ArvidJoung/Plasma_RF_Generator/Reference Data/KEIT-2655.pdf

-1-

# 13.56MHz RF GENERATOR 및

# AUTO MATCHING SYSTEM

(1 | ) 차년도 중간 보고서

1996. 10. 30

# 통상산업부

-2-

### 제출문

통상산업부장관귀하

본 보고서를 | 및 | 개발기 "13.56MHz RF GENERATOR | AUTO MATCHING SYSTEM" (
간 | 과제의 중간보고서로 제출합니다 : 1995. 12. 31 ~ 1996. 12. 30) | .

1996. 10. 30.

개 발 사 업 주 관 기 관 명 : 서울산업대학교

개발사업총괄책임자 : 장 우 진

연 | 구 | 원:여 인 선
| | :이 진 우
| | :장 택 수
| | :구 성 완
| | :이 병 일
| | :최 대 규
| | :김 남 정
| | :최 상 돈
| | :이 인 용
| | :위 순 임
| | :김 도 천

-3-

### 요약서

Ⅰ. | ( | ) 최종 당해 개발 목표 포함
반도체 | 에칭 확산 후처리 및 재료공학 섬유공학 피막코팅 등에 사용할 Wafer, | , | , | , | ,
수 있는 전원장치로서 발진부 | 부 | 부 | 부 , Power Amp , AC DC Converter , Filter , →
Control , | , Matching | , | , 부 센서부 | 회로 등으로 구성된 아래 규격의 고효율 고신뢰도 장
수명의 | 고정주파수 전원장치와 | 내에 안정된 | 방전을 일 13.56MHz | Chamber | Plasma
으키는데 절대 필수적인 | 시스템을 개발한다 Auto Matching | .
o | , | 13.56MHz 고효율 | 장수명의 | 전원 장치
ㆍ | → 해당부분 | 발진부 | 부 | 컨버터부 | 부 : | , Power Amp , AC DC | , Filter
ㆍ | ↑ 회로효율 | 기존 | 정도 : 80% | ( | 60% | )
ㆍ | ↑ 입력역률 | 기존 | 정도 : 85% | ( | 65% | )
ㆍ | | | | | | ↑ 정격수명 : 20,000 Hr
ㆍ 개발규격 : 300W, 1kW
ㆍ 전자파장애 | | | | | | 수준 (EMI) : FCC CLASS B
ㆍ | | | | | | ↓ 고조파 함유율(THD) : -40dB
ㆍ | | | | | | ↓ 출력 변동율 : 0.1%
ㆍ | | | | | | ↓ 주파수 변동율 : 0.1%
ㆍ VSWR : 30% | 24 이상에서 | 시간 견딤
ㆍ PROTECT : 순간차단
o | AUTO MATCHING 고속 | 시스템
ㆍ 해당부분 | 센서부 콘트롤부 | 부 | 회로부 : | , | , PC Interface , Matching
ㆍ LCD | DISPLAY : Matching Element | , Motor Speed | , 기능 | 값 표시 | 값 표시
Forward/Reverse 값 표시
ㆍ HARDWARE : 8OC196KC (INTEL ) 社
ㆍ SOFTWARE : Impedance | Program, Motor | Program, PC Interface 계산 | 제어
Program
ㆍ SENSOR : 자기유도방식
ㆍ MATCHING TIME : 3 | ( | 5 ~15 ) 초이내 기존 초 | 초
ㆍ OVER SHOOT | : 20% 율 | 이내

-4-

Ⅱ. 기술 개발의 목적 및 중요성

최근 전세계 | 멀티미디어 통신기기 | 등의 발달로 반도체 | 의 PC, | , | , FA | Memory Chip
수요가 폭증하고있다 | 반도체는 우리나라 전체 수출량의 약 | 를 담당하 . Memory | 20%
며 전세계 | 시장 판매량에서 | 위를 다투고 있으나 막상 반도체를 , | Memory Chip | 1, 2
생산하는 장비는 선진국의 기술이전 회피 및 막대한 연구개발비 설비투자비 그리 , | ,
고 첨단인력 부족으로 전량 외국에 의존하고 있다.
이에 국가적으로 첨단산업의 육성차원에서 일부 반도체 장비의 국산화가 추진되고
있으며 반도체 제작 약 | 개 공정중 | 에 해당하는 | 공정용 장비에 집중 , | 300 | 60% | Wafer
되고 있다 이는 | 에칭 | 에쉬 등을 말하며 | 와 전원장 . | Plasma | , Plasma CVD, | Chamber
치로 구성되어있다.
Wafer | 3 | . 한장이 만들어지기까지는 약 | 개월간의 공정기간이 필요하다 이 과정에서
Wafer | , 의 불량률을 줄이면 반도체 수율확대이고 곧 경쟁력확대라고 말할 수 있으며
이를 좌우하는 가장 큰 요인은 | 내 | 의 안정성에 있다 | 를 생 Chamber | Plasma | , Plasma
성하기 위하여 외부에서 전계와 자계를 인가하여 주는 전원장치가 필수적이며 바,
로 이 전원장치의 안정성이 생성된 | 의 질을 좌우한다 Plasma | .
Chamber | Impedance | CPU | , | Plasma 내의 | 를 | 로 계산하여 자동 매칭을 이루면 안정된
방전을 일으켜 | 에 손상이 가지 않도록 가공할 수 있고 또한 재료 공학 섬유 Wafer | , | ,
공학 등에 사용하는 피막코팅 및 요즘 공해 문제를 야기시키는 습식 도금을 건식도
금으로 바꿀 수 있다 | 이에따라 고신뢰도의 | 전원장치 및 . | 13.56MHz RF | Auto
Matching | . 시스템의 개발이 절실히 요구되고있다
그러므로 국내 반도체 장비의 선진기술 확보를 위해서는 | 개발과 병행하 , | Chamber
여 | 전원장치 및 | 시스템의 개발은 필수적이며 개발 실용화될경우 RF | Auto Matching | ,
전량 수입에 의존하는 전원장치를 수입대체 할 수 있고 반도체 관련장비 산업의 대 외 경쟁력 강화와 수출증대를 도모할 수 있으며 건식코팅 등 주변 산업에도 파급효 과가 크리라 예상된다.

-5-

Ⅲ. 기술 개발의 내용 및 범위

ㆍ 13.56MHz발진부 설계 및 기술개발
ㆍ 고효율 | | 부 설계 및 기술개발 Power Amp
ㆍ | → AC DC 컨버터부 설계 및 기술개발
ㆍ Filter부 설계 및 기술개발
ㆍ 정밀한 | | 값을 얻을 수 있는 센서 기술개발 Forward, Reflect
ㆍ Power Control부 설계 및 기술개발
ㆍ 신속한 | 부 설계 및 기술개발 Protect
ㆍ Matching | Program 제어 | 개발
ㆍ 1 | (300W ) 차 시작품 | 급 전원장치 제작 및 평가

Ⅳ. 기술 개발 결과 및 활용에 대한 건의

ㆍ 반도체 산업에서 | 의 수율 향상 Wafer
ㆍ 건식코팅 산업에서 각종제품 개발에 활용
ㆍ RF | Plasma 방전을 이용한 | 용접기에 활용
ㆍ 고주파 전원을 이용한 폴리에틸계의 접합에 활용
ㆍ RF 방전을 이용한 박막 코팅에 활용
ㆍ RF 방전을 이용한 섬유 코팅에 활용
ㆍ Plasma | Impedance 방전 상태의 업의 | 를 측정하는 계측기로서의 활용
ㆍ 참여기업에 의한 적극적인 양산화 유도
ㆍ 반도체 및 코팅 관련산업의 고부가가치 상품 개발유도

-6-

목차

제 | 장서 론 1
제 | 장 | 및 2 | 13.56MHz RF GENERATOR | AUTO MATCHING SYSTEM
제 | 절 | 방전 | 의 구조와 | 원리 1 | PLASMA | SYSTEM | MATCHING
제 | 절2 | 13.56MHz RF GENERATOR
제 | 절3 | AUTO MATCHER
제 | 장 견품 분석및 시작평가 3
제 | 절 견품 분석 1
제 | 절 시작평가 2
제 | 장 검토사항 4

-7-

제 | 장 서론 1
고정주파수 | 전원장치 및 | 시스템은 반도체 제조 및 건 13.56MHz RF | Auto Matching
식코팅시 | 전원으로서 | 내에 | 를 생성한다 발생된 | 는 에 Main | Chamber | Plasma | . | Plasma
칭 확산 후처리 등에 주로 사용하고 있으며 그 수요 또한 급속신장하고 있으나 국 , | ,
내 반도체 업체들은 미국이나 일본의 장비 | 로부터 전량 수입 사용하여 반도 Maker | ,
체 장비관련 사업의 선진기술 확보에 어려움이 큰 바 고정 주파수 | 전 13.56MHz RF
원장치 및 | 시스템의 필요성을 실감하게 되었다 Auto Matching | .
이러한 필요성으로 인하여 국내의 일부 업체에서도 수년전부터 고정주파수 13
.56MHz RF | Auto Matching 전원장치 및 | 시스템의 개발을 시도하였으나 반도체 공
정상 필요한 | 시간 연속 운영시 | 변동이 없을 것 타 장비들에 | 를 유 24 | Power | , | Noise
발하지 말아야 할것 | 교환시 아주 정 확한 | 내의 | 를 계산 , Wafer | Chamber | Impedance
하여 | 시킬 것 등의 엄격한 품질요구에 미흡한 상태이며 반도체 제 Auto Matching | | | | | | | ,
조시 | 한장에 소요되는 시간과 경비가 엄청난 점을 감안할 때 고신뢰의 | 전 Wafer | RF
원장치와 | 에 대응할 수 있는 고조파 성분의 제거 고효율 | 단 Auto Matching | , | Power
설계 | 및 | 기술 개발은 아직 전무한 실정이다 , Auto Matching Sensor | Control | .
국내에서 현재 사용되고 있는 | 전원 장치와 | 은 | 급의 RF | Matching | 300W, 600W, 1kW
수동 | 을 사용하며 학교 및 연구기관이나 건식코팅에 주로 사용하고 있으 Matching | | | | ,
나 반도체 제조시 요구되는 저 | 출력 전력안정 수율확대 등을 위해서는 , | Noise, | ,
1kW | RF | CPU | Auto 이상 고출력을 갖춘 고신뢰의 고정주파수 | 전원 장치와 | 를 장착한
Matching | | | | | | . 기술 개발이 필요하다고 사료된다
본 보고서에서는 위와 같은 개발의 필요성에 의해 고정주파수 | 전원 13.56MHz RF
장치 및 | 에 관하여 기본적인 기술을 제 차년도에 완성하였고 기존 Auto Matching | | 1 | | | | | ,
의 외국타사 제품을 분석하여 앞으로 개발하여야할 과제에 대하여 기술 한다.

-8-

제 | 장 | 및 2 | 13.56MHz R/F GENERATOR | AUTO MATCHING

### SYSTEM

전세계적으로 급속한 팽창일로의 반도체 산업과 병행하여 | 전원장치와 RF | Auto
Matching | 13.56MHz RF 시스템도 비약적으로 발전하고 있으며 그중 | 전원장치는
1895 | 1932 년 마르코니의 무선통신 성공이후 부분적으로 사용되어오다 | 년 세계전파
규정회의에서 공업용 주파수로 분류되어 통신쪽보다는 반도체 장비인 | 의 Chamber
Main | 1970 | VLSI | PC, | , | , 전원으로 사용되어왔으며 | 년대의 | 출현과 | 통신기기 멀티미디어
FA등의 수요급증에 따라 비약적인 성장과 더불어 그 수요가 계속 증가하고 있다.
한편 | 전원장치 및 | 시스템의 세계시장을 선도하고 있는 미국 일 , RF | Auto Matching | ,
본에서 고신뢰의 전원장치를 개발하기위해 전원장치의 핵심부품인 고주파 전력 트
랜지스터 페라이트 코어 진공 가변 커패시터 등의 부품뿐 아니라 고주파 , | , | Filter
CPU | Control | , AC DC Converter 를 첨가한 전원 | 장치 | 등에 막대한 투자를 하고 있 →
으며 미국의 | 와 일본의 | 에서는 | 내의 | 를 | 를 AE | DAIHEN | Chamber | Impedance | CPU 社 | 社
사용하여 계산하고 | 추적 장치의 원리를 이용하여 | 내에 저충격 고 Missile | Chamber | ,
속 | 을 실현한 시스템을 선보이고 있다 Matching | .
건식 코팅이나 반도체에서 요구되는 | 천원 및 | 시스템은 작업 공정상 고 RF | Matching
도의 기술을 필요로하기 때문에 위 두 회사에서 개발한 것과 같은 특징을 가진 장 치들이 앞으로의 시장을 주도하리라 예상된다.

-9-

제 | 절 | 방전 | 의 구조와 | 원리 1 | PLASMA | SYSTEM | MATCHING
1. | PLASMA 반도체 제조에 사용되는 | 방전 원리와 구조

고주파 전자기에 의해 일어나는 전기적 방전은 직류나 저주파 교류에 의한 것과는 여러가지 면에서 매우 다르다 특히 방전의 개시와 방전을 지속시키는 조건이 차이 .
를 | 보인다 | 고주파가 | 방전에 | 미치는 | 영향을 | 기술하기 | 위하여 | 전자기계 .
(Electromagnetic field)가 기체에 미치는 영향을 먼저 고려하여야 하며 일반적인 기체방전에서 고려 되여지는 사항과 마찬가지로 매우 복잡하다.
고주파가 기체에 인가되면 기체 내의 하전입자가 가속된다 질량의 차이로 인하여 . 자유전자는 이온보다 훨씬 많이 가속되며 이온보다 자유전자에 에너지 전달이 많이
된다 전자는 우주선 등의 외부요인에 의하여 기체 내에 항상 어느정도 존재한다 . | .
만약 전자가 존재하지 않는다면 전계가 가해진다 하더라도 에너지 전달이 이루어 ,
지지 않을 것이고 따라서 방전은 일어나지 않을 것이다 전계의 방향이 바뀌면 전 , | .
자에 가해지는 힘의 방향도 바뀌고 따라서 전자는 기체를 수용하고 있는 , | Chamber
의 벽이 멀리 떨어져 있을 경우 기체 내에서 진동하게 된다 , | .
이점이 고주파 방전과 저주파 방전의 주된 차이점이다 주파수가 낮으면 전자가 방 .
향을 바꾸기도 전에 전자는 | 의 벽에 도달하게 된다 전자의 충돌은 다른 Chamber | .
전자를 방출하거나 관벽에 부착된 불순물 원자를 방출하게 한다.
고주파전자계 내에 기체 원자가 없고 전자만이 존재한다면 전자는 전계내에서 진동 을 할 것이고 에너지 전달은 일어나지 않는다 기체가 존재하면 전자는 가속되어 . 전계로부터 전자에 에너지 전달이 일어난다 전자는 전계로부터 에너지를 얻는 반 .
면 원자와의 충돌로 에너지를 잃는다 만약 전계가 충분히 크다면 전자는 원자를 , | | | | .
여기 시키는데 필요한 에너지보다 더 큰 에너지를 얻을 수 있고 계속되는 충돌에 의하여 전자는 원자를 여기시키고 자신은 에너지를 잃게된다.
원자에 전달된 이 에너지는 원자가 기저준위로 복귀할 때 방사된다.
여기 에너지보다 더 큰 에너지를 가지는 전자의 일부만이 실제로 원자를 여기시키
며 어떤 전자는 따라서 원자를 이온화 할 수 있는 충분한 에너지를 얻게 된다 이 , | .
전자가 원자와 충돌하면 또 다른 전자를 얻게 되며 이 과정에 의해 전자를 생성하 ,
게 된다 이와 동시에 전자는 | 쪽으로의 확산에 의해 양이온과 재결합하여 . | Chamber | ,
또는 중성원자나 분자에 포획되어 소멸된다.

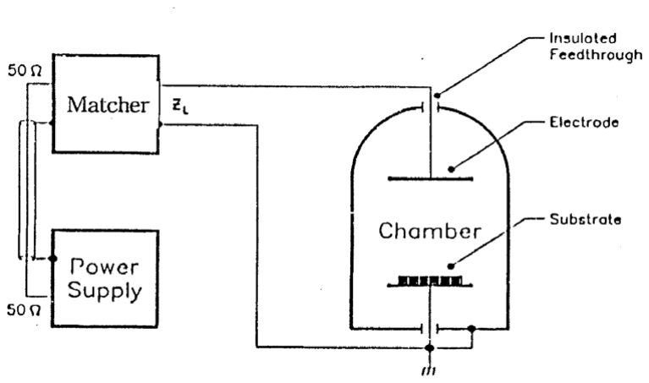
[picture p4: figure]

- 10 -

이 생성과 소멸의 상대적인 값에 의하여 전자의 농도가 결정되며 시스템의 전기적
특성이 결정된다 생성과 소멸의 비율은 가스의 종류 가스의 밀도 | 의 형 . | , | , Chamber
상 등의 복잡한 함수이다.
고주파 전계를 발생시키기 위하여 고주파 전력을 발생하는 전원장치가 필요하며 이
고주파 전력을 | 내에 효과적으로 공급할수 있는 | 가 필요하다 Chamber | Matcher | .
현재 가장 중요한 반도체 제조 공정중 식각 | 과 성장 (Eatching) | (Deposition), Sputter,
Asher | 13.56MHz RF Generator | Auto Matcher | 1-1 등에 | 와 | 가 사용되고 있으며 그림
은 | 형 | 장비의 개략도를 보여주고 있다 Parallel | Plasma Eatching | .
석영제의 | 형 | 내에 반응 | 를 도입하며 그의 외곽에 있는 평판 Parallel | Chamber | Gas | ,
전극에 의하여 용량적으로 또는 | 에 의하여 유도적으로 고주파 전력을 인가하며 Coill
Plasma | . Wafer | Chamber | Boat 를 발생하는 방식을 사용하고있다 | 는 | 내에 석영제 | 의
위에 담겨서 보유 | 중에서 전기적으로 | 상태에 놓이게 된다 | 와 ( | ) Plasma | Floating | . Wafer
Plasma | 10-20V | , | Ion 의 전위와의 차는 | 이며 양 | 은 이 전위차에 의해 가속되어
Wafer | . | Ion 에 입사한다 그 때문에 | 의 충격효과가 적어서 주로 방향성이 없는 중성레
디칼과 피가공 재료와의 화학적인 반응에 의해 등방적인 | 이 진행된다 Eatching | .
이 장비에서는 석영 | 내에서 | 가 형성되기 때문에 반도체 | 에 Chamber | Plasma | Device
유해한 불순물 오염도 거의 없고 | 도 적어서 손상이 적다 Ion Energy | .
그림 | 형 | 장비 1-1 Parallel | PLASMA ETCHING

- 11 -
2. MATCHING 원리

전력을 소스에서 부하로 최대한 전달하기 위한 임피던스 정합(Impedacne
Matching) | RF | . | 1-2 은 | 회로 설계에 매우 중요하다 그림 | 에 이 이론에 대한 이해를 돕
기위한 회로와 이 회로에 대한 계산식이 있다.
직류회로에서 부하 저항과 소스저항이 같다면 전력은 소스에서 부하로 가장 잘 전 달 된다는 매우 잘 알려진 이론이 있다.
이와 비슷하지만 교류 또는 시간 변화 파형의 경우에서는 소스에서 부하까지 전력 -
을 가장 잘 전달하려면 부하 임피던스 | 가 소스 임피던스의 공액복소수 (ZL)
(Complex conjugate) | . 과 같아야한다 이 임피던스 식을 실제로 사용되는 회로에 적
용해보자.
그림 | 의 회로에서 소스 임피던스 | 는 저항 | 와 | 를 나타내는 리액티브 부 1-3 | ZS | RS | +jX
품인 인덕터가 직렬로 연결되어있고 부하 임피던스 | 은 저항 | 과 | 를 나타 , | ZL | RL | -jX
내는 리액티브 부품인 커패시터가 직렬로 연결되어 있는데 이 회로에서 소스와 부
하 임피던스가 직렬로 연결 되었으므로 소스의 | 와 부하의 | 성분들은 직렬이므 +jX | -jX
로 서로 상쇄되고 결과적으로 | 와 | 만 남게된다 RS | RL | .
이 두저항의 크기는 같으므로 직류 회로에서와 같이 최대한의 전력이 전달된다. 위 예와같은 임피던스 정합에서 이루어지는 임피던스정합은 한 주파수에 대해서만 정확하게 정합되고 이 주파수가 아닌 주파수에 대해서는 임피던스 정합이 나빠지다 가 주파수가 많이 차이가 나게 되면 임피던스 정합이 전혀되지 않는다 이와 같은 . 현상은 광대역 회로에 임피던스 정합을 이룰 수가 없다는 것을 의미하므로 문제가
아닐 수 없지만 가변 커패시터를 사용하거나 인덕터에 | 을 설치하여 사용하게 Tap
되면 | 고정주파수에서는 실제 문제 되지 않는다 13.56MHz | | | | | | .

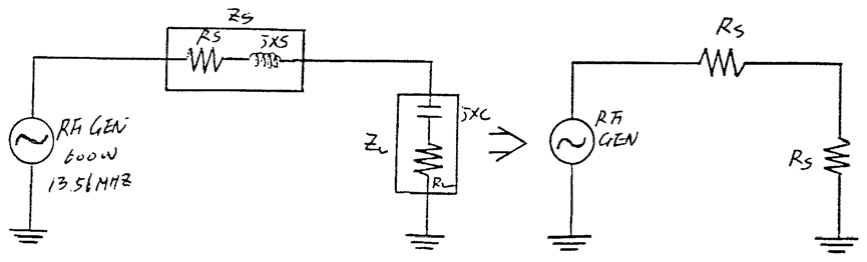
[picture p5: figure]

- 12 -
그림 | 자체의 공액복소수을 구동하는 소스 임피던스와 결과적인 등가 회로 13
제 | 절2 | 13.56MHz R/F‘ GENERATOR
1. 기존회로

고직접 반도체의 개발 요구에 따라 이전에는 진공관식 RF Generator (2MHz ~
30MHz) | TR | FET 를 사용하다 대용량 | 과 | 가 등장하고 나서는 소형 경량화를 지향해서
발전하고 있는 추세이며 전세계적인 | 제조회사 중 미국 | 사 RF Generator | ENI , RFPP
사 | 사 등 개사 일본 | 프랑스 | 사 등이 있으며 여기서는 현재 , AE | 3 | DAIHAN, | SAIRAM
반도제 제조공정중 약 | 정도를 차지하고 있는 | 방식이며 수냉식인 | 사의 45% | Trans | , | ENI
RF Generator | . 를 중심으로 회로소개를 한다

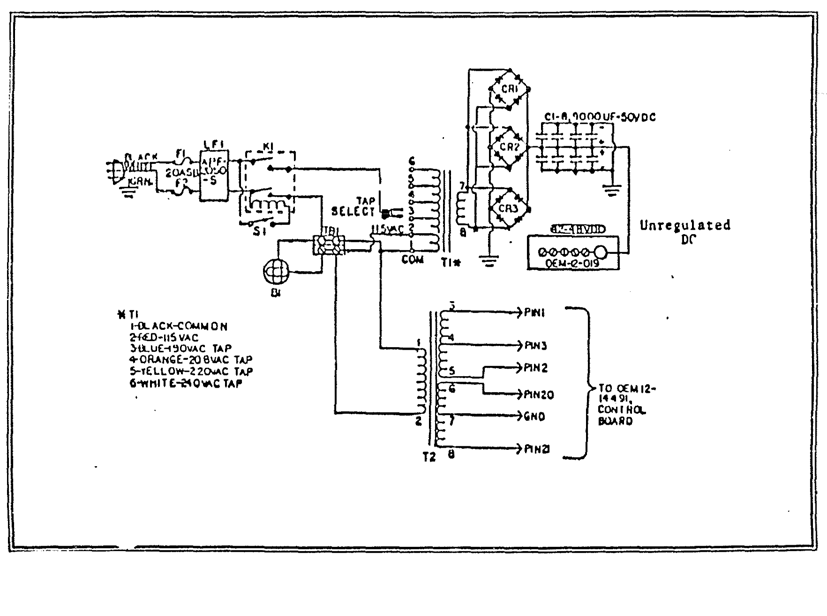
[picture p6: figure]

- 13 -
그림 | 는 | 회로와 | 둥에 전원을 공급하기 위해서 입력 1-4 | Control Board | Power Amp
전원인 | 를 | 등의 | 전원으로 바꾸어주는 부분이다 AC 220V | 50[V], 25[A] | DC | .
200V | 250V 20A 의 입력선을 연결하고 | 짜리 퓨즈를 통과한다음 입력선으로 부터 들
어오는 | 를 방지하기 위한 | 를 설치하고 | 를 설치한다 Noies | Filter | Breaker S/W | .
전원 전압의 | 오차 때문에 | 입력단에 전압조절용 | 를 설치하여 출 ± | Main Trans | Tap
력전압을 일정하게 유지시키고 이를 전파 정류해서 | 를 제거하기 위해 전해 Ripple
Capacitor | Power TR | 50V | . 를 설치하여 | 의 공급전원인 | 를 만들어 낸다
그림 | 전력공급 개략도 1-4

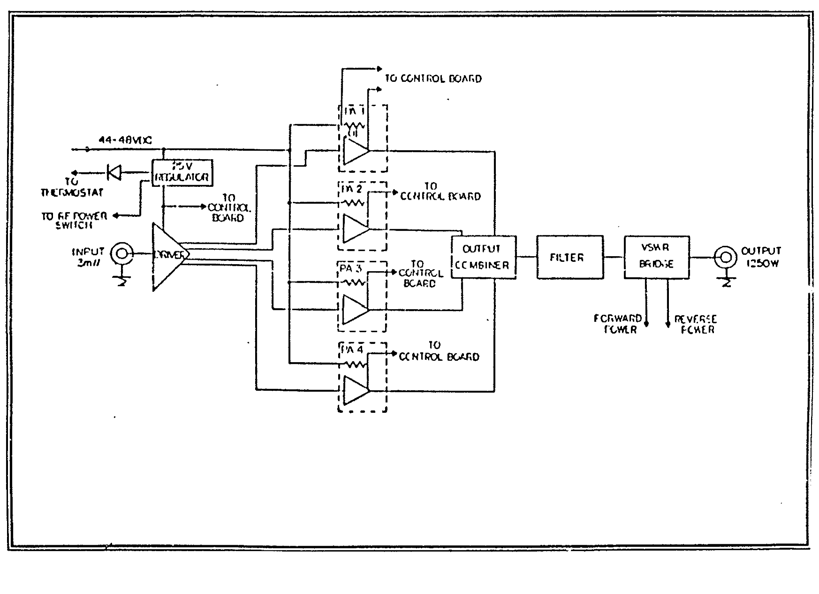
[picture p7: figure]

- 14 -
그림 | 는 전원회로를 거친 다음 | 에서 발진한 | 신호 1-5 | Control Board | 13.56MHz 3mW
를 드라이브 단에서 약 | 정도로 신호를 확대한 다음 | 로 보내서 각 60W | Power Amp
Power | 300W | 1250W | Combiner | 13.56MHz 단 | 씩 총 | 를 만들어서 | 로 전력을 합친다음
외의 주파수를 거르기 위해 | 를 통과한 다음 | 과 | 를 위해 Fillter | Power Control | Protect
VSWR( | )Meter | Forward | Reverse Power | Control 정재파비 | 를 설치하여 | 와 | 를 검출해서
Board | Output Connector | . 로 보내고 출력신호는 | 에 연결한다
그림 | 부분 개략도 1-5 RF

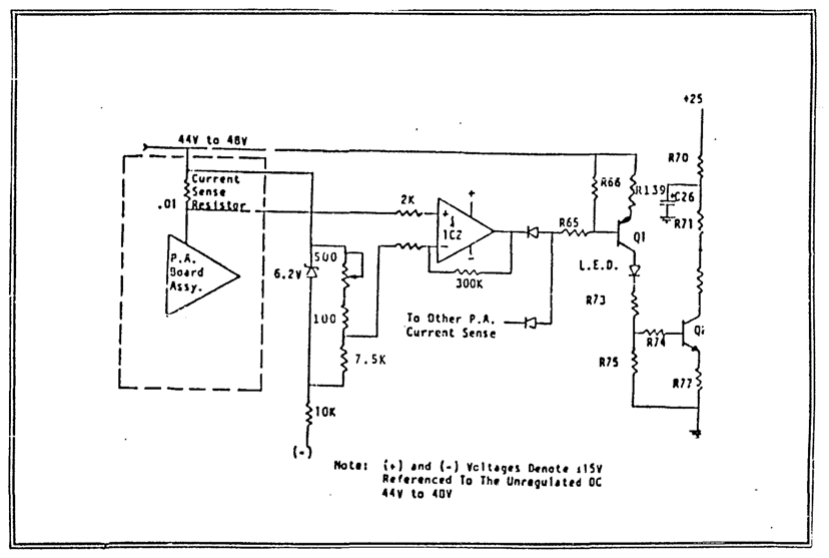
[picture p8: figure]

- 15 -
그림 | 은 | 로 공급되고 있는 | 전원의 전류를 감시하여 과다할 때 1-6 | Power Amp | DC
Power TR | DC | Line | Power Amp 의 손상을 방지하기 위한 것으로서 | 전원 공급 | 과 | 사이
에 | 정도의 저항을 설치한 다음 전류가 흐를 때 양단에 발생하는 전압을 100W | IC2
의 | 반전측에 설치되어있는 기준전압과 비교하여 일정치를 넘어설때는 Op Amp | Q1
을 동작시킴과 동시에 | 표시 | 에 점등이되면서 | 를 작동시켜 전원 Over Current | LED | Q2
전압을 | 시킨다 OFF | .
그림 | 전류 감지 개략도 1-6

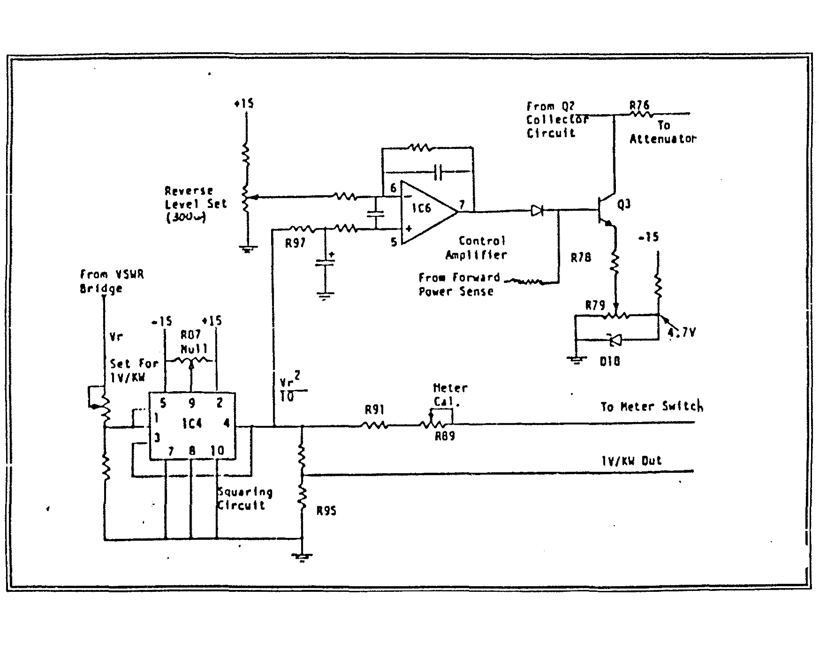
[picture p9: figure]

- 16 -
그림 | 은 | 의 종단에 부하 임피던스와 | 이 잘되었는가를 1-7 | R/F Generator | Matching
알아보면서 | 의 손상을 막기 위한 회로이다 Power TR | .
VSWR Sensor | IC4 에서 입력을 받게 되는데 이때의 입력은 비선형이기 때문에 | 를 거
치면서 일단 직선형 값으로 만든 다음 한쪽은 | 상으로 가고 한쪽은 Meter Display
Reverse | IC6 | Op Amp 통제를 하기 위해 | 의 | 에서 반전 단자에 주어진 기준 전압과
비교하여 일정한 값을 넘어서면 | 를 줄이기 위해 | 를 동작하여 이 값을 Power | Q3
Attenuator( | ) | . 감쇄기 가 알맞게 조정할수 있게한다
그림 | 반사전력 감지 개략도 1-7

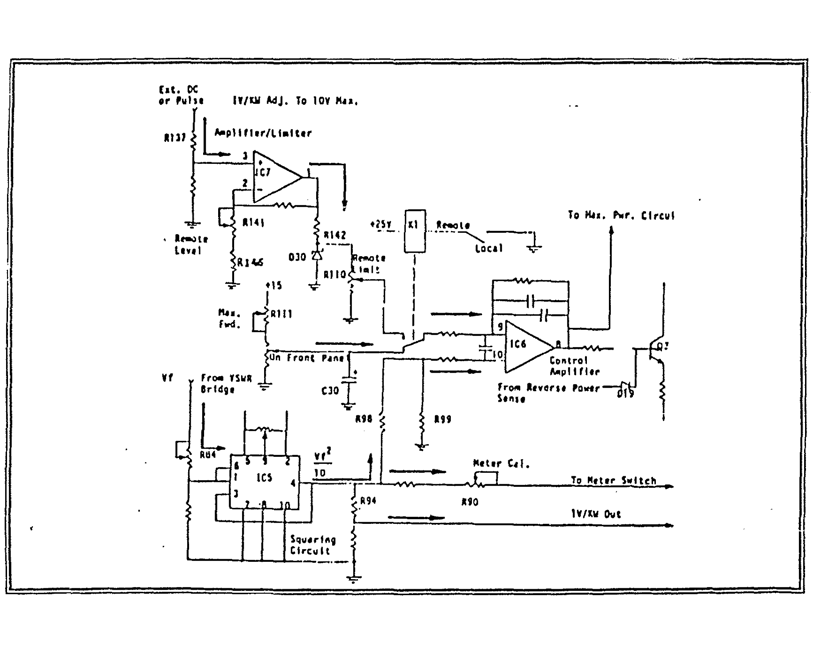
[picture p10: figure]

- 17 -
그림 | 은 | 의 | 를 현재 얼마나 보내고 있으며 그 값 1-8 | RF Generator | Forward Power
에 계속유지를 할 수 있게 하기 위한 회로로서 | 에서 입력되는 비선형 VSWR Sensor
값을 | 를 통과해서 선형으로 만든 다음 | 를 하기 위해 신호를 보내 IC5 | Meter Display
고 다른 한선은 | 의 반전측에서 입력되는 기준치와 비교하여 일정한 값을 넘어설 IC6
때는 | 를 동작하여 | 감쇄기 로 보내 | 를 조정할수 있게하 Q3 | Attenuator( | ) | Forward Power
며 같은 신호를 | 감지 | 로 보낸다 한편 | 동작 | 가 Max Power | Board | . | Local/Remote | S/W
있어 | 일 때는 | 에 있는 | 조절용 다이얼값에 맞추어 동작하나 Local | Front Panel | Power
Remote | Analog | Pulse | . 일 때는 일정한 | 값이나 | 값에 따라 동작 할 수 있다
그림 | 정전력 감지 개략도 1-8

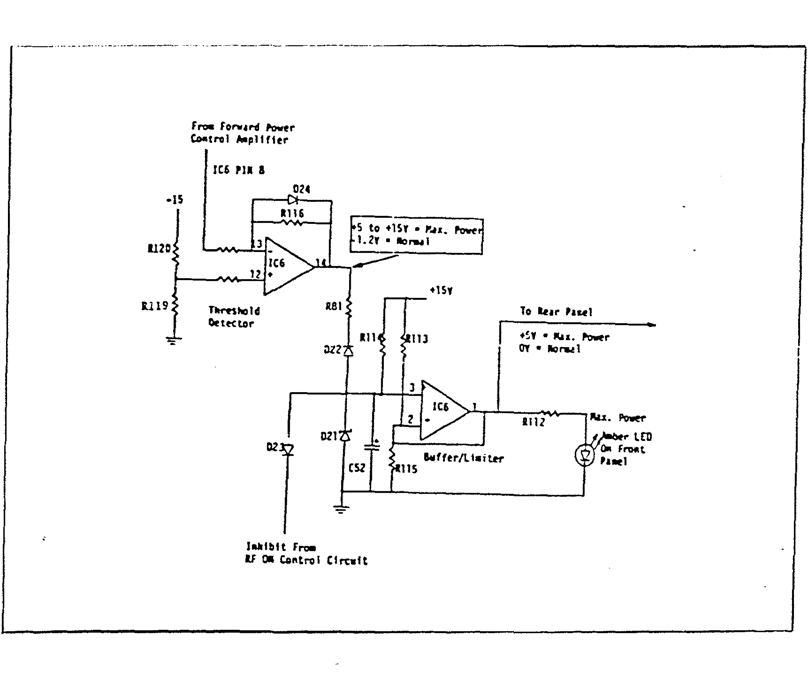
[picture p11: figure]

- 18 -
그림 | 는 | 값을 받아들여 현재의 | 의 출력값이 최대 1-9 | Forward Power | HF Generator
값임을 알려 그 이하로 사용하여 수명을 연장시킴을 목적으로한다.
Forward Power Control Amp | IC6 Op-Amp 로부터 | 의 반전 측으로 신호를 받고 비
반전측으로 기준전압을 받아 비교한 다음 일정한 값을 넘어서면 | 의 Front Panel
LED | Max Power | Remote Control 를 점등시켜 | 임을 알리고 만일 | 상태일 때 이를 알리
기 위한값을 외부 | 단자로 보낸다 Interface | .
그림 | 최대전력 감지 개략도 1-9

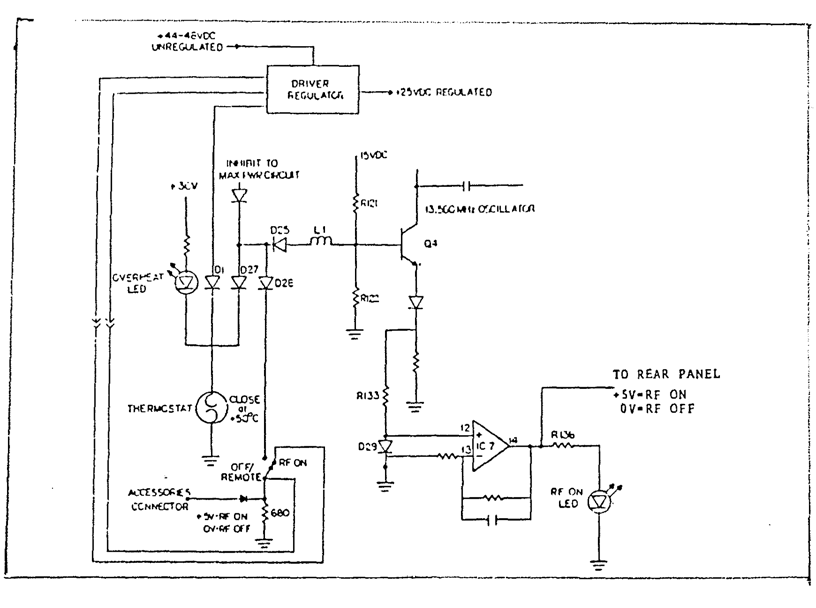
[picture p12: figure]

- 19 -
그림 | 은 | 의 | 동작을 할 수 있게 하고 | 의 냉 1-10 | RF Generator | ON/OFF | RF Power TR
각을 위해 설치되어있는 냉각판의 온도를 감시하고 있다가 온도가 | 이상 올라 50℃
갈때 | 의 | 의 동작을 멈추게하여 | 를 보호한다 | 의 13.56MHz | Oscillator | RF Generator | . Q4
Base | 15V DC | RF S/W | OFF | 15V 측에 | 를 항상 인가한 상태에서 | 가 | 상태로 접지되면
DC | L 는 1을 거처 | 을 통과한 다음 | 측으로 흐르게 되고 이때 | 는 동작 D25, D28 | "-" | , | Q4
을 멈추게 되면서 | 의 | 의 동작도 따라 멈추게 되면 13.56MHz | Oscillator | Front Pannel
에 있는 | 도 점멸하게 된다 한편 | 도 온도가 | 이상 상승 RF ON LED | . | Thermostat | 50℃
시 접지되면 똑같은 형태로 동작하여 | 의 발진 자체를 못하게 하여 보 RF Generator
호한다.
그림 | 온도감지 개략도 1-10 RF ON-OFF

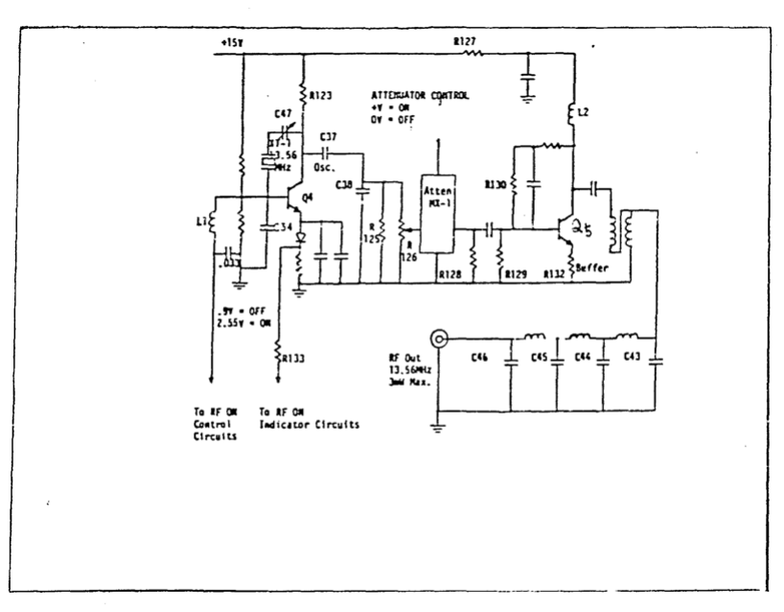
[picture p13: figure]

- 20 -
그림 | 은 | 의 발진을 하여 | 에 | 의 전력을 공급하기 1-11 | 13.56MHz | Driver Circuit | 3mW
위한 것으로서 | 기능을 겸하고 있다 Power Control | .
RF ON S/W | 13.56MHz | XT | . Attenuator 의 동작에 맞추어 | 의 | 신호를 발생시킨다
MX-1 | Forward P0wer Setting | Q5 은 이 신호를 | 되어있는 값 만큼 조절하여 | 을 거치
면서 | 이하의 신호가 만들어 진다 3mW | .
이 신호 값에는 고조파가 포함되어 있기 때문에 대역통과 | 를 거친 다음 깨끗 Filter
한 | 로 되어 | 의 입력단에 공급된다 Sign Wave | Driver Circuit | .
이상에서와 같이 | 의 | 과 | 등의 구조를 알아보았다 ENI | RF Control Power Amp | . 社
기존의 회로는 | 의 보호를 위한 | 의 | 의 RF Generator | Forward, Reverse P wer | Sensor
정밀성에 문제가 있으며 | 방식을 채택하여 무게가 무거운 단점이 있다 Trans | .
그림 | 발진기 감쇄기 및 버퍼 암프 개략도 1-11 RF | ,

- 21 -
2. 제안회로
반도체산업의 국제적인 가격경쟁에 따라 한번에 많이 생산할 수 있는 | 의 대 Wafer
구경화 및 수율을 높이기 위한 고신뢰성 | 내에서 적은 부피를 차기위 , Clean Room
한 경량화 등의 특성을 갖춘 전원장치가 필요하게 되었으며 이러한 욕구에 맞추기
위해서는 전원장치의 | 와 | 의 | 과 | 에 대 SMPS | Forward, Reverse Power | Sensing | Control
폭적인 기술 개발이 우선 되어야하며 이러한 점에 본 개발은 역점을 두었다.
보통 | 이상의 고주파 발진은 콜비츠 등의 하트레이 회로가 기본이지만 실제로 1MHz
는 그 변형이나 발전된 타입이 사용되고 있고 통신 장해 방지의 | 은 국 , | Guide Line
제적으로 | 국내에서는 전기용품 취금법에 규정되어 있으며 양자 모두가 대체 CISPR,
로 같다.
규제값은 매 주파수마다 상세하게 되어 있으며 대체적으로 | 거리에서 10[M]
30-40dB[ uV/m] | . 이다
단 | 밴드로 불리우는 일부의 주파수는 제한이 설정되어 있지않다 일본에서는 ISM | .
13.56MHz, 27.12[MHz], 40.68[MHz] | 2.45[GHz] 와 전자레인지에 사용되고 있는
이다 이들 주파수를 선택하는 것이 노이즈발생에 대한 대책은 아니나 고주파 발생 .
기에서 노이즈의 대책은 필요하다 | 를 기본파로 하면 제 또는 제 고 . 13.56[MHz] | 2 | 3
조파는 | 밴드에 포함된다 인체에 대한 고주파의 영향은 법규로 규정되어 있지 ISM | .
는 않으나 일본에서는 전자방호 심의회가 10[mW/cm²
] | . 의 규정안을 내놓고 있다
이와 같은 수준은 보통 대책에서 문제가 않되는 값이다.
Control | Analog | Digital | . 방식은 기존의 | 방식에서 | 방식으로 바꾸었다 본 연구에서 제
안되는 회로의 전체적인 블럭도를 그림 | 에 보인다 2-1 | .

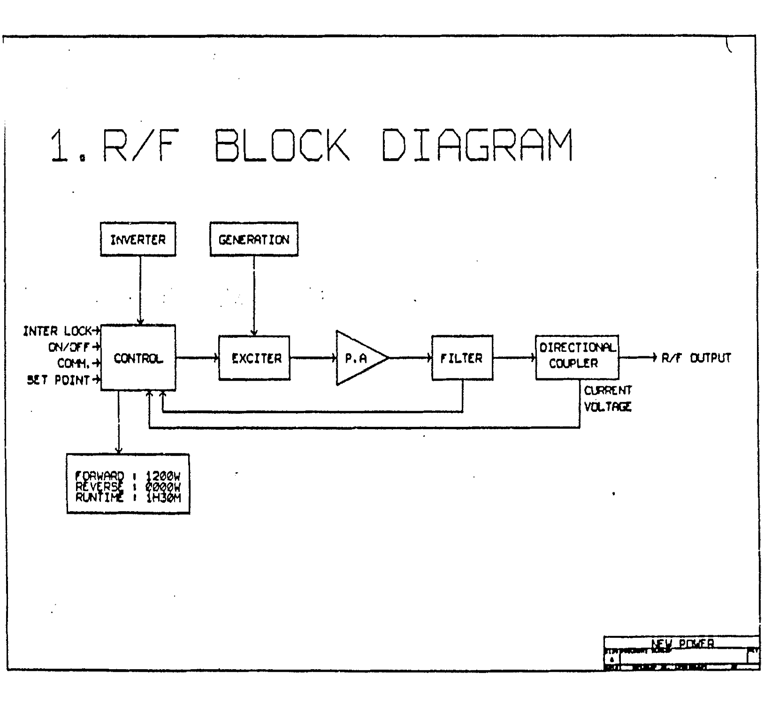
[picture p14: figure]

- 22 -
그림 | 은 | 회로를 선택함으로써 외부와의 | 를 보다 용이 2-1 | Digital Control | Interface
하게 할수 있도록 | 기능을 가지고 있으며 | 를 장착하여 기존의 RS-232 | LCD Module
Forward, Reverse Power | Display | Run Time 만 | 하던 것을 기능에 따라 | 선택 및
Display, RF | , 의 단속적인 출력 여러 대를 같은 위상의 주파수를 출력 시키는 등 여
러 기능을 할 수 있다.
Control Board | Power FET | Inverter, 13.56[MHz] 를 중심으로 | 에 주전원을 공급하는
를 발생시키는 | 이것을 | 정도까지 신호를 확대하는 | 와 | 로 Generator | 60W | Exciter | 300W
출력을 높이는 | 부 고조파의 발생을 방지하는 대역통과필터를 거쳐 Power Amp ,
Forward, Reverse Power | Directional Coupler | . 를 측정하는 | 등이 설치되어있다
그림 | 제안회로의 블럭다이어그램 2-1

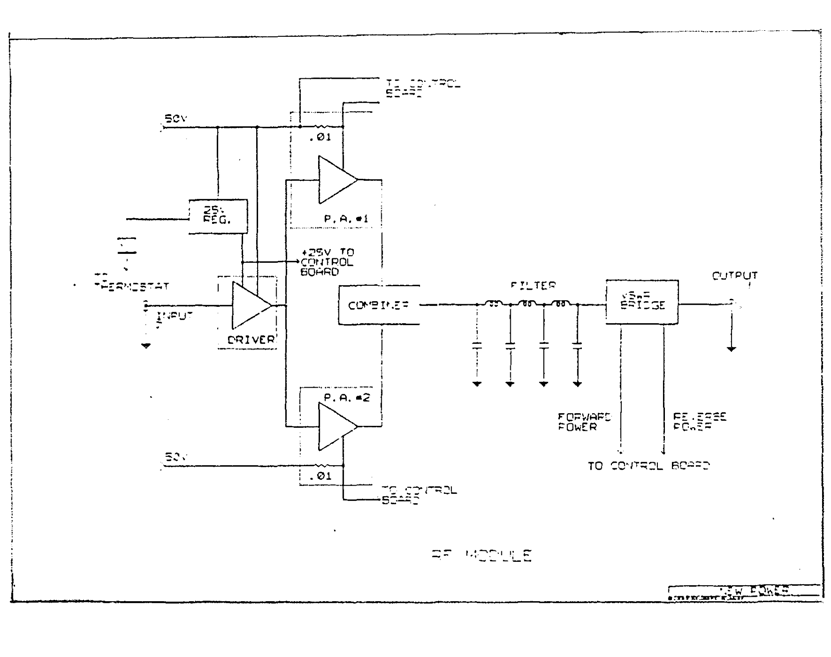
[picture p15: figure]

- 23 -
그림 | 는 그림 | 에서 보였던 블럭도를 실제로 더 정밀하게 나타낸 것으로서 2-2 | 2-1
Driver | TR | 30MHz | 60W 단에서 사용하는 증폭 | 은 주파수대가 | 이하 | 급으로 사용하고
Power Amp | 150MHz | 150W | FET 에서 사용하는 소자는 사용주파수 | 아하 | 급의 | 를 사용
하여 | 증폭회로를 설계하게 되면 효율을 보통 | 정도에서 | 수준까지 Push-Pull | 50% | 85%
올릴 수 있다 | 급 | 에서는 이 | 개만 사용하면 충분이 출력 . 300W | RF Generator | FET 2
을 낼 수 있고 더 높은 출력을 얻고자 할 때는 | 개수를 늘리면서 | 를 FET | Combiner
설치하여 | 각자가 발생시키는 | 를 자계회로로 전력을 모은다음 임피던스 FET | 150W
변환하여 희망하는 대용량 | 를 만들 수 있다 RF Generator | .
그림 | 제안회로 개략도 2-2

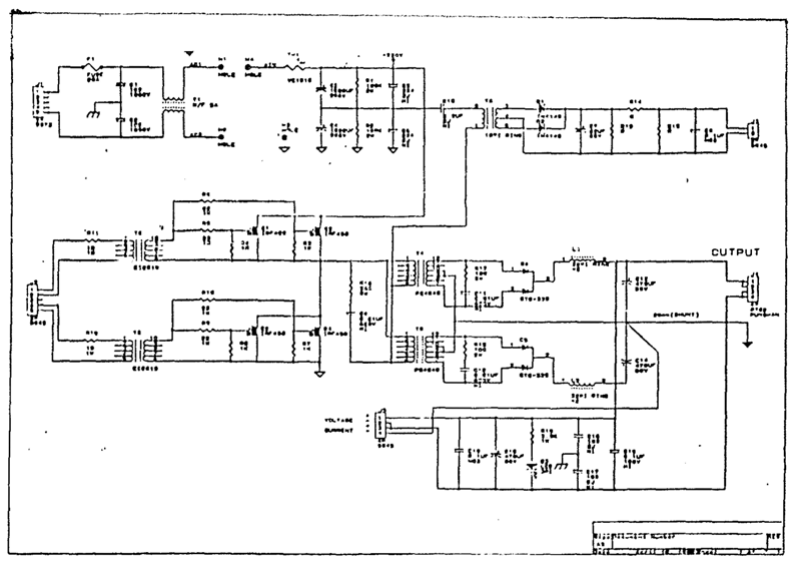
[picture p16: figure]

- 24 -
그림 | 은 | 에서 소형 경량화를 구현하기 위하여 필수적인 | 방 2-3 | RF Generator | SMPS
식을 사용하여 설계한 것으로서 기존의 | 방식을 대체하고 고효율 고신뢰성이 Trans | ,
되도록 설계하였다 입력단에서 | 틀 받아 | 를 거친다음 전원 | 방지 . | AC 220V | Fuse | Noise
를 위해 | 를 거친다음 그림에서는 표시되어있지 않지만 전파정류 Noise Filter | Diode
를 거쳐 전해 | 에 입력시키면 대략 | 정도의 | 전압이 생긴다 이를 Capacitor | 280[V] | DC | .
Q1, Q2, Q3, Q4 | Q1, 02 | Q3, Q4 | GATE 에 공급한 다음 | 와 | 의 | 전압을 적당한 주기로
교차시키면 | 에 수십 | 의 교류 주파수가 발생하고 이를 정류하고 T4, T5 | kHz | Choke
Coil L1, L2 | C13, C14 | 50V | DC 를 통과하여 | 에 입력시키면 약 | 의 | 전원을 얻을 수 있고
이는 | 의 공급전압으로 사용된다 Power FET | .
그림 | 구현 회로도 2-3 SMPS

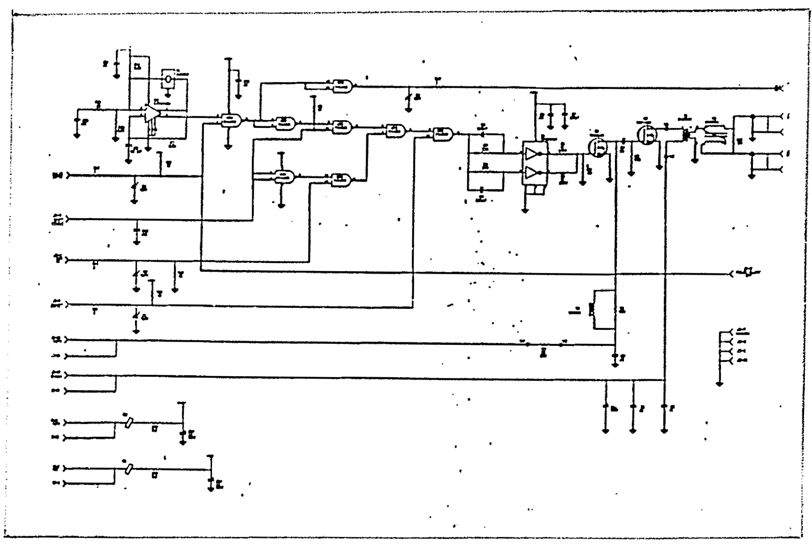
[picture p17: figure]

- 25 -
그림 | 는 발진단을 표시한 것으로서 | 의 발진을 하여 | 가 가장 2-4 | 13.56[MHz] | Speed
빠른 | 를 사용하여 발진 주파수의 손실을 최대한 방지하면서 외부 NANDGATE
Interface | Interlock | , RF | Pulse | , RF 인 | 장치 | 의 단속파를 출력할 수 있는 | 파 입력
Generator | 2 를 | 대 이상 같은 위상으로 병렬 사용할 수 있게 설계하였으며 대략
80W | FET | Power Amp | Driver 의 | 를 사용하여 | 에 충분한 전력을 | 시킬 수 있는 초단 증
폭부까지 겸하고 있다.

그림 발진회로 2-4

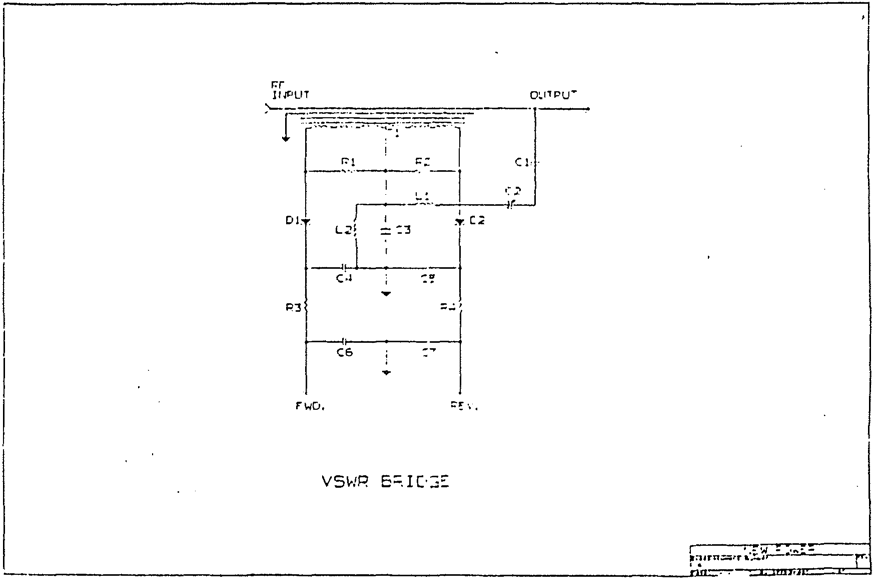
[picture p18: figure]

- 26 -
그림 | 는 | 의 | 값을 | 하는 2-5 | RF Generator | Forward, Reverse | Sensing | Directional
Coupler | | | RF Generator 로서 이것이 잘 설계되어있어야만 고신뢰의 | | | | | 을 만들 수 있
다.
300W | 3[A] 급에서는 전류가 대략 | 이하가 흐르게 되는데 이를 감지하기 위해 두 개
의 | 에 도선을 감아 | 가운데로 | 출력선을 관통시키면 | 양단에서 전압 Core | Core | RF | Core
을 얻을수있다.
이 전압을 | 출력의 심선에서 RF | C1을 거친 전압과 두 | 의 중심선을 연결한 점과 Core
접지시키면 출력전압의 높거나 낮음에 비교적 영향을 적게 받으면서 회로의 좌(→
우 로 흐르고 있는 전류값에 비례하는 | 값을 | 우 좌 로 흐르고 있는 전류 ) | Forward | , ( | ) →
값에 비례하는 | 를 감지 할 수 있다 이를 | 로 반파정류한 후 Reverse Power | . | D1, D2
에 | 로 보낸다 Control Board | .

그림 2-5 Directional Coupler

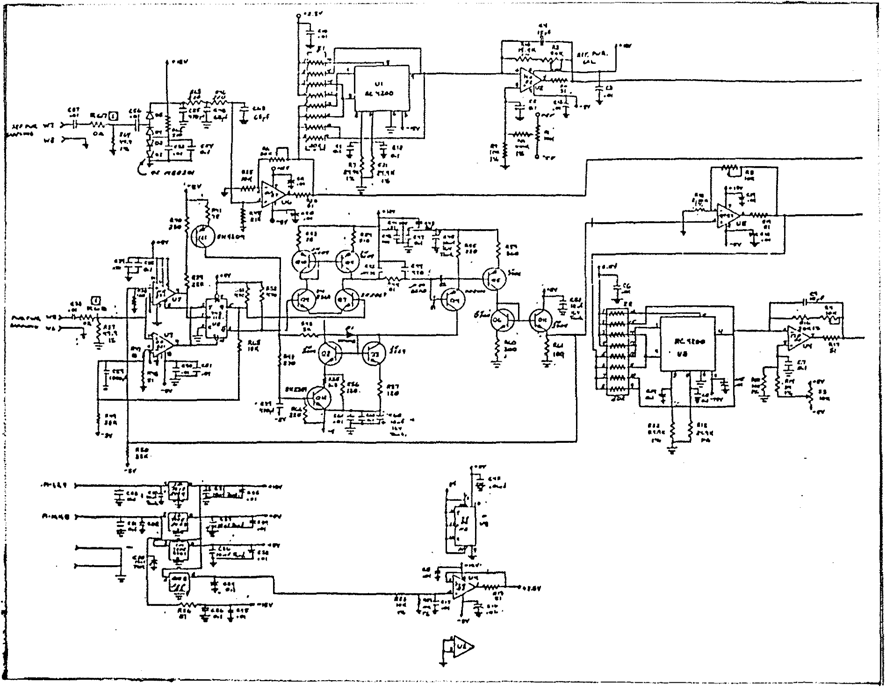
[picture p19: figure]

- 27 -
그림 | 은 정밀한 | 값을 | 하여 | 의 수명을 2-6 | Forward, Reverse | Sensing | HF Generator
보호하는데 중요하기 때문에 설계가 다소 복잡하다.
그림 | 에서 받은 입력을 일단 증폭하여 신호값을 높이고 2-5 | | | | | | Q1~Q2를 통과하면서
Time Delay | , Noise | U 되는 성분이나 | 에 대비하고 있으며 | 3,U1을 통과하면서 대수적
으로 | 되었던 값을 직선적으로 바꾼다 이 값은 | 를 거쳐 Sensing | . | A/D Convertor
LCD Module | Display | Reverse | , 에 | 되고 만일 | 값이 많이 발생하였을 때 즉 부하단의
Matching | Power | Power FET 이 잘 되어 있지 않을 때 계속해서 | 값을 높이게 되면
가 손상될 염려가 있으므로 일정한 값 이상으로 출력되지 못하게 하는 | 기 Protect
능을 하기 위한 값으로도 사용된다.

그림 제어회로 2-6

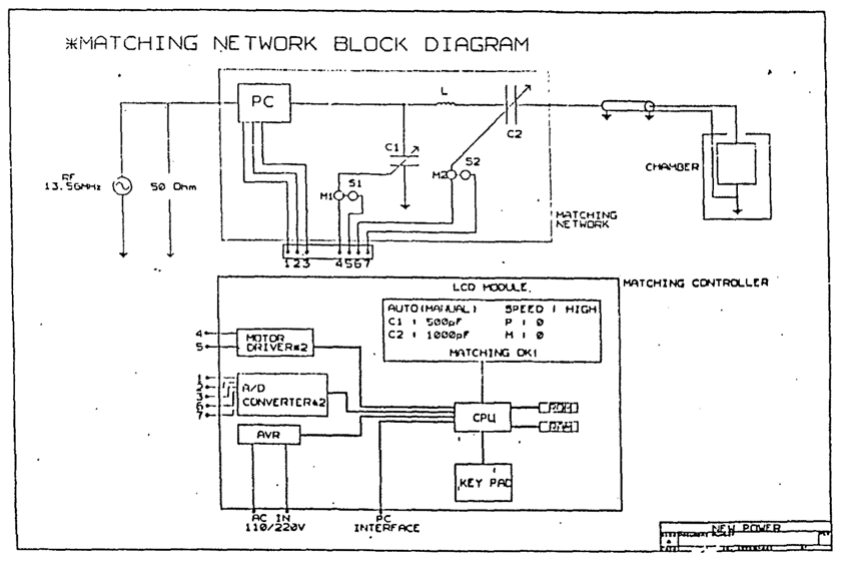
[picture p20: figure]

- 28 -
제 | 절3 | . AUTO MATCHER
자동정합기는 각사마다 제조하고 있으며 특히 | 의 특성이나 모양에 맞게 Chamber
장착되어야 하므로 보통 주문형으로 제작되고 있으며 종류도 아주 다양하기 때문에 본 연구에서 개발 제작한 것과 기본적인 개념을 설명한다.
그림 | 에서 점선안에 있는 2-7 | L, C1,C2 등이 | 를 구성하는 기본 Matching Network
소자들이고 이를 어떤 값으로 변화하여 | 에 | 방전을 일으킬 것인가 , | Chamber | Plasma
를 | 해내는 | 와 | 값을 받아 계산하고 Sensing | PC(Power Coupler) | Sensing | C1 과C2
의 값을 변경하기 위해 직렬축에 설치되어 있는 M1,M2 의 | 의 구동 및 값을 Motor
Display | CPU | LCD Module | . 하가 위한 | 와 주변회로 및 | 등으로 구성되어 있다
여기서 정합이 되는 기본 개념을 간단히 정리하면 | 는 기본적으로 R/F Generator | 50
+ j0 [ ] | | | | | . Ω 의 출력 임피던스를 갖도록 설계되어 있다
그림 | 정합회로 블록 다이어그램 2-7

- 29 -
따라서 정합회로를 포함한 | 의 모든 임피던스는 | 을 갖도록 Chamber | 50 + j0[ ] Ω
Loading C1값과 Tuning C2 값을 조정하여 정합을 이루게 되면 완벽하게 Chamber
내에 | 방전을 이룰 수 있다 Plasma | .
C1과C2가 어떤 값을 가질 때 정합이 이루어지는가를 살펴보면 다음과 같다. RF 전원부에서 태브난의 정리를 활용하면

Z = [Z1

+ +Z2]⁻¹

여기서 Z1 = -j / C1 ,Z2 =R+jX-j/C2

대입하면 Z = (R + j (X - 1 / C2)) / (1 - C1(X - j / C2)+jRC1 ) = {{R + j Q) (1 - C1 Q-jRC1)) /{ (1 - C1 Q)² +R² C² )

이 되며 여기서 Q = X - (1 / C2)
위 식을 허수 부분을 없애는 조건으로 식을 풀면
위 두식으로 압축된다 여기서 . | R0 는 | 이다 50 [ ] | . Ω
결론적으로 | 과 | 에서 변수는 | 와 | 이다 이것은 | 의 등가식을 ① | ② | X | R | . | Matching Circuit
표현한 것이고 R0와 | 를 알기 때문에 | 과 | 값을 모르더라도 w | R | X | C1과C2를 조정해서
정합 시킬 수 있다 여기서 는 인덕터 . | X | XL = wL | . 를 말한다
지금까지의 | 에는 | 을 거의 쓰지않고 | 식으로 Matching Network | Micom | Aualog
Matching | , | C 을 하였는데 이경우 | 1,C2 값을 모르기 때문에 | 내의 임피던스 Chamber
값을 전혀 알수 없었으나 여기서는 | 상에 LCD Module | C1,C2값을 표시하게 되어있
어 | 의 대략적인 임피던스를 알 수 있도록 하였다 Chamber | .

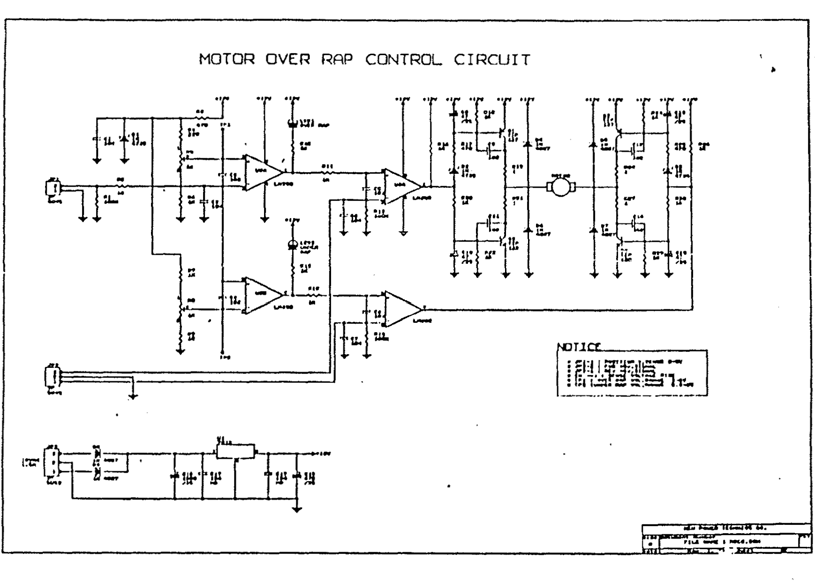
[picture p21: figure]

- 30 -
그림 | 은 | 에서 | 에 | 의 방전을 발생하기 위해서 2-8 | PC | Chamber | Plasma | C1의 전압 절
대 값과, C2, L | DC 로 연결되는 위상값을 필요한만큼으로 만들기 위한 것을 | 전압으
로 | 하고 이것을 | 에서 Sensing | , | Micom | M1,M2 Motor | Motor 에 전원을 보내기 위한
Driver | Curcuit | . Jp1 , Jp2 | Motor | , 용 | 이다 | 과 | 를 이용하여 | 의 방향을 정 역으로 언제든지
변화시킬 수 있으며 | 이 이루어진 다음에도 | 내의 온도 | 종 Matching | Chamber | , Gas
류 압력 등에 따라 미세한 임피던스의 변화에도 즉시 정합되도록 설계되어있다 , | .
그림 | 모터 드라이브 제어회로 2-8

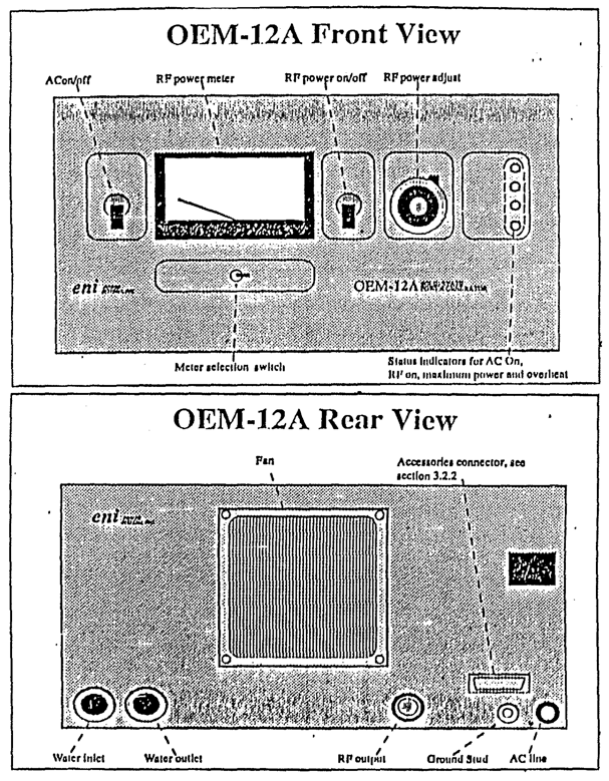
[picture p22: figure]

- 31 -
제 | 장 견품 분석 및 시작 평가 3
본 장에서는 기존 상용제품 | 사의 | 의 제특성과 차 시작품의 측정 결 (ENI | OEM-12) | 1
과를 나타낸다.
제 | 절 견품분석 1
현재 반도체 제조 생산 | 에서 쓰이고 있는 미국 | 사의 제품인 | 를 구 Line | ENI | OEM-12
입하여 전기적 제특성을 분석하였다 먼저 외관의 구조와 규격은 그림 . | 3-1, 3-2
표 | 과 같다 3-1 | .
그림 | 사 제품의 외관 3-1 ENI

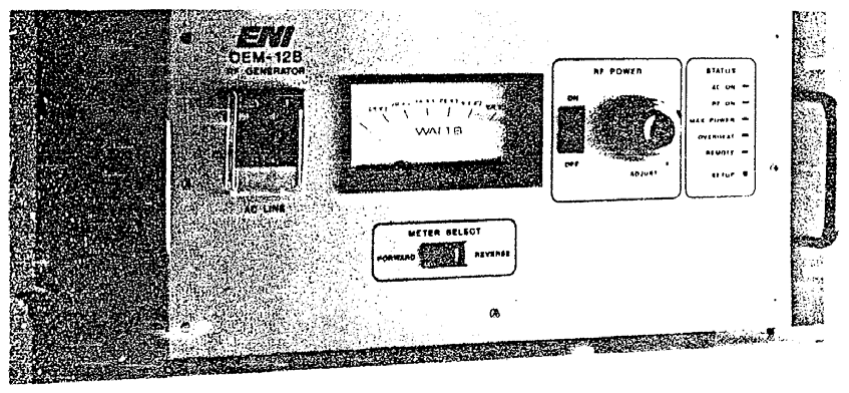
[picture p23: figure]

- 32 -
그림 | 사 제품의 외관 3-2 ENI
구 분 | 사 양
입 력 | 단상 로 단 4 TAP 변화 220[V] (190V~240V)
출 력 | 1250[W] ± 2%
부하 임피던스 | 50 [ ] Ω
반사전력 | 까지 가변 65W~650W
주파수 | 13.56 MHz ± 0.005%
고조파 | 이하 50 dB
RF out Connector | "N" Type
Remote Control | 가능 Local / Remote
Protect | Over Temp, Over Current, MAX Power
RF Output Cable | RG - 214
Display | Analog Type, Forward 와 Reverse 겸용 방식
장비 크기 무게 , | 220 * 432 * 400 (H*W*D), 57kg
Cooling | 수냉식
표 | 사 제품의 사양 3-1 ENI

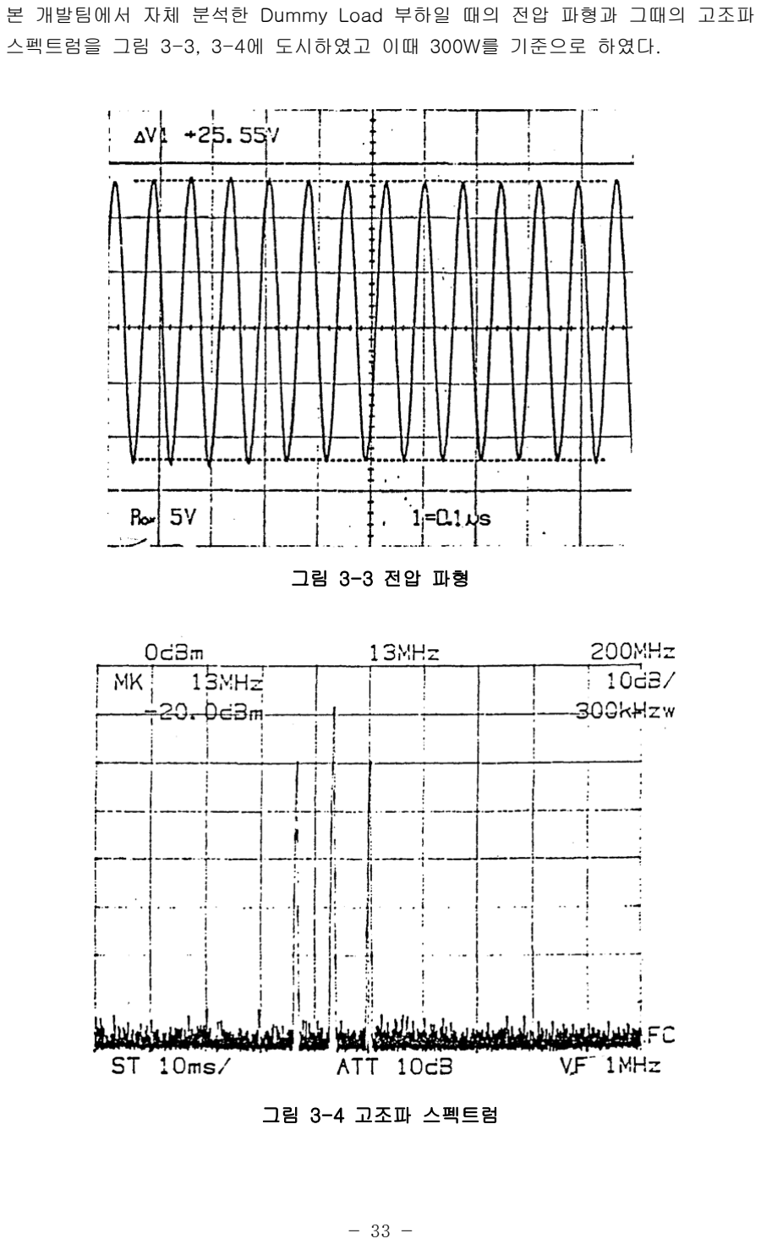
[picture p24: page 33]

- 33 -
본 개발팀에서 자체 분석한 | 부하일 때의 전압 파형과 그때의 고조파 Dummy Load
스펙트럼을 그림 | 에 도시하였고 이때 | 를 기준으로 하였다 3-3, 3-4 | 300W | .
그림 | 전압 파형 3-3
그림 | 고조파 스펙트럼 3-4

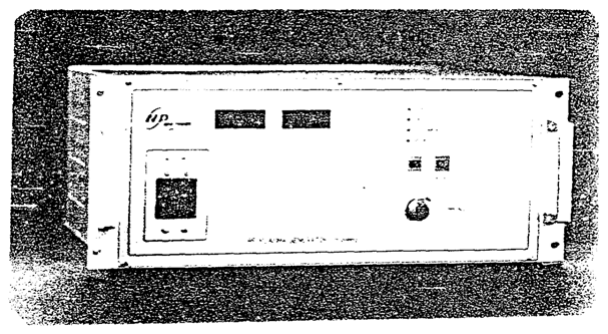
[picture p25: figure]
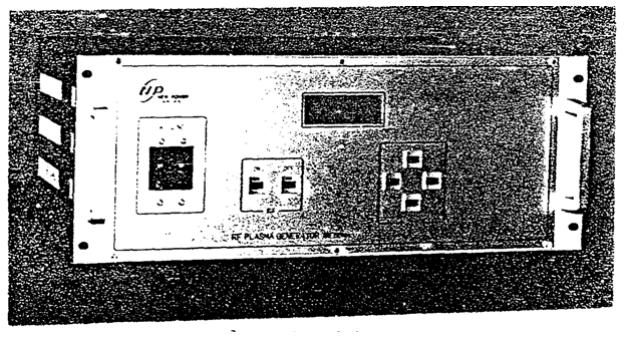
[picture p26: figure]

- 34 -
이상의 결과로부터 전기적 구조적인 제특성은 | 사 발표의 것과 대체로 통일하게 , | ENI
나타나고 있으며 전력효율 면에서 | 입력대비 | 출력이 약 | 정도 임을 알게 AC | RF | 60%
되었다.

제 절 시작평가 2

1. RF Generator의 구조와 전기적인 특징
반도체 제조회사에서 요구하는 경량화 | 방식에 맞추기 위해 | 장치를 , Digital | Control
Micom | Simple | . 방식으로 설계하였으며 디자인도 | 하게 하였다
그림 | 는 비교적 먼거리에서 볼 수 있도록 | 를 3-5 (a) | Forward, Reverse Power | LED
로 설계한 것이고 | 는 가까운거리에서 | 제어가 용이하도록 하며 3-5(b) | Power | LCD
Module | . 를 채용하였다
그림 | 시작품 외관 3-5 (a)
그림 | 시작품 외관 3-5 (b)

- 35 -
표 | 는 본 | 의 개발 사양을 표시한 것이다 3-2 | RF Genenrator | .
기존것과는 | 방식 무게 | 전력효율 등에서 차이가 있고 나머지 부분 Control | , | , Display
은 대등하다.
구 분 | 사 양
입 력 | 단상 220[V] ± 10%
출 력 | 300[W] ± 1%
부하 임피던스 | 50 [ ] Ω
반사전력 | 의 MAX Power 50%
주파수 | 13.56 MHz ± 0.005%
고조파 | 이하 50dB
RF out Connector | "N" Type
remote Control | 가능 Local / Remote (RS-232)
Protect | Over temp, Over Current, MAX Power
RF Output Cable | RG -214
Display | Digital 방식 방식
전력효율 | 85%
장비 크기 무게 , | 175 * 450 * 400 (H*W*D)
Cooling | 수냉식
표 | 시작품 사양 3-2

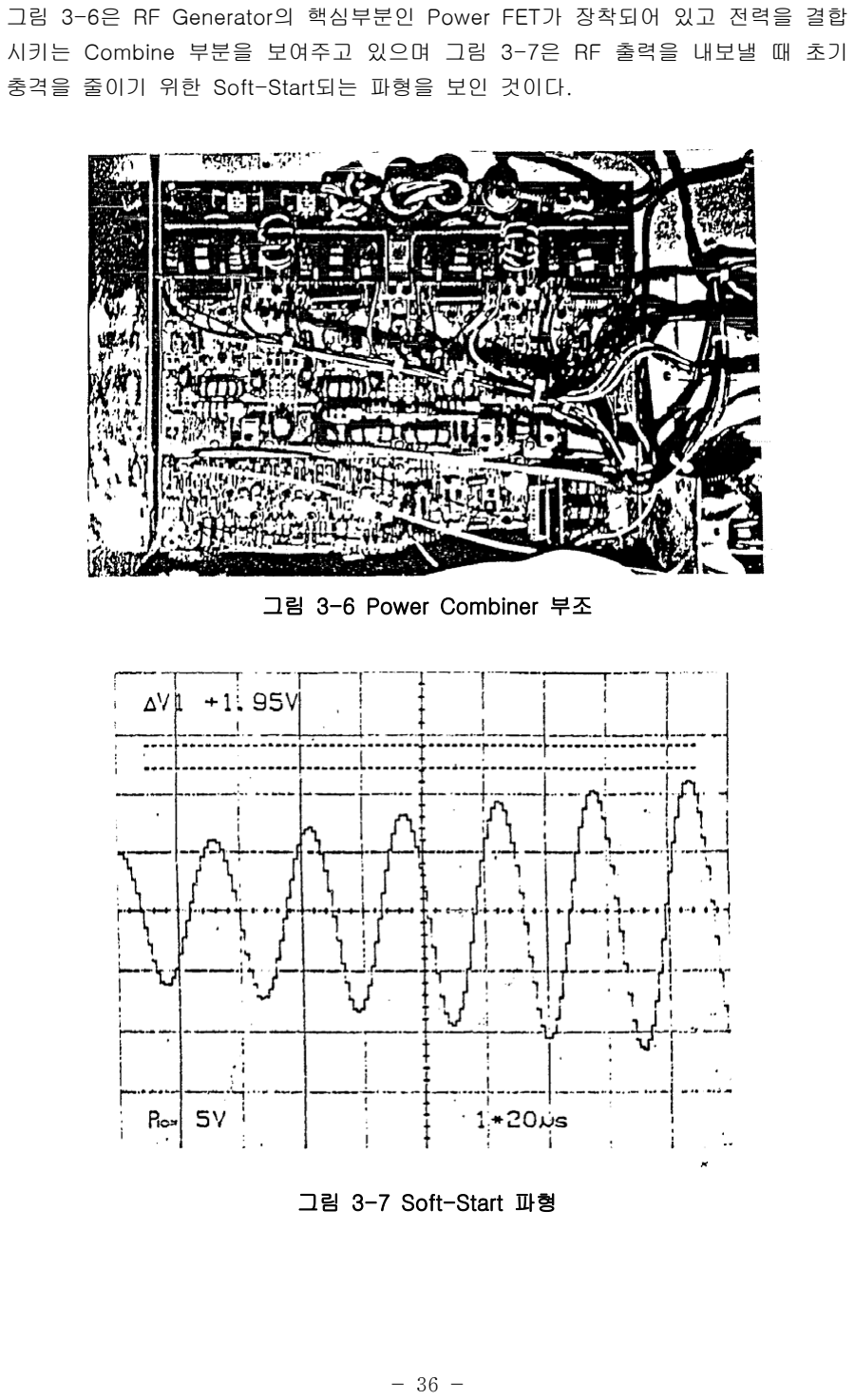
[picture p27: page 36]

- 36 -
그림 | 은 | 의 핵심부분인 | 가 장착되어 있고 전력을 결합 3-6 | RF Generator | Power FET
시키는 | 부분을 보여주고 있으며 그림 | 은 | 출력을 내보낼 때 초기 Combine | 3-7 | RF
충격을 줄이기 위한 | 되는 파형을 보인 것이다 Soft-Start | .
그림 | 부조 3-6 Power Combiner
그림 | 파형 3-7 Soft-Start

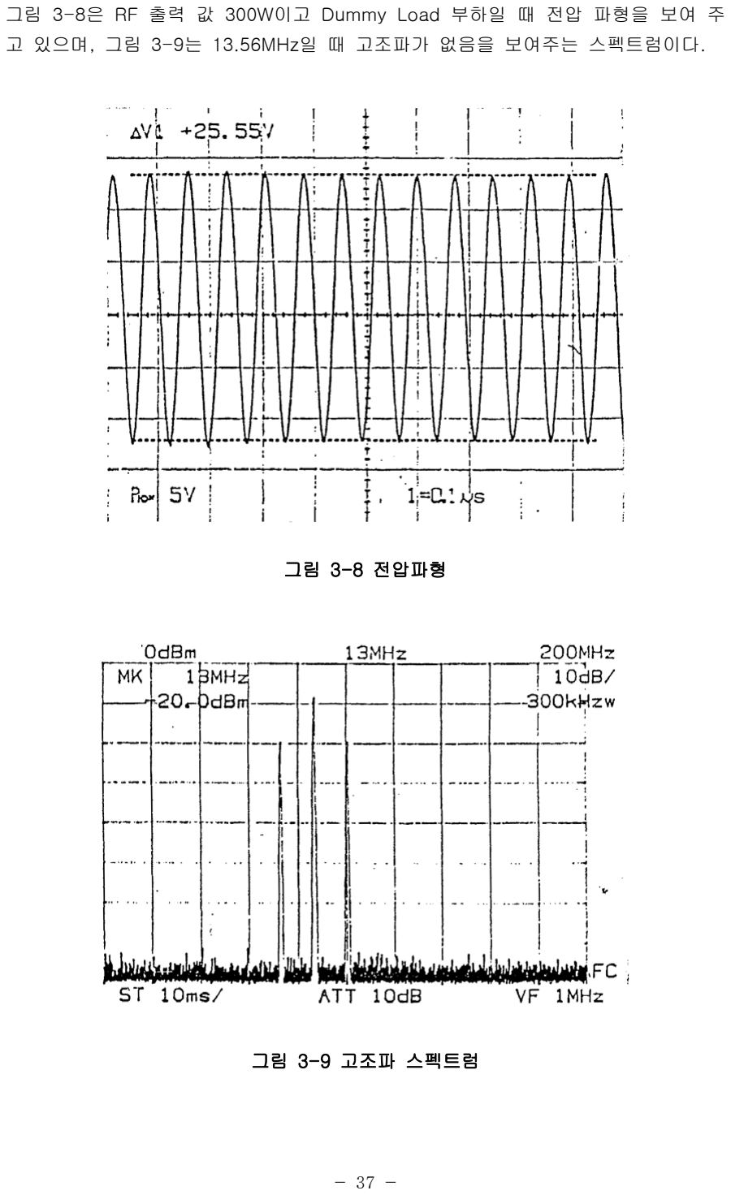
[picture p28: page 37]

- 37 -
그림 | 은 | 출력 값 | 이고 | 부하일 때 전압 파형을 보여 주 3-8 | RF | 300W | Dummy Load
고 있으며 그림 | 는 | 일 때 고조파가 없음을 보여주는 스펙트럼이다 , | 3-9 | 13.56MHz | .
그림 | 전압파형 3-8
그림 | 고조파 스펙트럼 3-9

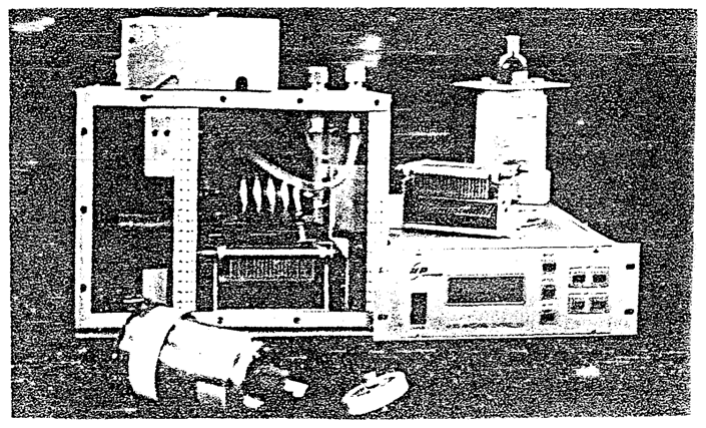
[picture p29: figure]
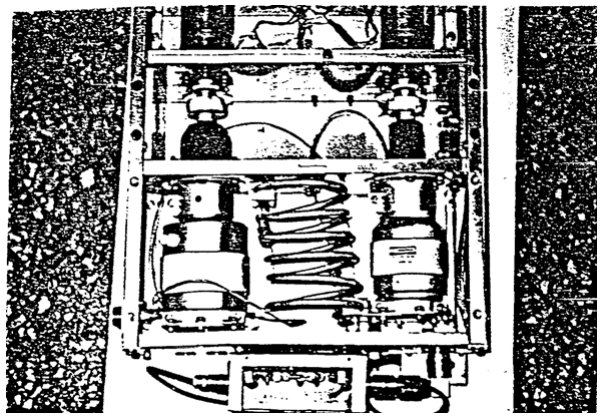
[picture p30: figure]

- 38 -
2. Auto Matcher의 구조와 전기적인 특징
Matcher | RF Generator | Chamber 는 | 와 | 의 정합을 하기 위한 것이고 이때 고려되는
것이 | 상에서 | 가 | 에 가깝게 하면서 | 을 적게 할 RF | Reverse Power | “0" | Matching Time
수 있는 방향으로 연구가 되어야한다 현재는 | 에 따라 약 | 초까지 소 . | Chamber | 3~17
요되고 있다.
그림 | 는 | 와 | 과 구분되어 있는 것을 보여주고 있으며 3-10(a) | Matcher | Controller | C1,
C2가 | 로 이루어져 있으며 | 는 AVC | (b) | C1,C2가 | 로 이루어져있는 | 이다 VVC | Matcher | .
(a) Matcher | Controller 와
그림 | 와 3-10 (b) Matcher | Controller

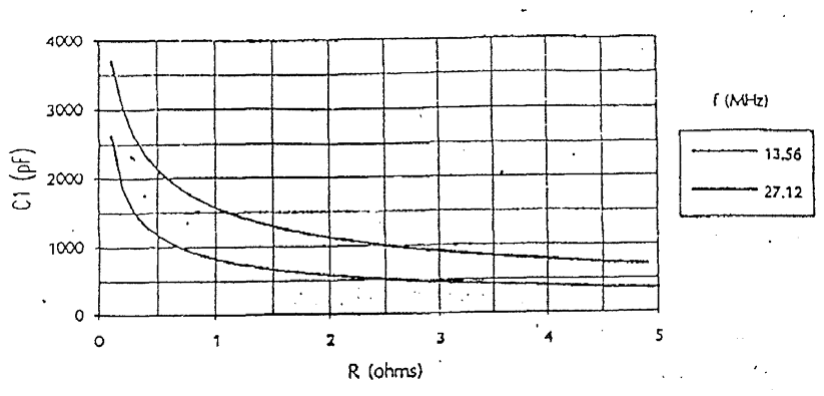
[picture p31: figure]
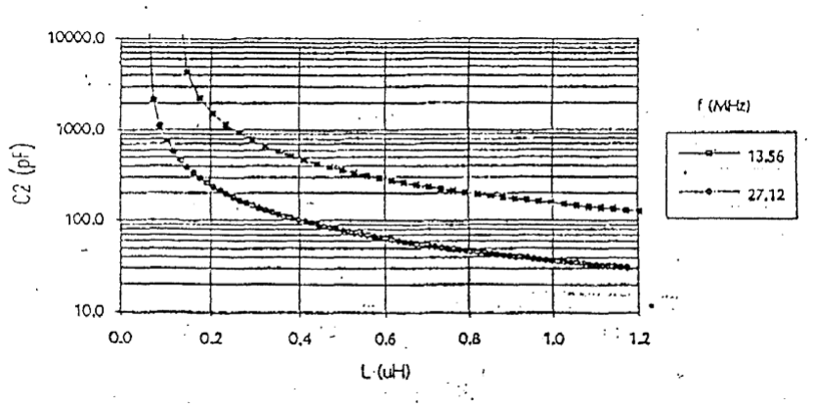
[picture p32: figure]

- 39 -
그림 | 은 주파수 변화에 따른 3-11 | C1,C2, R, L과의 상관 관계를 나타내고있으며
13.56MHz | C 일때 | 1과 의 반비례관계와 R | C2와 이 반비례관계임을 알 수 있다 L | .

(a)

그림 | 주파수 변화에 따른 | 의 변화 3-11 (b) | L, C

- 40 -

### 제 장 검토 사항 4

제 차년도 사업을 수행한 결과 다음의 사항에 대한 문제점이 제기되었다 이를 토 1 | | | | | | .
대로 하여 제 차년도에서 그 해결 방안을 모색하고 나아가 과제목표의 성공적인 2 | ,
달성을 위한 요구사항을 집약해 본다.
1, | RF Generator | DC 시제품 | 에 있어 경량화를 하기 위해서는 필수적인 | 전원부 구성
에서 | 방식을 택하게 되었는데 현재는 | 급으로 제작하였으나 최종목표 SMPS | 300[W]
인 | 급 이상으로 하기위해서는 전력효율을 생각하여 전압 | 전류 1000[W] | 50[V],
40[A] | SMPS | FET 정도의 | 가 필요하게 되며 이는 출력 | 의 병렬 설계를 필요하게 되
므로 차년도에서는 | 의 출력전류를 높일 수 있는 | 의 병렬운전 | 기 2 | SMPS | FET | Control
법 연구에 역점을 두어야한다.
2, RF Generator | Forward, Reverse Power 의 고신뢰성을 추구하기위해서는 | | | | | 를 정확
하게 측정하고 | 할수 있어야만 | 중 가끔 발생되었던 | 가 Control | TEST | RF Power FET
손상되는 것을 막을 수 있다.
현재의 회로에 실험을 통하여 보다 정밀한 값으로 접근해 갈수 있도록 연구 되어야 한다.
3, SMPS | RF Generator | Power 의 출력값 증가와 함께 | 의 출력값을 높이기 위해서는
AMP | Combine | . 단 병렬설계와 전력값을 | 시킬 수 있는 연구가 진행되어야 한다
4, | Power AMP, SMPS | , | Cooling 내구력을 높이기위해 | 단 등의 | 문제와 결로 현상
제거 | 단의 | 방지 등에 보다 정밀한 설계가 되어야한다 , Control | Noise | .
5, Auto Matcher | Sensing | Motor 에서는 | 의 정밀도와 보다 빠른 | 의 기용과 제어를
하여 | 를 줄여 | 내의 | 방전을 보다 빠르게 안정화 시 Matching Time | Chamber | Plasma
켜 | 에 가해지는 충격을 줄여야 한다 Wafer | .
