ArvidJoung/Plasma_RF_Generator/Plasma_RF_Generator_Spec.xlsx

Sheet: Spec
Plasma RF generator Specification |  | 276-ACNA-N9A-FF
 |  | cito | New | Unit
AC Input Voltage |  | 230 | 220 | VAC | 220VAC 전용으로 사용하였는가?
Input voltage range | Single phase | 187~265 | 110/220 | VAC
AC Line Frequency |  | 50/60 | 50/60 | Hz
AC input current | 27.12 MHz, 600W | 4 |  | A
 | 40.68 MHz, 600W | 4.1 |  | A
 | 27.12/40.68 MHz, 1000W | 6.4 | - | A
Ground leakage current |  | < 5 |  | mA
Inrush current |  | < 35 |  | A
Power factor | typical | > 0.95
Output Power range | 600W | 1~600 | 1~100 | W | Power 조정이 1W단위로 조정이 필요한가?
 | 1000W | 1~1000 |  | W
OUtput Load |  | 50 | 50 | ohm
Reflected power limit | 600W | 120 |  | W
 | 1000W | 200 |  | W
Forward power accuracy | 600W | ±1.5 |  | %
 | 1000W | ±2.0 |  | %
Rise time | RF On | < 30 |  | msec
Fall time | RF Off | < 1 |  | msec
Overshoot |  | ≤ 10 |  | %
RF output frequency with tolerance | 27.12 MHz | ±0.01 |  | %
 | 40.68 MHz | ±0.01 |  | %
Output filtering | Harmonic signal | ≤ -40 |  | dBc
 | Spurious signal | ≤ -50 |  | dBc
Ambient temperature | Operating | +5~+35 | ℃
 | Non-operating | -30~+60 | ℃
Size | width x depth x height | 441 x 500 x 88 | mm
Weight |  | < 15 | kg
 | 276-ACNA-N9A-FF

Sheet: Check list
No | Date | Item | Status | Closed | Description | Solution | Commant
1 | 2018-06-01 | Check | OPEN |  | High Power capacitor 및 inductor 부품 search
2 |  |  |  |  | Oscillator 부품 search - Fixed frequency - auto frequency compensation
3 |  |  |  |  | Power Amp 부품 search - 100W 이상 - recommand : 200W
4
5
6
7
8
9
10
11
12
13
14
15
16
17
18
19
20
21
22

Sheet: Device Review
Device | Part Number | Vendor | Description
RF AMP | MRFE6VP61K25H | NXP | 1250W RF Power LDMOS Transistor
