ArvidJoung/Plasma_RF_Generator/1_Schematic/PL_20181206.xlsx

Part Type Report1 for Plasma_RF_Gen_V1.0_POWER_SCH_20181104_VX2.3.sch on 2018-11-15 오후 5:28:05
No | USEINPARTSLIST | Type | PCB Decal | P_value | V_PN | Vendor |  | Comp | V_Desc | Q'ty | Reference No. | tmp | Height | P_size
1 | YES | C-2012 | CHIP/CON/2012 | ? | ? | SAMSUNG |  | 50 | CAP CER 0.1uF 50V 10% X7R 0805 | 10 | C1,C3,C6,C7,C9,C12,C27,C34,C36,C37 |  | 1.0mm | 2.0x1.2
3 | YES | C-2012 | CHIP/CON/2012 | 1nF | CL21B102KB | SAMSUNG |  | 10 | CAP CER 1nF 50V 10% X7R 0805 | 3 | C8,C10,C39 |  | 1.0mm | 2.0x1.2
8 | YES | C-2012 | CHIP/CON/2012 | 10nF | CL21B103KB | SAMSUNG |  | 50 | CAP CER 10nF 50V 10% X7R 0805 | 2 | C28,C30 |  | 1.0mm | 2.0x1.2
9 | YES | C-2012 | CHIP/CON/2012 | 47nF | CL21B473KB | SAMSUNG |  | 50 | CAP CER 47nF 50V 10% X7R 0805 | 1 | C29 |  | 1.0mm | 2.0x1.2
5 | YES | C-2012 | CHIP/CON/2012 | 100nF | CL21B104KB | SAMSUNG |  | 50 | CAP CER 100nF 50V 10% X7R 0805 | 3 | C15,BC1,BC31 |  | 1.0mm | 2.0x1.2
4 | YES | C-2012 | CHIP/CON/2012 | 2.2uF | CL21B225KB | SAMSUNG |  | 100 | CAP CER 2.2uF 50V 10% X7R 0805 | 2 | C11,C40 |  | 1.0mm | 2.0x1.2
10 | YES | C-5750 | CHIP/CON/5750 | ? | ? | TDK |  | 10 | CAP CER ?uF 250V 10% X7R 2220 | 7 | C100,C101,C102,C103,C104,C105,C106 |  | 0.55mm | 1.0x0.5
2 | YES | CAP_8PI | CAP/CHIP/D80 | 47uF/100V | BXJ100VC47MH10 | SAMYOUNG |  |  | 100V, 47uF, 8PI ALUMINUM ELECTROLYTIC CAPACITOR | 2 | C2,C17 |  | 10mm | 10pi
7 | YES | C-MICA_6PITCH | C-MICA_6.5 | 130pF/500V | 130pF/500V | ETC |  |  | CAP MICA 1000pF 500V | 6 | C23,C24,C25,C26,C32,C33 |  |  | 0
6 | YES | C-MICA_9PITCH | C-MICA_9PITCH | 3000pF/500V | 3000pF/500V | ETC |  |  | CAP MICA 1000pF 500V | 2 | C19,C20 |  |  | 0
23 | YES | R-2012 | CHIP/RES/2012 | 0 | RC2012J000 | SAMSUNG |  | 10 | RES SMD 0 OHM 5% 1/8W 0805 | 1 | R20 |  | 0.60mm | 2.0x1.25
14 | YES | R-2012 | CHIP/RES/2012 | 18 | RC2012F180 | SAMSUNG |  | 10 | RES SMD 18 OHM 1% 1/8W 0805 | 1 | R4 |  | 0.60mm | 2.0x1.25
26 | YES | R-2012 | CHIP/RES/2012 | 49.9 | RC2012F49R9 | SAMSUNG |  | 10 | RES SMD 49.9 OHM 1% 1/8W 0805 | 2 | R25,R26 |  | 0.60mm | 2.0x1.25
18 | YES | R-2012 | CHIP/RES/2012 | 330 | RC2012F331 | SAMSUNG |  | 10 | RES SMD 330 OHM 1% 1/8W 0805 | 1 | R12 |  | 0.60mm | 2.0x1.25
13 | YES | R-2012 | CHIP/RES/2012 | 1K | RC2012F102 | SAMSUNG |  | 10 | RES SMD 1K OHM 1% 1/8W 0805 | 6 | R2,R3,R6,R7,R24,R27 |  | 0.60mm | 2.0x1.25
20 | YES | R-2012 | CHIP/RES/2012 | 2.2K | RC2012F222 | SAMSUNG |  | 10 | RES SMD 2.2K OHM 1% 1/8W 0805 | 1 | R14 |  | 0.60mm | 2.0x1.25
21 | YES | R-2012 | CHIP/RES/2012 | 3.3K | RC2012F332 | SAMSUNG |  | 10 | RES SMD 3.3K OHM 1% 1/8W 0805 | 1 | R17 |  | 0.60mm | 2.0x1.25
12 | YES | R-2012 | CHIP/RES/2012 | 4.99K | RC2012F4991 | SAMSUNG |  | 10 | RES SMD 4.99K OHM 1% 1/8W 0805 | 1 | R1 |  | 0.60mm | 2.0x1.25
15 | YES | R-2012 | CHIP/RES/2012 | 8.25K | RC20123F8252 | SAMSUNG |  | 10 | RES SMD 8.25K OHM 1% 1/8W 0805 | 1 | R5 |  | 0.60mm | 2.0x1.25
19 | YES | R-2012 | CHIP/RES/2012 | 10K | RC2012F103 | SAMSUNG |  | 10 | RES SMD 10K OHM 1% 1/8W 0805 | 4 | R13,R15,R16,R19 |  | 0.60mm | 2.0x1.25
17 | YES | R-2012 | CHIP/RES/2012 | 20K | RC2012F203 | SAMSUNG |  | 10 | RES SMD 20K OHM 1% 1/8W 0805 | 1 | R11 |  | 0.60mm | 2.0x1.25
25 | YES | R-6432 | R_MPS-6432 | 1K | RC6432F102 | SAMSUNG |  | 10 | RES SMD 1K OHM 1% 1W 0805 | 1 | R23 |  | 1.0mm | 6.4x3.2
16 | YES | DIP_2W | R-DIP2W_28PITCH | 0.01/2W | 0.01/2W | ETC |  | 10 | RES DIP 0.01 OHM 5% 2W Axial-R | 4 | R8,R9,R10,R28 |  |  | 0
22 | YES | DIP_2W | R-DIP2W_28PITCH | 820/2W | 820/2W | ETC |  | 10 | RES DIP 820 OHM 5% 2W Axial-R | 1 | R18 |  |  | 0
27 | YES | L-2012 | CHIP/IND/2012 | 220nH | CW201212-R22J | Bourns Inc. |  | ? | IND SMD 220nH 300MA 1.1OHM 2012 | 2 | L1,L10 |  | 1.00mm | 2.0x1.2
28 | YES | IND_14PI | IND_14PI | IND-100uH-14PI | CS166125 | ETC |  | ? | IND Core 100uH @ 10Khz 14PI | 5 | L2,L3,L4,L5,L11 |  | 15.0mm | 14.0x14.0
29 | YES | IND_30PI_SMD | L17D_SMD | IND-100uH-30PI | ? | ETC |  | ? | IND Core 100uH @ 10Khz 30PI | 1 | L6 |  | 35.0mm | 30.0x26.0
30 | YES | IND_METAL_16PI | IND_METAL_16PI | IND_14PI | ? |  |  | ? | IND Metal wire 14PI | 3 | L7,L8,L9 |  | 16.0mm | 42.0x16.0
31 | YES | 1N5711W | SOD-123 | 1N5711W | 1N5711W | DIODES |  | 520 | DIODE SMD Fast, VRRM-70V, IF-0.015A, VF-1V | 1 | D1 |  | 1.00mm | 3.75x1.9
32 | YES | 1N4148W | SOD-123 | 1N4148W | 1N4148W | DIODES |  | 520 | DIODE SMD Fast, VRRM-75V, IF-0.3A, VF-1V | 1 | D3 |  | 1.00mm | 3.75x1.9
33 | YES | KDS226 | KDS226-SOT23 | KDS226 | KDS226 | KEC |  | 180 | DIODE VRM-85V, IF-100mA, VF-0.9V | 1 | D4 |  |  | 0
34 | YES | MRF1513N | MRF1513N | MRF1513N | MRF1513N | NXP |  | 12800 | N-Channel MOSFET 520MHz, 3W, 12.5V | 1 | Q1 |  |  | 0
35 | YES | MRFE6VP6300HR3 | MRFE6VP6300H | MRFE6VP6300H | MRFE6VP6300H | NXP |  |  | RF Power Field Effect Transistors | 1 | Q2 |  | 4.32mm | 0
36 | YES | ZXCT1110 | TSOT23-5P | ZXCT1110 | ZXCT1110 | DIODES |  | 2850 | Low Power High-Side Current Monitors | 1 | U1 |  | 1.45mm | 3.05x3.0
37 | YES | KA358A | IC/SO08-1 | KA358A | KA358A | FAIRCHILD |  | 2850 | Dual OPAMP | 2 | U2,U4 |  | 1.45mm | 3.05x3.0
38 | YES | U3 | PMBT2222 | T5B | T5B | NXP |  | 180 | Bipolar Transistors - BJT NPN SW 600MA 40V | 1 | U3 |  | 1.10mm | 3.0x2.5
41 | YES | LAB1143-04 | LAB1143-4P(OP) | LAB1143-04 | LAB1143-04 | HANLIM |  | 80 | 3.96mm Pitch DIP CON, Right Angle 4-Pin | 1 | J4 |  | 7.7mm | 18.5x10
11 | YES | RF_CORE_CT | CT-RF-4 | 1T:2T |  |  |  |  | TRANSFORMER | 1 | CT1 |  |  | 0
43 | YES | RF-800 | RF-800 | 1T:1T | RF-800 | ETC | http://www.communication-concepts.com/rf-800-transformer/ | $6 | TYPE43 2-30MHz 1:1 TRANSFORMER | 1 | TX1 |  |  | 0
44 | YES | RF-1000 | RF-1000 | 1T:2T | RF-1000 | ETC | http://www.communication-concepts.com/rf-800-transformer/ | $7 | TYPE43 2-30MHz 1:2 TRANSFORMER | 1 | TX2 |  |  | 0
45 | YES | VR1-3296W | VR1-3296W | 3296W-103 | 3296W-103 | Bourns |  | 2690 | 10K Trimming Potentiometer | 3 | VR1,VR2,VR3 |  | 10.0mm | 4.9x9.6
39 | YES | HD_2X10 | PIN_HEADER_2X10 | 053048-0610 | 053048-0610 | Molex |  | 220 | 1.25mm Pitch DIP CON, Right Angle 6-Pin | 1 | J1 |  | 3.5mm | 9.25x5.5
40 | YES | SMA_CON | SMA/B_RA | 053048-0610 | 053048-0610 | Molex |  | 220 | 1.25mm Pitch DIP CON, Right Angle 6-Pin | 2 | J2,J3 |  | 3.5mm | 9.25x5.5
24 | YES | R-2012 | CHIP/RES/2012 | NC | NC | SAMSUNG |  | 10 | RES SMD ?K OHM 1% 1/8W 0805 | 2 | R21,R22 |  | 0.60mm | 2.0x1.25
42 | NO | HOLE4.0 | HOLE4.0 |  |  |  |  |  | PCB Assy Hole | 8 | P1,P2,P3,P4,P5,P6,P7,P8 |  |  | 2.0 Pie
Design Part Type count: 28
