ArvidJoung/Plasma_RF_Generator/1_Schematic/Build V2.0/RF-GEN-Change list_20200319.xlsx

Sheet: SET
CPU |  |  |  |  |  |  | POWER
 | #01 | #02 | #03 | #04 | #05 | #06 |  | #01 | #02 | #03 | #04 | #05 | #06
불출 | 집 | Femto | Femto | 집 | 회사 | 집 | 불출 | 회사
ECO | 2/8 | 2/8 | 2/8 | 2/8 | 2/8 | 2/8 | C23,C25,C26 | OK | 100uF/100V-10PI | 220uF | 220uF | 220uF | 220uF | Cap 없는 경우, 12V DC/DC가 오동작(소음도발생)
R67 | 0.15 | - | - | 0.15 | 0.15 | 0.15 | F1 | Short | ECO | ECO | ECO | ECO | ECO
12V I[A] | 0.07 | 0.07 | 0.07 | 0.07 | 0.07 | 0.07 | HD1 | OK | OK | OK | OK | OK | OK
12V | 11.99 | 11.98 | 12.00 | 11.98 | 11.98 | 11.98 | LED1, LED2 | OK | OK | OK | OK | OK | OK
12V P[W] | 0.84 | 0.84 | 0.84 | 0.84 | 0.84 | 0.84 | LED3 | - | OK | - | - | - | -
5V | 5.03 | 5.04 | 5.01 | 5.02 | 5.02 | 5.00 | +12V |  | 12.13 | 12.15 | OK | OK | OK
3.3V | 3.29 | 3.28 | 3.31 | 3.28 | 3.31 | 3.31 | -12V |  | -12.38 | -12.36 | OK | OK | OK
NRST | 3.29 | 3.28 | 3.31 | 3.28 | 3.31 | 3.30 | +9V |  | 8.97 | 9.05 | OK | OK | OK
ST-LINK | OK | OK | OK | OK | OK | OK | R5 | 100 | 100 | 100 | 100 | 100 | 100
PD2_GPIO_ON |  | OK | OK | OK | OK | OK
PRE_AMP_ENA |  | OK | OK | OK | OK | OK
PC7_PWR_ENA |  | OK | OK | OK | OK | OK
LED 3ea |  | OK | OK | OK | OK | OK
F/W DL |  | OK | OK | OK | OK | OK
RF
 | #01 | #02 | #03 | #04 | #05 | #06
 | 회사
L4, L5 | 0 Ohm | 0 Ohm | 0 Ohm | 0 Ohm | 0 Ohm | 0 Ohm
C7 | 330pF | 330pF | 330pF | 330pF | 330pF | 330pF
C104,C105 R8,R9 | NC | NC | NC | NC | NC | NC
R25, R26 | NC | NC | NC | NC | NC | NC
C106 | NC | NC | NC | NC | NC | NC
L7, L8, L9 | 0.6uH/6T | 0.6uH/6T | 0.6uH/6T | 0.6uH/6T | 0.6uH/6T | 0.6uH/6T
C23, C33 | 180pF | 180pF | 180pF | 180pF | 180pF | 180pF
C24, C26 | 150pF | 150pF | 150pF | 150pF | 150pF | 150pF
Full Sample
CPU | 1 | 6 | 4
POWER | 2 | 6 | 4
RF

Sheet: Issue list
RF Gen Issue list
No | Date | PCB | Version | Status | Issue | Description | 기존 회로 | 수정 사항
1 | 2020-01-27 | CPU | v1.0 | Closed | U4 feedback path에 CAP 필요 | RF signal만 증폭시키기 위해 Feedback Path에 Bypass CAP 필요함 | Jumpper 필요 | V2.0 SCH, PCB, PL 수정
2 | 2020-01-27 | CPU | v1.0 | Pending | U4의 Gain이 5.3이상 증가하지 않음 | R20을 1K-> 806으로 조정해도 Gain이 0.2만 상승함(계산치 1이상임)
3 | 2020-02-05 | PWR | v1.0 | OPEN | L4 Core size 확대 | 발열 개선을 위해 큰 size 사용
4 | 2020-02-05 | RF | v2.0 | OPEN | Heat Sink FET Hole 위치 miss | Top view로 작성하여 Mirror 되어 있음 | 재작업
5 | 2020-02-07 | CPU | v1.0 | Closed | R67 value miss | PL의 V_PN, V_Desc 오기 | ECO | V2.0 SCH, PL 수정
6 |  | CPU | v1.0 | Closed | ST-LINK connection error | JNTRST Pull-up NC 처리 후 정상 동작 | ECO | V2.0 SCH, PL 수정
7 |  | CPU | v1.0 | Closed | JTAG1 Pin-map과 DL JIG pin-map miss match | DL JIG에서 CON를 Bottom Solder | JIG 수정 | V2.0 PCB 수정
8 | 2020-02-08 | PWR | v1.0 | Closed | LED1,2가 반대로 실장되어 있음 | SILK가 반대로 되어있음, PCB 수정 필요 | ECO | V2.0 PCB 수정
9 |  | CPU | v1.0 | Closed | U12 input에 Pull-Down 저항 없음 | Pull-Down 4.7K 추가 | 없이 진행 | V2.0 SCH, PCB, PL 수정
10 |  | RF | v2.0 | OPEN | C42,C17 : 47uF/100V/8PI -> 맞는 내압 부품 없음 | C42,C17 : 47uF/100V/8PI -> 47uF/63V/8PI | ECO | V3.0 SCH, PL 수정
11 | 2020-02-09 | RF | v2.0 | Closed | Heat Sink 방향 90도 회전 | 바람이 PCB 양쪽으로 빠질수 있도록 수정 - 도면 수정 | ECO
12 |  | RF | v2.0 | OPEN | 온도 센서 위치 수정 | Heat Sink 회전에 의한 변경 사항
13 | 2020-02-12 | RF | v2.0 | Closed | SEM1이 PL에 빠져 있음 | PL 수정
14 | 2020-02-13 | RF | v2.0 | OPEN | 2012 size 부품을 모두 3216 size로 변경 | 내압 및 W 상향 조정
15 | 2020-02-14 | CPU | v1.0 | OPEN | U10의 PW_PWM의 출력이 3.3V 이다. - 5V pull-up이고, U10의 Vcc가 5V 이므로 출력이 5V 이어야 한다. | PWR PCB 연결시 5V 출력이 나옴
16 | 2020-02-15 | RF | v2.0 | OPEN | L6 PCB library size가 작음
17 | 2020-02-25 | RF | v2.0 | OPEN | FET의 Gate bias 전압을 올려도 출력이 40W이상 올라가지 않음 | RF signal이 Bias path로 빠짐 - Diode 추가 필요 L4, L5 NC 후 20VDC에서 100W 출력 |  | V3.0 SCH, PCB, PL 수정

Sheet: CPU V1.0
RF Generator - CPU V1.0
No | Date | Sheet | Reference | Before | After | Description | SCH | PCB | BOM | Applied Date
1 | 2020-02-05 | 6 | HD1 | Top 배치 | Bottom 배치 Library | HEADER PIN과 PCB Library 구별 | - | 2/5 | - | V1.0 ECO
2 |  | 2 | C69 | - | 2.2uF | RF signal만 증폭시키기 위해 Feedback Path에 Bypass CAP | 2/5 | 2/5 | 2/5 | V1.0 ECO
3 | 2020-02-07 | 5 | R67 | RC5025F101CS | RC5025FR15 | PL의 V_PN, V_Desc 오기 수정 | 2/7 | - | 2/7 | V1.0 ECO
4 |  | 1 | R6, R7, R9 | 10K | NC | ST-LINK Connection error | 2/7 | - | 2/7 | V1.0 ECO
5 | 2020-02-08 | 2 | R21 | 100 | 470 | RF path tune | 2/8 | - | 2/8 | V1.0 ECO
6 |  |  | R20 | 100 | 47 |  |  |  |  | V1.0 ECO
7 |  |  | R22 | 51 | 0 |  |  |  |  | V1.0 ECO
8 |  |  | R23 | 51 | NC |  |  |  |  | V1.0 ECO
9 |  |  | R24 | 51 | NC |  |  |  |  | V1.0 ECO
10 |  | 4 | R85, R86, R87 | - | 4.7K | Buffer input에 Pull-Down 저항 추가 | 2/8 | 2/8 | 2/8 | V2.0
11
12
13
14
15

Sheet: PWR V1.0
RF Generator - PWR V1.0
No | Date | Sheet | Reference | Before | After | Description | SCH | PCB | BOM | Applied Date
1 | 2020-02-05 | 3 | F1 | HOLE - circle | HOLE - 장홀 | PCB Library miss - Hole | - | 2/5 | - | V2.0
2 |  | 4 | HD1 | HIF3H-20PA-2.54DSA | PIN_HEADER_10X2 | PN Miss 수정 | 2/5 | - | 2/5 | V1.0 ECO
3 | 2020-02-08 | 2 | LED1, LED2 | LED-2012 | LED/CHIP/2012 | PCB Library miss 수정 | - | 2/8 | - | V1.0 ECO
4 | 2020-02-10 | 2 | R7 | 2K | 10K | LED 밝기 조정 | 2/10 | - | 2/10 | V1.0 ECO
5 |  | 2 | LED3 | - | BL-HUE35A | -12V LED 추가 | 2/10 | 2/10 | 2/10 | V2.0
6 |  | 2 | R18 | - | 10K |  |  |  |  | V2.0
7 | 2020-02-12 | 2 | TP | - | -12V | -12V Test point 추가 | 2/12 | 2/12 | 2/12 | V2.0
8 | 2020-03-02 | 1 | R5 | 680 | 100 | RF Gain 올림 V/V Gain = 7.8 Vout, RFIN=15V | 3/2 | - | 3/2 | V1.0 ECO
9
10
11
12
13
14
15

Sheet: RF V2.0
RF Generator - RF V2.0
No | Date | Sheet | Reference | Before | After | Description | SCH | PCB | BOM | Applied Date
1 | 2020-02-13 | 3 | C42,C17 | 47uF/100V | 47uF/63V | 8Ø size에 맞는 내압으로 변경 | 2/13 | - | 2/13
2 | 2020-03-02 | 3 | L4,L5 | 0.25uH-14PI | Short | 출력 개선( Origin max 40W) | 3/30 |  | 3/30
3 | 2020-03-29 | 2 | C7 | 18pF | 330pF | 오기 수정 | 3/30 | - | 3/30
4 |  | 3 | C104,C105,C106 | ?/C-5750 | NC/C-5750 |  | 3/30 | - | 3/30
5 |  | 3 | R8, R9 | 680/2W | NC |  | 3/30 | - | 3/30
6 |  | 3 | R25, R26 | 49.9 | D1, D2, LL4148 | Gate Vin 반파 정류 | 3/30 |  | 3/30
7 |  | 3 | C104,C105 | Q2 3,4-Pin | GND | snubber로 변경 | 3/30 |  | 3/30
8 |  | 4 | L7,L8,L9 | 1.0uH / 30PI | 0.6uH / 30PI / 6T | fc=20MHz chebyshev filter | 3/30 | - | 3/30
9 |  | 4 | C23,C33 | 130pF/500V | 180pF/500V |  | 3/30 | - | 3/30
10 |  | 4 | C24,C26 | 180pF/500V | 150pF/500V |  | 3/30 | - | 3/30
11
12
13
14
15
