ArvidJoung/Plasma_RF_Generator/1_Schematic/Build V2.0/RF Generator Review Data_20191112.xlsx

Sheet: ADC
1. DC48V review
 | POWER PCB에서 12V range로 맞추고, CPU OP-amp input에서 5V range로 converting한다.
 | 이를 OP-amp output에서 3.3V range로 맞춘다.
 | 1) VDC_IN
 |  | Under INPUT Voltage :
 |  | Over INPUT Voltage : 56V 이상
 |  | VDC | Min | Max
 |  | 48.0 | 40 | 56
 |  | Power Block |  | OPAMP Block |  |  |  | Unit
 |  | R89 | 24 | R28 | 4.7 | R26 | 2.7 | KΩ
 |  | R90 | 4.99 | R27 | 4.7 | R25 | 3.0 | KΩ |  |  |  |  |  | VIN | 48 | 38.4 | 57.6 | V
 |  | IN48V | VDC_IN | OPAmp IN |  | VDC_IN_AD |  | ADC |  |  |  |  |  | R87 | 24 | 20 | 20 | KΩ
 |  | 0 | 0.0 | 0.00 |  | 0.00 |  | 0 |  |  |  |  |  | R86 | 4.99 | 4.99 | 4.99 | KΩ
 |  | 4 | 0.7 | 0.34 |  | 0.18 |  | 224.8374708 |  |  |  |  |  | I_IN | 1.66 | 1.54 | 2.30 | mA
 |  | 8 | 1.4 | 0.69 |  | 0.36 |  | 449.6749415 |  |  |  |  |  | P_IN | 0.08 | 0.06 | 0.13 | W
 |  | 12 | 2.1 | 1.03 |  | 0.54 |  | 674.5124123 |  |  |  |  |  | V_R2 | 8.26 | 7.67 | 11.50 | V
 |  | 16 | 2.8 | 1.38 |  | 0.72 |  | 899.3498831
 |  | 20 | 3.4 | 1.72 |  | 0.91 |  | 1124.187354
 |  | 24 | 4.1 | 2.07 |  | 1.09 |  | 1349.024825
 |  | 28 | 4.8 | 2.41 |  | 1.27 |  | 1573.862295
 |  | 32 | 5.5 | 2.75 |  | 1.45 |  | 1798.699766
 |  | 36 | 6.2 | 3.10 |  | 1.63 |  | 2023.537237
 |  | 40 | 6.9 | 3.44 |  | 1.81 |  | 2248.374708
 |  | 44 | 7.6 | 3.79 |  | 1.99 |  | 2473.212178
 |  | 48 | 8.3 | 4.13 |  | 2.17 |  | 2698.049649
 |  | 52 | 9.0 | 4.48 |  | 2.36 |  | 2922.88712
 |  | 56 | 9.6 | 4.82 |  | 2.54 |  | 3147.724591
 |  | 60 | 10.3 | 5.16 |  | 2.72 |  | 3372.562061
 |  | 64 | 11.0 | 5.51 |  | 2.90 |  | 3597.399532
 |  | 68 | 11.7 | 5.85 |  | 3.08 |  | 3822.237003
 | 2) VDC_OUT
 |  | Over OUTPUT Voltage : 48V 이상
 |  | 48.0V | 80.0% | 38.4
 |  | Power Block |  | OPAMP Block |  |  |  | Unit
 |  | R91 | 24 | R32 | 4.7 | R30 | 2.7 | KΩ
 |  | R92 | 4.99 | R31 | 4.7 | R29 | 3.0 | KΩ
 |  | OUT48V | VDC_OUT | OPAmp IN |  | VDC_OUT_AD |  | ADC
 |  | 0 | 0.0 | 0.00 |  | 0.00 |  | 0
 |  | 4 | 0.7 | 0.34 |  | 0.18 |  | 224.8374708
 |  | 8 | 1.4 | 0.69 |  | 0.36 |  | 449.6749415
 |  | 12 | 2.1 | 1.03 |  | 0.54 |  | 674.5124123
 |  | 16 | 2.8 | 1.38 |  | 0.72 |  | 899.3498831
 |  | 20 | 3.4 | 1.72 |  | 0.91 |  | 1124.187354
 |  | 24 | 4.1 | 2.07 |  | 1.09 |  | 1349.024825
 |  | 28 | 4.8 | 2.41 |  | 1.27 |  | 1573.862295
 |  | 32 | 5.5 | 2.75 |  | 1.45 |  | 1798.699766
 |  | 38.4 | 6.6 | 3.30 |  | 1.74 |  | 2158.439719
 |  | 40 | 6.9 | 3.44 |  | 1.81 |  | 2248.374708
 |  | 44 | 7.6 | 3.79 |  | 1.99 |  | 2473.212178
 |  | 48 | 8.3 | 4.13 |  | 2.17 |  | 2698.049649
 |  | 52 | 9.0 | 4.48 |  | 2.36 |  | 2922.88712
 |  | 56 | 9.6 | 4.82 |  | 2.54 |  | 3147.724591
 | 3) PW_IS_AD
 |  | CT target : 1.51V ( 10A )
 |  | CT Limit : 1.81V ( 12A )
 |  | POWER | 600 | W |  | PP1S20-12
 |  | VCC | 48 | V |  |  | Vout = 4V at 20A
 |  | ICC | 12.5 | A |  | Vout를 전류에 대해 linear하다고 가정하고 계산
 |  | PP1S10-12 |  | Power Block |  |  |  | OPAMP Block |  |  |  | Unit
 |  | Current[A] | 20 | R85 | 0.47 | R88 | 20.0 | R36 | 4.7 | R34 | 2.7 | KΩ
 |  | Vout[V] | 4 | R86 | 10 | R87 | 10.0 | R35 | 4.7 | R33 | 3.0 | KΩ
 |  | Iout | Vout | OP-Amp Input |  | PWR_IS_CT |  | OP-Amp Input |  | PW_IS_AD |  | ADC
 |  | 0 | 0.0 | 0.00 |  | 0.00 |  | 0.00 |  | 0.00 |  | 0
 |  | 2 | 0.4 | 0.38 |  | 1.15 |  | 0.57 |  | 0.30 |  | 374.3664971
 |  | 4 | 0.8 | 0.76 |  | 2.29 |  | 1.15 |  | 0.60 |  | 748.7329942
 |  | 6 | 1.2 | 1.15 |  | 3.44 |  | 1.72 |  | 0.90 |  | 1123.099491
 |  | 8 | 1.6 | 1.53 |  | 4.58 |  | 2.29 |  | 1.21 |  | 1497.465988
 |  | 10 | 2.0 | 1.91 |  | 5.73 |  | 2.87 |  | 1.51 |  | 1871.832486
 |  | 12 | 2.4 | 2.29 |  | 6.88 |  | 3.44 |  | 1.81 |  | 2246.198983
 |  | 14 | 2.8 | 2.67 |  | 8.02 |  | 4.01 |  | 2.11 |  | 2620.56548
 |  | 16 | 3.2 | 3.06 |  | 9.17 |  | 4.58 |  | 2.41 |  | 2994.931977
 |  | 18 | 3.6 | 3.44 |  | 10.32 |  | 5.16 |  | 2.71 |  | 3369.298474
 |  | 20 | 4.0 | 3.82 |  | 11.46 |  | 5.73 |  | 3.02 |  | 3743.664971
 | 4) FAN_PW
 |  | target Current : 0.6A 이상
 |  | Limit Current : 0.3A 이하
 |  | FAN | FAN Block |  |  |  |  |  | OPAMP Block |  |  |  | Unit
 |  |  | R77 | 0.5 | R80 | 10.0 | R79 | 0.0 | R40 | 4.7 | R38 | 2.7 | KΩ
 |  |  |  |  | R81 | 1.0 | R78 | 10000.0 | R39 | 4.7 | R37 | 3.0 | KΩ
 |  | Current | Vin | PWR | OP-Amp OUT |  | FAN_PW |  | OP-Amp Input |  | PWR_IS_CT |  | ADC
 |  | 0.0 | 0.00 | 0.00 | 0.00 |  | 0.00 |  | 0.00 |  | 0.00 |  | 0
 |  | 0.1 | 0.05 | 0.01 | 0.55 |  | 0.55 |  | 0.28 |  | 0.14 |  | 179.6491228
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
 |  | 8.0 | 7.92 |  | 3.96 |  | 2.08 |  | 2587.206089
 |  | 9.0 | 8.91 |  | 4.46 |  | 2.34 |  | 2910.60685
 |  | 10.0 | 9.90 |  | 4.95 |  | 2.61 |  | 3234.007611
 |  | 11.0 | 10.89 |  | 5.45 |  | 2.87 |  | 3557.408372
 |  | 12.0 | 11.88 |  | 5.94 |  | 3.13 |  | 3880.809134

Sheet: FET TEMP
1. Temp Sensor ADC review
 | EC2F103A2-40113 Spec |  |  |  | operating disable
 |  | B contant | 3435 | K
 |  | R25 | 10 | KΩ
 | Temp ADC calculation
 |  | POWER PCB에서 RH_TEMP_OP output range는 5V 이하여야 한다.
 |  | CPU PCB에서 RH_TEMP_OP를 3.3V Range로 converting한다.
 |  | Limit Temperature : 75℃ 이상
 |  |  |  | RF |  |  |  | MCU PCB |  |  |  | Unit
 |  |  |  | V | 12 |  |  | V | 5 | V | 3.3 | V
 |  |  |  | R1 | 2 | R3 | 0.47 | R52 | 2 | R50 | 2.7 | KΩ
 |  |  |  | R2 | 2 | R4 | 47 | R51 | 20 | R49 | 3 | KΩ
 |  | Temp | R_therm | U1A_IN |  | FET_TEMP |  | OPAmp_IN |  | RH_TEMP_AD |  | ADC
 |  | 0 | 28.7 | 0.73 |  | 0.73 |  | 0.66 |  | 0.35 |  | 433.2283521
 |  | 5 | 22.9 | 0.89 |  | 0.89 |  | 0.81 |  | 0.42 |  | 526.8988862
 |  | 10 | 18.4 | 1.07 |  | 1.07 |  | 0.97 |  | 0.51 |  | 632.5130189
 |  | 15 | 14.9 | 1.27 |  | 1.26 |  | 1.15 |  | 0.60 |  | 749.5189294
 |  | 20 | 12.2 | 1.48 |  | 1.48 |  | 1.34 |  | 0.71 |  | 876.8633219
 |  | 25 | 10.0 | 1.71 |  | 1.71 |  | 1.55 |  | 0.82 |  | 1013.01731
 |  | 30 | 8.3 | 1.96 |  | 1.95 |  | 1.77 |  | 0.93 |  | 1156.050614
 |  | 35 | 6.9 | 2.21 |  | 2.20 |  | 2.00 |  | 1.05 |  | 1303.747207
 |  | 40 | 5.8 | 2.46 |  | 2.45 |  | 2.23 |  | 1.17 |  | 1453.747929
 |  | 45 | 4.8 | 2.71 |  | 2.70 |  | 2.45 |  | 1.29 |  | 1603.701081
 |  | 50 | 4.1 | 2.96 |  | 2.95 |  | 2.68 |  | 1.41 |  | 1751.401583
 |  | 55 | 3.5 | 3.21 |  | 3.19 |  | 2.90 |  | 1.53 |  | 1894.903021
 |  | 60 | 3.0 | 3.44 |  | 3.42 |  | 3.11 |  | 1.64 |  | 2032.593244
 |  | 65 | 2.6 | 3.66 |  | 3.64 |  | 3.31 |  | 1.74 |  | 2163.231215
 |  | 70 | 2.2 | 3.87 |  | 3.85 |  | 3.50 |  | 1.84 |  | 2285.948835
 |  | 75 | 1.9 | 4.06 |  | 4.04 |  | 3.67 |  | 1.93 |  | 2400.225347
 |  | 80 | 1.7 | 4.24 |  | 4.22 |  | 3.84 |  | 2.02 |  | 2505.843467
 |  | 85 | 1.4 | 4.40 |  | 4.38 |  | 3.98 |  | 2.10 |  | 2602.83608
 |  | 90 | 1.3 | 4.55 |  | 4.53 |  | 4.12 |  | 2.17 |  | 2691.430745
 |  | 95 | 1.1 | 4.69 |  | 4.67 |  | 4.24 |  | 2.23 |  | 2771.997221
 |  | 100 | 1.0 | 4.81 |  | 4.79 |  | 4.36 |  | 2.29 |  | 2845.001195
 |  | 105 | 0.9 | 4.93 |  | 4.90 |  | 4.46 |  | 2.35 |  | 2910.965686
 |  | 110 | 0.8 | 5.03 |  | 5.00 |  | 4.55 |  | 2.39 |  | 2970.440414
 |  | 115 | 0.7 | 5.12 |  | 5.09 |  | 4.63 |  | 2.44 |  | 3023.978569
 |  | 120 | 0.6 | 5.20 |  | 5.17 |  | 4.70 |  | 2.48 |  | 3072.120064
 |  | 125 | 0.6 | 5.27 |  | 5.25 |  | 4.77 |  | 2.51 |  | 3115.380116
 |  | 130 | 0.5 | 5.34 |  | 5.31 |  | 4.83 |  | 2.54 |  | 3154.242081
 |  | 135 | 0.4 | 5.40 |  | 5.37 |  | 4.88 |  | 2.57 |  | 3189.153509

Sheet: Operation MODE
Operation Mode
 | MODE | Description
 | Standby | 초기 Booting 상태
 |  | PC와 RS-232 통신 Set-up
 |  | Error 상태 Check 및 Report
 | READY | Error ALL PASS
 |  | AD9834 설정(RF signal)
 |  | FAN operation
 | START | RF 출력 상태
 |  | On/Off time에 맞춰 DDS RF ON/OFF 동작
 |  | OUTPUT Over Voltage error check
 |  | Over Current error check
 | Test | Hidden menu 상태

Sheet: FW Function
Error 및 Monitor Item list
 | Hidden menu에 모두 display
 | No | Error or Monitor Item | Description | ERROR 조건 | Display | COMMENT
 | 1 | LCD communication Error | LCD PC와의 통신 상태 | LCD PC에서 MCU와의 통신 check | Hidden menu
 | 2 | RF Cable detect error | RF cable 미연결 상태 | PB12_LIMIT_SW_A : LOW - PASS, HIGH - FAIL | Hidden menu
 | 3 | Case detect error | Case 미조립 상태 | PB13_LIMIT_SW_B : LOW - PASS, HIGH - FAIL | Hidden menu
 | 4 | INPUT Under Voltage error | IN48V : 40V 이하 SMPS 불량 및 +48V path 불량 | VDC_IN_AD : 1.81V 이하(ADC : 2248) | Hidden menu | 48V SMPS 40V 이하일 경우
 | 5 | INPUT Over Voltage error | IN48V : 56V 이상 SMPS 불량 및 +48V path 불량 | VDC_IN_AD : 2.54V 이상(ADC : 3148) | Hidden menu | 48V SMPS 56V 이상일 경우
 | 6 | OUTPUT Over Voltage error | OUT48V : 56V 이상 CPU Power block 불량 | VDC_OUT_AD : 2.17V 이상(ADC : 2698) | Hidden menu | Buck 출력 48V 이상일 경우(추후 80%로 제한 예정)
 | 7 | Over Current error | 과전류 상태 | PW_IS_AD : 1.81V 이상(ADC : 2246) | Hidden menu | Test 후 optimize 예정
 | 8 | FAN abnormal operation error | FAN 비정상 동작 상태 | FAN_PW_AD : 0.83V 이하(ADC : 1029) | Hidden menu | Test 후 optimize 예정
 | 9 | RF Temperature Error | RF Transistor Over(65℃) temp 상태 | FET_T_AD : 1.94V 이상(ADC : 2412) | Hidden menu | "FET TEMP" sheet 참조하여 온도로 표시
 | 10 | Forward Power monitor | Power Monitor에만 사용 | FW_CT_AD ADC display | Hidden menu | 추후 ADC value를 실제 Power 값으로 변환해서 LCD display 예정
 | 11 | Reflected Power monitor | Power Monitor에만 사용 | RV_CT_AD ADC display | Hidden menu | 추후 ADC value를 실제 Power 값으로 변환해서 LCD display 예정
TIMER Operation
 | No | TIMER | Frequency | Duty | F/W
 | 1 | PA6_FAN_PWM | 25KHz | 100% | 2/29
 | 2 | PC6_PW_PWM | 50KHz | 설정값에 따라 조정 : %로 표시 targer value까지 Counter value를 2씩 순차적으로 상승해야 함 RF On time과 동기
GPIO Operation
 | No | GPIO | Function | 동작 | F/W
 | 1 | COM_LED | LCD 통신 상태 표시 | 통신 중 LED toggle
 | 2 | WDT_LED | MCU watch dog LED | MCU 정상 동작중 LED toggle
 | 3 | PLA_ON_LED | RF On 상태 LED | RF ON시 LED On 상태 유지 | 2/29
 | 4 | PC7_PWR_ENA | RF 48V 전원 control | Default, RF OFF : PC7_PWR_ENA = LOW RF ON : PC7_PWR_ENA = HIGH PC6_PW_PWM와 동기 / PC7_PWR_ENA가 먼저 ON RF On time과 동기
 | 5 | PC8_PRE_AMP_ENA | RF PCB의 Bias control | Default, RF OFF : PC8_PRE_AMP_ENA = LOW RF ON : PC8_PRE_AMP_ENA = HIGH RF On time과 동기
 | 6 | PB6_BIAS_ON | RF PCB의 Bias control | Default, RF OFF : PB6_BIAS_ON = LOW RF ON : PB6_BIAS_ON = HIGH RF On time과 동기
 | 7 | PB7_GPIO_ON | 5V Driver사용 GPIO control | Default : PB7_GPIO_ON = LOW GPIO 설정 완료 후 : PB7_GPIO_ON = HIGH
EEPROM 동작
 | I2C1으로 통신
 | Write protection enable : EEPROM에 data write시에만 EPROM_WP Pin을 Low로 설정. 보통은 High 유지
 | PC6_PW_PWM 설정치 저장 : Test mode에서 출력 Power에 맞는 Timer의 duty value를 저장함

Sheet: LCD
LCD Menu
입력 방법은 입력칸 선택시 화면에 Key PAD가 활성화 되거나 +/- 버튼을 이용하여 숫자 입력 가능하도록 지원
1 | PWM 설정 | PC6_PW_PWM 조정
 |  | PWM Duty를 %로 설정 가능하도록 지원
 |  | 설정치까지 1%씩 or Counter value를 2씩 순차적으로 상승해야 함
2 | RF On Time | DDS On Time
 |  | msec 단위로 RF On time 설정 가능하도록 지원
 |  | START mode에서 RF가 항상 On되는 것이 아니라 설정에 맞춰 On/Off time이 조정됨
3 | RF Off Time | DDS Off Time
 |  | msec 단위로 RF Off time 설정 가능하도록 지원
 |  | START mode에서 RF가 항상 On되는 것이 아니라 설정에 맞춰 On/Off time이 조정됨
4 | Repeat mode 선택 | Continuous : 설정된 RF On/Off time에 맞춰 연속적으로 출력
 |  | Single : 설정된 RF On/Off time에 맞춰 1회 출력
 |  | 둘중에 하나만 선택되도록 지원
5 | RF ON/OFF 버튼 | READY : 기본 상태
 |  | START : READY 상태에서 한번 클릭하면, Run mode에 맞춰 RF 출력, 다시 클릭시 RF off되며 READY로 원복
 |  | Run mode 상태가 single인 경우, 1회 출력 후 Ready로 원복
Display 항목
 | Error 및 Monitor Item list에 있는 항목들에 대한 Data 값 display

Sheet: CPU Pin-map
Off-page | Function | Description | No | Name | I/O | Function | GPIO
VDC_IN_AD | +48 input Voltage monitor | Under INPUT Voltage : 40V 이하 Over INPUT Voltage : 56V 이상 | 8 | PC0 | TTa | ADC_IN10 | No-PULL
VDC_OUT_AD | Buck output Voltage monitor | Over OUTPUT Voltage : 48V 이상 | 9 | PC1 | TTa | ADC_IN11 | No-PULL
PW_IS_AD | 과전류 상태 monitor | PW_IS_AD : 1.81V 이상(ADC : 2246) | 10 | PC2 | TTa | ADC_IN12 | No-PULL
FAN_PW_AD | FAN 동작 상태 monitor | FAN_PW_AD : 0.83V 이하(ADC : 1029) | 11 | PC3 | TTa | ADC_IN13 | No-PULL
RV_CT_AD | Reflected Power monitor |  | 14 | PA0 | TTa | ADC_IN0 | No-PULL
FW_CT_AD | Forward Power monitor |  | 15 | PA1 | TTa | ADC_IN1 | No-PULL
FET_T_AD | RF Temperature | RF Transistor Over(65℃) temp 상태 | 16 | PA2 | TTa | ADC_IN2 | No-PULL | LCD communication Error
PA6_FAN_PWM | FAN 속도 제어(25KHz) | Buck, RF FET 냉각 | 22 | PA6 | TTa | TIM16_CH1 | PULL-DOWN | RF Cable detect error
DDS_SLEEP | HIGH : Power Down | DDS control | 26 | PB0 | TTa | GPIO_OUT | PULL-DOWN | Case detect error
DDS_RESET | HIGH : Reset |  | 27 | PB1 | TTa | GPIO_OUT | PULL-DOWN | INPUT Under Voltage error
DDS_FSYNC | Low Active |  | 28 | PB2 | FT | GPIO_OUT | PULL-UP | INPUT Over Voltage error
DDS_CLK |  |  | 29 | PB10 | FT | I2C2_SCL | PULL-UP | OUTPUT Over Voltage error
DDS_DATA |  |  | 30 | PB11 | FT | I2C2_SDA | PULL-UP | Over Current error
PB12_LIMIT_SW_A | Low Active | RF Cable detect error | 33 | PB12 | FT | GPIO_EXTI12 | PULL-UP | FAN abnormal operation error
PB13_LIMIT_SW_B | Low Active | Case detect error | 34 | PB13 | FTf | GPIO_EXTI13 | PULL-UP | RF Temperature Error
JP_BIAS | Low Active | Not used | 35 | PB14 | FTf | GPIO_IN | PULL-UP | Forward Power monitor
PC6_PW_PWM | 50KHz | Buck Vout control | 37 | PC6 | FT | TIM3_CH1 | PULL-DOWN | Reflected Power monitor
PC7_PWR_ENA | RF 48V 전원 control | PC6_PW_PWM Path On/Off control | 38 | PC7 | FT | GPIO_OUT | PULL-DOWN
PC8_PRE_AMP_ENA | RF PCB의 Bias control | PWR PCB의 RF pre-amp On/Off control | 39 | PC8 | FT | GPIO_OUT | PULL-DOWN
USART1_TX | LCD와 통신 | LCD와 RS-232 통신 | 42 | PA9 | FT | USART1_TX | n/a
USART1_RX | LCD와 통신 |  | 43 | PA10 | FT | USART1_RX | n/a
PD2_GPIO_ON | Low Active | GPIO Drive IC On/Off control | 54 | PD2 | FT | GPIO_OUT | No-PULL
COM_LED | Low Active | LCD 통신 상태 표시 | 55 | PB3 | FT | GPIO_OUT | No-PULL
WDT_LED | Low Active | CPU watch-dog 상태 표시 | 56 | PB4 | FT | GPIO_OUT | No-PULL
EPROM_WP | Low Active | EEPROM write protection | 57 | PB5 | FT | GPIO_OUT | PULL-UP
PB6_BIAS_ON | HIGH Active | RF FET bias +9V On/Off control | 58 | PB6 | FTf | GPIO_OUT | PULL-DOWN
I2C1_SDA |  | EEPROM I2C 통신 | 59 | PB7 | FTf | I2C1_SDA | PULL-UP
I2C1_SCL |  | EEPROM I2C 통신 | 61 | PB8 | FTf | I2C1_SCL | PULL-UP
PLA_ON_LED | Low Active | RF ON 상태 LED | 62 | PB9 | FTf | GPIO_OUT | No-PULL

Sheet: CORE
 | OD | ID | Ht | AL | L[uH] | Z[Ohm] | Turn | Freq
FT140-43 | 35.55 | 23 | 12.7 | 885 | 20 | 1704 | 4.8 | 5~500MHz
FT82-43 | 21 | 13.2 | 6.35 | 470 | 20 | 1704 | 6.5 | 5~500MHz
T106-6 | 26.9 | 14.5 | 11.1 | 11.6 | 1 | 85.2 | 9.3 | 3MHz ~ 40MHz
T106-2 | 26.9 | 14.5 | 11.1 | 13.5 | 1 | 85.2 | 8.6 | 250KHz ~ 10MHz
T50-6 | 12.7 | 7.7 | 4.83 | 4 | 0.1 | 8.5 | 5 | 3MHz ~ 40MHz
T50-6 | 12.7 | 7.7 | 4.83 | 4 | 0.25 | 21.3 | 8 | 3MHz ~ 40MHz
air core coil
https://www.w6pql.com/1_8_to_54_mhz_combiner_set.htm

Sheet: DDS
DDS Vout calculation
 | Rset | 6.8 | KΩ
 | FSADJUST | 1.15 | V
 | Iout | 3.04 | mA
 | R17 | 0.2 | KΩ
 | Vout | 0.61 | Vpp
