ArvidJoung/Plasma_RF_Generator/1_Schematic/Build V2.0/03_RF-GEN-RF-001/RF-GEN_RF PL V3.0_20200330.xlsx

RF-GEN_RF_V2.0_SCH_20191209
 | No | USEINPARTSLIST | Type | Package | P_value | V_PN | Vendor | V_Desc | Q'ty | Reference No. | PCB Decal
 | 2 | YES | C-2012 | C-2012 | 150pF | CL21B151KB | SAMSUNG | CAP CER 150PF 50V X7R 0805 | 2 | C6,C34 | CHIP/CON/2012
 | 1 | YES | C-2012 | C-2012 | 330pF | CL21B331KB | SAMSUNG | CAP CER 330PF 50V X7R 0805 | 1 | C7 | CHIP/CON/2012
 | 3 | YES | C-2012 | C-2012 | 1000pF | CL21B102KB | SAMSUNG | CAP CER 1000PF 50V X7R 0805 | 2 | C10,C39 | CHIP/CON/2012
 | 4 | YES | C-2012 | C-2012 | 10nF | CL21B103KB | SAMSUNG | CAP CER 10000PF 50V X7R 0805 | 1 | C1 | CHIP/CON/2012
 | 5 | YES | C-2012 | C-2012 | 100nF | CL21B104MB | SAMSUNG | CAP CER 0.1UF 50V X7R 0805 | 3 | C2,C3,C4 | CHIP/CON/2012
 | 6 | YES | C-2012 | C-2012 | 2.2uF | CL21A225KB | SAMSUNG | CAP CER 2.2UF 50V X5R 0805 | 2 | C11,C40 | CHIP/CON/2012
 | 7 | YES | C-2012 | C-2012 | 1000pF/100V | C2012C0G2A102J060AA | TDK | CAP CER 1000pF 100V 5% C0G 0805 | 1 | C43 | CHIP/CON/2012
 | 8 | YES | C-2012 | C-2012 | 0.01uF/100V | C2012JB2E103M125AA | TDK | CAP CER 0.01uF 250V 20% JB 0805 | 1 | C22 | CHIP/CON/2012
 | 9 | YES | C-3216 | C-3216 | 2.2uF/100V | C3216X7S2A225M | TDK | CAP CER 2.2uF 100V 20% X7R 1206 | 2 | C21,C41 | 3216-C
 | 10 | YES | C-5750 | C-5750 | 0.01uF/450V | C5750C0G2W104K280KA | TDK | CAP CER 0.01uF 450V 10% C0G 5750 | 2 | C102,C103 | CHIP/CON/5750
 | 11 | YES | CAP/CHIP/D40 | SMD 4 PI | 10uF/16V-4PI | BDS16VC10MD55TP | SAMYOUNG | 16V, 10uF, 105deg 4Ø | 2 | C27,C35 | CAP/CHIP/D40
 | 12 | YES | CAP/CHIP/D80 | SMD 8 PI | 47uF/63V | BDS63VC47MH10TP | SAMYOUNG | 63V, 47uF, 105deg 8Ø | 2 | C17,C42 | CAP/CHIP/D80
 | 13 | YES | C-MICA_6PITCH | DIP | 150pF/500V | 150pF/500V | ETC | CAP MICA 150pF 500V | 2 | C24,C26 | C-MICA_6.5
 | 14 | YES | C-MICA_6PITCH | DIP | 180pF/500V | 180pF/500V | ETC | CAP MICA 180pF 500V | 4 | C23,C25,C32,C33 | C-MICA_6.5
 | 15 | YES | C-MICA_9PITCH | DIP | 3000pF/500V | 3000pF/500V | ETC | CAP MICA 3000pF 500V | 2 | C19,C20 | C-MICA_9PITCH
 | 16 | YES | R-2012 | R-2012 | 0 | RC2012J000 | SAMSUNG | RES SMD 0 OHM 5% 1/8W 0805 | 1 | R20 | CHIP/RES/2012
 | 18 | YES | R-2012 | R-2012 | 470 | RC2012F471 | SAMSUNG | RES SMD 470 OHM 1% 1/8W 0805 | 1 | R3 | CHIP/RES/2012
 | 19 | YES | R-2012 | R-2012 | 1K | RC2012F102 | SAMSUNG | RES SMD 1K OHM 1% 1/8W 0805 | 4 | R6,R7,R24,R27 | CHIP/RES/2012
 | 20 | YES | R-2012 | R-2012 | 2K | RC2012F202 | SAMSUNG | RES SMD 2K OHM 1% 1/8W 0805 | 2 | R1,R2 | CHIP/RES/2012
 | 21 | YES | R-2012 | R-2012 | 47K | RC2012F473 | SAMSUNG | RES SMD 47K OHM 1% 1/8W 0805 | 1 | R4 | CHIP/RES/2012
 | 23 | YES | L-2520 | L-2520 | 330nH | LQW2UASR33J | Murata | IND SMD 330nH 450mA 5% 2520 | 1 | L3 | LQW2UAS
 | 24 | YES | L-2520 | L-2520 | 820nH | LQW2UASR82J | Murata | IND SMD 820nH 400mA 5% 2520 | 2 | L11,L12 | LQW2UAS
 | 26 | YES | T106-6 | DIP 30 PI | 0.6uH / 30PI / 6T | 0.6uH / 30PI / 6T | ETC | T106-6 CORE 6Turn 0.6uH | 3 | L7,L8,L9 | L17D
 | 27 | YES | FT140-43 | DIP 30 PI | 20uH / 30PI | 20uH / 30PI | ETC | FT140-43 CORE 5Turn 20uH | 1 | L6 | L17D
 | 28 | YES | BD-3216 | 3216 | CB3216GA600 | CB3216GA600 | SAMWHA | BEAD 3216 60? +-25% | 1 | BD1 | L-3216
 | 29 | YES | MX35313-5P | MX35313-5P | MX35313-5P | MX35313-5P | MOLEX | 3.96mm, 5Pin, AC/DC 250V, 7A, Straight | 1 | CN300 | MOLEX-35313-5P_AC
 | 30 | YES | MX35313-2P | MX35313-2P | MX35313-2P | MX35313-2P | MOLEX | 3.96mm, 2Pin, AC/DC 250V, 7A, Straight | 1 | CN301 | MOLEX-35313-2P
 | 31 | YES | MX5267-3P | MX5267-3P | MX5267-3P | MX5267-3P | MOLEX | 2.50mm, 3Pin, AC/DC 250V, 3A, Straight | 1 | CN302 | MOLEX-5267-3P
 | 32 | YES | MX5267-2P | MX5267-2P | MX5267-2P | MX5267-2P | MOLEX | 2.50mm, 2Pin, AC/DC 250V, 3A, Straight | 1 | CN303 | MOLEX-5267-2P
 |  | YES | LL4148 | MELF | LL4148 | LL4148 | VISHAY | VRRM : 100V, VR : 75V, IF : 300mA | 2 | D1,D2 | LL4148
 | 33 | YES | SMA_CON | DIP SMA | SMA R/A | SMA R/A | ETC | SMA CON, Right Angle | 2 | J2,J3 | SMA/B_RA
 | 34 | YES | MRFE6VP6300HR3 | SMD | MRFE6VP6300H | MRFE6VP6300H | NXP | RF Power Field Effect Transistors | 1 | Q2 | MRFE6VP6300H
 | 35 | YES | RF-800 | TRANS | 1T:1T | RF-800 | ETC | TYPE43 2-30MHz 1:1 TRANSFORMER | 1 | TX1 | RF-800
 | 36 | YES | RF-1000 | TRANS | 1T:2T | RF-1000 | ETC | TYPE43 2-30MHz 1:2 TRANSFORMER | 1 | TX2 | RF-1000
 | 37 | YES | TL072_2_2 | SOIC-8 | KA358A | KA358ADTF | ON-SEMI | Dual OP amp - VCC : ±16V ~ 32V | 1 | U1 | IC/SO08-1
 | 38 | YES | EC2F-103A2-40113 |  | EC2F-103A2-40113 | EC2F-103A2-40113 | seMitec | THERMISTOR 10KΩ, 15mW | 1 | SEM1
 | 39 | YES | VR_RJ-13P | DIP | 5K | RJ-13P-5K | COPAL | 5K Trimming Potentiometer | 2 | VR2,VR3 | VR_RJ-13P-A
 | 40 | YES | YS95_95mm | SINK-YS95 | YS95_95mm | YS95_95mm | YESUNG | Heat Sink 95x95x26 | 1 | HS4 | YS95_95_4P
 | 41 | NO | C-5750 | C-5750 | NC | NC | TDK | CAP CER ?uF 250V 10% X7R 2220 | 3 | C104,C105,C106 | CHIP/CON/5750
 | 42 | NO | R-2012 | 10 | NC | NC | SAMSUNG |  | 2 | R21,R22 | CHIP/RES/2012
 | 22 | NO | DIP_2W | R-DIP2W | NC | NC | ETC | RES DIP 680 OHM 5% 2W Axial-R | 2 | R8,R9 | R-DIP2W_28PITCH
 | 43 | NO | PART_TP |  |  | Part_TP |  | Test Point | 8 | RFIF,RFIN,RFIN2,RFO,GND1,GND2,GND3,GND4
 | 44 | NO | HOLE_3.5 |  | M3-8mm | M3-8mm | Any | ME Screw Hole - 3.2mm | 6 | P1,P2,P3,P4,P5,P6 | HOLE_3.5
