ArvidJoung/Plasma_RF_Generator/1_Schematic/Build V2.0/02_RF-GEN-PWR-001/RF-GEN_PWR PL_V2.0_20200302.xlsx

RF-GEN_PWR_V1.0_SCH_20191128.sch
 | No | USEINPARTSLIST | Type | Package | P_value | V_PN | Vendor | V_Desc | Q'ty | Reference No. | Remark
 | 1 | YES | C-2012 | C-2012 | 100pF | CL21C101JB | SAMSUNG | CAP CER 100PF 50V C0G/NP0 0805 | 1 | C5
 | 2 | YES | C-2012 | C-2012 | 1nF | CL21B102KB | SAMSUNG | CAP CER 1000PF 50V X7R 0805 | 1 | C66
 | 3 | YES | C-2012 | C-2012 | 10nF | CL21B103KB | SAMSUNG | CAP CER 10000PF 50V X7R 0805 | 2 | C12,C20
 | 4 | YES | C-2012 | C-2012 | 100nF | CL21B104MB | SAMSUNG | CAP CER 0.1UF 50V X7R 0805 | 15 | C1,C3,C4,C7,C8,C11,C15,C19,C27,C28, C65,C67,C68,C69,C70
 | 5 | YES | C-2012 | C-2012 | 1uF | CL21A105KB | SAMSUNG | CAP CER 1UF 50V X5R 0805 | 1 | C18
 | 6 | YES | C-3216 | C-3216 | 100nF/100V | CL31B104KC | SAMSUNG | CAP CER 0.1UF 100V X7R 1206 | 2 | C9,C10
 | 7 | YES | C-3216 | C-3216 | 10uF/50V | CL31B106KB | SAMSUNG | CAP CER 10UF 50V X7R 1206 | 2 | C13,C14
 | 8 | YES | CAP/CHIP/D40 | SMD 4 PI | 10uF/16V-4PI | BDS16VC10MD55TP | SAMYOUNG | 16V, 10uF, 105℃, 4Ø | 1 | C17
 | 9 | YES | CAP/CHIP/D80 | SMD 8 PI | 220uF/35V | KMG220uF35V8PI | SAMYOUNG | 35V, 220uF, 105℃, 8Ø | 4 | C2,C6,C29,C30
 | 10 | YES | CAP_NP_4 | DIP | 105/100V/FILM | MMY-5-105J-100 | YUCHANG | 100V, 1uF, 5%, 5mm Pitch | 3 | C73,C74,C75
 | 11 | YES | CAPACITOR_POL_8PI | DIP | 220uF/35V/8PI | KMG220uF35V8PI | SAMYOUNG | 35V, 220uF, 105℃, 8Ø | 3 | C23,C25,C26 | V1.0 미삽
 | 12 | YES | CAPACITOR_POL_10PI | DIP | 100uF/100V-10PI | KMG100uF100V10PI | SAMYOUNG | 100V, 100uF, 105℃, 10Ø | 5 | C24,C71,C72,C76,C77
 | 13 | YES | R-2012 | R-2012 | 100 | RC2012F101 | SAMSUNG | RES SMD 100 OHM 1% 1/8W 0805 | 1 | R5
 | 13 | YES | R-2012 | R-2012 | 470 | RC2012F471 | SAMSUNG | RES SMD 470 OHM 1% 1/8W 0805 | 1 | R85
 | 14 | YES | R-2012 | R-2012 | 680 | RC2012F681 | SAMSUNG | RES SMD 680 OHM 1% 1/8W 0805 | 2 | R4
 | 15 | YES | R-2012 | R-2012 | 1K | RC2012F102 | SAMSUNG | RES SMD 1K OHM 1% 1/8W 0805 | 1 | R3
 | 16 | YES | R-2012 | R-2012 | 1.1K | RC2012F112 | SAMSUNG | RES SMD 1.1K OHM 1% 1/8W 0805 | 1 | R10
 | 17 | YES | R-2012 | R-2012 | 1.5k | RC2012F152 | SAMSUNG | RES SMD 1.5K OHM 1% 1/8W 0805 | 1 | R95
 | 18 | YES | R-2012 | R-2012 | 2K | RC2012F202 | SAMSUNG | RES SMD 2K OHM 1% 1/8W 0805 | 2 | R13,R14
 | 19 | YES | R-2012 | R-2012 | 3K | RC2012F302 | SAMSUNG | RES SMD 3K OHM 1% 1/8W 0805 | 3 | R12,R93,R94
 | 20 | YES | R-2012 | R-2012 | 4.7K | RC2012F472 | SAMSUNG | RES SMD 4.7K OHM 1% 1/8W 0805 | 1 | R11
 | 21 | YES | R-2012 | R-2012 | 4.99K | RC2012F4991 | SAMSUNG | RES SMD 4.99K OHM 1% 1/8W 0805 | 2 | R90,R92
 | 22 | YES | R-2012 | R-2012 | 10K | RC2012F103 | SAMSUNG | RES SMD 10K OHM 1% 1/8W 0805 | 10 | R1,R2,R6,R7,R9,R15,R18,R86,R87,R96
 | 23 | YES | R-2012 | R-2012 | 20K | RC2012F203 | SAMSUNG | RES SMD 20K OHM 1% 1/8W 0805 | 1 | R88
 | 24 | YES | R-2012 | R-2012 | 24K | RC2012F243 | SAMSUNG | RES SMD 24K OHM 1% 1/8W 0805 | 2 | R89,R91
 | 25 | YES | R-3216 | R-3216 | 10 | RC3216F100 | SAMSUNG | RES SMD 10 OHM 1% 1/4W 1206 | 1 | R100
 | 26 | YES | R-3216 | R-3216 | 100 | RC3216F101 | SAMSUNG | RES SMD 100 OHM 1% 1/4W 1206 | 1 | R98
 | 27 | YES | R-3216 | R-3216 | 510 | RC3216F511 | SAMSUNG | RES SMD 510 OHM 1% 1/4W 1206 | 1 | R97
 | 28 | YES | R-3216 | R-3216 | 680 | RC3216J681 | SAMSUNG | RES SMD 680 OHM 5% 1/4W 1206 | 3 | R16,R17,R99
 | 29 | YES | R_1W | DIP | 4.7K/2W | MOR 2WJ 4.7K | 제일전자 | 4.7KΩ, 2W, AXIAL | 2 | R101,R102
 | 30 | YES | BD-3216 | 3216 | CB3216GA600 | CB3216GA600 | SAMWHA | BEAD 3216 60Ω +-25% | 1 | BD1
 | 31 | YES | INDUCTOR | SMD | 220uH | SLF7032T-221M1R4-2PF | TDK | 220uH, 100KHz, 0.053Ω, Imax: 1.4A | 2 | L1,L2
 | 32 | YES | INDUCTOR_3 | SMD | 220uH | LPF1280T-221M | ABCO | 220uH, 100KHz, 0.026Ω, Imax: 5.65A | 2 | L12,L13
 | 33 | YES | INDUCTOR_3 | SMD | 15uH | LPF1280T-150M | ABCO | 15uH, 100KHz, 0.026Ω, Imax: 5.65A | 1 | L3
 | 34 | YES | INDUCTOR | DIP | C21-A6(IRON) | 100uH | Any | 100uH, 34T, C21-A6 | 1 | L5
 | 35 | YES | LED-2012 | 2012 | RED_LED | BL-HUE35A | BRIGHT | SUPER RED(635nm), VF: 2.0V~ 2.6V, IF: 20mA | 3 | LED1,LED2,LED3
 | 36 | YES | B340A | SMA | B340A | B340A | VISHAY | VRRM : 40V, VRMS : 28V, IF : 3A | 1 | D1
 | 37 | YES | MBR20200 | TO-220 | MBR20200CT | MBR20200CT | ON-SEMI | Dual Schottky Diodes - IF : 20A, IFSM : 150A, VRRM : 200V, VF : 1.0V | 1 | D14
 | 38 | YES | MBR360 | SMC | ES3D | ES3D | VISHAY | UltraFast Diode - Vrm 200V, IF: 3A, VF: 0.9V | 2 | D2,D3
 | 39 | YES | SB5100 | DO-201AD | SB5100 | SB5100 | ST-MICRO | Schottky Diodes - IF : 5A, IFSM : 150A, VRRM : 100V, VF : 0.8V, IR : 500uA | 1 | D13
 | 40 | YES | PNP_2 | SOT-223 | NZT45H8 | NZT45H8 | ON-SEMI | PNP Power Amplifier - 60V, 8A | 1 | Q1
 | 41 | YES | MMBT2222 | SOT-23(STYLE6) | MMBT2222ALT1G | MMBT2222ALT1G | ON-SEMI | NPN TR - VCE : 40V VEB : 6V, IC : 600mA | 2 | Q2,Q7
 | 42 | YES | KTD1898 | SOT-89 | KTD1898 | KTD1898-Y-RTF/P | KEC | NPN TR - VCE : 80V VEB : 5V, IC : 1A | 2 | Q3,Q4
 | 43 | YES | PNP_0 | SOT-89 | KTA1661 | KTA1661-Y-RTF/P | KEC | PNP TR - VCE : -120V VEB : -5V, IC : -800mA | 1 | Q5
 | 44 | YES | IRF6215/TO_1 | TO-220 | IRF6218 | IRF6218 | INTERNATIONAL | P-ch, VDSS-150V, ID-27A, RDS-150mΩ | 1 | Q6
 | 45 | YES | 10104_0 | 7-LED TO-220 | LT1210CT7 | LT1210CT7 | LINEAR TEC. | 1.1A, 35MHz, Current Feedback Amplifier | 1 | U1
 | 46 | YES | TL072_2 | SOIC-8 | KA358A | KA358ADTF | ON-SEMI | Dual OP amp - VCC : ±16V ~ 32V | 2 | U16,U17
 | 47 | YES | IR4427 | SOIC-8 | IR4427S | IR4427S | INFINEON | Gate Driver - 2 Driver, VCC : 6V ~ 20V, IOUT : 2.3A | 1 | U18
 | 48 | YES | MCP4822_3 | HSOP8 | TPS5430 | TPS5430 | TI | Vin: 5.5V to 36V, Step-Down Converter | 1 | U2
 | 49 | YES | LM2576HV/TO_0 | TO-263 | LM2576HV-12 | LM2576HV-12(SMD) | TI | Regulator : 12V 3A | 1 | U3
 | 50 | YES | UA78L05C_3 | DPAK | KIA7809AF-RTF/P | KIA7809AF-RTF/P | KEC | BIPOLAR LINEAR INTEGRATED CIRCUIT - 9V, 1A | 1 | U4
 | 51 | YES | CT_HC-PT_0 | DIP | PP1S20-12 | PP1S20-12 | 한국센서 | 20A, 12V, 85℃ | 1 | CT1
 | 52 | YES | HEADER_10X2 | DIP | PIN_HEADER_10X2 | PIN_HEADER_10X2 | ETC | 2.54mm, 20Pin, AC 300V, 2A, Straight | 1 | HD1
 | 53 | YES | MX35313-5P | MX35313-5P | MX35313-5P | MX35313-5P | MOLEX | 3.96mm, 5Pin, AC/DC 250V, 7A, Straight | 1 | CN200
 | 54 | YES | MX35313-2P | MX35313-2P | MX35313-2P | MX35313-2P | MOLEX | 3.96mm, 2Pin, AC/DC 250V, 7A, Straight | 1 | CN201
 | 55 | YES | SMA_CON | SMA CON | SMA_CON | SMA-R S/T | Any | RF SMA CON, Straight | 1 | RFOUT1
 | 56 | YES | SINK-YS500 | SINK-YS500 | SINK-YS500 | YS500 | 예성 | Heat Sink 35x20x45mm w/ 수삽리드 2ea & M3 TAP(H=17mm) | 1 | HS2
 | 57 | YES | SINK-YS300 | SINK-YS300 | SINK-YS300 | YS300 | 예성 | Heat Sink 23x15x45mm w/ 수삽리드 2ea & M3 TAP(H=17mm) | 2 | HS1,HS3
 | 58 | YES | FUSE CLIP | DIP | 10A/250VAC | 576-FC51E | LITTELFUSE | 300V, FUSE CLIP | 1 | F1
 | 59 | YES | FUSE | Ass'y | 0218.015.MXP | 0218.015.MXP | LITTELFUSE | 250Vac, 15A, 5x20mm, Glass, Time-lag | 1
 | 63 | YES | HOLE_3.5 | Ass'y | M3-50mm | M3-50mm | Any | M3 Support 50mm | 6 | H1,H2,H3,H4,H5,H6 | 부품 없음
 | 60 | NO | C-2012 | C-2012 | NC |  | SAMSUNG |  | 1 | C16
 | 61 | NO | R-2012 | R-2012 | NC |  | SAMSUNG |  | 1 | R8
 | 62 | NO | PART_TP | TP |  | Part_TP |  | Test Point | 11 | RFIN,9V,12V,-12V,BUCK_PWM, GND1,GND2,GND3,GND4,OUT48V, IOUTB
