ArvidJoung/Plasma_RF_Generator/1_Schematic/Build V2.0/03_RF-GEN-RF-001/MICRO-WAVE_Change list V1.0_20200228.xlsx

Sheet: PCB 정보
MICRO-WAVE PCB Information
 | V1.0
 | No | PCB | Source | Layer | T | Size | 수량 | Build V3.0 |  | 발주
 | 1
 | 2
 | 3 | RF |  | 2L | 1.6T | 240 X 120 |  | MICRO-WAVE-RF-001_200301.DSN | MICRO-WAVE-RF-001_200301.pcb
 | 4

Sheet: Issue V001
MICRO-WAVE V001 Issue List
No | Date | PCB | Issue | Solution | 적용 Version

Sheet: CPU V001
MICRO-WAVE-CPU-001
No | Date | Sheet | Reference | Before | After | Description | Remark

Sheet: PWR V001
MICRO-WAVE-PWR-001
No | Date | Sheet | Reference | Before | After | Description | Remark

Sheet: RF V001
MICRO-WAVE-RF-001
No | Date | Sheet | Reference | Before | After | Description | Remark
1 | 2020-02-28 | 3 | R24,R25,R26,R27 | 100/5025 | 200/5025 | Load 25Ω기준으로 전체 0.96W 걸림 - 0.67W R-5025 4ea로 margin 확보
2 |  |  | R28,R29,R30,R31 | - | 200/5025
3 | 2020-03-01 | 1,3 | CN300,CN303,CN304 | MOLEX5267-2P | MOLEX5268-2P | CON - Right angle로 변경 : RF sheild
4 |  | 1 | CN301 | MOLEX-35313-5P | LAB-1143-5P
5 |  | 1 | CN302 | MOLEX5267-3P | MOLEX5268-3P
6
7
8
9
10
11
12
13
14
15
16
17
