ArvidJoung/Plasma_RF_Generator/1_Schematic/Build V2.0/01_RF-GEN-CPU-001/RF-GEN_CPU PL_V2.0_20200208.xlsx

RF-GEN_CPU_PL V2.0
 | Start version : RF-GEN_CPU PL_V1.0_20191117
 | No | USEINPARTSLIST | Type | Package | P_value | V_PN | Vendor | V_Desc | Q'ty | Reference No.
 | 1 | YES | C-2012 | C-2012 | 33pF | CL21C330JB | SAMSUNG | CAP CER 33PF 50V C0G/NP0 0805 | 1 | C35
 | 2 | YES | C-2012 | C-2012 | 100pF | CL21C101JB | SAMSUNG | CAP CER 100PF 50V C0G/NP0 0805 | 3 | C33,C51,C52
 | 3 | YES | C-2012 | C-2012 | 150pF | CL21B151KB | SAMSUNG | CAP CER 150PF 50V X7R 0805 | 1 | C31
 | 4 | YES | C-2012 | C-2012 | 180pF | CL21B181KB | SAMSUNG | CAP CER 180PF 50V X7R 0805 | 1 | C30
 | 5 | YES | C-2012 | C-2012 | 270pF | CL21B271KB | SAMSUNG | CAP CER 270PF 50V X7R 0805 | 2 | C36,C57
 | 6 | YES | C-2012 | C-2012 | 300pF | CL21B301KB | SAMSUNG | CAP CER 300PF 50V X7R 0805 | 1 | C32
 | 7 | YES | C-2012 | C-2012 | 330pF | CL21B331KB | SAMSUNG | CAP CER 330PF 50V X7R 0805 | 1 | C34
 | 8 | YES | C-2012 | C-2012 | 2.2nF | CL21B222KB | SAMSUNG | CAP CER 2200PF 50V X7R 0805 | 1 | C59
 | 9 | YES | C-2012 | C-2012 | 10nF | CL21B103KB | SAMSUNG | CAP CER 10000PF 50V X7R 0805 | 10 | C24,C38,C40,C42,C44,C46,C48,C50,C54,C55
 | 10 | YES | C-2012 | C-2012 | 47nF | CL21B473KB | SAMSUNG | CAP CER 0.047UF 50V X7R 0805 | 8 | C37,C39,C41,C43,C45,C47,C49,C62
 | 11 | YES | C-2012 | C-2012 | 100nF | CL21B104MB | SAMSUNG | CAP CER 0.1UF 50V X7R 0805 | 30 | C1,C2,C3,C4,C5,C6,C8,C9,C10,C11, C12,C13,C14,C15,C16,C17,C18,C19,C20,C22, C23,C25,C26,C27,C53,C58,C65,C66,C67,C68
 | 12 | YES | C-2012 | C-2012 | 220nF | CL21B224KB | SAMSUNG | CAP CER 0.22UF 50V X7R 0805 | 1 | C63
 | 13 | YES | C-2012 | C-2012 | 1uF | CL21A105KB | SAMSUNG | CAP CER 1UF 50V X5R 0805 | 1 | C21
 | 14 | YES | C-2012 | C-2012 | 2.2uF | CL21A225KB | SAMSUNG | CAP CER 2.2UF 50V X5R 0805 | 3 | C28,C29,C69
 | 15 | YES | C-2012 | C-2012 | 10uF | CL21B106KA | SAMSUNG | CAP CER 10UF 25V X7R 0805 | 1 | C7
 | 16 | YES | CAP_5PI | SMD 5 PI | 47uF/16V | MVG16VC47ME56TP | SAMYOUNG | 16V, 47uF, 85℃, 5Ø | 2 | C61,C64
 | 17 | YES | CAP_6.3PI | SMD 6.3 PI | 220uF/16V | BDS16VC220MF80TP | SAMYOUNG | 16V, 220uF, 105℃, 6.3Ø | 1 | C60
 | 18 | YES | CAP_8PI | SMD 8 PI | 220uF/35V | KMG220uF35V8PI | SAMYOUNG | 35V, 220uF, 105℃, 8Ø | 1 | C56
 | 19 | YES | TC-3216 | CASE A | 1uF/16V | TCSCS1C105MAAR | AVX | 16V, 1uF, 20%, CASE A | 9 | TC1,TC2,TC3,TC4,TC5,TC6,TC7,TC8,TC9
 | 20 | YES | R-2012 | R-2012 | 0 | RC2012F000 | SAMSUNG | RES SMD 0 OHM 1% 1/8W 0805 | 3 | R12,R22,R79
 | 21 | YES | R-2012 | R-2012 | 30 | RC2012F300 | SAMSUNG | RES SMD 30 OHM 1% 1/8W 0805 | 1 | R14
 | 22 | YES | R-2012 | R-2012 | 47 | RC2012F470 | SAMSUNG | RES SMD 47 OHM 1% 1/8W 0805 | 6 | R20,R54,R55,R56,R57,R58
 | 23 | YES | R-2012 | R-2012 | 100 | RC2012F101 | SAMSUNG | RES SMD 100 OHM 1% 1/8W 0805 | 1 | R76
 | 24 | YES | R-2012 | R-2012 | 200 | RC2012F201 | SAMSUNG | RES SMD 200 OHM 1% 1/8W 0805 | 3 | R15,R17,R73
 | 25 | YES | R-2012 | R-2012 | 470 | RC2012F471 | SAMSUNG | RES SMD 470 OHM 1% 1/8W 0805 | 5 | R3,R4,R5,R21,R75
 | 26 | YES | R-2012 | R-2012 | 1K | RC2012F102 | SAMSUNG | RES SMD 1K OHM 1% 1/8W 0805 | 4 | R63,R65,R72,R81
 | 27 | YES | R-2012 | R-2012 | 1.3K | RC2012F132 | SAMSUNG | RES SMD 1.3K OHM 1% 1/8W 0805 | 1 | R16
 | 28 | YES | R-2012 | R-2012 | 2K | RC2012F202 | SAMSUNG | RES SMD 2K OHM 1% 1/8W 0805 | 2 | R52,R60
 | 29 | YES | R-2012 | R-2012 | 2.61K | RC2012F2611 | SAMSUNG | RES 2.61K OHM 1% 1/8W 0805 | 2 | R18,R19
 | 30 | YES | R-2012 | R-2012 | 2.7K | RC2012F272 | SAMSUNG | RES SMD 2.7K OHM 1% 1/8W 0805 | 7 | R26,R30,R34,R38,R42,R46,R50
 | 31 | YES | R-2012 | R-2012 | 3K | RC2012F302 | SAMSUNG | RES SMD 3K OHM 1% 1/8W 0805 | 8 | R25,R29,R33,R37,R41,R45,R49,R71
 | 32 | YES | R-2012 | R-2012 | 4.7K | RC2012F472 | SAMSUNG | RES SMD 4.7K OHM 1% 1/8W 0805 | 23 | R2,R27,R28,R31,R32,R35,R36,R39,R40,R43, R44,R47,R48,R59,R61,R62,R64,R66,R68,R69, R85,R86,R87
 | 33 | YES | R-2012 | R-2012 | 6.8K | RC2012F682 | SAMSUNG | RES SMD 6.8K OHM 1% 1/8W 0805 | 1 | R13
 | 34 | YES | R-2012 | R-2012 | 10K | RC2012F103 | SAMSUNG | RES SMD 10K OHM 1% 1/8W 0805 | 9 | R1,R8,R10,R11,R53,R74,R80,R82,R84
 | 35 | YES | R-2012 | R-2012 | 12K | RC2012F123 | SAMSUNG | RES SMD 12K OHM 1% 1/8W 0805 | 1 | R70
 | 36 | YES | R-2012 | R-2012 | 20K | RC2012F203 | SAMSUNG | RES SMD 20K OHM 1% 1/8W 0805 | 2 | R51,R83
 | 37 | YES | R-5025 | R-5025 | 0.15 | RC5025FR15 | SAMSUNG | 0.15Ω, 2/3W, 1%, 200V | 1 | R67
 | 38 | YES | R-6432 | R-6432 | 0.5 | RCWE2512R500FKEA | Vishay | RES 0.5 OHM 1% 2W 2512 | 1 | R77
 | 39 | YES | L-2520 | L-2520 | 270nH | LQW2UASR27J00L | Murata | FIXED IND 270NH 500MA 910 MOHM | 1 | L1
 | 40 | YES | L-2520 | L-2520 | 390nH | LQW2UASR39J0CL | Murata | FIXED IND 390NH 470MA SMD | 1 | L2
 | 41 | YES | L-2520 | L-2520 | 470nH | LQW2UASR47J0CL | Murata | FIXED IND 470NH 470MA SMD | 1 | L3
 | 42 | YES | SC5845D | SMD 5845 | SC5845D-470K | SC5845D-470K | Any | 47uH, ±10% | 1 | L4
 | 43 | YES | BD-3216 | 3216 | CB3216GA600 | CB3216GA600 | SAMWHA | BEAD 3216 60? +-25% | 3 | BD1,BD2,BD3
 | 44 | YES | KDS226 | SOT-23 | KDS226 | KDS226-RTK/P | KEC | Ultra High Speed Switching Diode - Vrm : 85V, IF : 300mA, VF : max 1.2V | 9 | D1,D2,D3,D4,D5,D6,D7,D8,D9
 | 45 | YES | S1M | SMA | S1M | S1M | VISHAY | Passivated Rectifier Diode - Vrm 1000V, IF: 1A, VF: 1.1V | 2 | D10,D12
 | 46 | YES | DIODE_SCHOTTKY_0 | SMB | SS24 | SS24 | ON-SEMI | Schottky, VRRM-40V, IF-2A, VF-0.5V | 1 | D11
 | 47 | YES | LED-2012 | 2012 | GREEN_LED | BL-HGK35A-AV-TRB | BRIGHT | GREEN(525nm), VF: 2.8V~ 3.2V, IF: 30mA | 3 | LED1,LED2,LED5
 | 48 | YES | LED-2012 | 2012 | RED_LED | BL-HUE35A | BRIGHT | SUPER RED(635nm), VF: 2.0V~ 2.6V, IF: 20mA | 2 | LED3,LED4
 | 49 | YES | OSC-SMD3225 | OSC-SMD3225 | SG-310 SCN | 75MHz | EPSON | 75MHz, 3.3V, 3.2x2.5 | 1 | OSC1
 | 50 | YES | OSC-SMD7050 | 7050 | 8MHz | OSC 7050 3.3V 8MHZ | SUNNY | 8MHz, 3.3V, 5*7 | 1 | OSC2
 | 51 | YES | MMBT2222 | SOT-23(STYLE6) | MMBT2222ALT1G | MMBT2222ALT1G | ON-SEMI | NPN TR - VCE : 40V VEB : 6V, IC : 600mA | 1 | Q1
 | 52 | YES | KTD1898 | SOT-89 | KTD1898 | KTD1898-Y-RTF/P | KEC | NPN TR - VCE : 80V VEB : 5V, IC : 1A | 1 | Q2
 | 53 | YES | CSA20-141N | 2012 | CSA20-141N | CSA20-141N | MITSUBISHI | SURGE ABSORBER - Vs : 140V, IR : 100M? / DC 50V | 4 | SA1,SA2,SA3,SA4
 | 54 | YES | DIODE_TVS_BI-DIR | SOD-323 | SD05C | SD05C.TCT | SEMTECH | Contact-8KV, AIR-15KV, WV-5V, CV-14.5V, IPP-24A | 8 | TVS1,TVS2,TVS3,TVS4,TVS5,TVS6,TVS7,TVS8
 | 55 | YES | STM32F070RBT6 | LQFP-64 | STM32F070RBT6 | STM32F070RBT6 | STMicroelectronics | ARM Cortex-M0 Value line, 128 Kbytes Flash, 48 MHz CPU, | 1 | U1
 | 56 | YES | 74HCT2G08 | TSSOP8 | 74HCT2G08DP | 74HCT2G08DP | NXP | Dual 2-input AND Gate | 1 | U10
 | 57 | YES | 74HC07 | SOIC-14 | 74HC07 | 74HC07 | ST-MICRO | Open Drain HEX BUFFER (VCC : 4.5V, VIH : 3,15V, VIL:. :1.35V, VOL : 0.1V) | 1 | U11
 | 58 | YES | 74HCT244DW | SOIC-20 | 74HCT244 | 74HCT244DW | TI | Octal buffer/line driver; 3-state - Vcc : 4.5V, CL : 50pF | 1 | U12
 | 59 | YES | NCP3064 | SOIC-8 | NCP3064 | NCP3064BDR2G | ON-SEMI | Regulator, Step-Up/Down, 1.5A | 1 | U14
 | 60 | YES | LM1117-3.3V | SOT-223 | LM1117-3.3V | LM1117-3.3 | HTC | Regulator, 3.3V, 1A | 1 | U15
 | 61 | YES | AT24C02C | SOIC-8 | AT24C02C | AT24C02CM-SSHM | MICROCHIP/ATMEL | EEPROM : 256 X 8bit Memory Vrange : 1.7V~5.5V | 1 | U19
 | 62 | YES | KIA7025 | SOT-89 | KIA7025 | KIA7025AF-RTF/P | KEC | Voltage Detector 2.5V - VCC: -0.3 - 15V, Vol : 0.4V, Iccl : 300uA | 1 | U2
 | 63 | YES | AD9834 | TSSOP(RU-20) | AD9834CRUZ | AD9834 | Analog Devices | 20 mW, 2.3 V to 5.5 V, 75 MHz Complete DDS | 1 | U3
 | 64 | YES | AD8051 | SOIC-8 | AD8051 | AD8051ARZ | Analog Devices | Low Cost, High Speed Rail-to-Rail Amplifiers - 3V, 45mA | 1 | U4
 | 65 | YES | TL072_2_2 | SOIC-8 | KA358A | KA358ADTF | ON-SEMI | Dual OP amp - VCC : ±16V ~ 32V | 5 | U5,U6,U7,U8,U13
 | 66 | YES | MAX3232CSE | SOIC-16 | MAX3232CSE(SO16) | MAX3232CSE+T | MAXIM | RS232 Line Driver - 3.3V to 5.5V, ESD : 15KV | 1 | U9
 | 67 | YES | JUMPER | DIP | A2-2PA-2.54DSA | A2-2PA-2.54DSA | Hirose Electric | 2.54mm, 2Pin, AC 300V, 2A, Straight | 3 | JP1,JP2,JP3
 | 68 | YES | HEADER_10X2_2.54MM | DIP | HIF3H-20DA-2.54DSA | HIF3H-20DA-2.54DSA | Hirose Electric | 2.54mm, 20Pin, AC 300V, 2A, Straight | 1 | HD1
 | 69 | YES | YDW200-10P | DIP | YDW200-10P | YDW200-10 | Yeonho | 2.0mm, 10Pin, AC/DC 250V, 3A, Straight | 1 | JTAG1
 | 70 | YES | MX35313-2P | MX35313-2P | MX35313-2P | MX35313-2P | MOLEX | 3.96mm, 2Pin, AC/DC 250V, 7A, Straight | 1 | CN100
 | 71 | YES | MX35313-5P | MX35313-5P | MX35313-5P | MX35313-5P | MOLEX | 3.96mm, 5Pin, AC/DC 250V, 7A, Straight | 1 | CN101
 | 72 | YES | MX5267-3P | MOLEX5267-3P | MOLEX5267-3P | MOLEX5267-3P | MOLEX | 2.50mm, 3Pin, AC/DC 250V, 3A, Straight | 2 | CN102,CN105
 | 73 | YES | MX5267-2P | MOLEX5267-2P | MOLEX5267-2P | MOLEX5267-2P | MOLEX | 2.50mm, 2Pin, AC/DC 250V, 3A, Straight | 6 | CN103,CN104,CN106,CN107,FAN1,FAN2
 | 74 | YES | FAN_50x50 | FAN | AFB0512HHB | AFB0512HHB | DELTA | 12V 0.13A 6400rpm 50x50x15mm FAN Wire 200mm w/ MX5264-02 | 1
 | 75 | NO | R-2012 | R-2012 | NC |  | SAMSUNG |  | 6 | R6,R7,R9,R23,R24,R78
 | 76 | NO | TP |  | NC | NC |  | Test Point | 11 | FSEL,PSEL,SBIT1,VIN, IOUT_B1, IOUT_B2 GND1, GND2, GND3, GND4, GND5
 | 77 | NO | HOLE_3.5 |  | M3-8mm | M3-8mm | Any | ME Screw Hole - 3.2mm | 10 | H1,H2,H3,H4,H5,H6,H7,H8,H9,H10
