ArvidJoung/Plasma_RF_Generator/Plasma RF Review data_company.xlsx

Sheet: Sheet1
Spec
 | RF Freq |  | 13.56 | MHz |  |  |  |  | http://www.plasource.com/
 | Harmonic |  | 50 | dBc | max
 | Power |  | 300 | W | max
 |  | Load | 50 | Ω
 |  | Vout | 122.5 | Vrms
 |  |  | 346.5 | Vpp
 |  | Iout | 2.4 | A
 |  | Vdc | 48.0 | Vdc
 |  | Idc | 6.2 | A | 효율 100%
 | Reflect Power |  | 30 | W | max |  | Power | 1 | 100 | 300 | W
 |  |  |  |  |  |  |  | 0 | 20 | 24.8 | dB
 |  |  |  |  |  |  |  | 30 | 50 | 54.8 | dBm
 |  |  |  |  |  |  | Coupler | 30 | 30 | 30 | dB
 |  |  |  | 0.00 |  |  |  | 0 | 20 | 24.8 | dBm
 | Ref 장비 측정 결과 - Femto
 | P | Vpp | Vpp[V] | Vrms | I | R
 | 20 | 0.28 | 280 | 99.0 | 0.202 | 489.85202 | Frequency |  | 파장
 | 50 | 0.384 | 384 | 135.7 | 0.368 | 368.5286707 | 12.56 | MHz | 23.9 | m
 | 100 | 0.832 | 832 | 294.1 | 0.340 | 865.0186854 | 13.56 | MHz | 22.1 | m
 | 200 | 1.38 | 1380 | 487.8 | 0.410 | 1189.890545
 | 300 | 1.42 | 1420 | 502.0 | 0.598 | 839.9129363
SMPS
 | P | 600 | W
 | V | 48 | V
 | I | 12.5 | A

Sheet: Device
 |  |  |  |  |  |  |  |  | Ifm : max Forward Current
 | PN | Vendor | V | I | P |  |  |  | Vr : reverse Voltage
SMPS | PSP-600-48 | MEAN WELL | 48 | 12.5 | 600 | 185x120x93 |  |  | Vf : Forward Voltage drop
 | NET-35B | MEAN WELL | 5 | 3 | 15
 |  |  | 12 | 1 | 12
 | PN | Vendor | Vr[V] | Ifm[A] | Vf | Package | Size | T
 | 1N5711W | DIODE | 70 | 0.015 | 1 | SOD-123 | 1.7x3.85 | 1.35 | Schottky Barrier Diode
 | 1N4148 | VISHAY | 75 | 0.1 | 1.2 | SOD-123 | 1.7x3.85 | 1.35 | Fast Switching Diode
 | KDS226 | KEC | 80 | 0.3 | 0.9 | SOT-23

Sheet: ADC
ADC Path review
 | 48V Vin ADC Review
 |  |  | VDC_IN_AD | Unit
 | POWER | Vdc | 48 | V
 |  | R1 | 20 | KΩ
 |  | R2 | 4.99 | KΩ
 |  | VDC_IN_AD | 9.58 | V
 | MCU | R1 | 4.7 | KΩ
 |  | R2 | 4.7 | KΩ
 |  | VIN | 4.79 | V
 |  | R3 | 2.4 | KΩ
 |  | R4 | 3.3 | KΩ
 |  | VDC_IN_AD | 2.77 | V

Sheet: Current Sensor
Current Sensor Review
ZXCT1110 | I_max | 12.5 | 10 | 1 | A | SMPS Max Current
 | Rsens1 | 0.01 | 0.01 | 0.01 | Ω
 | Rsens2 | 0.01 | 0.01 | 0.01 | Ω
 | Prsens | 0.391 | 0.250 | 0.003 | W
 | Vsens | 0.062 | 0.050 | 0.005 | V | Max 500mV
 | Iout | 0.250 | 0.200 | 0.020 | mA | Max 2mA
 | Rgain | 8.25 | 8.25 | 8.25 | kΩ
 | Vout | 2.062 | 1.650 | 0.165 | V | PWR_IS_AD
 | R13 | 50 | 50 | 50 | kΩ
 | R19 | 10 | 10 | 10 | kΩ
 | Vout | 12.375 | 9.9 | 0.99 | V
 | R14 | 2.2 | 2.2 | 2.2 | kΩ
 | R17 | 3.3 | 3.3 | 3.3 | kΩ
 | V_ADC | 7.425 | 5.94 | 0.594 | V
 |  | POWER PCB |  |  |  |  | MCU PCB
 |  | Rsens1 | 0.01 | Ω
 |  | Rsens2 | 0.01 | Ω | R13 | 47 | R14 | 3.6 | R14 | 2.2 | kΩ
 |  | Rgain | 8.25 | kΩ | R19 | 10 | R17 | 3.3 | R17 | 3.3 | kΩ
 |  | I_max | Vsens | Iout | Vout | Vopamp |  | V_ADC | V_ADC | ADC
 |  | 12.5 | 0.062 | 0.250 | 2.062 | 11.76 |  | 5.62 | 3.37 | 260.6820652
 |  | 12.0 | 0.060 | 0.240 | 1.980 | 11.29 |  | 5.40 | 3.24 | 250.2547826
 |  | 11.5 | 0.057 | 0.230 | 1.897 | 10.82 |  | 5.17 | 3.10 | 239.8275
 |  | 11.0 | 0.055 | 0.220 | 1.815 | 10.35 |  | 4.95 | 2.97 | 229.4002174
 |  | 10.5 | 0.052 | 0.210 | 1.733 | 9.88 |  | 4.72 | 2.83 | 218.9729348
 |  | 10.0 | 0.050 | 0.200 | 1.650 | 9.41 |  | 4.50 | 2.70 | 208.5456522
 |  | 9.5 | 0.048 | 0.190 | 1.568 | 8.93 |  | 4.27 | 2.56 | 198.1183696
 |  | 9.0 | 0.045 | 0.180 | 1.485 | 8.46 |  | 4.05 | 2.43 | 187.691087
 |  | 8.5 | 0.043 | 0.170 | 1.403 | 7.99 |  | 3.82 | 2.29 | 177.2638043
 |  | 8.0 | 0.040 | 0.160 | 1.320 | 7.52 |  | 3.60 | 2.16 | 166.8365217
 |  | 7.5 | 0.037 | 0.150 | 1.238 | 7.05 |  | 3.37 | 2.02 | 156.4092391
 |  | 7.0 | 0.035 | 0.140 | 1.155 | 6.58 |  | 3.15 | 1.89 | 145.9819565
 |  | 6.5 | 0.033 | 0.130 | 1.073 | 6.11 |  | 2.92 | 1.75 | 135.5546739
 |  | 6.0 | 0.030 | 0.120 | 0.990 | 5.64 |  | 2.70 | 1.62 | 125.1273913
 |  | 5.5 | 0.028 | 0.110 | 0.907 | 5.17 |  | 2.47 | 1.48 | 114.7001087
 |  | 5.0 | 0.025 | 0.100 | 0.825 | 4.70 |  | 2.25 | 1.35 | 104.2728261
 |  | 4.5 | 0.022 | 0.090 | 0.742 | 4.23 |  | 2.02 | 1.21 | 93.84554348
 |  | 4.0 | 0.020 | 0.080 | 0.660 | 3.76 |  | 1.80 | 1.08 | 83.41826087
 |  | 3.5 | 0.018 | 0.070 | 0.578 | 3.29 |  | 1.57 | 0.94 | 72.99097826
 |  | 3.0 | 0.015 | 0.060 | 0.495 | 2.82 |  | 1.35 | 0.81 | 62.56369565
 |  | 2.5 | 0.013 | 0.050 | 0.413 | 2.35 |  | 1.12 | 0.67 | 52.13641304

Sheet: CT
Vmax | 12 | 24 | V
R | 820 | 820 | Ω
I | 0.01463414634 | 0.02926829268 | A
P | 0.1756097561 | 0.7024390244 | W

Sheet: Check list
No | Status | Description
1 | OPEN | FW_CT_AD path에 RC filter 추가
2 | OPEN | ADC Path를 12V로 설계하고, MCU에서 3.3V로 Dividing하여 사용
3 | OPEN | CT1의 Pin-3의 Resonator의 Freq 결정 - serial 공진인지, shunt 공진인지 특성 확인 필요
 | OPEN | VR를 원형 눈금 타입으로 변경

Sheet: Pre-Amp
 | Bias |  |  |  |  |  | MRF1513NT1
 |  | Vcc | 12 | 12 |  |  |  |  | Pout | 3 | W
 |  | VR1 | 2.3 | 1.57 |  |  |  |  | Gain | 15 | dB
 |  | R2 | 1 | 1 |  |  |  |  | Vout | 12.5 | V | 3.125
 |  | R1 | 1 | 1
 |  | V_gate | 2.79 | 3.36 |  | 2.623
 |  | Icc[mA] | 2.79 | 3.36
RL=50 : TX1 1차에서 50저항 처리 |  |  |  |  |  |  |  |  | RF_in |  |  | RF_out |  |  | Gain
VR1[눈금] | VR1[KΩ] | R2[KΩ] | R1[KΩ] | C100 | R23[KΩ] | L2[uH] | Icc | Pcc | Vpp | Vrms | Vrms_cal | Vpp | Vrms | Vrms_cal | [V/V] | dB | Pout
4 |  | 1 | 1 | NC | 1 | 0.8 | 0.42 | 5.04 | 0.720 |  | 0.25 | 25.0 |  | 8.84 | 34.7 | 30.8
 |  |  |  |  |  | 100 | 0.46 | 5.52 | 0.528 | 0.174 | 0.19 | 22.4 | 7.760 | 7.92 | 42.4 | 32.6 | 1.20
 |  |  |  |  |  | 0.64 | 0.49 | 5.88 | 0.848 | 0.277 | 0.30 | 25.200 | 8.920 | 8.91 | 29.7 | 29.5 | 1.59
 |  |  |  |  |  |  | 0.4 | 4.8 | 0.840 | 0.279 | 0.30 | 21.400 | 7.540 | 7.56 | 25.5 | 28.1 | 1.14
 |  |  |  | 10n |  |  | 0.35 | 4.2 | 0.288 | 0.136 | 0.102 | 6.600 | 2.180 | 2.33 | 22.9 | 27.2 | 0.10
 |  |  |  | 1n |  |  | 0.33 | 3.96 | 0.272 | 0.119 | 0.096 | 6.600 | 2.250 | 2.333 | 24.3 | 27.7 | 0.10
 |  |  |  | 1n |  |  | 0.23 | 2.76 | 0.368 | 0.124 | 0.130 | 5.000 | 1.700 | 1.767 | 13.6 | 22.7 | 0.06
5 | 1.16 | 1 | 1 | NC | 1 | 0.64 | 0.3 | 3.6 | 0.816 | 0.270 | 0.288 | 17.200 | 6.070 | 6.08 | 21.1 | 26.5 | 0.74

Sheet: Path review
 |  |  | Fc | C
 |  |  | 13.56 | 10000 | 1.174304342
 |  |  |  |  |  |  |  |  |  |  |  |  |  |  |  | 680 | 820 | 6.743400809
 |  |  | L1[nH] | C3[pF] | fo[MHz] |  |  |  |  |  |  |  |  |  |  | 680 | 680 | 7.405108796
 |  |  | 470 | 300 | 13.41006244 |  |  |  |  |  |  |  | 820 |  |  | 680 | 560 | 8.160032461
 |  |  | 220 | 300 | 19.60055589 |  |  |  |  | 100 |  |  | 680 |  |  | 680 | 470 | 8.907113183
 |  |  |  |  |  |  |  |  |  | 120 |  |  | 560 |  |  | 680 | 390 | 9.778080231
 |  |  |  |  |  |  |  |  |  | 150 |  |  | 470 |  |  | 680 | 330 | 10.62989391
 |  |  |  |  |  |  |  |  |  | 180 |  |  | 390 |  |  | 680 | 300 | 11.14872678
 |  |  |  |  |  |  |  |  |  | 220 |  |  | 330 |  |  | 680 | 270 | 11.75178988
 |  |  |  |  |  |  |  |  |  | 330 |  |  | 300 |  |  | 680 | 240 | 12.46465548
 |  |  |  |  |  |  |  |  |  | 390 |  |  | 270 |  |  | 680 | 220 | 13.01890804 |  |  | 12 | V
 |  |  | 820 | 150 | 14.35779673 |  |  |  |  | 470 |  |  | 240 |  |  | 680 | 200 | 13.65434595 |  |  | 3 | W
 |  |  |  |  |  |  |  |  |  | 680 |  |  | 220 |  |  |  |  |  |  |  | 0.25 | A
 |  |  | 51 | 240 | 45.5144865
 |  |  | 510 | 2700 | 4.29114694
 |  |  |  |  |  |  |  |  |  |  |  |  |  |  |  |  |  |  |  |  | 3.3
 |  |  |  |  |  |  |  |  |  |  |  |  |  |  |  |  |  |  |  |  | 1.27
 |  |  |  |  |  |  |  |  |  |  |  |  |  |  |  |  |  |  |  |  | 2.03
 |  |  |  |  |  |  |  |  |  |  |  |  |  |  |  |  |  |  |  |  | 1.015
 |  |  |  |  |  |  |  |  |  |  |  |  |  |  |  |  |  |  |  |  | 1.27
 |  |  |  |  |  |  |  |  |  |  |  |  |  |  |  |  |  |  |  |  | 0.635
 |  | VR1[눈금] | VR1[KΩ] | R2[KΩ] | R1[KΩ] | C100 | R23[KΩ] | L2[uH]
 |  | 5 | 1.16 | 1 | 1 | NC | 1 | 0.64
RL=50 : TX1 1차에서 50저항 처리 |  |  |  |  |  |  |  |  |  |  | RF_in |  |  | RF_out |  |  | Gain
L2[uH] | C3[pF] | L1[nH] | C6[pF] | L11[nH] | C7[pF] | L3[nH] | C34[pF] | L12[nH] | Icc | Pcc | Vpp | Vrms | Vrms_cal | Vpp | Vrms | Vrms_cal | [V/V] | dB | Pout
0.64 | 300 | 220 | 1000 | 0 | NC | NC | 1000 | 0 | 0.3 | 3.6 | 0.816 | 0.270 | 0.288 | 17.200 | 6.070 | 6.08 | 21.1 | 26.5 | 0.74
0.64 | 300 | 470 | 150 | 820 | 330 | 330 | 150 | 820 | 0.34 | 4.08 | 0.736 | 0.247 | 0.260 | 13.4 | 4.59 | 4.74 | 18.2 | 25.2 | 0.42
0.8 |  |  |  |  |  |  |  |  | 0.31 |  | 0.712 | 0.238 |  | 13.2 | 4.44 |  |  |  |  | RF_IN의 +Vpp가 saturation됨
0.48 |  |  |  |  |  |  |  |  | 0.32 |  | 0.8 | 0.271 |  | 13.2 | 4.57 |  |  |  |  | RF_IN의 +Vpp가 개선

Sheet: Sheet2
VR1 눈금 | 5 | 6
VR1 | 2.5 | 3
R2 | 1 | 1
R3 | 1 | 1
Vbias | 2.7 | 2.4
Vbias | 2.712 | 2.33 |  |  |  |  |  | 정상
Icc | 0.18 | 0.04 |  |  |  |  |  | chip | board | 불량
Vin | 0.504 | 0.472 |  |  |  |  | Vgs | Open | 0.467 | 0
Vout | 6.32 | 2.04 |  |  |  |  | Vsd | 0.58V | 0.549 | 0.58V
65도 | FAIL |  |  |  |  |  | Vgd | Open | 0.826 | 0.623
 |  |  |  |  |  | TX1_in |  |  | Gate_in |  |  | RF_out |  |  |  |  | 48VDC
VR1[눈금] | C100 | L2[uH] | TX1 | Icc | Pcc | Vpp | Vrms | Vrms_cal | Vpp | Vrms | Vrms_cal | Vpp | Vrms | Vrms_cal | P | Gain | Idc | P
6 | 10n | 0.64 | 1T:2T | 0.01 | 0.12 | 0.640 | 0.203 | 0.23 | 0.7 | 0.240 | 0.25 | 28.4 | 9.9 | 10.0 | 2.0 | 31.9 | 0.6 | 28.8
5 | 10n |  |  | 0.07 | 0.84 | 1.500 | 0.505 | 0.53 | 1.7 | 0.587 | 0.62 | 95.2 | 33.6 | 33.7 | 22.6 | 34.8 | 2.7 | 129.6
4 | 10n |  |  | 0.45 | 5.4 |  |  | 0.00 |  |  | 0.00 |  |  | 0.0 | 0.0 |  |  | 0
5 | NC |  |  |  | 0 | 4.120 | 1.420 | 1.46 | 4.880 | 1.700 | 1.73 | 370.0 | 130.0 | 130.8 | 338.0 | 37.6 |  | 0 | OCP
5 | NC |  | 1T:3T |  | 0 | 1.760 | 0.573 | 0.62 | 3.240 | 1.120 | 1.15 | 88.0 | 29.6 | 31.1 | 17.5 | 28.7 | 1.7 | 81.6
 |  |  |  |  | 0 |  |  | 0.00 |  |  | 0.00 |  |  | 0.0 | 0.0 | #DIV/0! |  | 0
 |  |  |  |  | 0 |  |  | 0.00 |  |  | 0.00 |  |  | 0.0 | 0.0 | #DIV/0! |  | 0
 |  |  |  |  | 0 |  |  | 0.00 |  |  | 0.00 |  |  | 0.0 | 0.0 | #DIV/0! |  | 0
Q2 12V bias Off 상태에서 측정
 |  |  |  |  |  |  |  |  | Q1_in |  |  | Q1_out |  |  | Gain
VR1[눈금] | R2[KΩ] | R1[KΩ] | C100 | R23[KΩ] | L2[uH] | TX1 | Icc | Pcc | Vpp | Vrms | Vrms_cal | Vpp | Vrms | Vrms_cal | [V/V] | dB | Pout
0,1,2 | 1 | 1 | NC | 1 | 0.64 | 1T:2T | 0.19 |  | 0.450 | 0.150 | 0.16 | 0.0 | 0.000 | 0.00 | 0.0 | #NUM!
3 |  |  |  |  |  |  |  |  | 0.450 | 0.150 | 0.16 | 0.2 | 0.057 | 0.06 | 0.4 | -8.5 | 6.498e-05
4 |  |  |  |  |  |  | 0.22 |  | 0.450 | 0.150 | 0.16 | 1.030 | 0.366 | 0.36 | 2.3 | 7.2 | 0.00267912
5 |  |  |  |  |  |  | 0.3 |  | 0.450 | 0.150 | 0.16 | 3.240 | 1.130 | 1.15 | 7.2 | 17.1 | 0.03
5 |  |  | 10n |  |  |  | 0.27 |  | 0.300 | 0.095 | 0.106 | 1.380 | 0.480 | 0.49 | 4.6 | 13.3 | 0.004608
5 |  |  | 10n |  | 1.2 |  | 0.26 |  | 0.300 |  | 0.106 | 1.380 |  | 0.488 | 4.6 | 13.3 | 0.00
5 |  |  | 10n |  | 1.2 | 1T:3T | 0.27 |  | 0.300 |  | 0.106 | 0.780 | 0.260 | 0.276 | 2.6 | 8.3 | 0.001352
4 | 1 | 1 | 10n | 1 | 1.2 | 1T:3T | 0.22 |  | 0.364 | 0.123 | 0.129 | 0.488 | 0.154 | 0.17 | 1.3 | 2.5 | 0.00047432
VR1 Voltage
2.372
VR1 |  |  |  |  |  | VR2,3 |  | TX1_in |  |  | Gate_in |  |  | RF_out |  |  |  |  | 48VDC
눈금 | V | C100 | L2[uH] | TX1 | Icc | 눈금 | V | Vpp | Vrms | Vrms_cal | Vpp | Vrms | Vrms_cal | Vpp | Vrms | Vrms_cal | P | Gain | Idc | P
4.5 | 2.372 | 10n | 1.2 | 1T:3T | 0.23 | 5 | 2.47 | 0.480 | 0.170 | 0.17 | 0.9 | 0.300 | 0.31 | Q2 12V bias 및 48V Off 상태에서 측정
 |  |  |  |  | 0.36 | 5 | 2.47 | 2.920 | 0.865 | 1.03 | 6.3 | 1.850 | 2.23 | 426.0 | 142.0 | 150.6 | 403.3 | 36.6 | 4 | 192
 |  |  |  |  | 0.36 | 4 | 2.295 |  |  |  |  |  |  |  |  |  |  |  | 3.9 | 187.2
4 | 2.3 |  |  |  | 0.36 | 5 |  | 3.26 | 1.07 | 1.15 | 6.88 | 2.21 | 2.43 | 416 | 143 | 147.1 | 409.0 | 35.6
4 | 2.322 |  |  |  | 0.36 | 4 | 2.27 | 3.38 | 1.12 | 1.19 | 6.92 | 2.21 | 2.45 | 374 | 129 | 132.2 | 332.8 | 34.7 | 3.9 | 187.2
TX2가 75도 이상 상승하며, Idc가 증가함.
 |  |  |  |  |  |  |  |  |  |  |  |  |  | 360 | 117 | 127.3 | 273.8

Sheet: 0601
2019-06-01
 |  |  |  | Q2 Bias off, TX1 Open
 | VR1 | Q1 | TX1 | SG | RF CON |  | TX1 Pin-5 |  |  | Q2 Bias | T1_OUT+/- |  | VR2/3
 | 눈금 | Vgate |  | Vpp | Vpp | Vrms | Vpp | Vrms | Icc |  | Vpp | Vrms | 눈금 | Vgate
 | 6 | 2.313 | NC | 0.6 | 0.43 | 0.141 | 2.66 | 0.91 | 0.01 | OFF | - | - | - | -
 | 6 | 2.313 | 1T:1T | 0.6 | 0.4 | 0.131 | 1.66 | 0.575 | 0.01 | OFF | - | - | - | -
 | 6 | 2.313 | 1T:1T | 0.6 | 0.4 | 0.131 | 1.9 | 0.656 | 0.02 | ON | 0.98 | 0.321 | 0 | 1.631
 | 5 | 2.549 |  |  | 0.27 | 0.085 | 3.7 | 1.26 | 0.1 | OFF | 1.86 | 0.631
 | TX1을 1T:1T로 했을때, Q1이 잘 죽는다. - Q2 ON상태에서 Q1의 전압 및 전류가 상승하는데, 이때 Q1 bias에 민감해 진다.

Sheet: Bias_0602
R2 | 1 |  | 1
R3 | 1 |  | 1
VR1
 | 계산치 |  |  |  | 측정치
눈금 | R_VR | V_Q1_gate | R_VR | V_Q1_gate | Vdc | Idc | TX1 1차 | TX1 2차
0 | 0.0 | 6.0 | 0.000 | 6.0
1 | 0.5 | 4.8 | 0.270 | 5.3 |  |  |  |  |  | 48
2 | 1.0 | 4.0 | 0.876 | 4.2 |  |  |  |  |  | 50
3 | 1.5 | 3.4 | 1.412 | 3.5 |  |  |  |  |  | 0.96
4 | 2.0 | 3.0 | 1.958 | 3.0 | 2.7 | 0.27 | 1.13 | 2.1 |  | 46.08
5 | 2.5 | 2.7 | 2.742 | 2.5 | 2.5 | 0.60 | 0.76 | 1.5
6 | 3.0 | 2.4 | 3.473 | 2.2 | 2.3 | 0.01 | 0.21 | 0.5
7 | 3.5 | 2.2 | 4.000 | 2.0 | 2.1 | 0 | 0.04 | 0
8 | 4.0 | 2.0 | 4.536 | 1.8 | 1.9 | 0 | 0 | 0
9 | 4.5 | 1.8 | 5.135 | 1.7 | 1.8 | 0 | 0 | 0
10 | 5.0 | 1.7 | 5.325 | 1.6 | 1.7 | 0 | 0 | 0
R6 | 1
R7 | 1
VR2/3
 | 계산치 |  | V_Q2_gate
눈금 | R_VR | V_Q2_gate | VR3 | VR2
0 | 0.0 | 6.0 | 6.017 | 5.997
1 | 0.5 | 4.8 | 5.21 | 5.327 |  |  | 48 | 48 | 48
2 | 1.0 | 4.0 | 4.004 | 4.222 |  |  | 67.5 | 10 | 5
3 | 1.5 | 3.4 | 3.341 | 3.508 |  |  | 0.7111111111 | 4.8 | 9.6
4 | 2.0 | 3.0 | 2.88 | 2.959 |  |  | 34.13333333 | 230.4 | 460.8
5 | 2.5 | 2.7 | 2.49 | 2.482
6 | 3.0 | 2.4 | 2.159 | 2.277
7 | 3.5 | 2.2 | 1.996 | 2.03 |  |  |  | 48
8 | 4.0 | 2.0 | 1.828 | 1.796 |  |  |  | 43
9 | 4.5 | 1.8 | 1.653 | 1.654 |  |  |  | 5
10 | 5.0 | 1.7 | 1.647 | 1.659 |  |  |  | 2.7
 |  |  |  |  |  |  |  | 1.851851852

Sheet: Debugging
Date
 | Q1의 Gain이 0.3정도밖에 안나옴 | R4가 18.2가 아니라 18.2K가 실장되어 있었음

Sheet: FILTER
Filter matching value - reference PCB의 Data와 비슷함.
