ArvidJoung/Plasma_RF_Generator/1_Schematic/Build V2.0/RF-GEN-Test Date_20200207.xlsx

Sheet: RF
CPU AD8051
 |  |  |  |  |  |  |  |  |  | Vout1 |  | IOUTB
 |  | SIG | IOUT_B1 | R21 | R20 | Gain | R22 | R23 | R24 | cal | meas | cal | meas | P
 | Calcul |  | 0.6 | 470 | 47 | 11 | 51 | NC | 51 | 6.6 |  | 3.3 |  | 0.21
 |  | 0.6 | 0.4 | 470 | 47 | 11 | 51 | 51 | 51 | 4.4 |  | 0.7 |  | 0.01
 |  | 0.6 | 0.4 | 470 | 47 | 11 | 51 | NC | 51 | 4.4 | 2.1 | 1.05 | 0.88 | 0.02
 |  | 0.9 | 0.58 | 470 | 47 | 11 | 51 | NC | 51 | 6.4 | 2.9 | 1.45 | 1.2 | 0.03
 |  | 0.9 | 0.58 | 1000 | 47 | 22.3 | Gain이 안올라감 |  |  | 12.9 | 2.8
 |  | 0.9 | 0.58 | 200 | 47 | 5.3 | 51 | NC | 51 | 3.0 | 2.4 | 1.2 | 1.04 | 0.02
 |  | 0.9 | 0.58 | 200 | 47 | 5.3 | 51 | NC | NC | 3.0 | 2.64
 |  | 0.9 | 0.58 | 200 | 47 | 5.3 | 0 | NC | 51 | 3.0 | 2.8 | 2.8 | 3 | 0.18 |  | 6 | 50 | 0.72
 |  | 0.9 | 0.58 | 270 | 47 | 6.7 | 0 | NC | 51 | 3.9 | 3.04 | 3.04 | 3.32 | 0.22 |  | 3 | 50 | 0.18 | 0.25
 | Tune2/8 | 0.9 | 0.58 | 470 | 47 | 11.0 | 0 | NC | 51 | 6.4 | 3.3 | 3.3 | 3.6 | 0.25
 |  | 0.9 | 0.58 | 470 | 47 | 11.0 | 0 | NC | NC | 6.4 | 3.32 |  | 3.64 |  | R24 NC 상태에서도 동일함
 | PWR tune후 연결하여 Test할때 R24 NC 처리 여부 결정
PWR LT1210CT7
 |  |  |  |  |  |  |  |  |  |  |  | RFIN
 | CPU | R24 | C8/C11 | R6 | C5 | R4 | R5 | Gain | C9/C10 | 종단 | IOUTB | cal | meas | P | Iout
 | Tune2/8 | 51 | 100nF | 10K | 100pF | 680 | 680 | 2.0 | 100nF | 무부하 | 2.2 | 4.4 | 4.4
 |  | NC | 100nF | 10K | 100pF | 680 | 680 | 2.0 | 100nF | 무부하 | 3.3 | 6.6 | 7.4
 |  | NC | 100nF | 10K | 100pF | 680 | 680 | 2.0 | 100nF | 51 | 3.36 | 6.72 | 7.68 | 1.16 | 0.1505882353

Sheet: Bias
VIN | VR | R6 | R7 | R25 | Vbias | Ibias
9 | 5 | 1 | 1 | 0.05 | 1.285714286
9 | 0 | 1 | 1 | 0.05 | 4.5
9 | 0 | 0.5 | 1 | 0.05 | 6
9 | 1 | 0 | 1 | 0.05 | 4.5
9 | 3 | 0 | 1 | 0.05 | 2.25

Sheet: 0215
 |  | CPU |  |  |  |  |  |  |  |  | POWER |  |  |  |  |  |  |  |  |  |  |  |  | RF
 |  |  |  |  |  |  |  |  | IOUTB |  |  |  |  |  |  |  |  |  |  | RFIN |  |  |  |  |  |  | buck |  |  | RFO
 | SIG | IOUT_B1 | R21 | R20 | Gain | R22 | R23 | R24 | cal | meas | C8/C11 | IOUTB | R6 | C5 | R4 | R5 | Gain | C9/C10 | 종단 | cal | meas | P | Iout | T1_OUT+ | T1_OUT- | Vbias | duty | Vcc | Icc | Load | Vpp | Vrms | P
#05 | 0.8 | 0.512 | 470 | 47 | 11 | 0 | NC | NC | 5.632 | 3.24 | 100nF | 3.36 | 10K | 100pF | 680 | 680 | 2.0 | 100nF | 51 | 6.72 | 6.25 | 0.77 | 0.12 | 2.96 | 2.92 | 4
 | 0.8 | 0.512 | 470 | 47 | 11 | 0 | NC | NC | 5.632 | 2.76 | 100nF | 2.76 | 10K | 100pF | 680 | 360 | 2.9 | 100nF | 51 | 7.973333333 | 7.68 | 1.16 | 0.15 | 3.84 | 3.72 | 4
 | 0.6 |  |  |  |  |  |  |  |  | 2.24 |  |  |  |  |  |  |  |  | NC |  | 5.76 |  |  |  |  | 2.5 | 50 | 23.36 | 0.9 | 50 | 74.4 | 25.4 | 12.9
 |  |  |  |  |  |  |  |  |  |  |  |  |  |  |  |  |  |  |  |  |  |  |  |  |  | 3 |  |  | 0.9 | 50 | 74.4 | 25.2 | 12.7
 |  |  |  |  |  |  |  |  |  |  |  |  |  |  |  |  |  |  |  |  |  |  |  |  |  | 3.76 |  |  | 1.5 | 50 | 71.2 | 23.9 | 11.4
 | 2 |  |  |  |  |  |  |  |  | 3.92 |  |  |  |  |  |  |  |  |  |  | 10.6 |  |  |  |  | 2 |  |  | 0.9 | 50 | 74.4 | 25.6 | 13.1
 |  |  |  |  |  |  |  |  |  |  |  |  |  |  |  |  |  |  |  |  |  |  |  |  |  | 2.5 |  |  | 0.9 | 50 | 75.2 | 25.5 | 13.0
RF PCB 동작하지 않음 |  |  |  |  |  |  |  |  |  |  |  |  |  |  |  |  |  |  |  |  |  |  |  |  |  |  |  |  |  | 23.36 | 0.9
FET input까지는 문제 없지만, 출력이 20mV로 낮음
전류도 0.1A 정도 흐름
Bias를 9V까지 올려도 마찬가지임
 | => TX2의 2pin 48V bias가 납땜이 안되어 있었음

Sheet: 0216
RF PCB에 SIGEN 직접 연결
 | RFIN Vpp가 낮아 효율이 안나오는 것으로 보임
SIG | RFIN | T1_OUT- |  | Buck |  |  | RFO |  |  |  | eff[%]
[Vpp] | [Vpp] | [Vpp] | Vbias[V] | Vcc[V] | Icc[A] | P[W] | Load | Vpp[V] | Vrms[V] | P[W]
14 | 3.76 | 2.04 | 3 | 24 | 1.6 | 38.4 | 50 | 72.8 | 25.2 | 12.7 | 33.1
 |  |  |  | 32 | 2.9 | 92.8 | 50 | 93.6 | 32.3 | 20.9 | 22.5
 |  |  |  | 40 | 4 | 160 | 50 | 110 | 38.4 | 29.5 | 18.4
 |  |  |  | 48 | 5 | 240 | 50 | 125 | 43.3 | 37.5 | 15.6
 |  |  | 3.5 | 24 | 3.5 | 84 | 50 | 69.6 | 23.6 | 11.1 | 13.3
 |  |  |  | 32 | 4.7 | 150.4 | 50 | 89.6 | 30.7 | 18.8 | 12.5
 |  |  | 2.5 | 24 | 1.6 | 38.4 | 50 | 74.4 | 25.6 | 13.1 | 34.1
 |  |  |  | 32 | 2.8 | 89.6 | 50 | 92.8 | 32.2 | 20.7 | 23.1
 |  |  |  | 40 | 2.9 | 116 | 50 | 94.4 | 29.9 | 17.9 | 15.4

Sheet: 0223
SIGEN | CPU |  |  | POWER |  |  |  |  |  |  | RF |  |  |  |  |  |  |  | Load | RFO |  |  | Buck
 | IOUT_B1 | R24 | IOUT_B2 | R6 | IOUTB | R4 | R5 | Gain |  | RFIN | RFIN | R22 | RFIN2 | T1_OUT- | T1_OUT+ | Vbias[V] | Q2 IN | Q2 OUT |  | Vpp | Vrms | P | Vcc[V] | Icc[A] | P[W]
0.8 |  | NC | 2.72 | 10K | 2.72 | 680 | 360 | 2.9 | 7.9 | 8.4 |  | NC |  | 4.2 |  | 3 |  |  | 50 | 91.2 | 29.8 | 17.8 | 24 | 0.9 | 21.6
 |  |  |  |  |  | 680 | 360 | 2.9 | 0.0 |  |  |  |  |  |  | 3.5 |  |  | 50 | 91.2 | 29.7 | 17.6 | 24 | 0.9 | 21.6
 |  |  |  |  |  | 680 | 360 | 2.9 | 0.0 |  |  |  |  |  |  | 4 |  |  | 50 | 88 | 29 | 16.8 | 24 | 1.3 | 31.2
 |  |  | 2.72 |  | 2.72 | 680 | 200 | 4.4 | 12.0 | 12.6 |  |  | 11.4 | 6 |  | 3 |  |  | 50 | 91.2 | 30 | 18.0 | 24 | 0.9 | 21.6
 |  |  | 2.96 |  |  | 680 | 200 | 4.4 |  |  |  |  | 11 | 5.8 |  | 3 |  |  | 50 | 105 | 35 | 24.5 |  | 1.6 | 0.0
 |  |  |  |  |  | 680 | 200 | 4.4 |  |  |  |  |  |  |  | 3 |  |  | 50 | 106 | 34.8 | 24.2 | 28 | 2.3 | 64.4
 |  |  |  |  |  | 680 | 200 | 4.4 |  |  |  |  |  |  |  | 3 |  |  | 50 | 135 | 45.8 | 42.0 | 40 | 4 | 160.0
 |  |  | 2.8 |  | 2.8 | 680 | 100 | 7.8 | 21.8 |  |  |  | 18.2 | 9.12 |  | 3 |  |  | 50 | 136 | 45.8 | 42.0 | 40 | 4 | 160.0
 |  |  |  |  |  | 680 | 100 | 7.8 |  |  |  |  |  |  |  | 3 |  |  | 50 | 144 | 46 | 42.3 | 40 | 4.1 | 164.0
 |  |  |  |  |  |  |  | #DIV/0! |  |  |  |  |  |  |  | 3 |  |  | 50 | 134 | 43 | 37.0 | 40 | 3.7 | 148.0
 |  |  |  |  |  |  |  | #DIV/0! |  |  |  |  |  |  |  | 3 |  |  | 50 | 152 | 48.7 | 47.4 | 48 | 4.6 | 220.8
 |  |  |  |  |  |  |  | #DIV/0! |  |  |  |  |  |  |  | 4 |  | 136 | 50 | 134 | 43.2 | 37.3 | 40 | 3.7 | 148.0
 |  |  |  |  |  |  |  | #DIV/0! |  |  |  |  |  |  |  |  |  |  | 50 |  |  | 0.0 |  |  | 0.0

Sheet: CORE
 | OD | ID | Ht | AL | L[uH] | Z[Ohm] | Turn
FT140-43 | 35.55 | 23 | 12.7 | 885 | 20 | 1704 | 4.8 | 5~500MHz
FT82-43 | 21 | 13.2 | 6.35 | 470 | 20 | 1704 | 6.5 | 5~500MHz
T106-6 | 26.9 | 14.5 | 11.1 | 11.6 | 1 | 85.2 | 9.3 | 3MHz ~ 40MHz
T106-2 | 26.9 | 14.5 | 11.1 | 13.5 | 1 | 85.2 | 8.6 | 250KHz ~ 10MHz
T50-6 | 12.7 | 7.7 | 4.83 | 4 | 0.1 | 8.5 | 5 | 3MHz ~ 40MHz
T50-6 | 12.7 | 7.7 | 4.83 | 4 | 0.25 | 21.3 | 8 | 3MHz ~ 40MHz
PCB | Ref | Core | Freq | Turn | L[uH] | Wire[Φ] | Freq | Z[Ω]
RF | L6 | FT140-43 | 5~500MHz | 5 | 24 | 1.6 | 13.56 | 2043.7632
RF | L4,L5 | T50-6 | 3MHz ~ 40MHz | 6 | 0.5 | 1 |  |  | 측정기가 기본적으로 0.3uH를 표시함, offset 감안하면 0.25uH로 유추 가능함
RF | L7,L8,L9 | T106-6 | 3MHz ~ 40MHz | 9 | 1 | 1
Coupler |  | FT82-43 | 5~500MHz | 25 | 290 | 0.45 | 13.56 | 24695.472
RF | TX1 | RF-800 |  | 1 | 4 |  | 13.56 | 340.6272
RF | TX2 - 1차 | RF-1000 |  | 2 | 25.6 |  | 13.56 | 2180.01408
RF | TX2 - 2차 | RF-1000 |  | 1/2 | 3.3 |  | 13.56 | 281.01744
RF | L6,L7,L8 | AIR - 20Φ |  | 5 | 0.5 | 1.6 | 13.56 | 42.5784
 |  |  |  | 6 | 0.6 |  | 13.56 | 51.09408
 |  |  |  | 8 | 1
 |  |  |  | 10 | 1.4

Sheet: FAN
PN | Vendor | V | I | PRM | CFM | mmH2O | Noise[dBA] | Size
AFB0912SH-A | DELTA | 12VDC | 0.75 | 4800 | 102.59 | 13.35 | 53 | 92x92x25.4
AFB0912VHD-F00 |  | 12VDC | 0.28 | 3300 | 66.11 | 5.03 | 40.5 | 92x92x20

Sheet: Sheet1
SMPS | 600 | W
 | 48 | V
 | 12.5 | A
Current Limit = 10A

Sheet: Test sheet (2)
CPU |  |  | POWER |  |  |  |  |  |  | RF |  |  |  |  |  |  |  | Load | RFO |  |  | Buck
IOUT_B1 | R24 | IOUT_B2 | R6 | IOUTB | R4 | R5 | Gain |  | RFIN | RFIN | R22 | RFIN2 | T1_OUT- | T1_OUT+ | Vbias[V] | Q2 IN | Q2 OUT |  | Vpp | Vrms | P | Vcc[V] | Icc[A] | P[W]
0.6 | NC | 2.52 |  | 2.52 | 680 | 100 | 7.8 | 19.7 | 21.2 |  | NC |  |  |  | 1.45 |  |  | 50 | 78.4 | 26.8 | 14.4 | 24 | 1 | 24.0
 |  |  |  |  |  |  | #DIV/0! | #DIV/0! |  |  | NC |  |  |  | 1.9 |  |  | 50 | 76 | 26 | 13.5 | 24 | 0.9 | 21.6
 |  |  |  |  |  |  | #DIV/0! | #DIV/0! |  |  | NC | 18.4 |  | 10 | 2.5 |  |  | 50 | 63.2 | 21.4 | 9.2 | 24 | 5 | 120.0
 |  |  |  |  |  |  | #DIV/0! | #DIV/0! |  |  |  |  |  |  |  |  |  | 50 |  |  | 0.0 | 24 | 0.9 | 21.6
 |  |  |  |  |  |  | #DIV/0! |  |  |  |  |  |  |  |  |  |  | 50 |  |  | 0.0 |  | 1.6 | 0.0
 |  |  |  |  |  |  | #DIV/0! |  |  |  |  |  |  |  |  |  |  | 50 |  |  | 0.0 | 28 | 2.3 | 64.4
 |  |  |  |  |  |  | #DIV/0! |  |  |  |  |  |  |  |  |  |  | 50 |  |  | 0.0 | 40 | 4 | 160.0
 |  |  |  |  |  |  | #DIV/0! | #DIV/0! |  |  |  |  |  |  |  |  |  | 50 |  |  | 0.0 | 40 | 4 | 160.0
 |  |  |  |  |  |  | #DIV/0! |  |  |  |  |  |  |  |  |  |  | 50 |  |  | 0.0 | 40 | 4.1 | 164.0
 |  |  |  |  |  |  | #DIV/0! |  |  |  |  |  |  |  |  |  |  | 50 |  |  | 0.0 | 40 | 3.7 | 148.0
 |  |  |  |  |  |  | #DIV/0! |  |  |  |  |  |  |  |  |  |  | 50 |  |  | 0.0 | 48 | 4.6 | 220.8
 |  |  |  |  |  |  | #DIV/0! |  |  |  |  |  |  |  |  |  |  | 50 |  |  | 0.0 | 40 | 3.7 | 148.0
 |  |  |  |  |  |  | #DIV/0! |  |  |  |  |  |  |  |  |  |  | 50 |  |  | 0.0 |  |  | 0.0

Sheet: 0229
CPU |  |  | POWER |  |  |  |  |  |  | RF |  |  |  |  |  |  |  | Load | RFO |  |  | Buck
IOUT_B1 | R24 | IOUT_B2 | R6 | IOUTB | R4 | R5 | Gain |  | RFIN | RFIN | R22 | RFIN2 | T1_OUT- | T1_OUT+ | Vbias[V] | Q2 IN | Q2 OUT |  | Vpp | Vrms | P | Vcc[V] | Icc[A] | P[W]
0.6 | NC | 2.52 | 10K | 2.52 | 680 | 100 | 7.8 | 19.7 | 21.2 |  | NC |  |  |  | 1.45 |  |  | 50 | 78.4 | 26.8 | 14.4 | 24 | 1 | 24.0
 |  |  |  |  |  |  | #DIV/0! | #DIV/0! |  |  | NC |  |  |  | 1.9 |  |  | 50 | 76 | 26 | 13.5 | 24 | 0.9 | 21.6
 |  |  |  |  |  |  | #DIV/0! | #DIV/0! |  |  | NC | 18.4 |  | 10 | 2.5 |  |  | 50 | 63.2 | 21.4 | 9.2 | 24 | 5 | 120.0
 |  |  |  |  |  |  | #DIV/0! | #DIV/0! |  |  |  |  |  |  |  |  |  | 50 | 87 | 29.8 | 17.8 | 28 | 5.6 | 156.8
 |  |  |  |  |  |  | #DIV/0! |  |  |  |  |  |  |  |  |  |  | 50 | 94.4 | 32.2 | 20.7 | 32 | 8.2 | 262.4
 |  |  |  |  |  |  | #DIV/0! |  |  |  |  |  |  |  |  |  |  | 50 | 100 | 34.4 | 23.7 | 36 | 10 | 360.0
 |  |  |  |  |  |  | #DIV/0! |  |  |  |  |  |  |  | 1.45 |  | 120 | 50 | 106 | 36.3 | 26.4 | 36 | 10 | 360.0
 |  |  |  |  |  |  | #DIV/0! | #DIV/0! |  |  |  |  |  |  | 0 |  |  | 50 | 126 | 43.8 | 38.4 | 44 | 4.3 | 189.2
 |  |  |  |  |  |  | #DIV/0! |  |  |  |  |  |  |  |  |  |  | 50 | 134 | 46.4 | 43.1 | 48 | 5.2 | 249.6
 |  |  |  |  |  |  | #DIV/0! |  |  |  |  |  |  |  |  |  |  | 50 | 222 | 76 | 115.5 | 32 | 10 | 320.0
L4,L5 0 Ohm | NC |  | 10K |  | 680 | 100 | 7.8 |  |  |  | NC | 18.6 |  |  | 0 |  | 154 | 50 | 170 | 57.8 | 66.8 | 18 | 8.4 | 151.2
 |  |  |  |  |  |  | #DIV/0! |  |  |  |  | 18.8 |  |  | 0 |  | 168 | 50 | 186 | 63.8 | 81.4 | 20 | 9.2 | 184.0
 |  |  |  |  |  |  | #DIV/0! |  |  |  |  |  |  |  |  |  |  | 50 | 208 | 70.6 | 99.7 | 22.5 |  | 0.0

Sheet: 0229 (2)
CPU |  |  | POWER |  |  |  |  |  |  | RF |  |  |  |  |  |  |  | Load | RFO |  |  | Buck |  |  | SMPS 48V
IOUT_B1 | R24 | IOUT_B2 | R6 | IOUTB | R4 | R5 | Gain |  | RFIN | RFIN | R22 | RFIN2 | T1_OUT- | T1_OUT+ | Vbias[V] | Q2 IN | Q2 OUT |  | Vpp | Vrms | P | Vcc[V] | Icc[A] | P[W] | Icc[A] | P[W] | Icc[A] | P[W]
0.6 | NC | 3.12 | 10K | 3.12 | 680 | 100 | 7.8 | 24.3 |  | 15.4 | NC | 18.2 |  |  | 0 |  |  | 50 | 204 | 70.5 | 99.4 | 22.5 |  | 0.0 | 4.9 | 235.2 | 8.2 | 393.6
 |  |  |  |  |  |  | #DIV/0! | #DIV/0! |  |  |  |  |  |  |  |  |  | 50 |  |  | 0.0 |  |  | 0.0 |  | 0.0 |  | 0.0
 |  |  |  |  |  |  | #DIV/0! | #DIV/0! |  |  |  |  |  |  |  |  |  | 50 |  |  | 0.0 |  |  | 0.0 |  | 0.0 |  | 0.0
 |  |  |  |  |  |  | #DIV/0! | #DIV/0! |  |  |  |  |  |  |  |  |  | 50 |  |  | 0.0 |  |  | 0.0 |  | 0.0 |  | 0.0
 |  |  |  |  |  |  | #DIV/0! |  |  |  |  |  |  |  |  |  |  | 50 |  |  | 0.0 |  |  | 0.0 |  | 0.0 |  | 0.0
 |  |  |  |  |  |  | #DIV/0! |  |  |  |  |  |  |  |  |  |  | 50 |  |  | 0.0 |  |  | 0.0 |  | 0.0 |  | 0.0
 |  |  |  |  |  |  | #DIV/0! |  |  |  |  |  |  |  |  |  |  | 50 |  |  | 0.0 |  |  | 0.0 |  | 0.0 |  | 0.0
 |  |  |  |  |  |  | #DIV/0! | #DIV/0! |  |  |  |  |  |  |  |  |  | 50 |  |  | 0.0 |  |  | 0.0 |  | 0.0 |  | 0.0
 |  |  |  |  |  |  | #DIV/0! |  |  |  |  |  |  |  |  |  |  | 50 |  |  | 0.0 |  |  | 0.0 |  | 0.0 |  | 0.0
 |  |  |  |  |  |  | #DIV/0! |  |  |  |  |  |  |  |  |  |  | 50 |  |  | 0.0 |  |  | 0.0 |  | 0.0 |  | 0.0
 |  |  |  |  |  |  | #DIV/0! |  |  |  |  |  |  |  |  |  |  | 50 |  |  | 0.0 |  |  | 0.0 |  | 0.0 |  | 0.0
 |  |  |  |  |  |  | #DIV/0! |  |  |  |  |  |  |  |  |  |  | 50 |  |  | 0.0 |  |  | 0.0 |  | 0.0 |  | 0.0
 |  |  |  |  |  |  | #DIV/0! |  |  |  |  |  |  |  |  |  |  | 50 |  |  | 0.0 |  |  | 0.0 |  | 0.0 |  | 0.0

Sheet: Coupler
Long-wave SWR meter
 | Circuit
 | 1) Transformer
 |  | 100Ω 2W 두개를 사용하여 50Ω 4W 설계
 |  | turn ratio 1:25의 동일한 Transformer 2ea 사용
 |  | RF-INPUT |  |  |  |  | coupling 1:25
 |  | P[W] | Vrms[V] | Vpp[V] | Irms[A] | Ipp[A] | Vrms[V] | Vpp[V] | P[W] | Irms[A] | Ipp[A]
 |  | 10 | 22.4 | 63.3 | 0.4 | 1.3 | 0.89 | 2.5 | 0.02 | 0.02 | 0.1
 |  | 100 | 70.7 | 200.0 | 1.4 | 4.0 | 2.83 | 8.0 | 0.16 | 0.06 | 0.2
 |  | 300 | 122.5 | 346.5 | 2.4 | 6.9 | 4.90 | 13.9 | 0.48 | 0.10 | 0.3
 |  | 600 | 173.2 | 490.0 | 3.5 | 9.8 | 6.93 | 19.6 | 0.96 | 0.14 | 0.4
 |  | 1000 | 223.6 | 632.6 | 4.5 | 12.7 | 8.94 | 25.3 | 1.60 | 0.18 | 0.5
 |  | 2차측 impedance가 Load impedance의 10배의 impedance를 가져야 한다.
 |  | Core |  | FT140-43 | FT114-43 | FT82-43 | FT50-43 | FT114-43 | FT114-43 | UNIT
 |  | Core OD |  | 35.55 | 29 | 21 | 12.7 | 29 | 29 | mm
 |  | AL |  | 885 | 510 | 470 | 440 | 510 | 510
 |  | uH for 25T |  | 553.1 | 318.8 | 293.8 | 275.0 | 318.8 | 318.8 | uH
 |  | Start frequency |  | 0.3 | 0.3 | 0.3 | 0.3 | 27.12 | 13.65 | MHz
 |  | 2차측 impedance |  | 1042.1 | 600.5 | 553.4 | 518.1 | 54287.5 | 27323.9 | Ω
 |  | 2차측 권선 길이 |  | 1.23 | 0.78 | 0.78 | 0.78 | 0.78 | 0.78 | m
 |  | 2차측 권선의 길이가 가장 짧은 파장의 1/10 이하 이어야 한다.
 |  | End frequency |  | 30 | MHz
 |  | 파장 |  | 10 | m
 |  | 2차측 권선 최대 길이 |  | 1 | m
 | 2) rectified circuit
 |  | VT - 1차측의 전류는 Load Z와 Trans Z로 계산해야 함.(Transformer 공식 사용하면 안됨)
 |  | RF-INPUT |  |  |  |  | VT Turn ratio |  |  | 1차 | 25 | R1 |  | R2
 |  |  |  |  |  |  |  |  |  | 2차 | 1 | R1[KΩ] | 1 | R2[KΩ] | 1
 |  | P[W] | Vrms[V] | Vpp[V] | Irms[A] | Ipp[A] | Vrms[V] | Vpp[V] | P[W] | Irms[A] | Ipp[A] | Vrms[V] | P[W] | Vrms[V] | P[W] | Vpp[V]
 |  | 50 | 50.0 | 141.4 | 1.0 | 2.8 | 2.00 | 5.7 | 0.1 | 0.04 | 0.1 | 1.00 | 0.001 | 1.00 | 0.001 | 2.8
 |  | 100 | 70.7 | 200.0 | 1.4 | 4.0 | 2.83 | 8.0 | 0.2 | 0.06 | 0.2 | 1.41 | 0.002 | 1.41 | 0.002 | 4.0
 |  | 150 | 86.6 | 245.0 | 1.7 | 4.9 | 3.46 | 9.8 | 0.2 | 0.07 | 0.2 | 1.73 | 0.003 | 1.73 | 0.003 | 4.9
 |  | 200 | 100.0 | 282.9 | 2.0 | 5.7 | 4.00 | 11.3 | 0.3 | 0.08 | 0.2 | 2.00 | 0.004 | 2.00 | 0.004 | 5.7
 |  | 250 | 111.8 | 316.3 | 2.2 | 6.3 | 4.47 | 12.7 | 0.4 | 0.09 | 0.3 | 2.24 | 0.005 | 2.24 | 0.005 | 6.3
 |  | 300 | 122.5 | 346.5 | 2.4 | 6.9 | 4.90 | 13.9 | 0.5 | 0.10 | 0.3 | 2.45 | 0.006 | 2.45 | 0.006 | 6.9
 |  | 350 | 132.3 | 374.2 | 2.6 | 7.5 | 5.29 | 15.0 | 0.6 | 0.11 | 0.3 | 2.65 | 0.007 | 2.65 | 0.007 | 7.5
 |  | CT - 1차측의 전압은 Load Z와 Trans Z로 계산해야 함.(Transformer 공식 사용하면 안됨)
 |  | RF-INPUT |  |  |  |  | CT Turn ratio |  |  | 1차 | 1 | R1 |  | R2
 |  |  |  |  |  |  |  |  |  | 2차 | 25 | R1[KΩ] | 1 | R2[KΩ] | 1
 |  | P[W] | Vrms[V] | Vpp[V] | Irms[A] | Ipp[A] | Irms[A] | Ipp[A] | Vrms[V] | Vpp[V] | P[W] | Vrms[V] | P[W] | Vrms[V] | P[W] | Vpp[V]
 |  | 50 | 50.0 | 141.4 | 1.0 | 2.8 | 0.04 | 0.1 | 2.00 | 5.7 | 0.1 | 1.00 | 0.001 | 1.00 | 0.001 | 2.8
 |  | 100 | 70.7 | 200.0 | 1.4 | 4.0 | 0.06 | 0.2 | 2.83 | 8.0 | 0.2 | 1.41 | 0.002 | 1.41 | 0.002 | 4.0
 |  | 150 | 86.6 | 245.0 | 1.7 | 4.9 | 0.07 | 0.2 | 3.46 | 9.8 | 0.2 | 1.73 | 0.003 | 1.73 | 0.003 | 4.9
 |  | 200 | 100.0 | 282.9 | 2.0 | 5.7 | 0.08 | 0.2 | 4.00 | 11.3 | 0.3 | 2.00 | 0.004 | 2.00 | 0.004 | 5.7
 |  | 250 | 111.8 | 316.3 | 2.2 | 6.3 | 0.09 | 0.3 | 4.47 | 12.7 | 0.4 | 2.24 | 0.005 | 2.24 | 0.005 | 6.3
 |  | 300 | 122.5 | 346.5 | 2.4 | 6.9 | 0.10 | 0.3 | 4.90 | 13.9 | 0.5 | 2.45 | 0.006 | 2.45 | 0.006 | 6.9
 |  | 350 | 132.3 | 374.2 | 2.6 | 7.5 | 0.11 | 0.3 | 5.29 | 15.0 | 0.6 | 2.65 | 0.007 | 2.65 | 0.007 | 7.5
 |  | RC Filter 설계
 |  | R | 1 | 1 | 0.56 | KΩ
 |  | C | 100 | 47 | 100 | pF
 |  | Fc | 1592.356688 | 3387.992953 | 2843.494086 | KHz
 |  | τ | 0.1 | 0.047 | 0.056 | usec
 |  | Bypass Cap
 |  | C | 20 | 68 | 100 | 100000 | pF
 |  | Fc | 27120 | 13560 | 13560 | 0.8 | KHz
 |  | Z | 293.5760855 | 172.691815 | 117.4304342 | 1990.44586 | Ω

Sheet: Pout table
Power | Load | Vrms | Irms | Vpp | R1[kΩ] | 수량 | R2[kΩ] | Vout
50 | 50 | 50.0 | 1.00 | 141.4 | 7.5 | 3 | 0.68 | 4.15
100 | 50 | 70.7 | 1.41 | 200.0 | 7.5 | 3 | 0.68 | 5.87
150 | 50 | 86.6 | 1.73 | 245.0 | 7.5 | 3 | 0.68 | 7.19
200 | 50 | 100.0 | 2.00 | 282.9 | 7.5 | 3 | 0.68 | 8.30
250 | 50 | 111.8 | 2.24 | 316.3 | 7.5 | 3 | 0.68 | 9.28
300 | 50 | 122.5 | 2.45 | 346.5 | 7.5 | 3 | 0.68 | 10.16
350 | 50 | 132.3 | 2.65 | 374.2 | 7.5 | 3 | 0.68 | 10.98
400 | 50 | 141.4 | 2.83 | 400.1 | 7.5 | 3 | 0.68 | 11.74
450 | 50 | 150.0 | 3.00 | 424.3 | 7.5 | 3 | 0.68 | 12.45
500 | 50 | 158.1 | 3.16 | 447.3 | 7.5 | 3 | 0.68 | 13.12
50Ω에 병렬로 저항을 추가하여 전압 분배하여 측정
Vout[Vpp] | R1[kΩ] | 수량 | R2[kΩ] | Vpp | Vrms | Irms | Load | Power | V_buck | Duty | V_buck
4.64 | 7.5 | 3 | 0.68 | 158.2 | 55.9 | 1.1 | 50 | 62.5 |  | 60 | 28.8
5.68 | 7.5 | 3 | 0.68 | 193.6 | 68.4 | 1.4 | 50 | 93.7 | 32.4 | 70 | 33.6
Power | Load | Vrms | Irms | Vpp | 25T
50 | 50 | 50.0 | 1.00 | 141.4 | 5.7
100 | 50 | 70.7 | 1.41 | 200.0 | 8.0
150 | 50 | 86.6 | 1.73 | 245.0 | 9.8
200 | 50 | 100.0 | 2.00 | 282.9 | 11.3
250 | 50 | 111.8 | 2.24 | 316.3 | 12.7
300 | 50 | 122.5 | 2.45 | 346.5 | 13.9
350 | 50 | 132.3 | 2.65 | 374.2 | 15.0
400 | 50 | 141.4 | 2.83 | 400.1 | 16.0
450 | 50 | 150.0 | 3.00 | 424.3 | 17.0
500 | 50 | 158.1 | 3.16 | 447.3 | 17.9
Coupler에서 Vfwd=11.6Vpp , Vreflected=11.6Vpp 출력, 반사파가 90도 shift
Open시킨 경우, 180도 shift됨
