ArvidJoung/Plasma_RF_Generator/1_Schematic/Build V2.0/03_RF-GEN-RF-001/YS95_95_200212.dxf

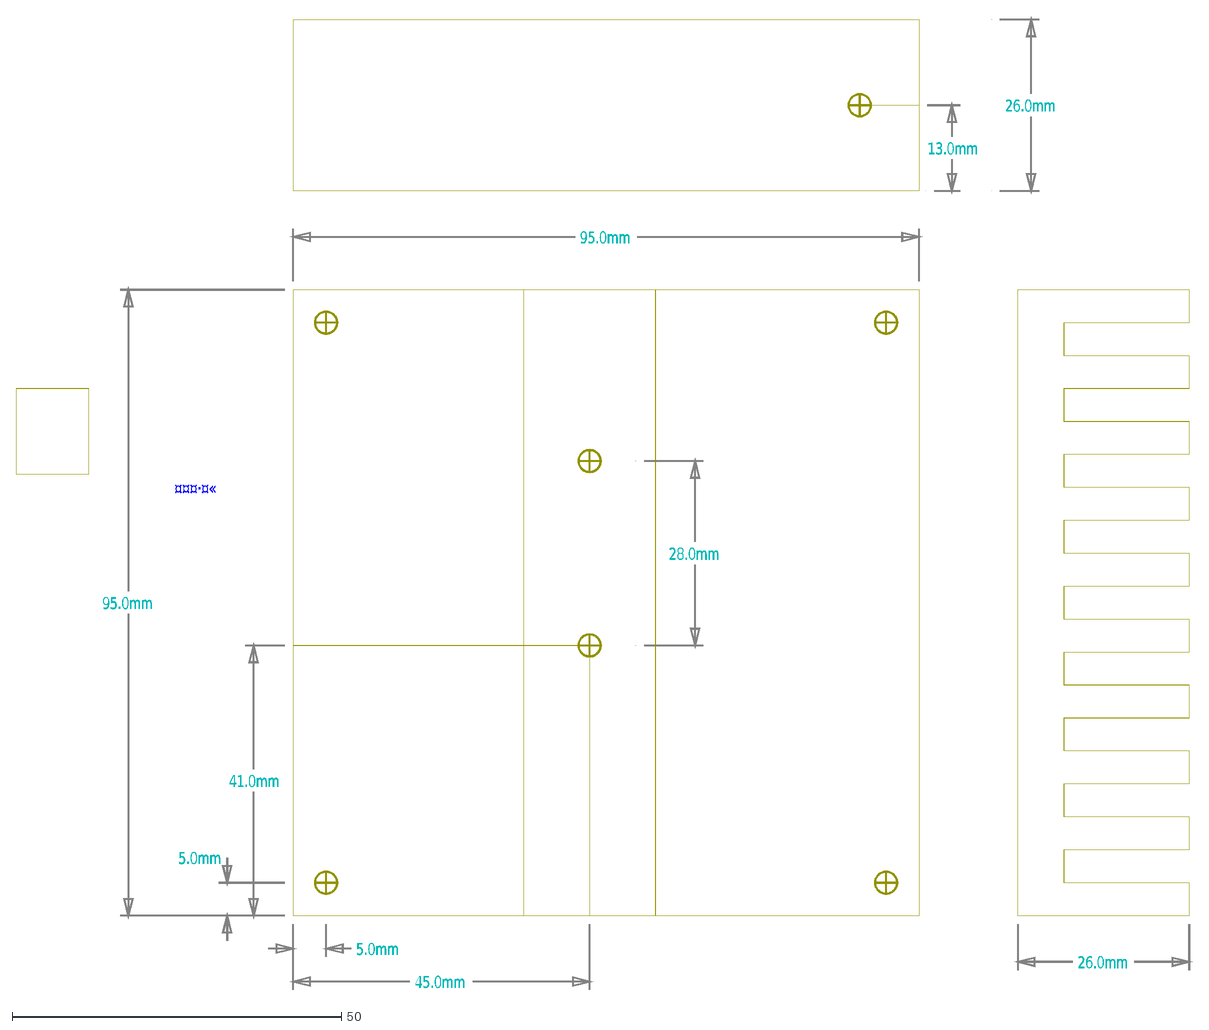
[picture p104: CAD file, 2020-02-12]
1_Schematic/Build V2.0/03_RF-GEN-RF-001/YS95_95_200212.dxf
95.0mm
5.0mm
41.0mm
45.0mm
28.0mm
26.0mm
13.0mm
¤¤¤·¤«
