ArvidJoung/Plasma_RF_Generator/1_Schematic/Build V2.0/03_RF-GEN-RF-001/YS95_95mm_HeatSink M3 Tap 위치.dxf

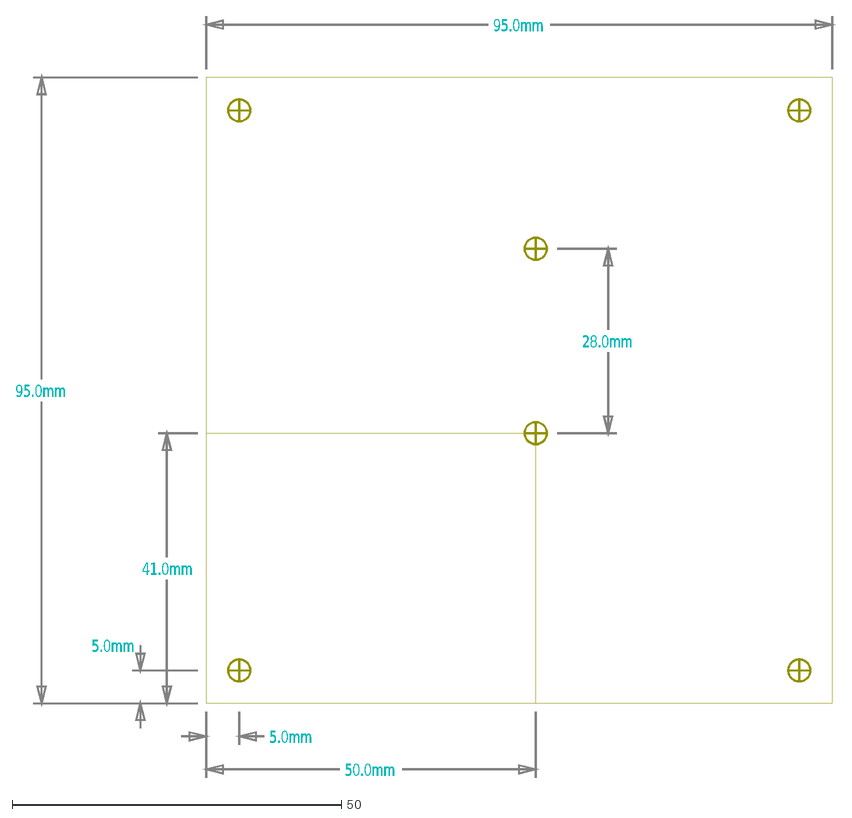
[picture p105: CAD file, 2019-12-17]
1_Schematic/Build V2.0/03_RF-GEN-RF-001/YS95_95mm_HeatSink M3 Tap 위치.dxf
95.0mm
5.0mm
41.0mm
50.0mm
28.0mm
