ArvidJoung/Plasma_RF_Generator/(list of files, cad)

Other CAD files:
1_Schematic/Build V2.0/02_RF-GEN-PWR-001/HS_YS500_HS2.dwg
1_Schematic/Build V2.0/02_RF-GEN-PWR-001/HS_YS300_HS1,HS3.dwg
1_Schematic/Build V2.0/03_RF-GEN-RF-001/YS95_95_200212.dwg
