ArvidJoung/Plasma_RF_Generator/1_Schematic/Build V2.0/RF-GEN-FW Review Data_20200309.xlsx

Sheet: 수정요청 사항
Version | No | Issue | 수정 요청 사항
2020-02-29 | 1 | RF ON시 바로 Duty 50% 출력됨 | PC6_PW_PWM - 0%에서 Count value 2씩 증가해야 함.
 | 2 | DDS 출력(IOUT_B1)에서 초기에 1.5msec 동안 1.52V까지 overshoot 발생 | F/W 초기 설정 순서의 문제인지 확인 요청 해결전까지 PRE_AMP_ENA을 DDS 출력 후 2msec 후 High로 설정

Sheet: FW Review
Version | No | Operation
2020-02-29 | 1 | CPU IOUTB 출력 후 19msec 후 PW_PWM 출력
 | 2 | CPU IOUTB 출력 후 530usec 후 PRE_AMP_ENA ON
 | 3 | PRE_AMP_ENA, BIAS_ON 동시 동작
 | 4 | 3.3V ON rising time=3.84msec 3.3V Pull-up이 걸리기 전에 74HCT244에서 300usec동안 각 Port가 출력됨 - FAN 초기 오동작 | HW Pull-Down 추가
 | 5 | FAN Duty 100% 동작
 | 6 | RF ON시 LED On 상태 유지

Sheet: FW History
Duty | ON[usec] | OFF[usec] | Total[usec] | Freq[KHz] | Duty | Rising
50% | 10 | 10 | 20 | 50 | 50
60% | 12 | 8 | 20 | 50 | 60
70% | 14 | 6 | 20 | 50 | 70
80% | 16 | 4 | 20 | 50 | 80 | 54.4msec
90% | 18 | 2 | 20 | 50 | 90
99.9% | 19.9 | 0.1 | 20 | 50 | 99.5
