ArvidJoung/Plasma_RF_Generator/1_Schematic/Build V2.0/03_RF-GEN-RF-001/MICRO-WAVE_Block Diagram_20200301.xlsx

Sheet: MICROSON-PEN V4.0(PP)
PEN-HIFU Block Diagram V4.0[PP]
 | CPU Block - HS:25mm |  |  | FAN Block
 | Gap | 2 |  | FAN | 10 |  |  | JTAG2 |  | HD1 |  |  |  | HD201
 | CON | 15 |  | 판금 | 2 |  |  | YDW200-06P |  | RF_QR_IN | 1 | PW_IS_CT | 2 | 1 | RF_QR_IN | 2 | PW_IS_CT
 | CPU PCB | 1.6 |  | GAP | 15 |  |  | 1 | 3_3V | BIAS_ON | 3 | VDC_OUT | 4 | 3 | BIAS_ON | 4 | VDC_OUT
 | Support | 30 |  | Heat Sink | 30 |  |  | 2 | SCI_RXA | TIM8_OC_IN | 5 | VDC_IN | 6 | 5 | TIM8_OC_IN | 6 | VDC_IN
 | PWR PCB | 1.6 |  | PWR PCB | 1.6 |  |  | 3 | BOOT0 | GND | 7 | GND | 8 | 7 | GND | 8 | GND
 | Total | 50.2 |  | Total | 58.6 |  |  | 4 | SCI_TXA | PW_PWM | 9 | FET_TEMP | 10 | 9 | PW_PWM | 10 | FET_TEMP
 |  |  |  |  |  |  |  | 5 | GND | PRE_AMP_ENA | 11 | PW_I_REF | 12 | 11 | PRE_AMP_ENA | 12 | PW_I_REF
 |  |  |  |  |  |  |  | 6 | NRST | FT_7M_RY_ON | 13 | FT_4M_RY_ON | 14 | 13 | FT_7M_RY_ON | 14 | FT_4M_RY_ON
 |  |  |  |  |  |  |  |  |  | GND | 15 | GND | 16 | 15 | GND | 16 | GND
 |  |  |  |  |  |  |  |  |  | - | 17 | - | 18 | 17 | - | 18 | -
CON401 |  |  | CON703 |  |  | CONN4 |  | CN101 |  | SS48V | 19 | SS48V | 20 | 19 | SS48V | 20 | SS48V
MOLEX5267-5P |  |  | Micro USB 5P |  |  | 12505WR-3P |  | 5267-3P
1 | USB_5V |  | 1 | USB_5V |  | 1 | TXD_LCD | 1 | TXD_LCD |  |  | FAN1
2 | DM |  | 2 | DM |  | 2 | RXD_LCD | 2 | RXD_LCD |  |  | 5267-2P
3 | DP |  | 3 | DP |  | 3 | GND | 3 | GND |  |  | +12V | 1
- | - |  | 4 | ID |  |  |  |  |  |  |  | FAN_PWM | 2
4 | GND |  | 5 | GND |  | CON1101 |  | CN106
5 | GND |  | CASE | GND |  | 12505WR-4P |  | 5267-4P |  |  |  | FAN2
 |  |  |  |  |  | 1 | LCD12V | 1 | LCD12V |  |  | 5267-2P
 |  |  | CONN5 |  |  | 2 | LCD12V | 2 | LCD12V |  |  | +12V | 1
 |  |  | 12505WR-02 |  |  | 3 | GND | 3 | GND |  |  | FAN_PWM | 2
 |  |  | 1 | Line+ |  | 4 | GND | 4 | GND
 |  |  | 2 | Line- |  |  |  |  |  |  |  | FAN3 |  |  |  | RF_OUT
 |  |  |  |  |  |  |  |  |  |  |  | 5267-2P |  |  |  | SMA-R-R/A(BNC)
 |  |  |  |  |  |  |  |  |  |  |  | +12V | 1 |  |  | 1 | RF_OUT
 |  |  |  |  |  |  |  |  |  |  |  | FAN_PWM | 2 |  |  | 2 | GND
 |  |  | CN302 |  |  | CN301 |  | CN104
 |  |  | 5267-2P |  |  | 5267-7P |  | 5267-7P |  |  |  | CN102
 |  |  | 1 | LINE_P |  | 1 | SS48V | 1 | SS48V |  |  | 5267-6P
 |  |  | 2 | LINE_N |  | 2 | FRONT_KEY | 2 | FRONT_KEY |  |  | HP12V | 1
 |  |  |  |  |  | 3 | FRONT_BULE | 3 | FRONT_BULE |  |  | SHOT_SW | 2
 |  |  |  |  |  | 4 | FRONT_RED | 4 | FRONT_RED |  |  | KART_CHK | 3
 |  |  |  |  |  | 5 | GND | 5 | GND |  |  | HP_SDA | 4
 |  |  |  |  |  | 6 | LINE_P | 6 | LINE_P |  |  | HP_SCL | 5
 |  |  |  |  |  | 7 | LINE_N | 7 | LINE_N |  |  | GND | 6
 |  |  |  |  |  |  |  |  |  |  |  | CN103 |  |  |  |  |  | CN2 |  | CN1
 |  |  |  |  |  |  |  | CN107 |  |  |  | MX35313-3P |  |  |  |  |  | MX35313-3P |  | MX35313-3P
 |  |  |  |  |  |  |  | 5267-2P |  |  |  | SS48V | 1 |  |  |  |  | 1 | AC_L | AC_L | 1
 |  |  |  |  |  |  |  | 1 | LINE_P |  |  | - | 2 |  |  |  |  | 2 | - | - | 2
 |  |  |  |  |  |  |  | 2 | LINE_N |  |  | GND | 3 |  |  |  |  | 3 | AC_N | AC_N | 3
 |  |  |  |  |  |  |  | CN105
 |  |  |  |  |  |  |  | 5267-2P
 |  |  |  |  |  |  |  | 1 | FOOT_SW
 |  |  |  |  |  |  |  | 2 | GND

Sheet: MICRO-WAVE
MICROWAVE Block Diagram V4.0[PP]
 | CPU Block - HS:25mm |  |  | FAN Block
 | Gap | 2 |  | FAN | 10 |  |  | JTAG2 |  | HD1 |  |  |  | HD201 |  |  |  | RF_OUT |  | RF_IN |  | RF_OUT
 | CON | 15 |  | 판금 | 2 |  |  | YDW200-06P |  | RF_QR_IN | 1 | PRE_AMP_ENA | 2 | 1 | RF_QR_IN | 2 | PRE_AMP_ENA | SMA-R-R/A(BNC) |  | SMA-R-R/A(BNC) |  | SMA-R-R/A(BNC)
 | CPU PCB | 1.6 |  | GAP | 15 |  |  | 1 | 3_3V | PW_I_REF | 3 | VDC_OUT | 4 | 3 | PW_I_REF | 4 | VDC_OUT | 1 | RF_INA | 1 | RF_INA | 1 | RF_OUT
 | Support | 30 |  | Heat Sink | 30 |  |  | 2 | SCI_RXA | TIM8_OC_IN | 5 | VDC_IN | 6 | 5 | TIM8_OC_IN | 6 | VDC_IN | 2 | GND | 2 | GND | 2 | GND
 | PWR PCB | 1.6 |  | PWR PCB | 1.6 |  |  | 3 | BOOT0 | BIAS_ON | 7 | PW_IS_CT | 8 | 7 | BIAS_ON | 8 | PW_IS_CT
 | Total | 50.2 |  | Total | 58.6 |  |  | 4 | SCI_TXA | FET_TEMP | 9 | PW_PWM | 10 | 9 | FET_TEMP | 10 | PW_PWM | CN200 |  | CN300
 |  |  |  |  |  |  |  | 5 | GND | GND | 11 | GND | 12 | 11 | GND | 12 | GND | 5267-2P |  | 5268-2P
 |  |  |  |  |  |  |  | 6 | NRST | GND | 13 | GND | 14 | 13 | GND | 14 | GND | 1 | +9V | 1 | +9V
 |  |  |  |  |  |  |  |  |  |  | 15 |  | 16 | 15 |  | 16 |  | 2 | GND | 2 | GND
 |  |  |  |  |  |  |  |  |  | SS48V | 17 | SS48V | 18 | 17 | SS48V | 18 | SS48V
CON401 |  |  | CON703 |  |  | CONN4 |  | CN101 |  | SS48V | 19 | SS48V | 20 | 19 | SS48V | 20 | SS48V | CN201 |  | CN301
MOLEX5267-5P |  |  | Micro USB 5P |  |  | 12505WR-3P |  | 5267-3P |  |  |  |  |  |  |  |  |  | MX35313-5P |  | LAB-1143-5P
1 | USB_5V |  | 1 | USB_5V |  | 1 | TXD_LCD | 1 | TXD_LCD |  |  | FAN1 |  |  |  |  |  | 1 | GND | 1 | GND
2 | DM |  | 2 | DM |  | 2 | RXD_LCD | 2 | RXD_LCD |  |  | 5267-2P |  |  |  |  |  | 2 | GND | 2 | GND
3 | DP |  | 3 | DP |  | 3 | GND | 3 | GND |  |  | +12V | 1 |  |  |  |  | 3 | - | 3 | -
- | - |  | 4 | ID |  |  |  |  |  |  |  | FAN_PWM | 2 |  |  |  |  | 4 | DC48V | 4 | DC48V
4 | GND |  | 5 | GND |  | CON1101 |  | CN106 |  |  |  |  |  |  |  |  |  | 5 | DC48V | 5 | DC48V
5 | GND |  | CASE | GND |  | 12505WR-4P |  | 5267-4P |  | FAN3 |  | FAN2
 |  |  |  |  |  | 1 | LCD12V | 1 | LCD12V | 5267-2P |  | 5267-2P
 |  |  | CONN5 |  |  | 2 | LCD12V | 2 | LCD12V | +12V | 1 | +12V | 1
 |  |  | 12505WR-02 |  |  | 3 | GND | 3 | GND | FAN_PWM | 2 | FAN_PWM | 2
 |  |  | 1 | Line+ |  | 4 | GND | 4 | GND
 |  |  | 2 | Line- |  |  |  |  |  |  |  | CN108 |  |  |  |  |  |  |  | CN302
 |  |  |  |  |  |  |  |  |  |  |  | 5267-3P |  |  |  |  |  |  |  | 5268-3P
 |  |  |  |  |  |  |  |  |  |  |  | +12V | 1 |  |  |  |  |  |  | 1 | +12V
 |  |  |  |  |  |  |  |  |  |  |  | FET_TEMP | 2 |  |  |  |  |  |  | 2 | FET_TEMP
 |  |  | CN302 |  |  | CN301 |  | CN104 |  |  |  | GND | 3 |  |  |  |  |  |  | 3 | GND
 |  |  | 5267-2P |  |  | 5267-7P |  | 5267-7P
 |  |  | 1 | LINE_P |  | 1 | +12V | 1 | +12V |  |  | CN103 |  |  |  |  |  |  |  | CN303
 |  |  | 2 | LINE_N |  | 2 | FRONT_KEY | 2 | FRONT_KEY |  |  | MX35313-5P |  |  |  |  |  |  |  | 5268-2P
 |  |  |  |  |  | 3 | FRONT_BULE | 3 | FRONT_BULE |  |  | SS48V | 1 |  |  |  |  |  |  | 1 | FWO
 |  |  |  |  |  | 4 | FRONT_RED | 4 | FRONT_RED |  |  | SS48V | 2 |  |  |  |  |  |  | 2 | GND
 |  |  |  |  |  | 5 | GND | 5 | GND |  |  | - | 3
 |  |  |  |  |  | 6 | LINE_P | 6 | LINE_P |  |  | GND | 4 |  |  |  |  |  |  | CN304
 |  |  |  |  |  | 7 | LINE_N | 7 | LINE_N |  |  | GND | 5 |  |  |  |  |  |  | 5268-2P
 |  |  |  |  |  |  |  |  |  |  |  |  |  |  |  |  |  |  |  | 1 | RVO
 |  |  |  |  |  |  |  |  |  |  |  | CN100 |  |  |  |  |  |  |  | 2 | GND
 |  |  |  |  |  |  |  | CN107 |  |  |  | MX35313-2P
 |  |  |  |  |  |  |  | 5267-2P |  |  |  | +12V | 1
 |  |  |  |  |  |  |  | 1 | LINE_P |  |  | GND | 2
 |  |  |  |  |  |  |  | 2 | LINE_N
 |  |  |  |  |  |  |  |  |  |  |  | CN102
 |  |  |  |  |  |  |  | CN105 |  |  |  | 5267-6P
 |  |  |  |  |  |  |  | 5267-2P |  |  |  | HP12V | 1
 |  |  |  |  |  |  |  | 1 | FOOT_SW |  |  | SHOT_SW | 2
 |  |  |  |  |  |  |  | 2 | GND |  |  | KART_CHK | 3
 |  |  |  |  |  |  |  |  |  |  |  | HP_SDA | 4
 |  |  |  |  |  |  |  |  |  |  |  | HP_SCL | 5
 |  |  |  |  |  |  |  |  |  |  |  | GND | 6
 |  |  |  |  |  |  |  |  |  |  |  |  |  |  |  |  |  | CN2 |  | CN1
 |  |  |  |  |  |  |  |  |  |  |  |  |  |  |  |  |  | MX35313-3P |  | MX35313-3P
 |  |  |  |  |  |  |  |  |  |  |  |  |  |  |  |  |  | 1 | AC_L | 1 | AC_L
 |  |  |  |  |  |  |  |  |  |  |  |  |  |  |  |  |  | 2 | - | 2 | -
 |  |  |  |  |  |  |  |  |  |  |  |  |  |  |  |  |  | 3 | AC_N | 3 | AC_N
 |  |  |  |  |  |  |  |  |  |  |  |  |  |  |  |  |  | CN2
 |  |  |  |  |  |  |  |  |  |  |  |  |  |  |  |  |  | MX35313-3P
 |  |  |  |  |  |  |  |  |  |  |  |  |  |  |  |  |  | 1 | AC_L
 |  |  |  |  |  |  |  |  |  |  |  |  |  |  |  |  |  | 2 | -
 |  |  |  |  |  |  |  |  |  |  |  |  |  |  |  |  |  | 3 | AC_N
