ArvidJoung/Plasma_RF_Generator/1_Schematic/Build V1.0/RF-GEN-CPU_PinMap_20191107.xlsx

Sheet: Pin-map
Plasma_Gen_V1.0_20171227.ioc
STM32F070RBT6
Flash |  | 128 | Kbytes
SRAM |  | 16 | Kbytes
Frequency |  | 48 | MHz | max
Operating Voltage |  | 2.4 ~ 3.6 | V
Package |  | LQFP64
 |  |  | ADC | 8
 |  |  | GPIO_IN | 8
 |  |  | GPIO_OUT | 20
 |  |  | SPI | 1
 |  |  | USART1_TX | 1
PIN No |  | PIN name | Pin Function |  | RF Gen - 11/7
LQFP64 | I/O |  | Alternate | Additional | Function | GPIO | Off-page | Function
1 | S | VDD | Digital power supply |  |  |  | +3.3V
2 | TC | PC13 | - | WKUP2
3 | TC | PC14 | - | OSC32_IN |  |  | 32.768KHz
4 | TC | PC15 | - | OSC32_OUT |  |  | 32.768KHz
5 | FT | PF0 | I2C1_SDA | OSC_IN |  |  | 8MHz | 8MHz OSC
6 | FT | PF1 | I2C1_SCL | OSC_OUT |  |  | 8MHz
7 | RST | NRST | Device reset(active low) |  |  |  | NRST
8 | TTa | PC0 | - | ADC_IN10 | ADC_IN10 | No-PULL | VDC_IN_AD | +48 input Voltage monitor | Under INPUT Voltage : 40V 이하 Over INPUT Voltage : 56V 이상
9 | TTa | PC1 | - | ADC_IN11 | ADC_IN11 | No-PULL | VDC_OUT_AD | Buck output Voltage monitor | Over OUTPUT Voltage : 48V 이상
10 | TTa | PC2 | SPI2_MISO | ADC_IN12 | ADC_IN12 | No-PULL | PW_IS_AD | 과전류 상태 | PW_IS_AD : 1.81V 이상(ADC : 2246)
11 | TTa | PC3 | SPI2_MOSI | ADC_IN13 | ADC_IN13 | No-PULL | FAN_PW_AD | FAN 동작 상태 | FAN_PW_AD : 0.83V 이하(ADC : 1029)
12 | S | VSSA | Analog ground |  |  |  | GND
13 | S | VDDA | Analog power supply |  |  |  | +3.3V
14 | TTa | PA0 | USART2_CTS, USART4_TX | ADC_IN0 | ADC_IN0 | No-PULL | RV_CT_AD | Reflected Power monitor
15 | TTa | PA1 | USART2_RTS, TIM15_CH1N, USART4_RX, | ADC_IN1 | ADC_IN1 | No-PULL | FW_CT_AD | Forward Power monitor
16 | TTa | PA2 | USART2_TX, TIM15_CH1 | ADC_IN2 | ADC_IN2 | No-PULL | FET_T_AD | RF Temperature | RF Transistor Over(65℃) temp 상태
17 | TTa | PA3 | USART2_RX, TIM15_CH2 | ADC_IN3
18 | S | VSS | Ground |  |  |  | GND
19 | S | VDD | Digital power supply |  |  |  | +3.3V
20 | TTa | PA4 | SPI1_NSS, TIM14_CH1, USART2_CK,USB_NOE | ADC_IN4
21 | TTa | PA5 | SPI1_SCK | ADC_IN5
22 | TTa | PA6 | SPI1_MISO, TIM3_CH1, TIM1_BKIN, TIM16_CH1, EVENTOUT, USART3_CTS | ADC_IN6 | TIM16_CH1 | PULL-DOWN | PA6_FAN_PWM | FAN 속도 제어(25KHz) | Buck, RF FET 냉각 | FAN_PWR
23 | TTa | PA7 | SPI1_MOSI, TIM3_CH2, TIM14_CH1, TIM1_CH1N, TIM17_CH1, EVENTOUT | ADC_IN7
24 | TTa | PC4 | EVENTOUT, USART3_TX | ADC_IN14
25 | TTa | PC5 | USART3_RX | ADC_IN15, WKUP5
26 | TTa | PB0 | TIM3_CH3, TIM1_CH2N, EVENTOUT, USART3_CK | ADC_IN8 | GPIO_OUT | PULL-DOWN | DDS_SLEEP | HIGH : Power Down | DDS control
27 | TTa | PB1 | TIM3_CH4, USART3_RTS, TIM14_CH1, TIM1_CH3N | ADC_IN9 | GPIO_OUT | PULL-DOWN | DDS_RESET | HIGH : Reset
28 | FT | PB2 | - | - | GPIO_OUT | PULL-UP | DDS_FSYNC | Low Active
29 | FT | PB10 | SPI2_SCK, USART3_TX | - | I2C2_SCL | PULL-UP | DDS_CLK
30 | FT | PB11 | USART3_RX, EVENTOUT, I2C2_SDA | - | I2C2_SDA | PULL-UP | DDS_DATA
31 | S | VSS | Ground |  |  |  | GND
32 | S | VDD | Digital power supply |  |  |  | +3.3V
33 | FT | PB12 | TIM1_BKIN, TIM15_BKIN, SPI2_NSS, EVENTOUT, USART3_CK | - | GPIO_EXTI12 | PULL-UP | PB12_LIMIT_SW_A | Low Active | RF Cable detect error
34 | FTf | PB13 | SPI2_SCK, I2C2_SCL, TIM1_CH1N, USART3_CTS | - | GPIO_EXTI13 | PULL-UP | PB13_LIMIT_SW_B | Low Active | Case detect error
35 | FTf | PB14 | SPI2_MISO, I2C2_SDA, TIM1_CH2N, TIM15_CH1, USART3_RTS | - | GPIO_IN | PULL-UP | JP_BIAS |  | Not used
36 | FT | PB15 | SPI2_MOSI, TIM1_CH3N, TIM15_CH1N, TIM15_CH2 | WKUP7, RTC_REFIN
37 | FT | PC6 | TIM3_CH1 | - | TIM3_CH1 | PULL-DOWN | PC6_PW_PWM | 50KHz | Buck Vout control
38 | FT | PC7 | TIM3_CH2 | - | GPIO_OUT | PULL-DOWN | PC7_PWR_ENA | RF 48V 전원 control | PC6_PW_PWM Path On/Off control
39 | FT | PC8 | TIM3_CH3 | - | GPIO_OUT | PULL-DOWN | PC8_PRE_AMP_ENA | RF PCB의 Bias control | PWR PCB의 RF pre-amp On/Off control
40 | FT | PC9 | TIM3_CH4 | -
41 | FT | PA8 | USART1_CK, TIM1_CH1, EVENTOUT, MCO | - |  |  | PULSE_OUT1 |  | Not used
42 | FT | PA9 | USART1_TX, TIM1_CH2, TIM15_BKIN, I2C1_SCL | - | USART1_TX | n/a | USART1_TX | LCD와 통신 | LCD와 RS-232 통신
43 | FT | PA10 | USART1_RX, TIM1_CH3, TIM17_BKIN, I2C1_SDA | - | USART1_RX | n/a | USART1_RX | LCD와 통신
44 | FT | PA11 | USART1_CTS, TIM1_CH4, EVENTOUT | USB_DM |  |  | PULSE_OUT2 |  | Not used
45 | FT | PA12 | USART1_RTS, TIM1_ETR, EVENTOUT | USB_DP
46 | FT | PA13 | IR_OUT, SWDIO, USB_NOE | - |  |  | SYS_SWDIO
47 | S | VSS | Ground |  |  |  | GND
48 | S | VDD | Digital power supply |  |  |  | +3.3V
49 | FT | PA14 | USART2_TX, SWCLK | - |  |  | SYS_SWCLK
50 | FT | PA15 | SPI1_NSS, USART2_RX, USART4_RTS, EVENTOUT | -
51 | FT | PC10 | USART3_TX, USART4_TX | -
52 | FT | PC11 | USART3_RX, USART4_RX | -
53 | FT | PC12 | USART3_CK, USART4_CK | -
54 | FT | PD2 | TIM3_ETR, USART3_RTS | - | GPIO_OUT | No-PULL | PD2_GPIO_ON | Low Active | GPIO Drive IC On/Off control
55 | FT | PB3 | SPI1_SCK, EVENTOUT | - | GPIO_OUT | No-PULL | COM_LED | Low Active | LCD 통신 상태 표시
56 | FT | PB4 | SPI1_MISO, TIM17_BKIN, TIM3_CH1, EVENTOUT | - | GPIO_OUT | No-PULL | WDT_LED | Low Active | CPU watch-dog 상태 표시
57 | FT | PB5 | SPI1_MOSI, I2C1_SMBA, TIM16_BKIN, TIM3_CH2 | WKUP6 | GPIO_OUT | PULL-UP | EPROM_WP | Low Active | EEPROM write protection
58 | FTf | PB6 | I2C1_SCL, USART1_TX, TIM16_CH1N | - | GPIO_OUT | PULL-DOWN | PB6_BIAS_ON | HIGH Active | RF FET bias +9V On/Off control
59 | FTf | PB7 | I2C1_SDA, USART1_RX, USART4_CTS, TIM17_CH1N | - | I2C1_SDA | PULL-UP | I2C1_SDA |  | EEPROM I2C 통신
60 | B | BOOT0 | Boot memory selection |  |  |  | GND
61 | FTf | PB8 | I2C1_SCL, TIM16_CH1 | - | I2C1_SCL | PULL-UP | I2C1_SCL |  | EEPROM I2C 통신
62 | FTf | PB9 | SPI2_NSS, I2C1_SDA, IR_OUT, TIM17_CH1, EVENTOUT | - | GPIO_OUT | No-PULL | PLA_ON_LED | Low Active | RF ON 상태 LED
63 | S | VSS | Ground |  |  |  | GND
64 | S | VDD | Digital power supply |  |  |  | +3.3V

Sheet: TIMER
System clock set-up
 | Plasma_Gen_V1.0_20171227.ioc
 | System 관련 clock set-up 부분으로 STM32Cube에서 설정한다.
 | code 위치 : main.c의 void SystemClock_Config(void)에서 설정함
 | 1) PREDIV, PLLMUL, AHB Prescaler를 통해 SystemCoreClock을 설정한다.
 |  |  | STM32F072RB-Nucleo | new | test | old | TIM3 | Unit | Comment
 |  | HIS | 8000000 | 8000000 | 8000000 | 8000000 | 8000000 | Hz | Internal RC Frequency
 |  | PREDIV | 2 | 2 | 2 | 1 | 2
 |  | VCO input | 4000000 | 4000000 | 4000000 | 8000000 | 4000000 | Hz | PLL VCO input Frequency
 |  | PLLMUL | 12 | 12 | 12 | 6 | 12
 |  | SYSCLK | 48000000 | 48000000 | 48000000 | 48000000 | 48000000 | Hz | System Core Clock
 |  | AHB Prescaler | 1 | 1 | 1 | 1 | 1
 |  | HCLK | 48000000 | 48000000 | 48000000 | 48000000 | 48000000 | Hz
 | 2) HCLK를 APB1 Prescaler로 나눠서 PCLK1을 계산하고, APB1 Prescaler value에 따라 자동으로 설정되는 APB1 Timer scaler에 의해 APB1 Timer clock이 계산된다.
 | APB1 Timer clock이 Timer의 input clock이 된다.
 |  | APB1 Prescaler | 1 | 1 | 1 | 4 | 1
 |  | PCLK1 | 48000000 | 48000000 | 48000000 | 12000000 | 48000000 | Hz | APB1 peripheral clock
 |  | APB1 Timer scale | 1 | 1 | 1 | 2 | 1 |  | APB1 Prescaler에 의해 자동 설정되는 항목으로 cube로 source 생성시 변경되는 부분이 없는 항목임
 |  | APB1 Timer clock | 48000000 | 48000000 | 48000000 | 24000000 | 48000000 | Hz | PCLK1 x APB1 Timer scale(TIM input clock) | TIM2 input clock (TIM2CLK) is set to APB1 clock (PCLK1), since APB1 prescaler is equal to 1
TIMER Clock Set-up
 | code 위치 : tim.c의 void MX_TIM1_Init(void)에서 설정함
 | 3) Timer의 counter clock을 설정하는 부분으로 TIM counter clock를 결정하고 이에 맞는 Prescaler 값을 찾아 설정한다.
 |  | TIM counter clock | 16000000 | 16000000 | 8000000 | 16000000 | 1000000 | Hz | target value
 |  | Prescaler | 2 | 2 | 5 | 0.5 | 47 |  | (APB1 Timer clock / TIM2 counter clock) - 1
 | 4) Timer의 ouput clock을 설정하는 부분으로 위의 TIM output clock를 결정하고 이값으로 TIM counter clock을 나눠서 그에 맞는 Period 값을 계산하여 설정한다.
 |  | TIM output clock | 24000 | 80000 | 80000 | 50000 | 80000 | Hz
 |  | Period(ARR) | 665 | 199 | 99 | 319 | 11 |  | (TIM counter clock / TIM2 output clock) - 1
 |  | TIM output clock_min | 244.1 | 244.1 | 122.1 | 244.1 | 15.3 | Hz | Period가 Max 65535일때 TIM output clock frequency
 |  | TIM output clock_max | 16000000.0 | 16000000.0 | 8000000.0 | 16000000.0 | 1000000.0 | Hz | Period가 Min 0일때 TIM output clock frequency -> TIM counter clock과 동일함
 |  | Duty cycle | 50 | 50 | 50 | 60 | 50 | %
 |  | Pulse | 332 | 99 | 49 | 191 | 5 |  | Period(ARR) x duty / 100
 |  |  |  | 0.0125
 |  |  |  |  |  | 48
 |  |  |  | 0.000125 |  | 28.8
 |  |  |  | 100

Sheet: CON
CN9100
PIN | MCU | Main MCU | Function | Control MCU | Function | PIN | MCU | Main MCU | Function | Control MCU | Function
1 | 3.3V | - |  | - |  | 2 | AGND | - |  | AGND | Jumper
3 | ADCINA0 | ADCA0 | OP_IN+ | AD0_MFC0 | ADC | 4 | ADCINA1 | - |  | AD1_MFC1 | ADC
5 | ADCINA2 | ADCA2 |  | AD2_MFC2 | ADC | 6 | ADCINA3 | - |  | AD3_MFC3 | ADC
7 | ADCINA4 | ADCA4 |  | AD4_PIRANI | ADC | 8 | ADCINA5 | - |  | AD5 | ADC
9 | ADCINA6 | - |  | AD6 | ADC | 10 | ADCINA7 | - |  | AD7 | ADC
11 | ADCINB0 | - |  | - |  | 12 | ADCINB1 | - |  | -
13 | ADCINB2 | - |  | - |  | 14 | ADCINB3 | - |  | -
15 | ADCINB4 | - |  | - |  | 16 | ADCINB5 | - |  | -
17 | ADCINB6 | - |  | - |  | 18 | ADCINB7 | - |  | -
19 | 5V | 5V |  | 5V |  | 20 | GND | GND |  | GND
21 | G20 | - |  | - |  | 22 | G21 | - |  | IN0_START | GPIO_IN
23 | G34 | 4.7K PULLUP |  | 4.7K PULLUP |  | 24 | G34 | - |  | -
25 | G16 | - |  | - |  | 26 | G17 | - |  | IN1_STOP | GPIO_IN
27 | G18 | 4.7K PULLUP |  | 4.7K PULLUP |  | 28 | G19 | - |  | IN2 | GPIO_IN
29 | G29 | - |  | IN6 | GPIO_IN | 30 | G28 | - |  | IN3 | GPIO_IN
31 | G31 | - |  | IN7 | GPIO_IN | 32 | G30 | - |  | IN4 | GPIO_IN
33 | G12 | - |  | - |  | 34 | G13 | - |  | -
35 | G14 | - |  | - |  | 36 | G15 | - |  | -
37 | G32 | - |  | - |  | 38 | G33 | - |  | IN5 | GPIO_IN
39 | G18 | - |  | - |  | 40 | G19 | - |  | -
CN9200
PIN | MCU | Main MCU | Function | Control MCU | Function | PIN | MCU | Main MCU | Function | Control MCU | Function
1 | G0/EPWM1A | PWM1A | PWM+ | SPIB_CS0 | GPIO_OUT | 2 | G1 | - |  | -
3 | G2 | - |  | SPIB_CS1 | GPIO_OUT | 4 | G3 | - |  | -
5 | G4 | - |  | SPIB_CS2 | GPIO_OUT | 6 | G5 | - |  | SPIB_CS3 | GPIO_OUT
7 | G0 | - |  | - |  | 8 | G2 | - |  | -
9 | G20 | - |  | OUT0_GV0 | GPIO_OUT | 10 | G21 | - |  | -
11 | G22 | - |  | OUT1_GV1 | GPIO_OUT | 12 | G23 | - |  | -
13 | G1/EPWM1B | PWM1B | PWM- | OUT2_GV2 | GPIO_OUT | 14 | G12 | - |  | SPIB_SIMO | SPI
15 | G13 | - |  | OUT3_GV3 | GPIO_OUT | 16 | G14 | - |  | SPIB_CLK | SPI
17 | G3 | - |  | OUT4_PUMPV1 | GPIO_OUT | 18 | G5 | - |  | -
19 | G6 | - |  | OUT5_PUMPV2 | GPIO_OUT | 20 | G7 | - |  | -
21 | G8 | - |  | OUT6_PURGEV | GPIO_OUT | 22 | G9/SCITXB | SCITXB | USART1_TX | SCIB_TX | USART1_TX
23 | G10 | - |  | OUT7_VENTV | GPIO_OUT | 24 | G11/SCIRXB | SCIRXB | USART1_RX | SCIB_RX | USART1_RX
25 | G6 | - |  | - |  | 26 | G8 | - |  | -
27 | G24 | - |  | OUT8_LED_START | GPIO_OUT | 28 | G25 | - |  | OUT13 | GPIO_OUT
29 | G26 | - |  | OUT9_LED_STOP | GPIO_OUT | 30 | G27 | G27 |  | OUT14 | GPIO_OUT
31 | G7 | - |  | OUT10 | GPIO_OUT | 32 | G15 | G15 |  | OUT15 | GPIO_OUT
33 | G16 | - |  | OUT11 | GPIO_OUT | 34 | G17 | G17 | OP_OUT | -
35 | G32 | - |  | OUT12 | GPIO_OUT | 36 | G33 | - |  | -
37 | X1_XCLKIN | - |  | - |  | 38 | G4 | - |  | -
39 | XCLKOUT | - |  | - |  | 40 | /XRS | - |  | -

Sheet: JTAG
J1
PIN | ST_LINK/V2 |  | LF_GEN V1.0 |  | PIN | ST_LINK/V2 |  | LF_GEN V1.0
 | Funtion | SWD | Funtion | Off-page |  | MCU | SWD | Funtion | Off-page
1 | Target VCC | Target VCC | VCC | +3.3C | 2 | Target VCC | Target VCC | VCC | +3.3C
3 | JTAG TRST | GND(2) | GND | GND | 4 | GND | GND(3) | GND | GND
5 | JTAG TDO | GND(2) | GND | GND | 6 | GND | GND(3) | GND | GND
7 | JTAG TMS, SW IO | SWDIO | SWDIO | SYS_SWDIO | 8 | GND | GND(3) | GND | GND
9 | JTAG TCK, SW CLK | SWCLK | SWCLK | SYS_SWCLK | 10 | GND | GND(3) | GND | GND
11 | NC | NC |  |  | 12 | GND | GND(3)
13 | JTAG TDI, SWO | TRACESWO(4) |  |  | 14 | GND | GND(3)
15 | NRST | NRST |  |  | 16 | GND | GND(3)
17 | NC | NC |  |  | 18 | GND | GND(3)
19 | VDD (3.3V)(5) | NC |  |  | 20 | GND | GND(3)
Target VCC : Board의 VCC를 ST-LINK/V2와 연결한다.
GND(2) : Noise reduction용 GND
GND(3) : Power GND
TRACESWO : Optional: for Serial Wire Viewer (SWV) trace
