ArvidJoung/Plasma_RF_Generator/1_Schematic/Build V2.0/RF-GEN_Test Data_20200314.xlsx

Sheet: 0314_회사
RF Pout
CPU |  | POWER |  |  |  | Buck |  |  |  |  |  |  |  | RF
IOUT_B1 |  | IOUTB |  | RFIN |  | 9V Bias | Duty |  | OUT48V | Current |  | P |  | RFIN2 |  | RFIF |  | RFO |  | Pout
Vpp | Vrms | Vpp | Vrms | Vpp | Vrms | Vdc | % | Vdc | Vdc | Imax | Irms | W_max | W_rms | Vpp | Vrms | Vpp | Vrms | Vpp | Vrms | W
 |  |  |  |  |  | 0 | 50 | 24 | 22.3 | 8.8 | 5.41 | 196.24 | 120.643 | 23.4 | 7.55 |  |  | 224 | 74.9 | 112.2002
 |  |  |  |  |  | 0 | 60 | 28.8 | 26.7 |  |  | 0 | 0 | 23.6 | 7.6 |  |  | 256 | 86.5 | 149.645 | 37.4448
 |  |  |  |  |  | 0 | 70 | 33.6 | 32 |  |  | 0 | 0 | 23.2 | 7.56 |  |  | 292 | 97.8 | 191.2968 | 41.6518
 |  |  |  |  |  | 0 | 80 | 38.4 | 35.49 |  |  | 0 | 0 | 23.4 | 7.51 |  |  | 304 | 103 | 212.18 | 20.8832
 |  |  |  |  |  | 0 | 90 | 43.2 | 40 | 15.2 | 12.9 | 608 | 516 | 23.4 | 7.51 |  |  | 320 | 108 | 233.28 | 21.1
 |  |  |  |  |  | 0 | 99.9 | 47.952 |  | 15.2 | 14.3 | 0 | 0 | 23.2 | 7.51 |  |  | 328 | 110 | 242
 |  |  |  |  |  |  |  | 0 |  |  |  | 0 | 0 |  |  |  |  |  |  | 0
 |  |  |  |  |  |  |  | 0 |  |  |  | 0 | 0 |  |  |  |  |  |  | 0
 |  |  |  |  |  |  |  | 0 |  |  |  | 0 | 0 |  |  |  |  |  |  | 0
Buck review
Duty | Rising | 초기 peak
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
