ArvidJoung/Plasma_RF_Generator/1_Schematic/Build V2.0/RF-GEN_Test Data_20200329.xlsx

 |  |  | Buck | RFIN
CPU | POWER | RF | duty | Vpp | Vrms | Vrms | P
#04 | #04 | #06 | 80% | 202 | 71.41 | 67.9 | 92.2 | FAIL
#04 | #04 | #02 | 80% | 250 | 88.38 | 85.3 | 145.5
 |  | #03 | 80% | 257 | 90.85 | 88.3 | 155.9
 |  | #04 | 80% | 254 | 89.79 | 86.3 | 149.0
 |  | #05 | 80% | 244 | 86.25 | 82.9 | 137.4
#06 | #06 | #05 | 80% | 238 | 84.13 | 81.0 | 131.2
#01 | #02 | #05 | 80% | 244 | 86.25 | 83.0 | 137.8
 |  | #05 | 50% | 157 | 55.50 | 51.6 | 53.3
#01 | #02 | #01 | 50% | 280 | 98.98 | 95.0 | 180.5
#01 | #02 | #01 | 70% | 344 | 121.60 | 118.0 | 278.5
 |  | #05 | 70% | 356 | 125.85 | 122.0 | 297.7 | R25,R26 : 49.9 -> L4148, R24, R7, R6, R27 NC
 |  |  |  |  |  | 114.0 | 259.9
