ArvidJoung/Plasma_RF_Generator/1_Schematic/Build V2.0/MICRO-WAVE_Test Data_20200327.xlsx

Sheet: 0327_Initial
DC48V | 9V | RFINA |  |  | RFIN |  |  | GT1 |  |  | GT2 |  |  | FLTIN |  |  |  | RFO |  |  |  | FWIN |  | FWO |  | RVIN |  | RVO
 |  | Vpp | Vrms | Vrms | Vpp | Vrms | Vrms | Vpp | Vrms | Vrms | Vpp | Vrms | Vrms | Vpp | Vrms | Vrms | P | Vpp | Vrms | Vrms | P | Vpp | Vrms | Vpp | Vrms | Vpp | Vrms | Vpp | Vrms
0 | OFF | 22.20 | 7.85 | 8.08 | 21.6 | 7.64 | 7.16 | 11.2 | 3.96 | 5.61 | 12.00 | 4.24 | 5.79
22.9 | OFF | 22.40 | 7.92 | 8.11 | 22.8 | 8.06 | 7.01 | 13.2 | 4.67 | 5.82 | 11.80 | 4.17 | 5.92 | 298 | 105.34 | 103 | 212.18 | 238 | 84.13 | 79.1 | 125.1362
 |  |  | 0.00 |  |  | 0.00 |  |  | 0.00 |  |  | 0.00 |  |  | 0.00 |  | 0 |  | 0.00 |  | 0
 |  |  | 0.00 |  |  | 0.00 |  |  | 0.00 |  |  | 0.00 |  |  | 0.00 |  | 0 |  | 0.00 |  | 0
 |  |  | 0.00 |  |  | 0.00 |  |  | 0.00 |  |  | 0.00 |  |  | 0.00 |  | 0 |  | 0.00 |  | 0
 |  |  | 0.00 |  |  | 0.00 |  |  | 0.00 |  |  | 0.00 |  |  | 0.00 |  | 0 |  | 0.00 |  | 0
 |  |  | 0.00 |  |  | 0.00 |  |  | 0.00 |  |  | 0.00 |  |  | 0.00 |  | 0 |  | 0.00 |  | 0
 |  |  | 0.00 |  |  | 0.00 |  |  | 0.00 |  |  | 0.00 |  |  | 0.00 |  | 0 |  | 0.00 |  | 0
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
