ArvidJoung/Plasma_RF_Generator/1_Schematic/Build V2.0/RF-GEN-Path tune data_20200127.xlsx

Sheet: Path Gain
 |  | CPU |  |  | POWER
 |  | DDS : U3 | OP-AMP : U4 |  | OP-AMP : U1
 |  |  | R21 | 4.99 | R4 | 680
 |  |  | R20 | 1 | R5 | 680
 |  |  | Gain | 5.99 | Gain | 2
계산치 | Vpp | 0.6 | 3.594 |  | 7.188
 | Vrms | 0.21 | 1.27 |  | 2.54
Measure AD8051 | Vpp |  | 2.76 |  | 5.52 |  | Vrms | 1.27 | 0.5
 | Vrms |  | 0.94 |  | 1.95 |  | R | 10000 | 50
Measure LT1210 | Vpp |  | 2.84 |  | 6.12 |  | P | 0.00016129 | 0.005
 | Vrms |  | 0.95 |  | 2.09

Sheet: AD8051
 |  | Vcc=5V |  |  |  |  |  |  |  |  | Source | Vin[V] - C17 |  | Vout[V] - RF_QR |  | Gain
 | C17 | R31 | R32 | R34[KΩ] | R33[KΩ] | Gain | C19 | C20 | R35 | R36 | Vpp | Vpp | Vrms | Vpp | Vrms | Vpp | Vrms
Origin | 100nF | 2.7K | 2.7K | 4.99 | 1 | 5.99 | 1uF | 100nF | 0 | 10K | 0.6 | 0.52 | 0.16 | 2.64 | 0.9 | 5.1 | 5.6
 |  |  |  |  |  |  | 0 | 0 | 0 | 10K | 0.6 |  |  | 12 | 12 |  |  | AMP feedback path에 Cap 필요 - Cap이 없는 경우 Vin의 DC 2.5V가 증폭되어 12V sturation됨.
 |  |  |  |  |  |  |  |  | 49.9 | 49.9 | 0.6 | 0.52 | 0.158 | 1.24 | 0.4 | 2.4 | 2.5
 |  |  |  |  |  |  |  |  | 0 | NC | 0.6 | 0.52 | 0.158 | 2.6 | 0.889 | 5.0 | 5.6
 |  |  |  |  |  |  |  | 1nF |  |  | 0.6 | 0.52 | 0.158 | 2.64 | 0.907 | 5.1 | 5.7
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
