ArvidJoung/Plasma_RF_Generator/1_Schematic/Build V2.0/03_RF-GEN-RF-001/RF-GEN_RF_V2.0_SCH_20191209.pdf

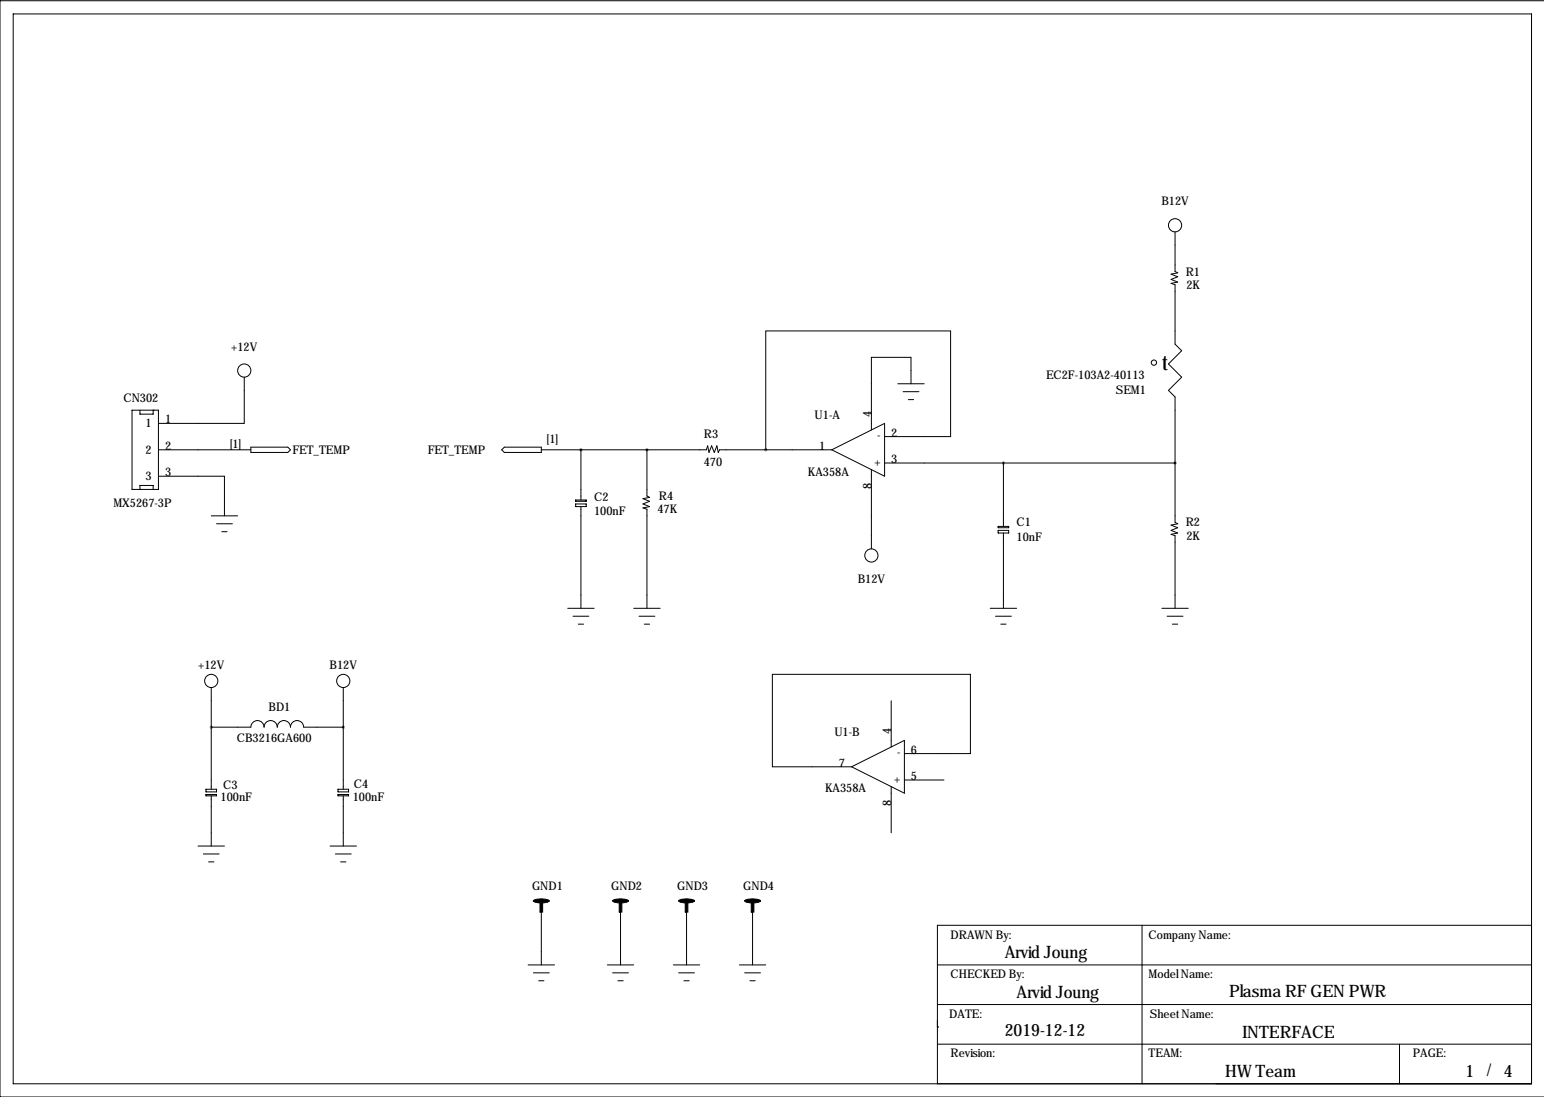
[picture p112: page 1]

Plasma RF GEN PWR

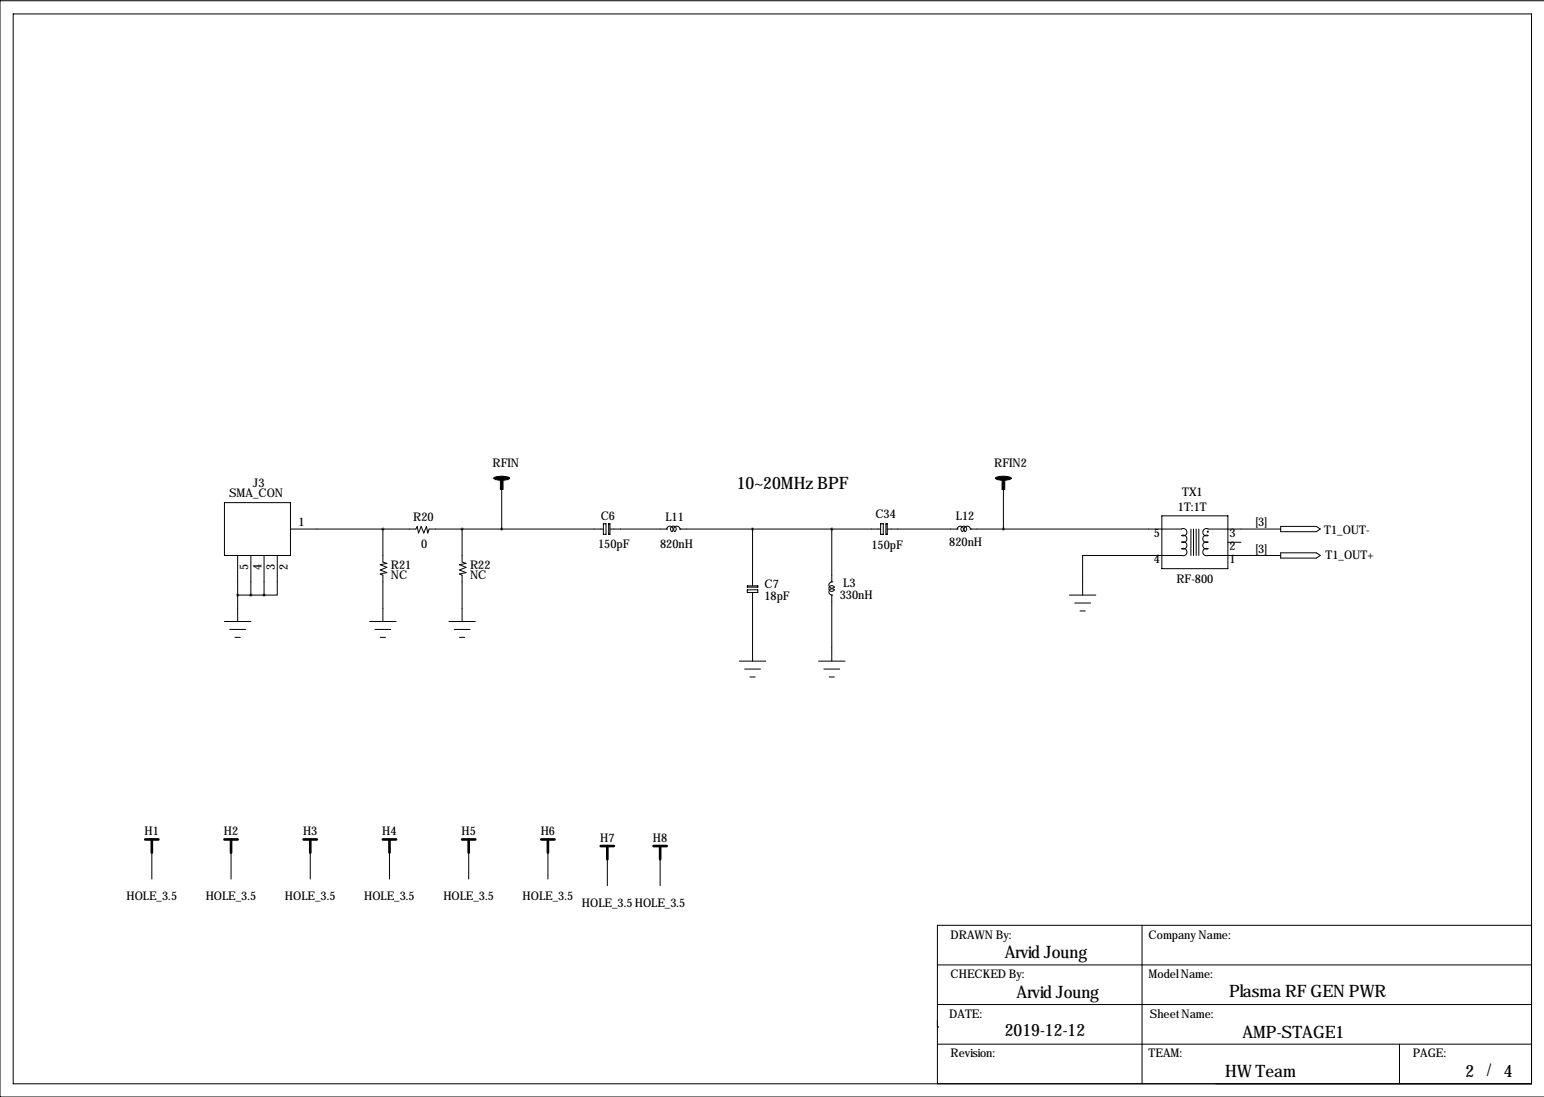
[picture p113: page 2]

Plasma RF GEN PWR

## BUCK 48V OUTPUT

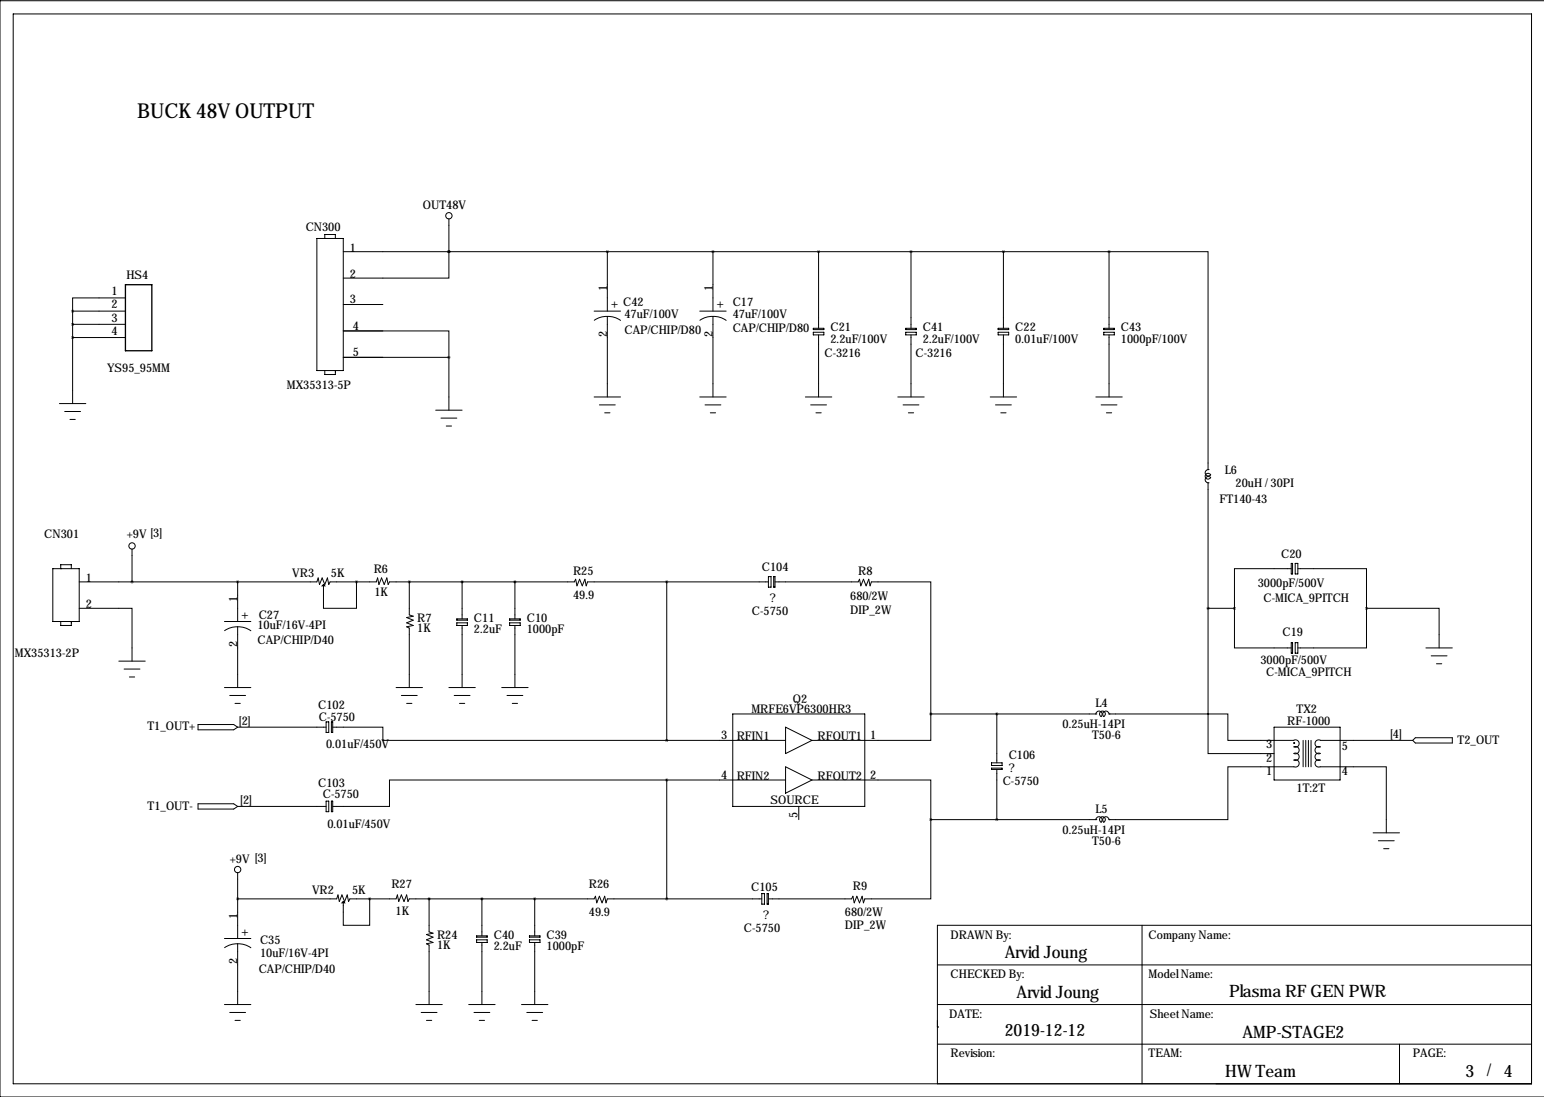
[picture p114: page 3]

Plasma RF GEN PWR

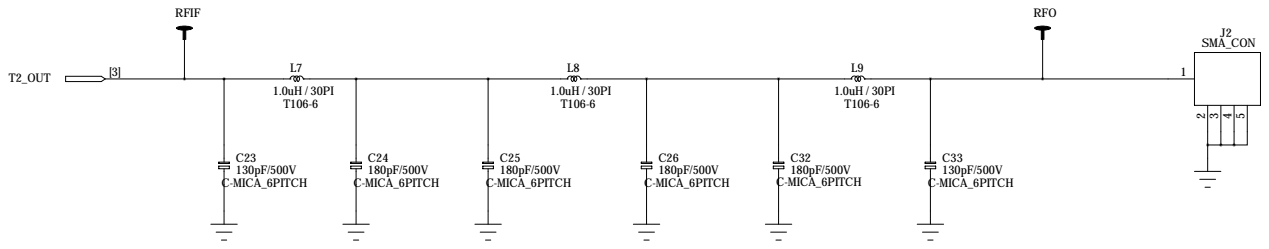
[picture p115: page 4]

Plasma RF GEN PWR
