ArvidJoung/Plasma_RF_Generator/1_Schematic/Build V2.0/02_RF-GEN-PWR-001/RF-GEN_PWR_V1.0_SCH_20191128.pdf

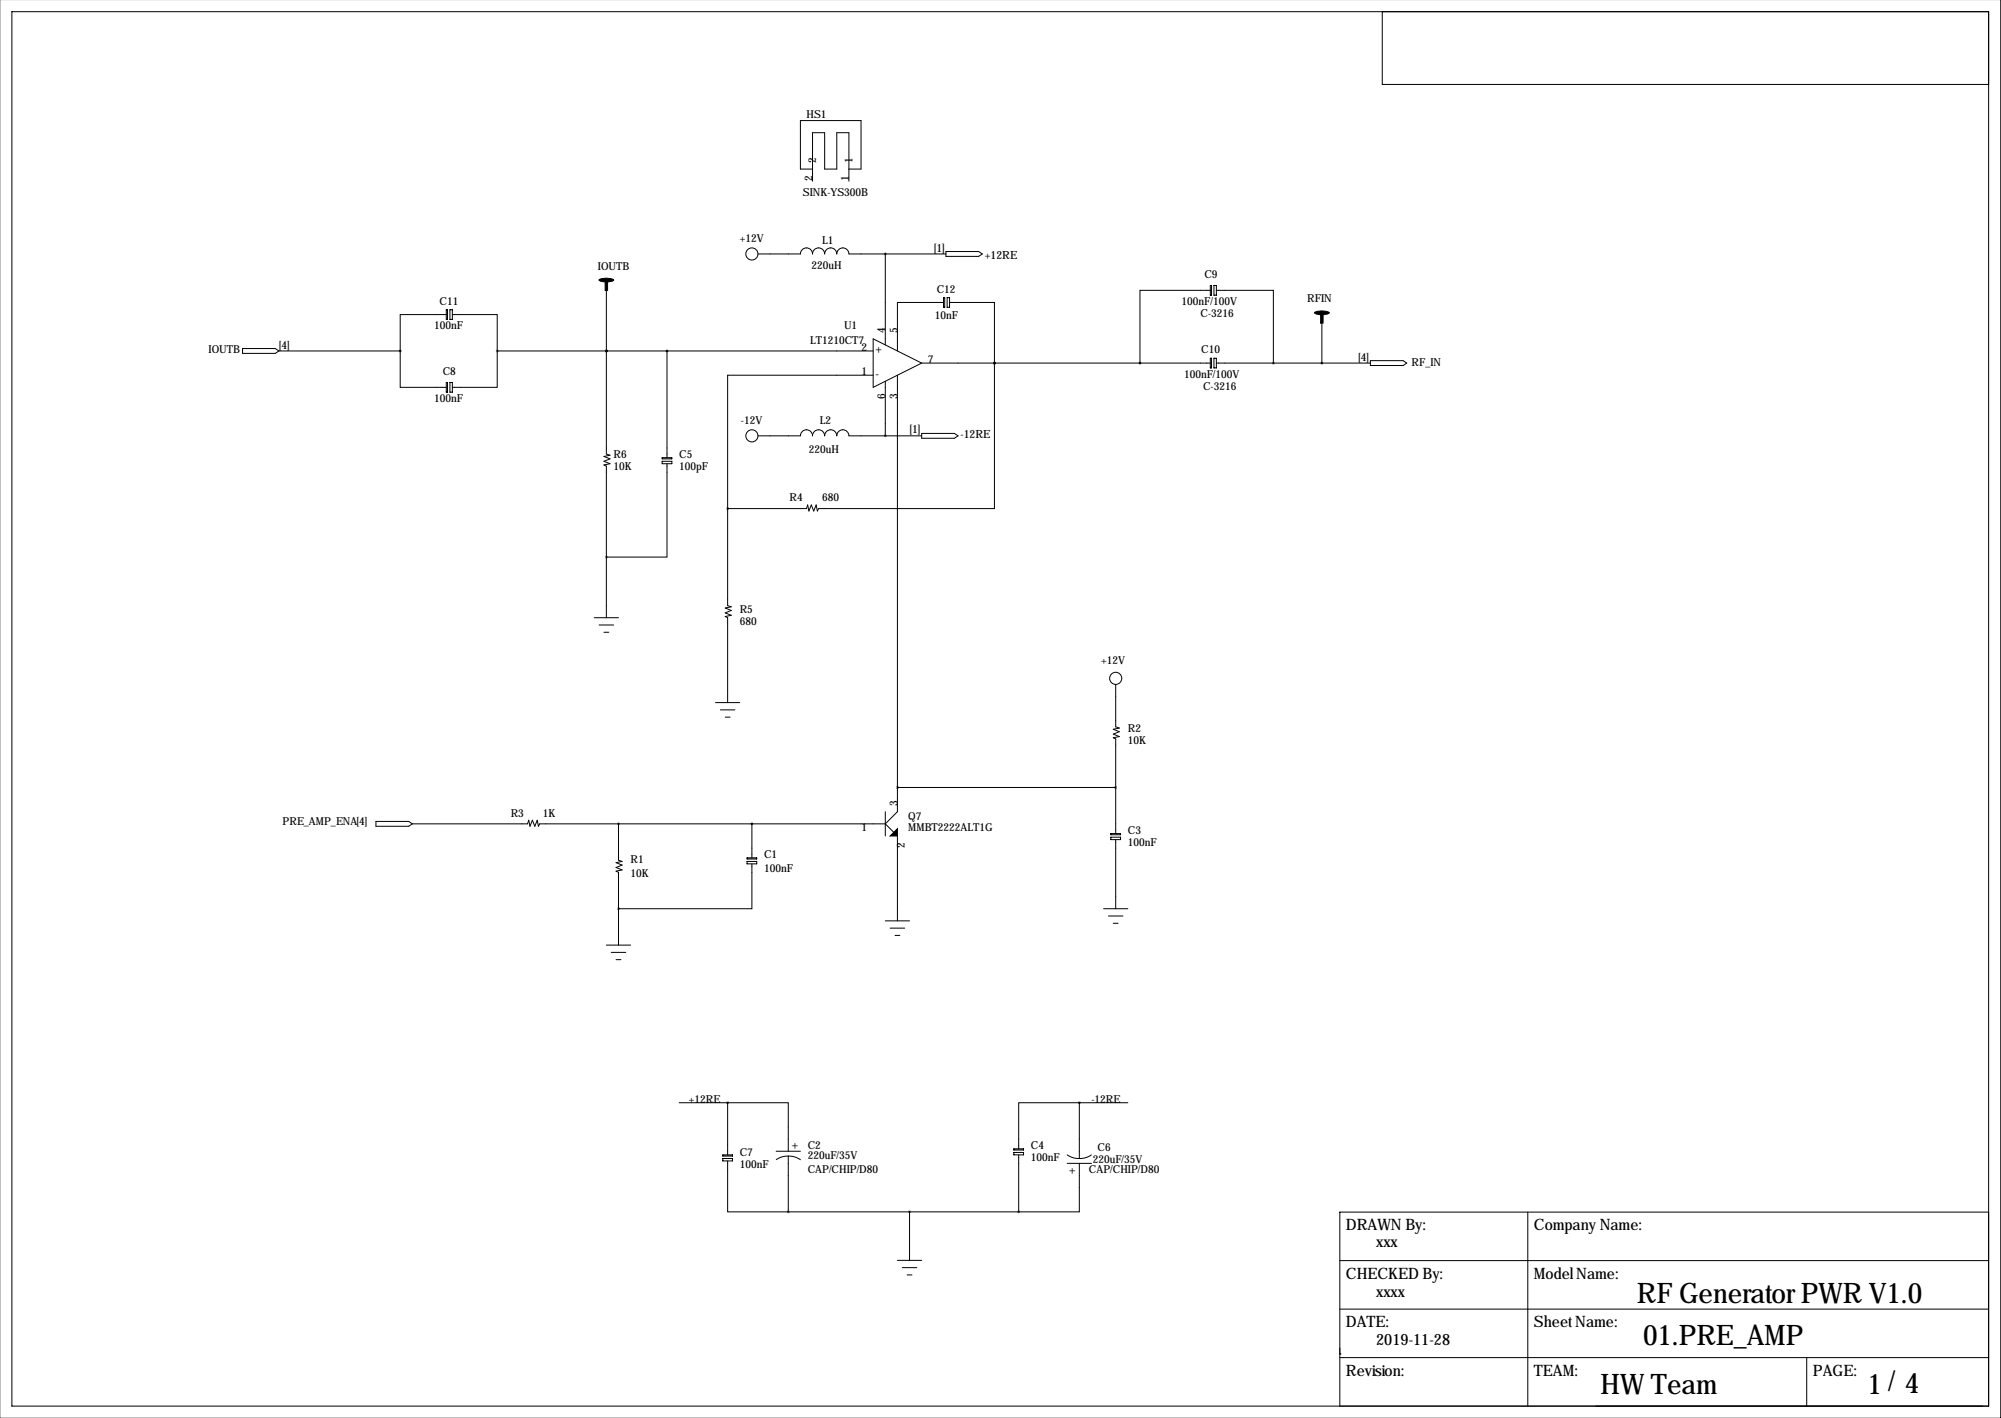
[picture p116: page 1]

## -12V Ãâ·Â

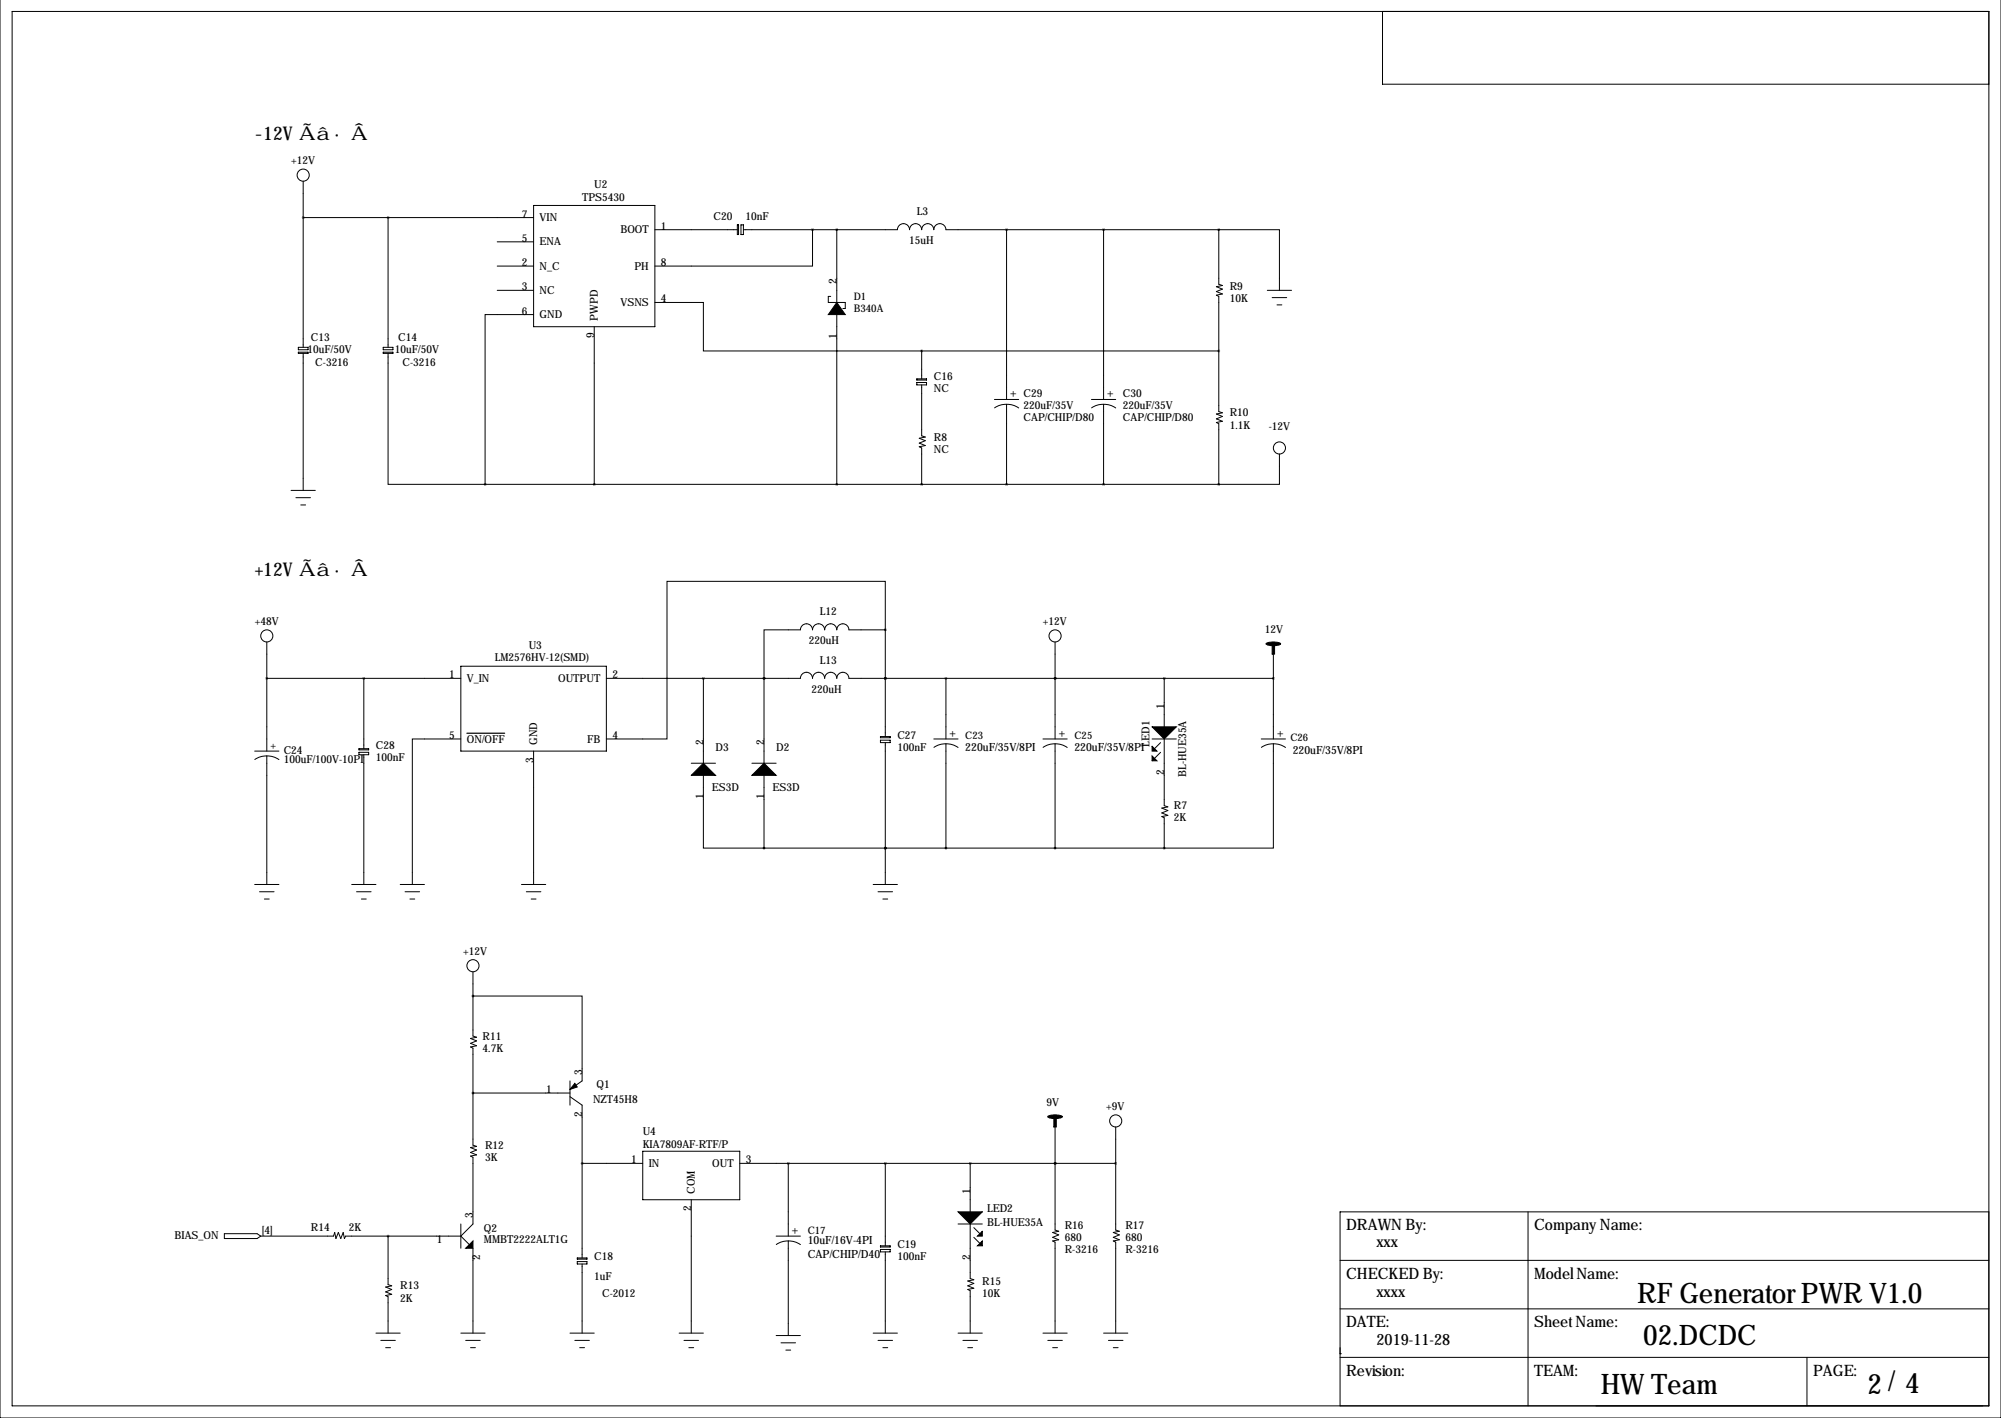
[picture p117: page 2]

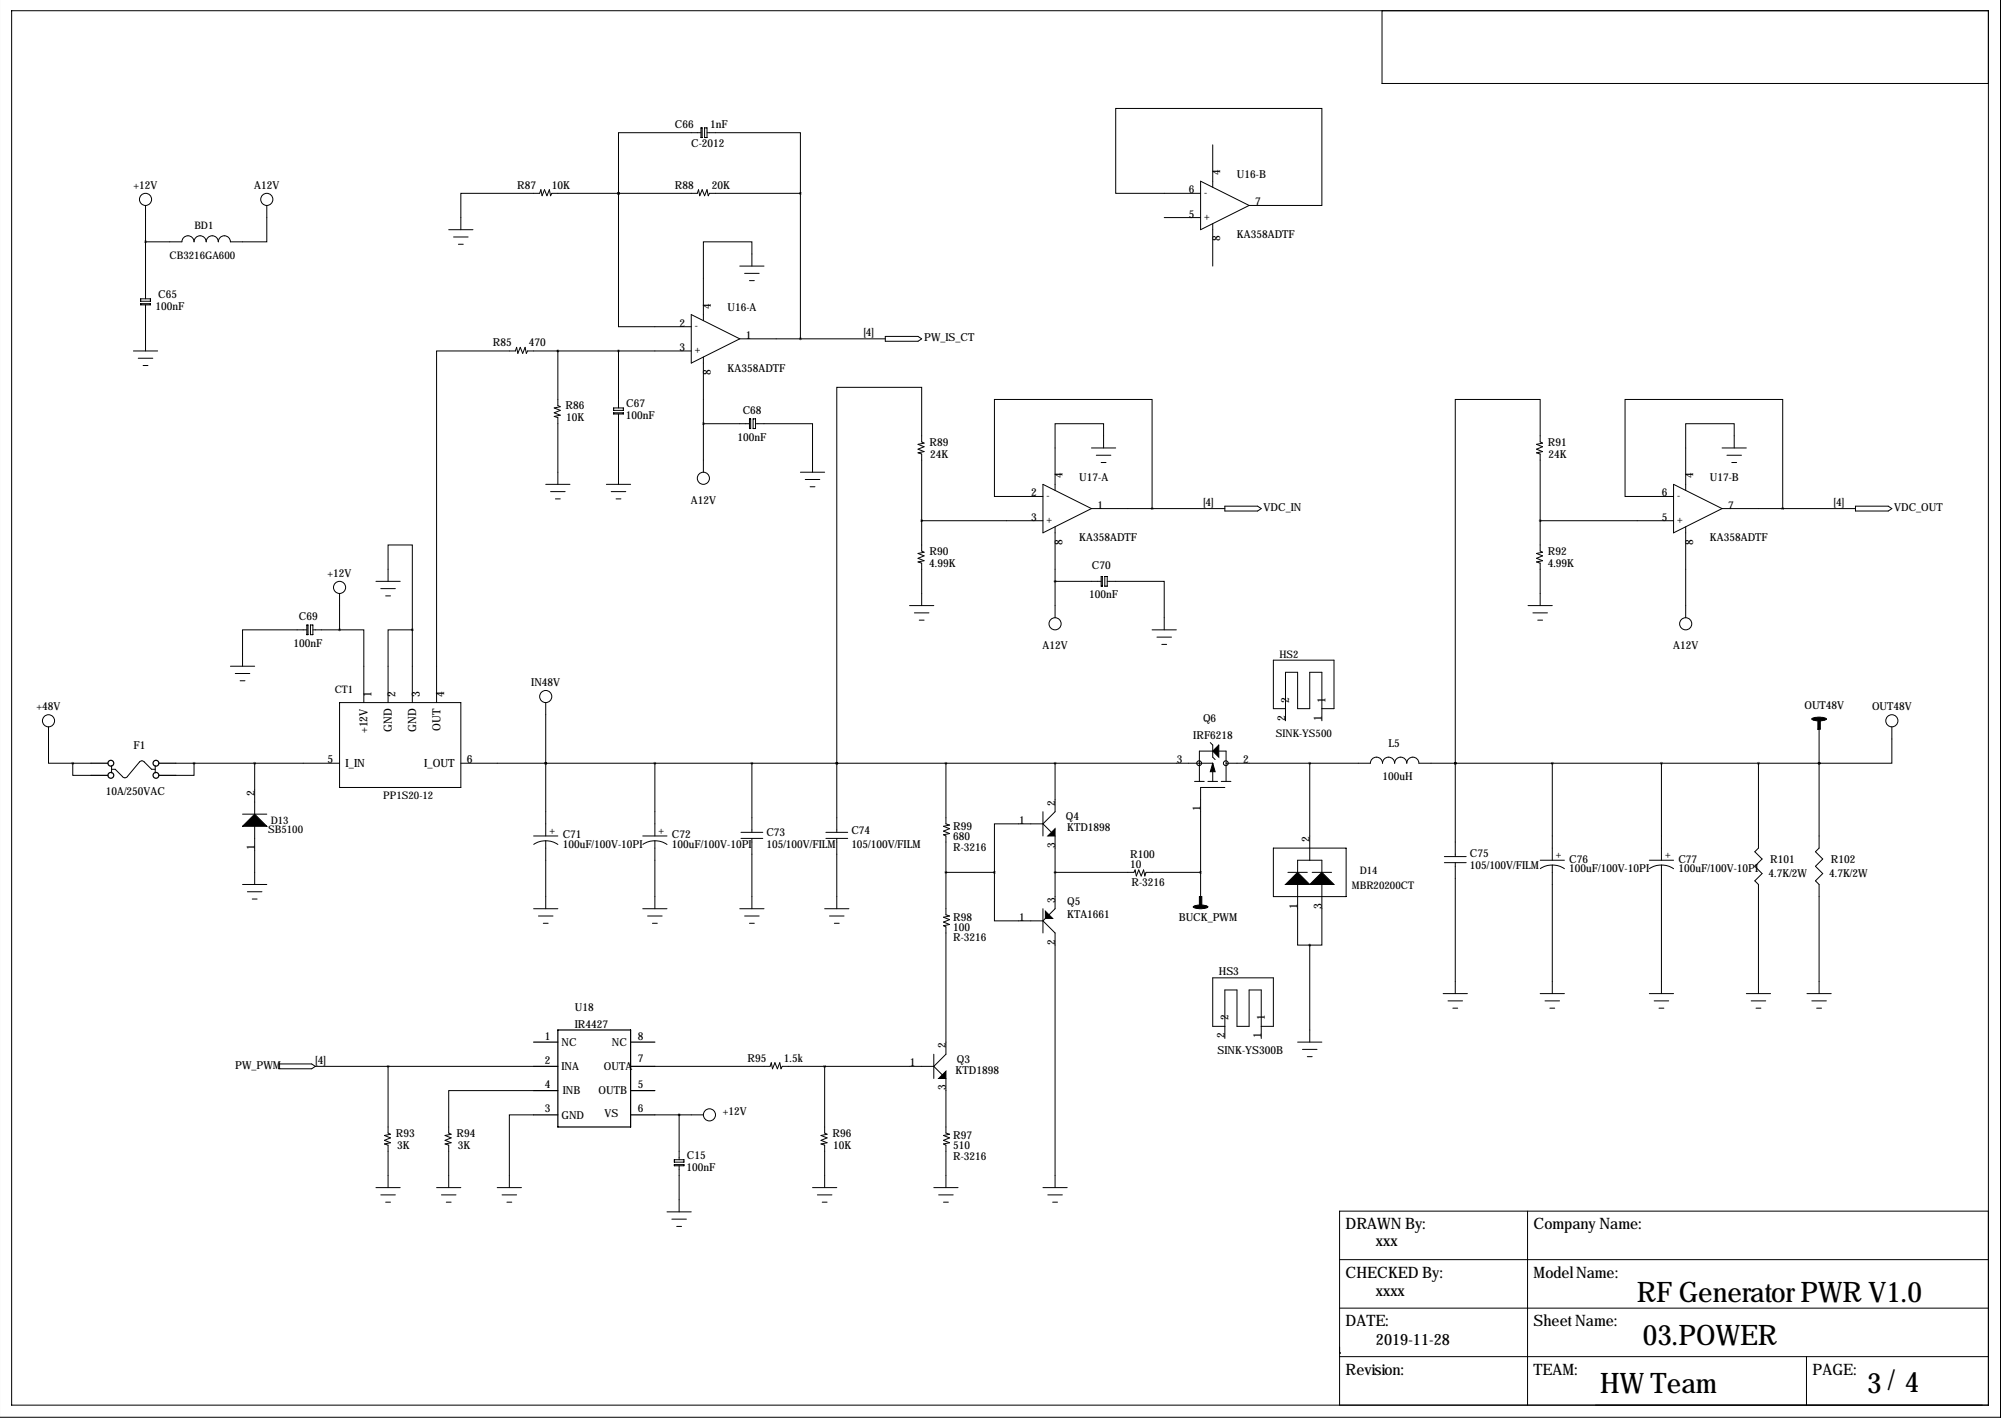
[picture p118: page 3]

## BUCK 48V OUTPUT

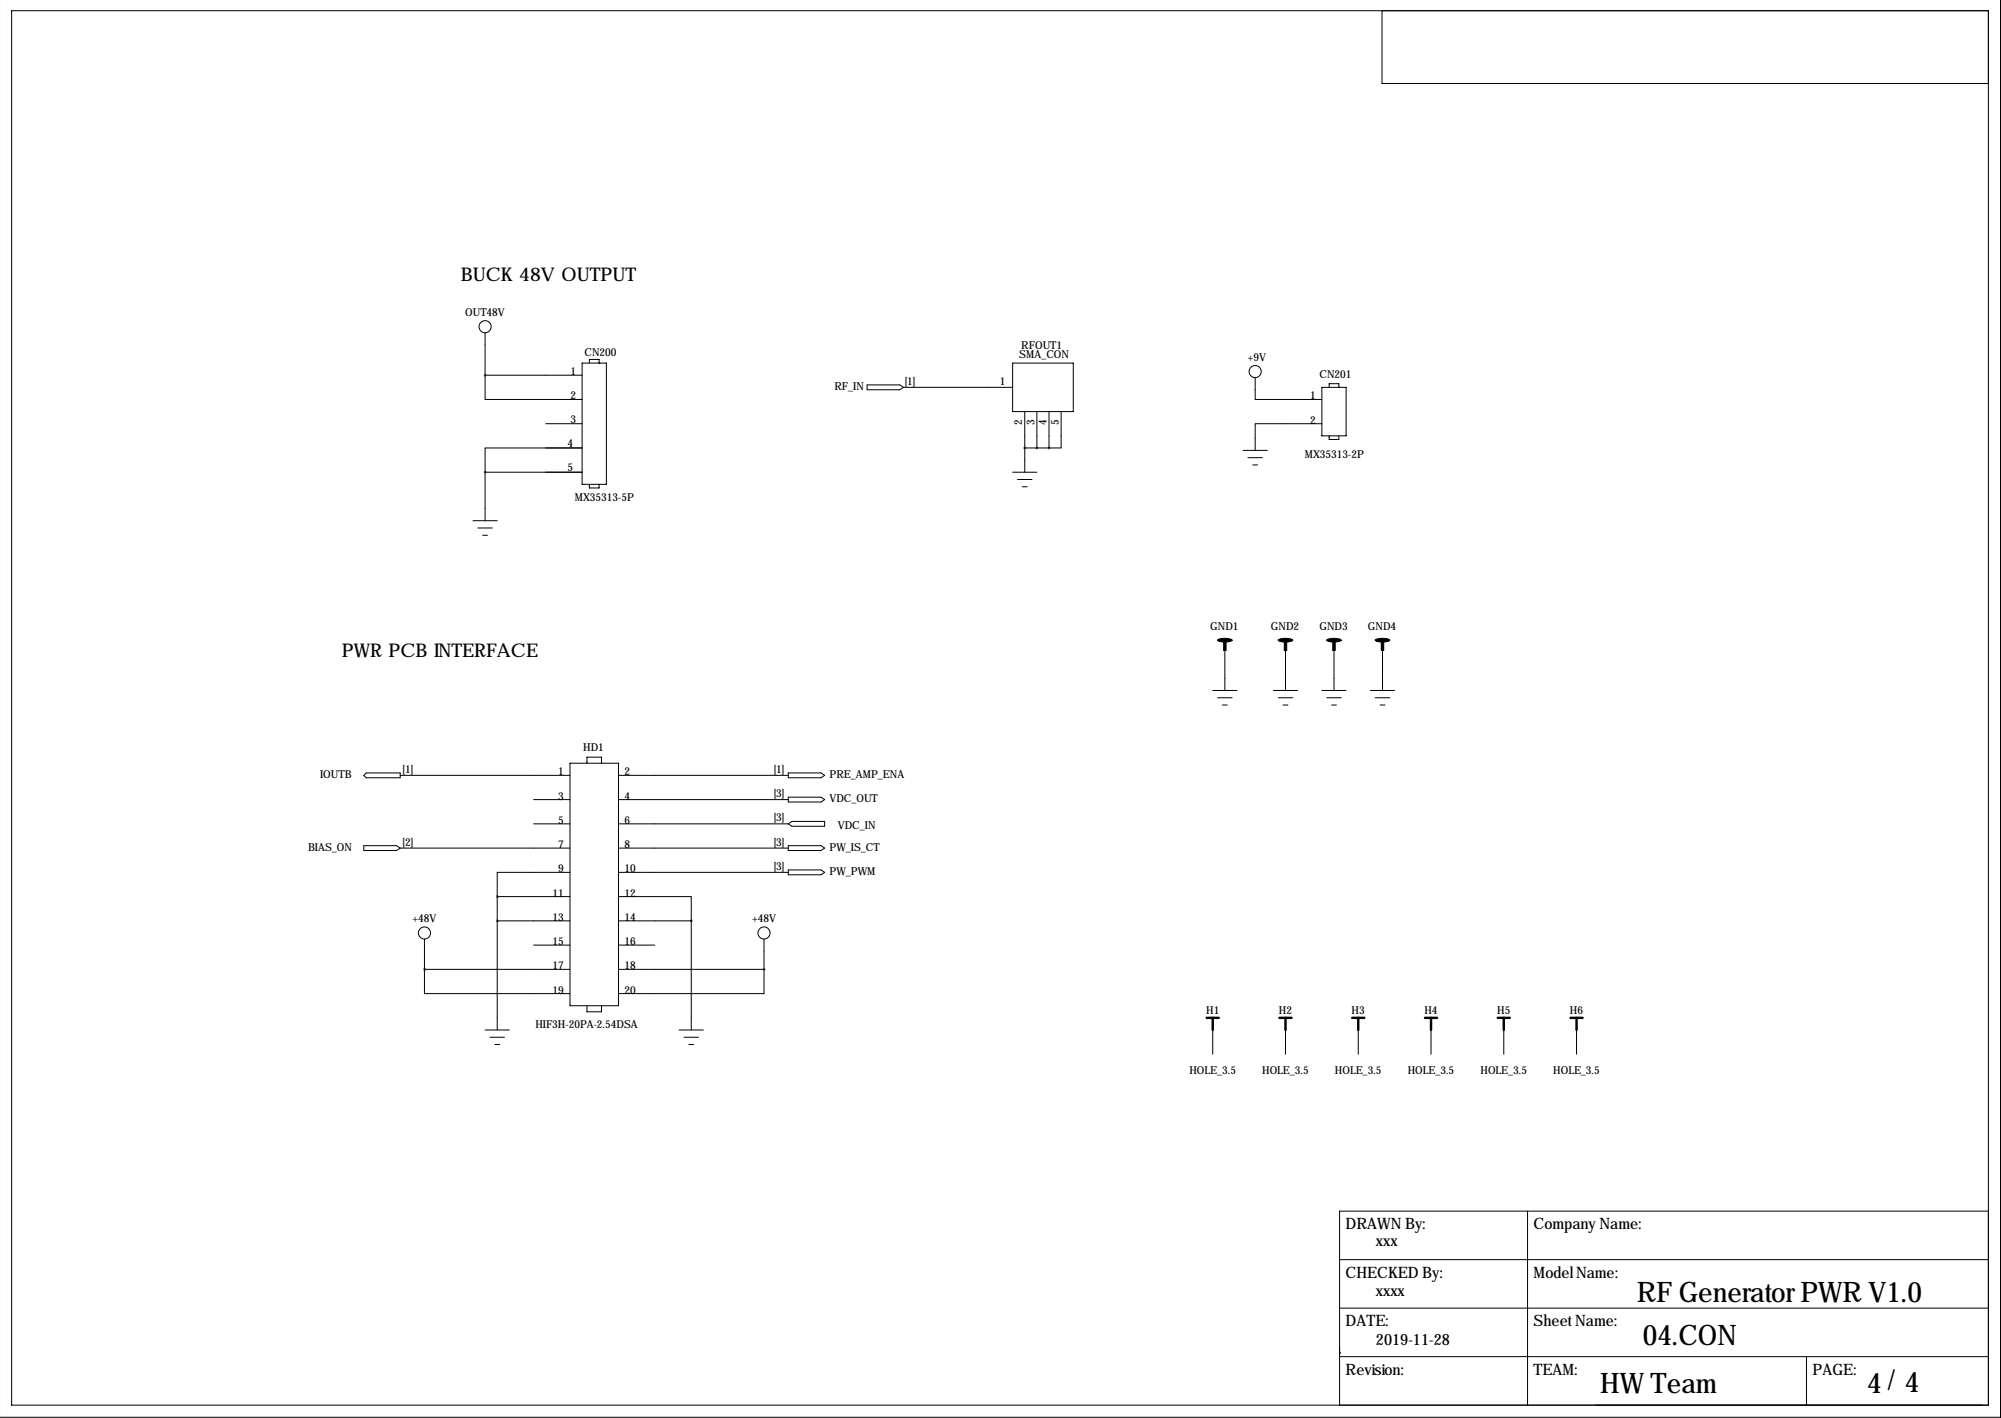
[picture p119: page 4]
DRAWN By: xxx; Company Name:; Model Name:; CHECKED By: xxxx; RFOUT1 SMA_CON; HIF3H-20PA-2.54DSA; HOLE_3.5; GND1; GND2; GND3; GND4; OUT48V; VDC_IN [3]; IOUTB; PRE_AMP_ENA [1]; BIAS_ON; VDC_OUT [3]; PW_PWM [3]

PWR PCB INTERFACE

RF Generator PWR V1.0
04.CON
