ArvidJoung/Plasma_RF_Generator/1_Schematic/Build V2.0/01_RF-GEN-CPU-001/RF-GEN_CPU_V1.0_SCH_20191117.pdf

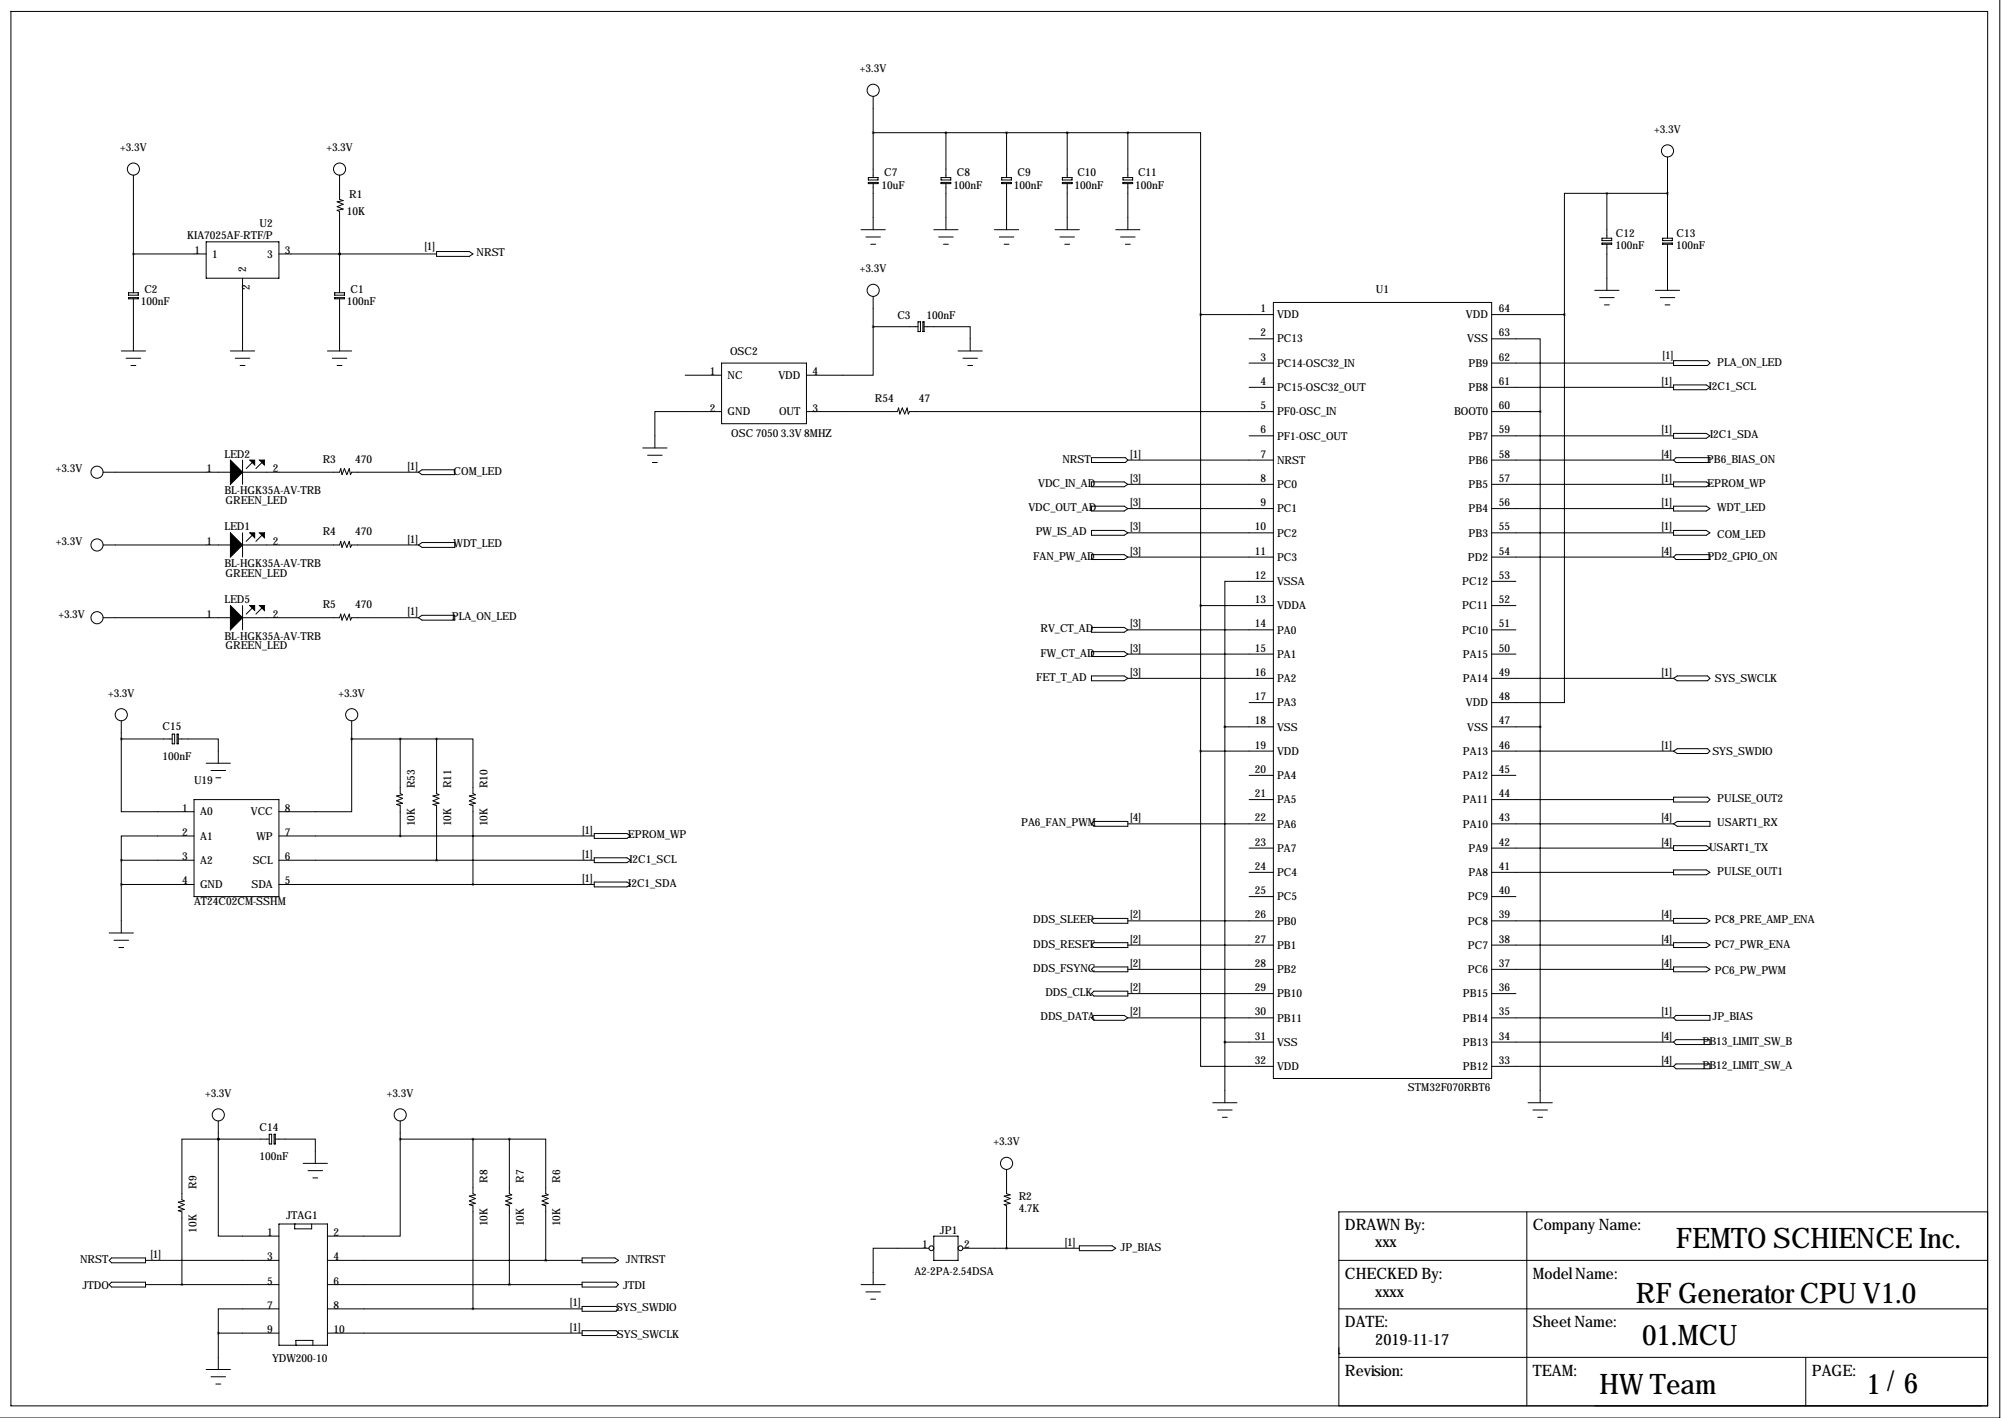
[picture p120: page 1]

2 3 4 5 | 63 VSS

6 7 | 59 PB7 58 PB6 57 PB5 56 PB4 55 PB3 54 PD2 53 PC12 52 PC11 51 PC10 50 PA15 49 PA14 48 VDD

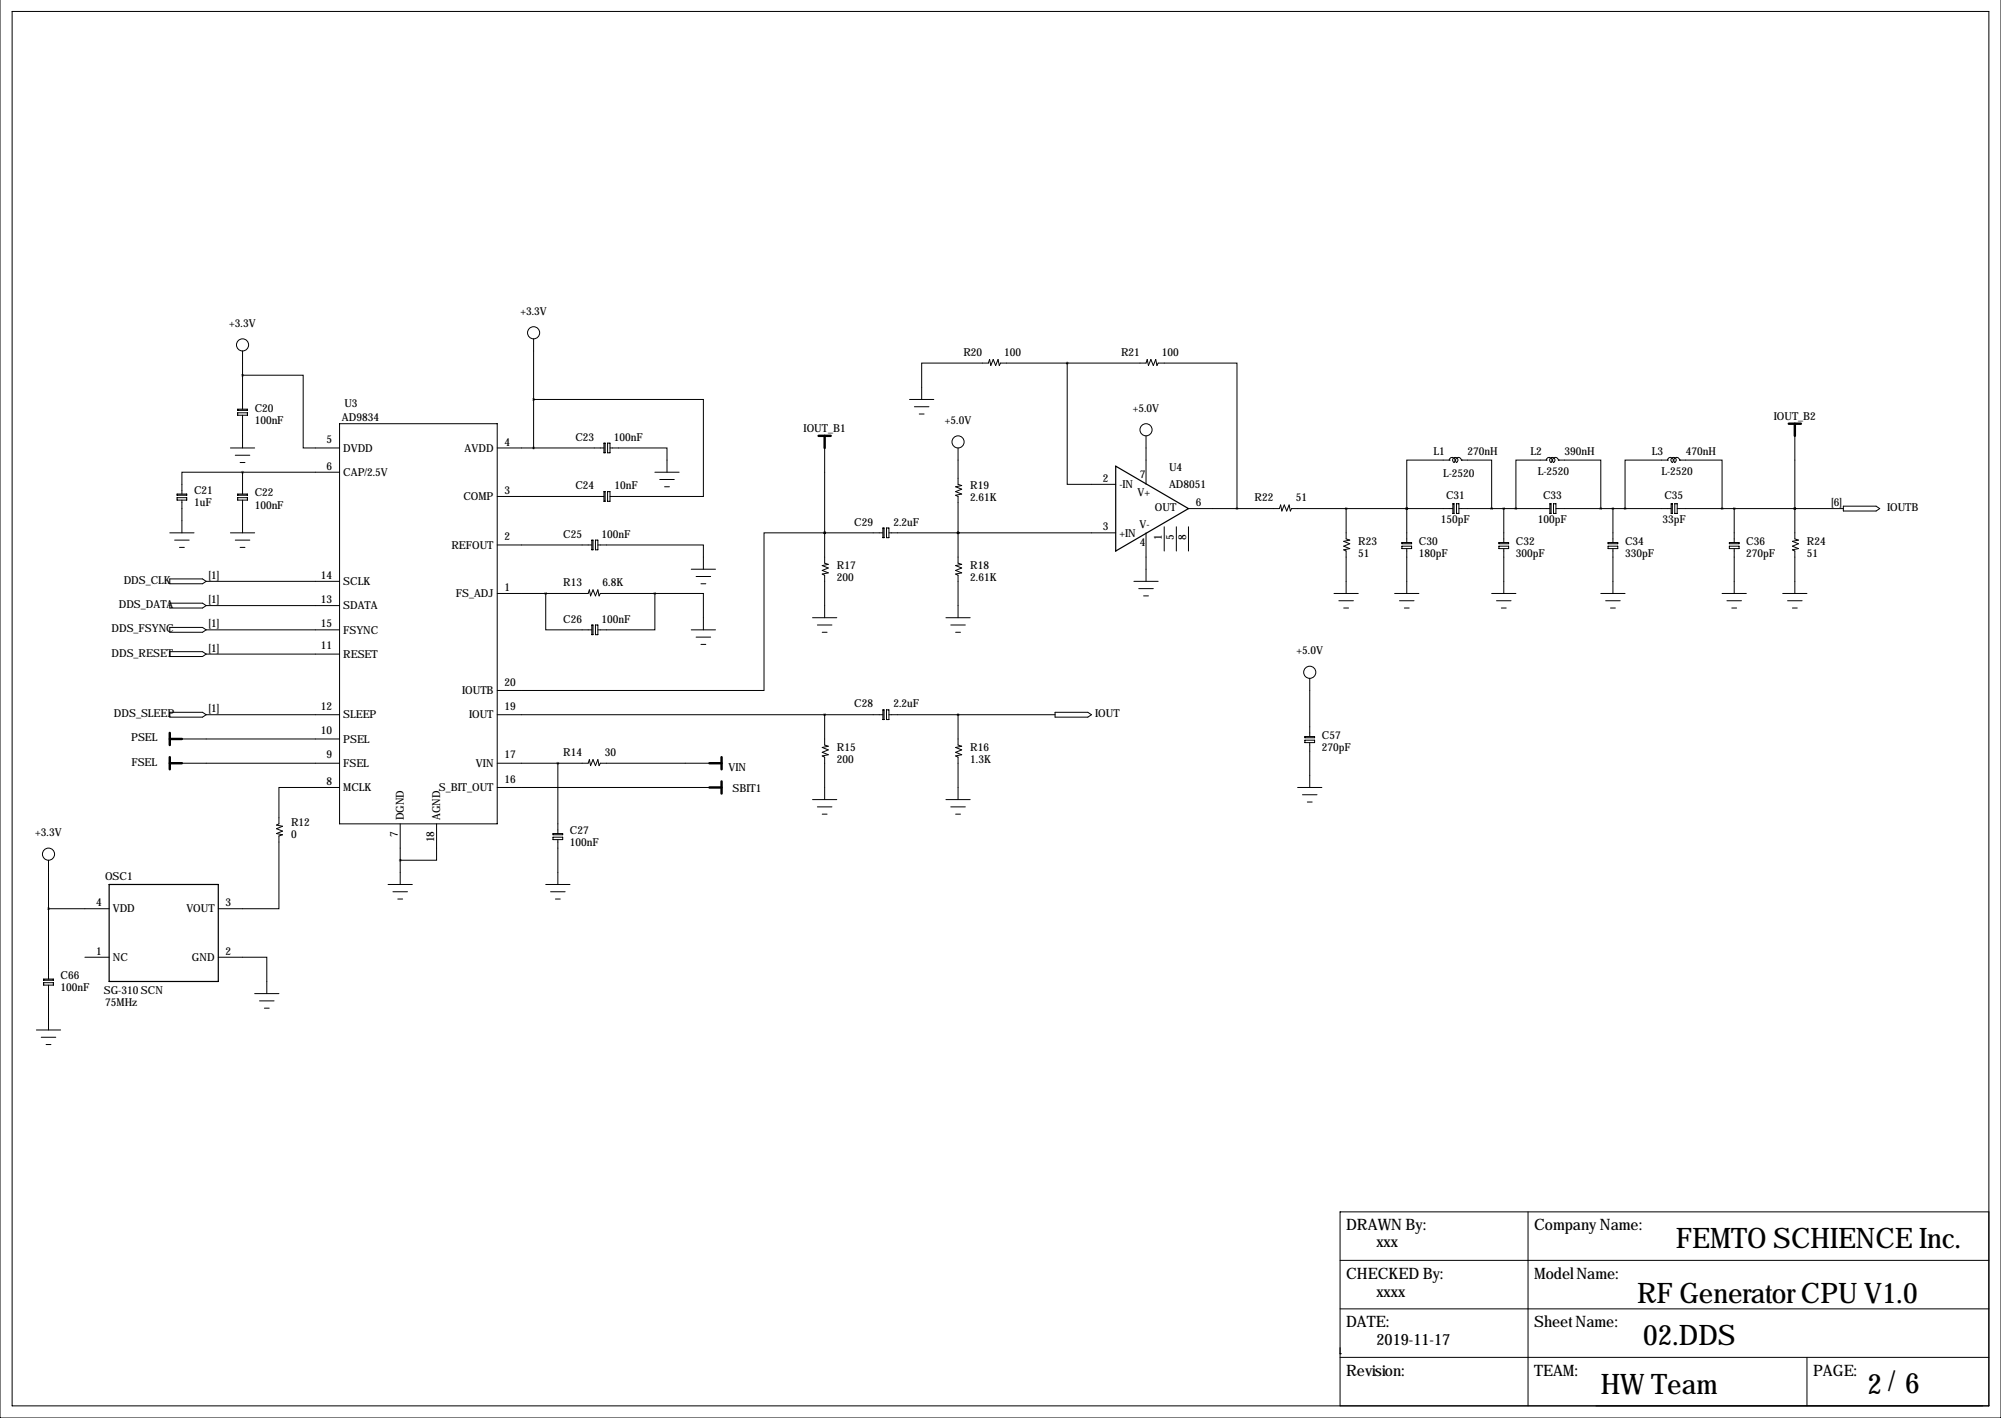
[picture p121: page 2]

+-

# SD05C.TCT ²

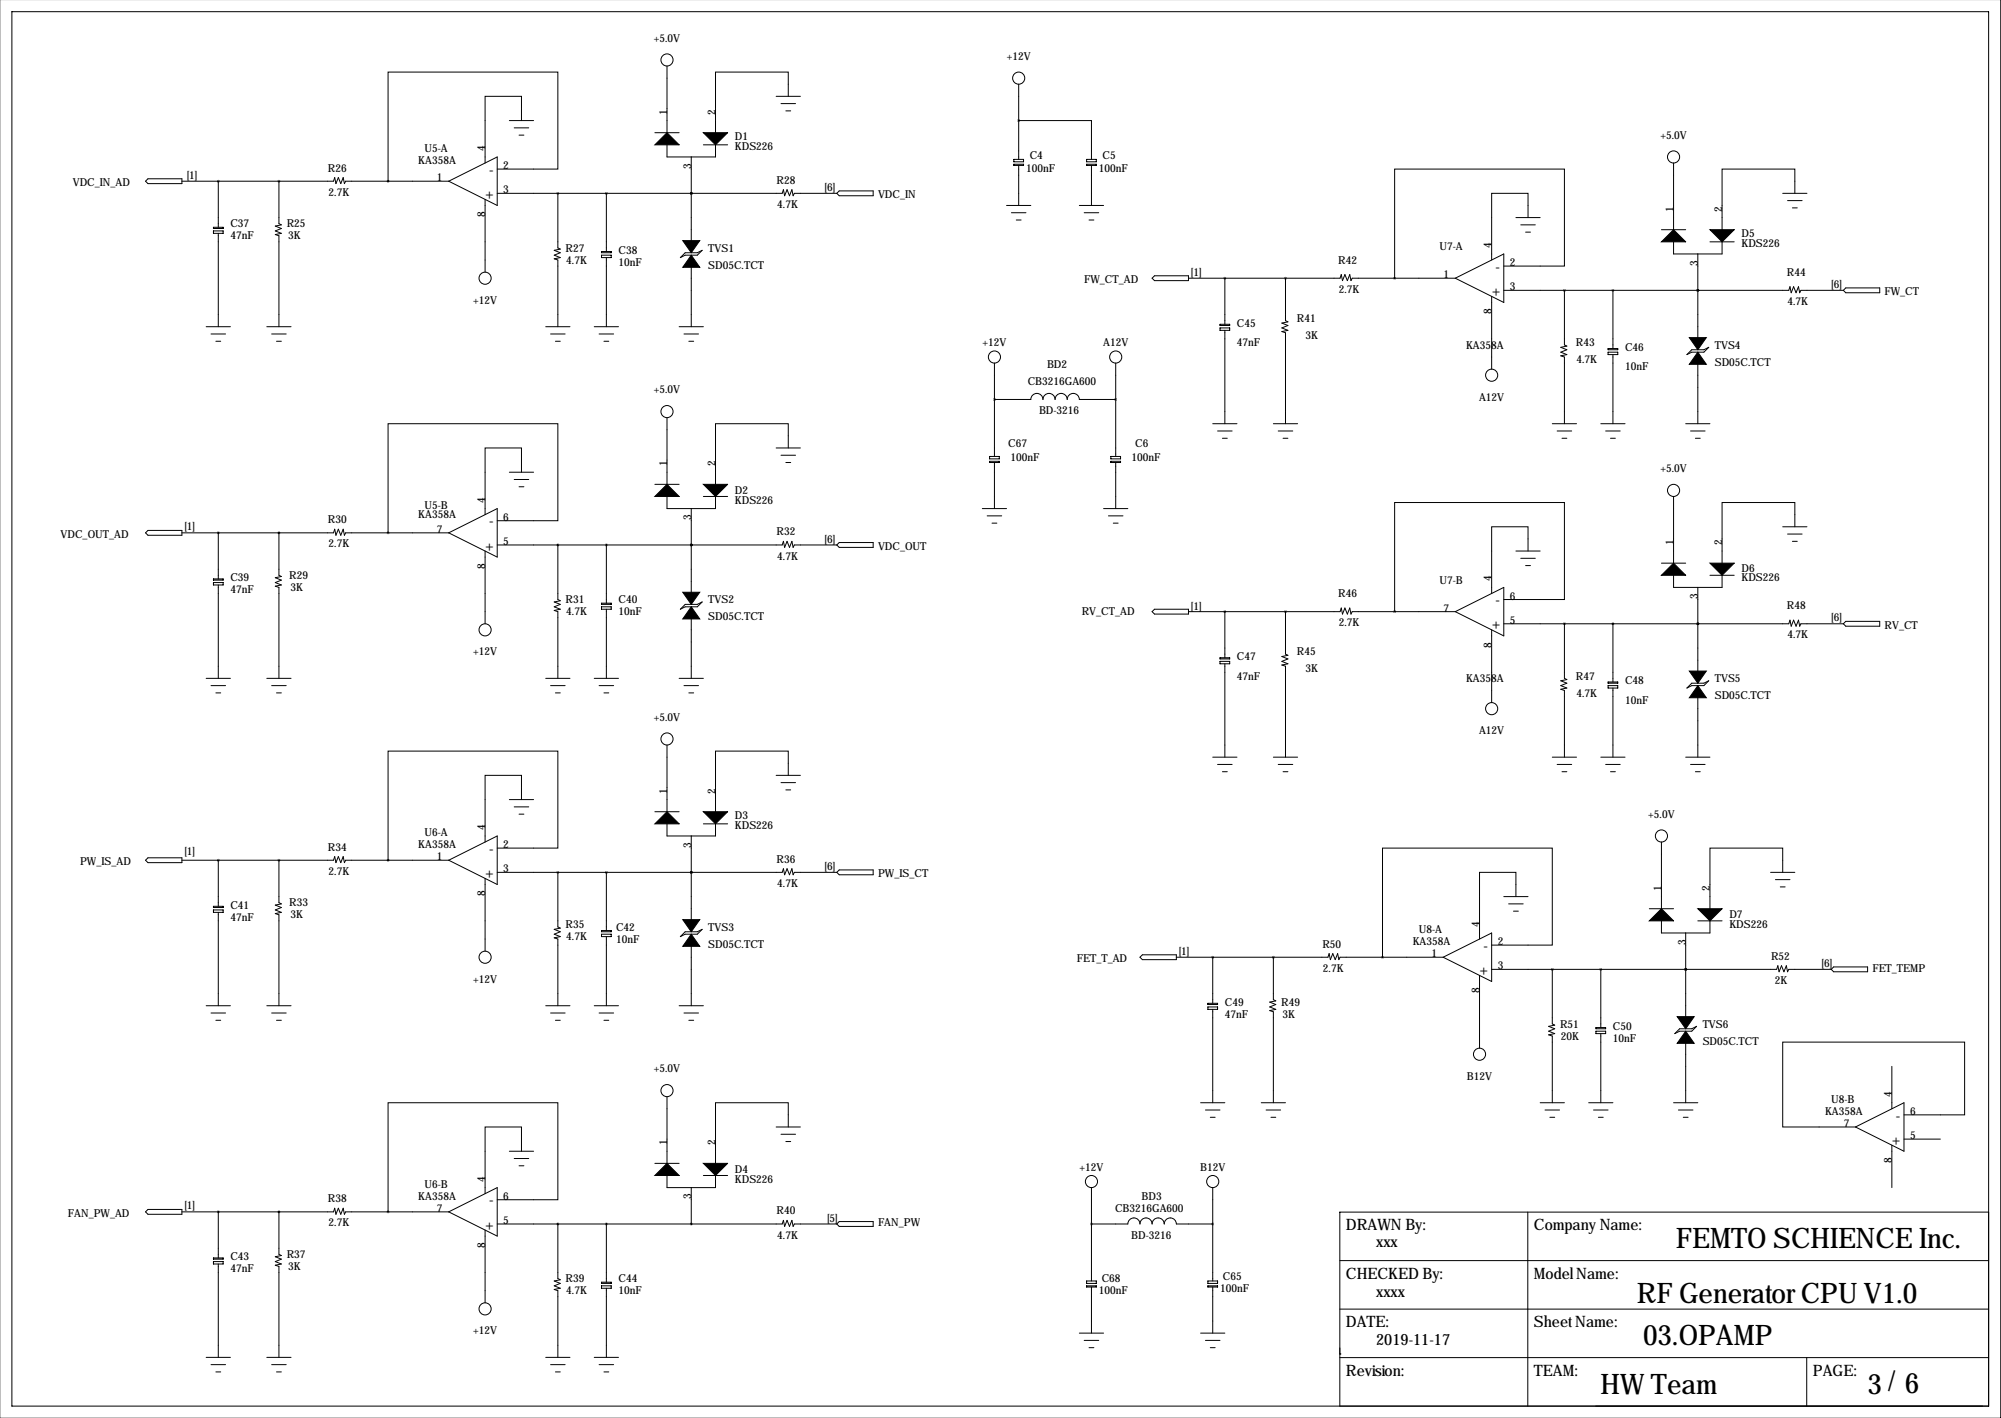
[picture p122: page 3]

## UART Thru Interface

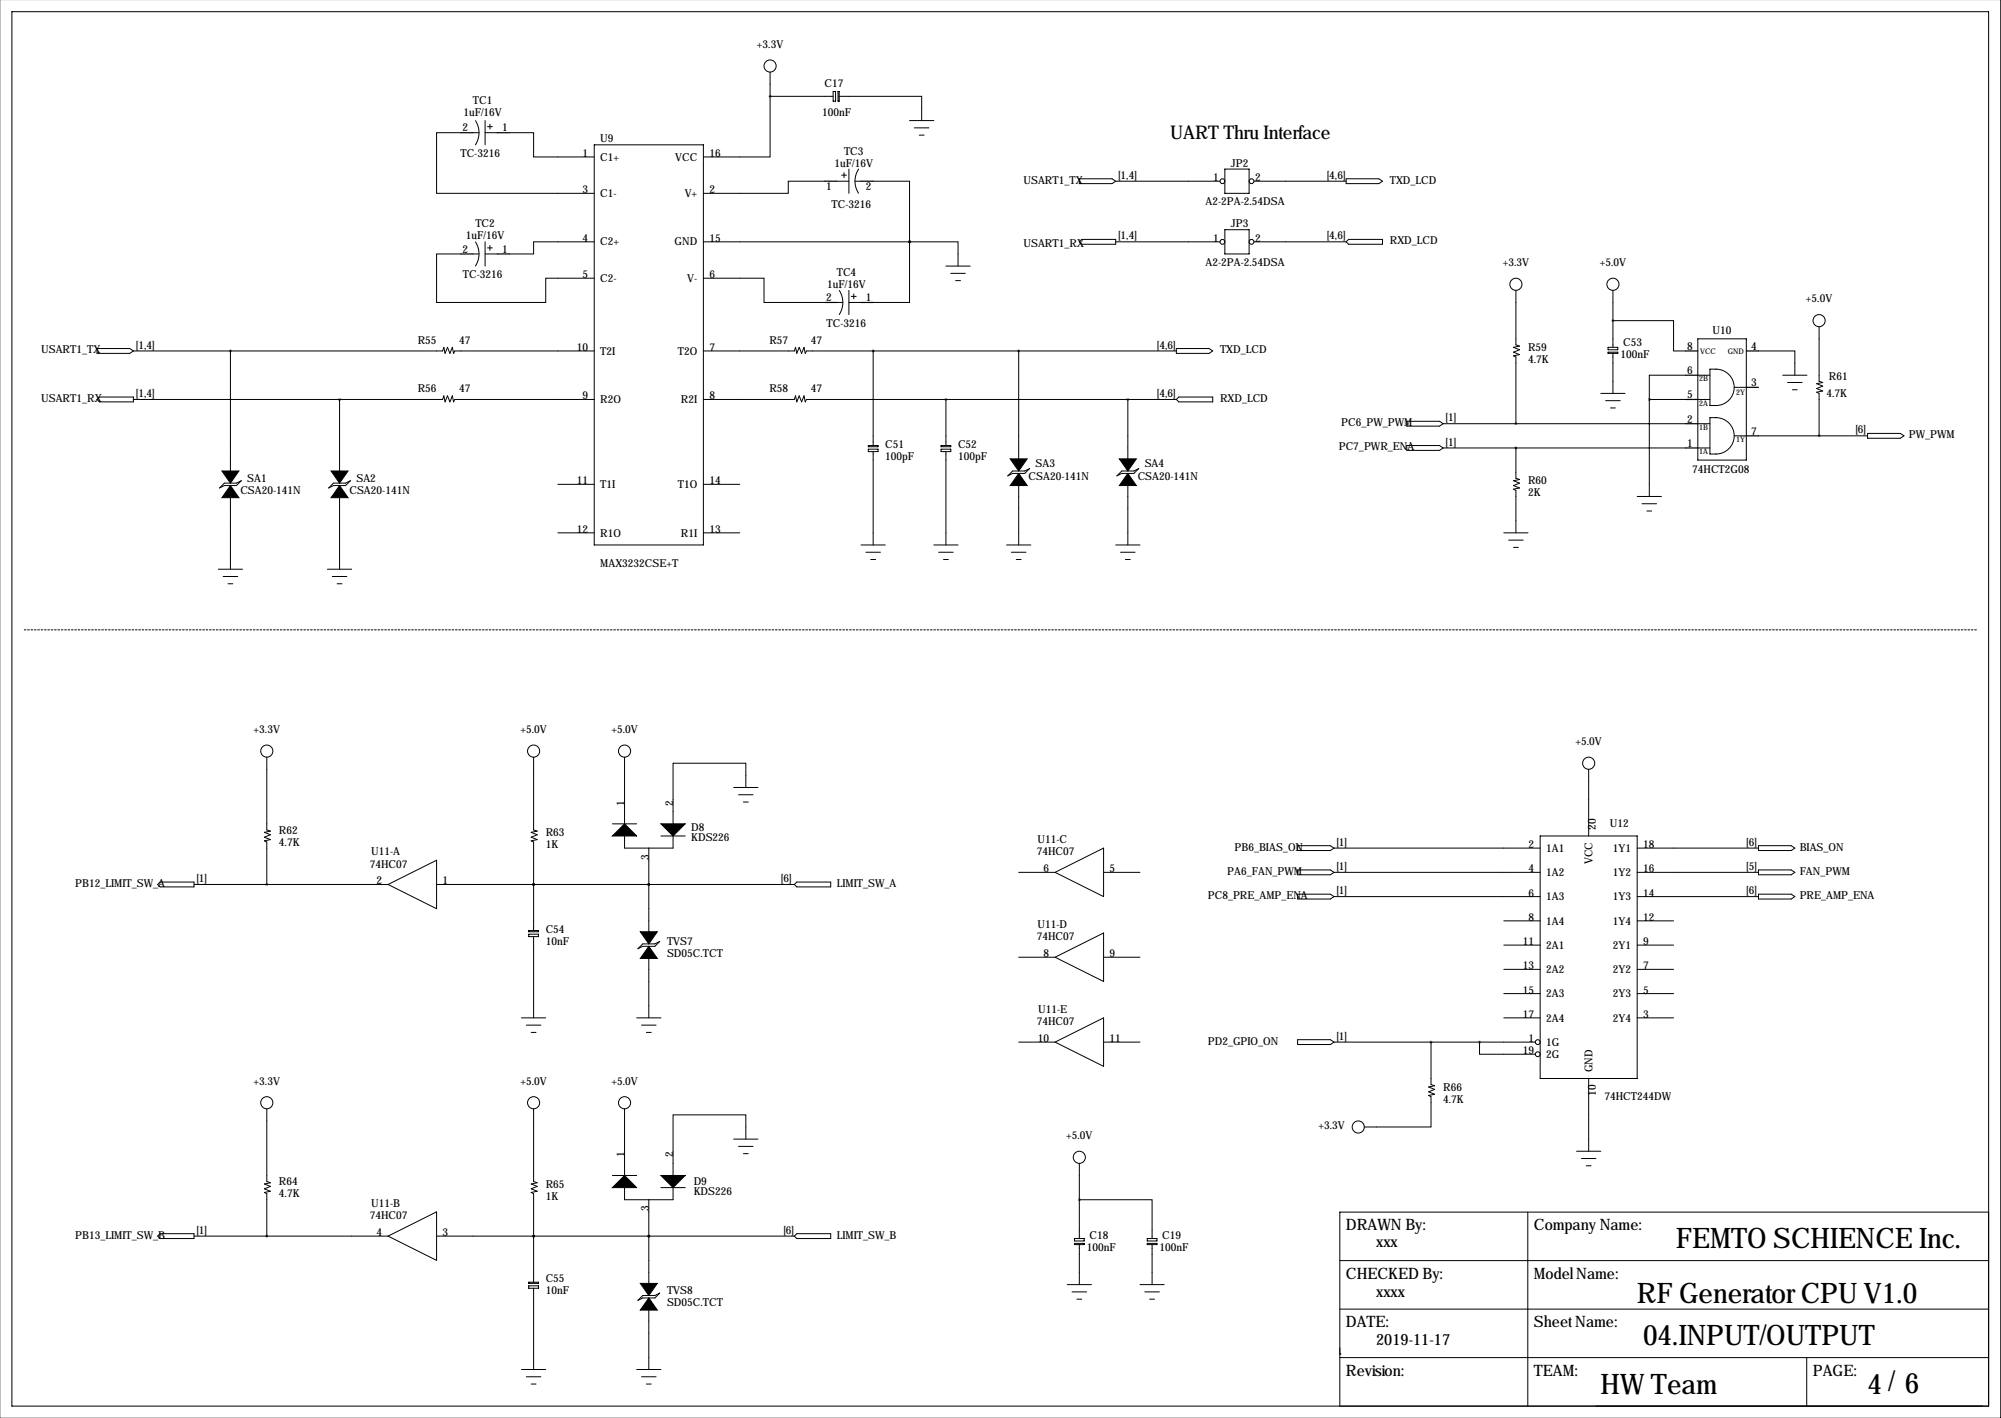
[picture p123: page 4]

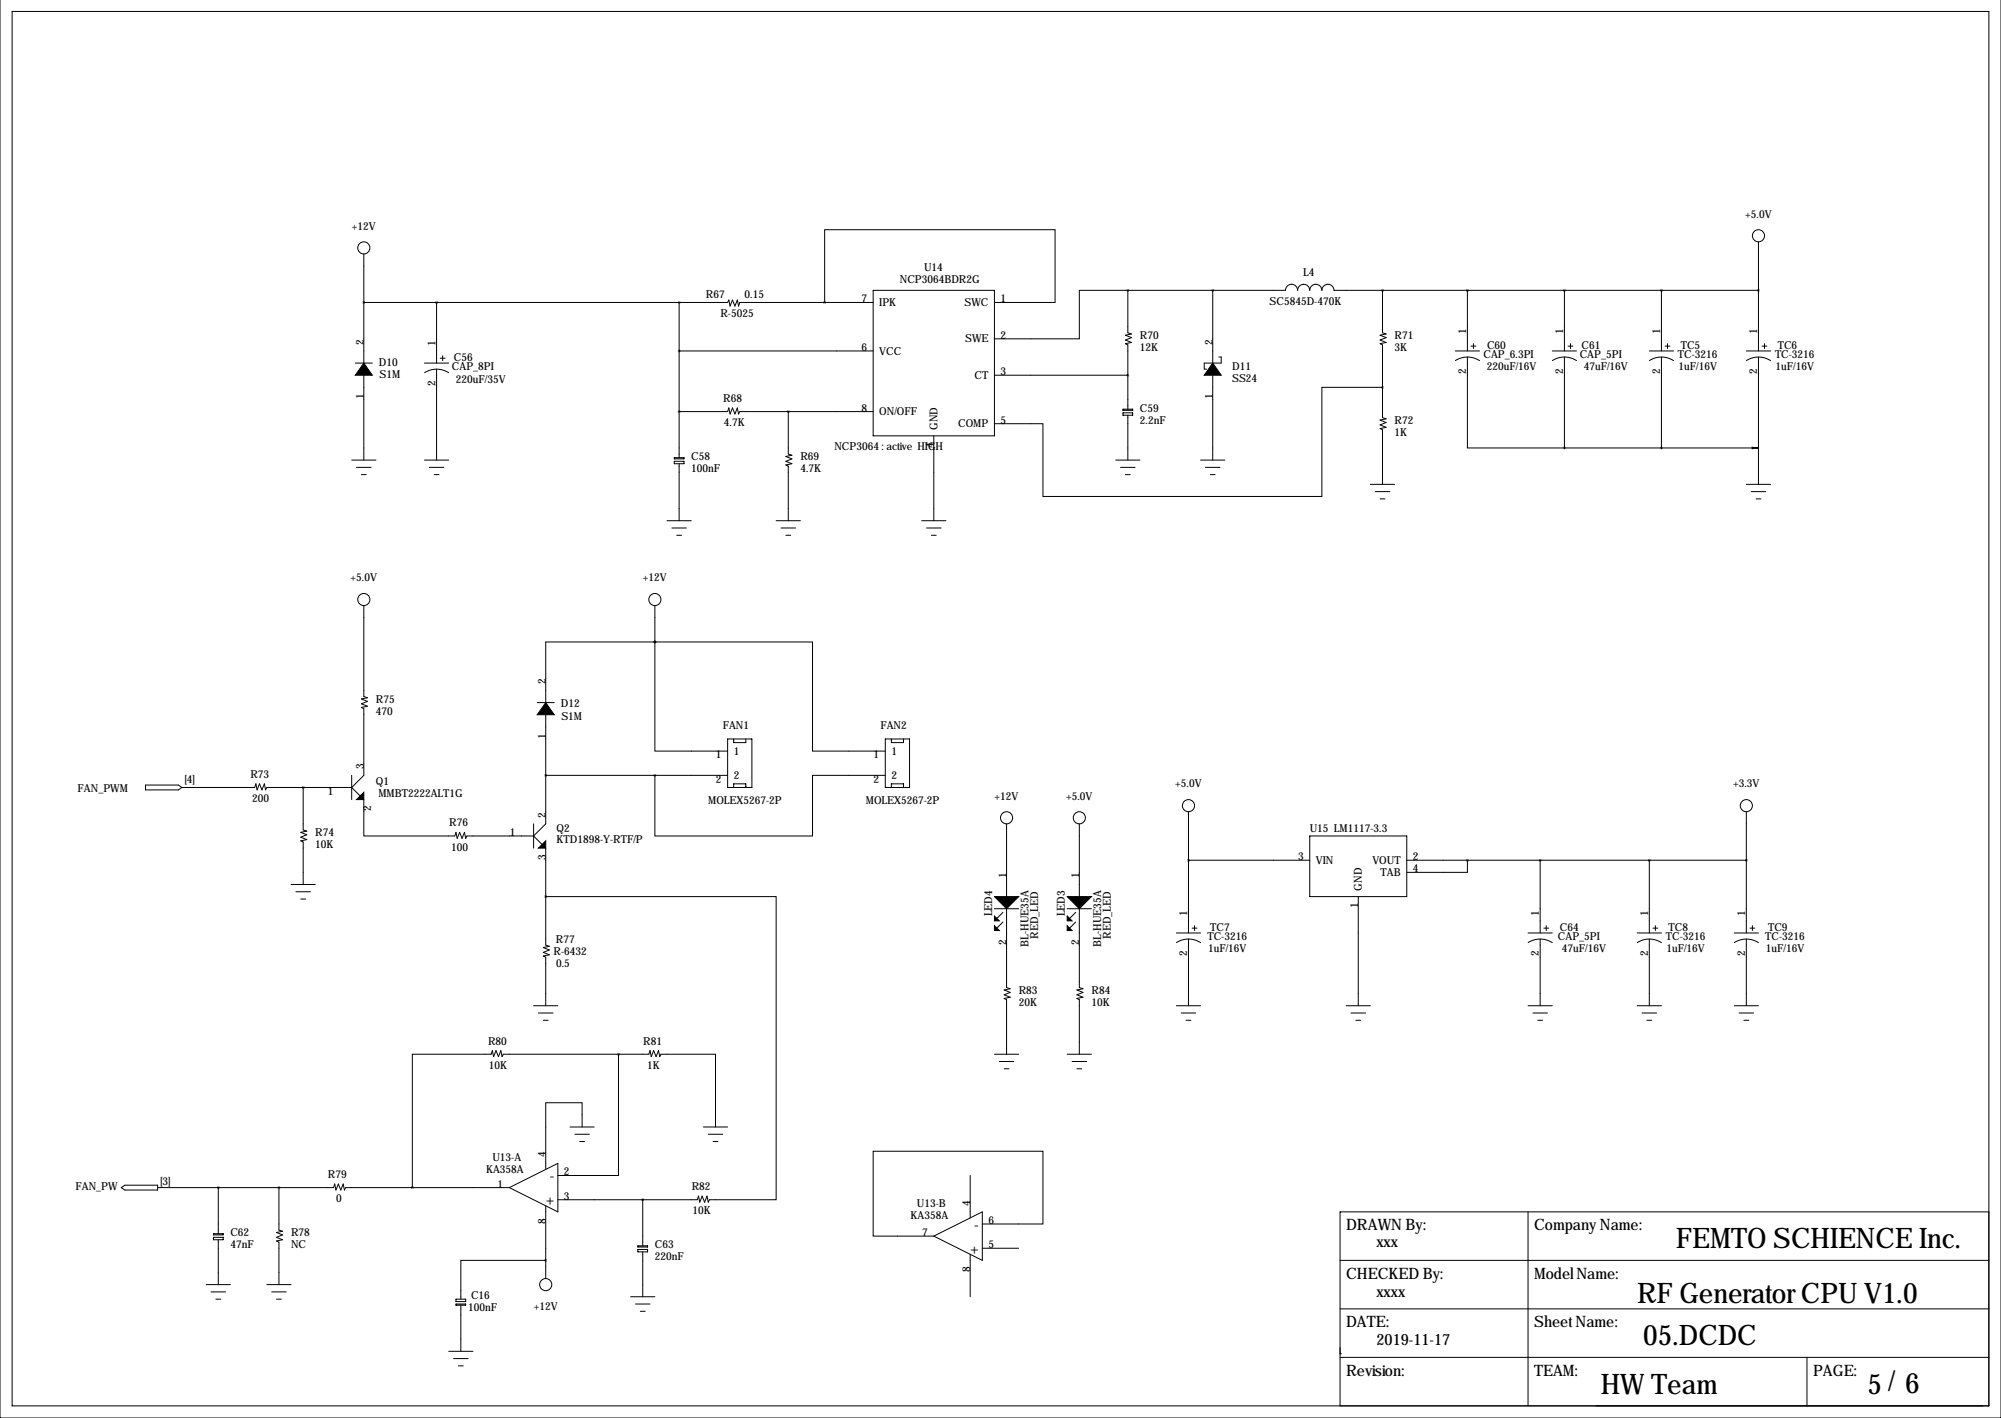
[picture p124: page 5]

LCD Comm. | RF CON Limit S/W | Case Limit S/W
+48V SMPS IN | +12V SMPS IN

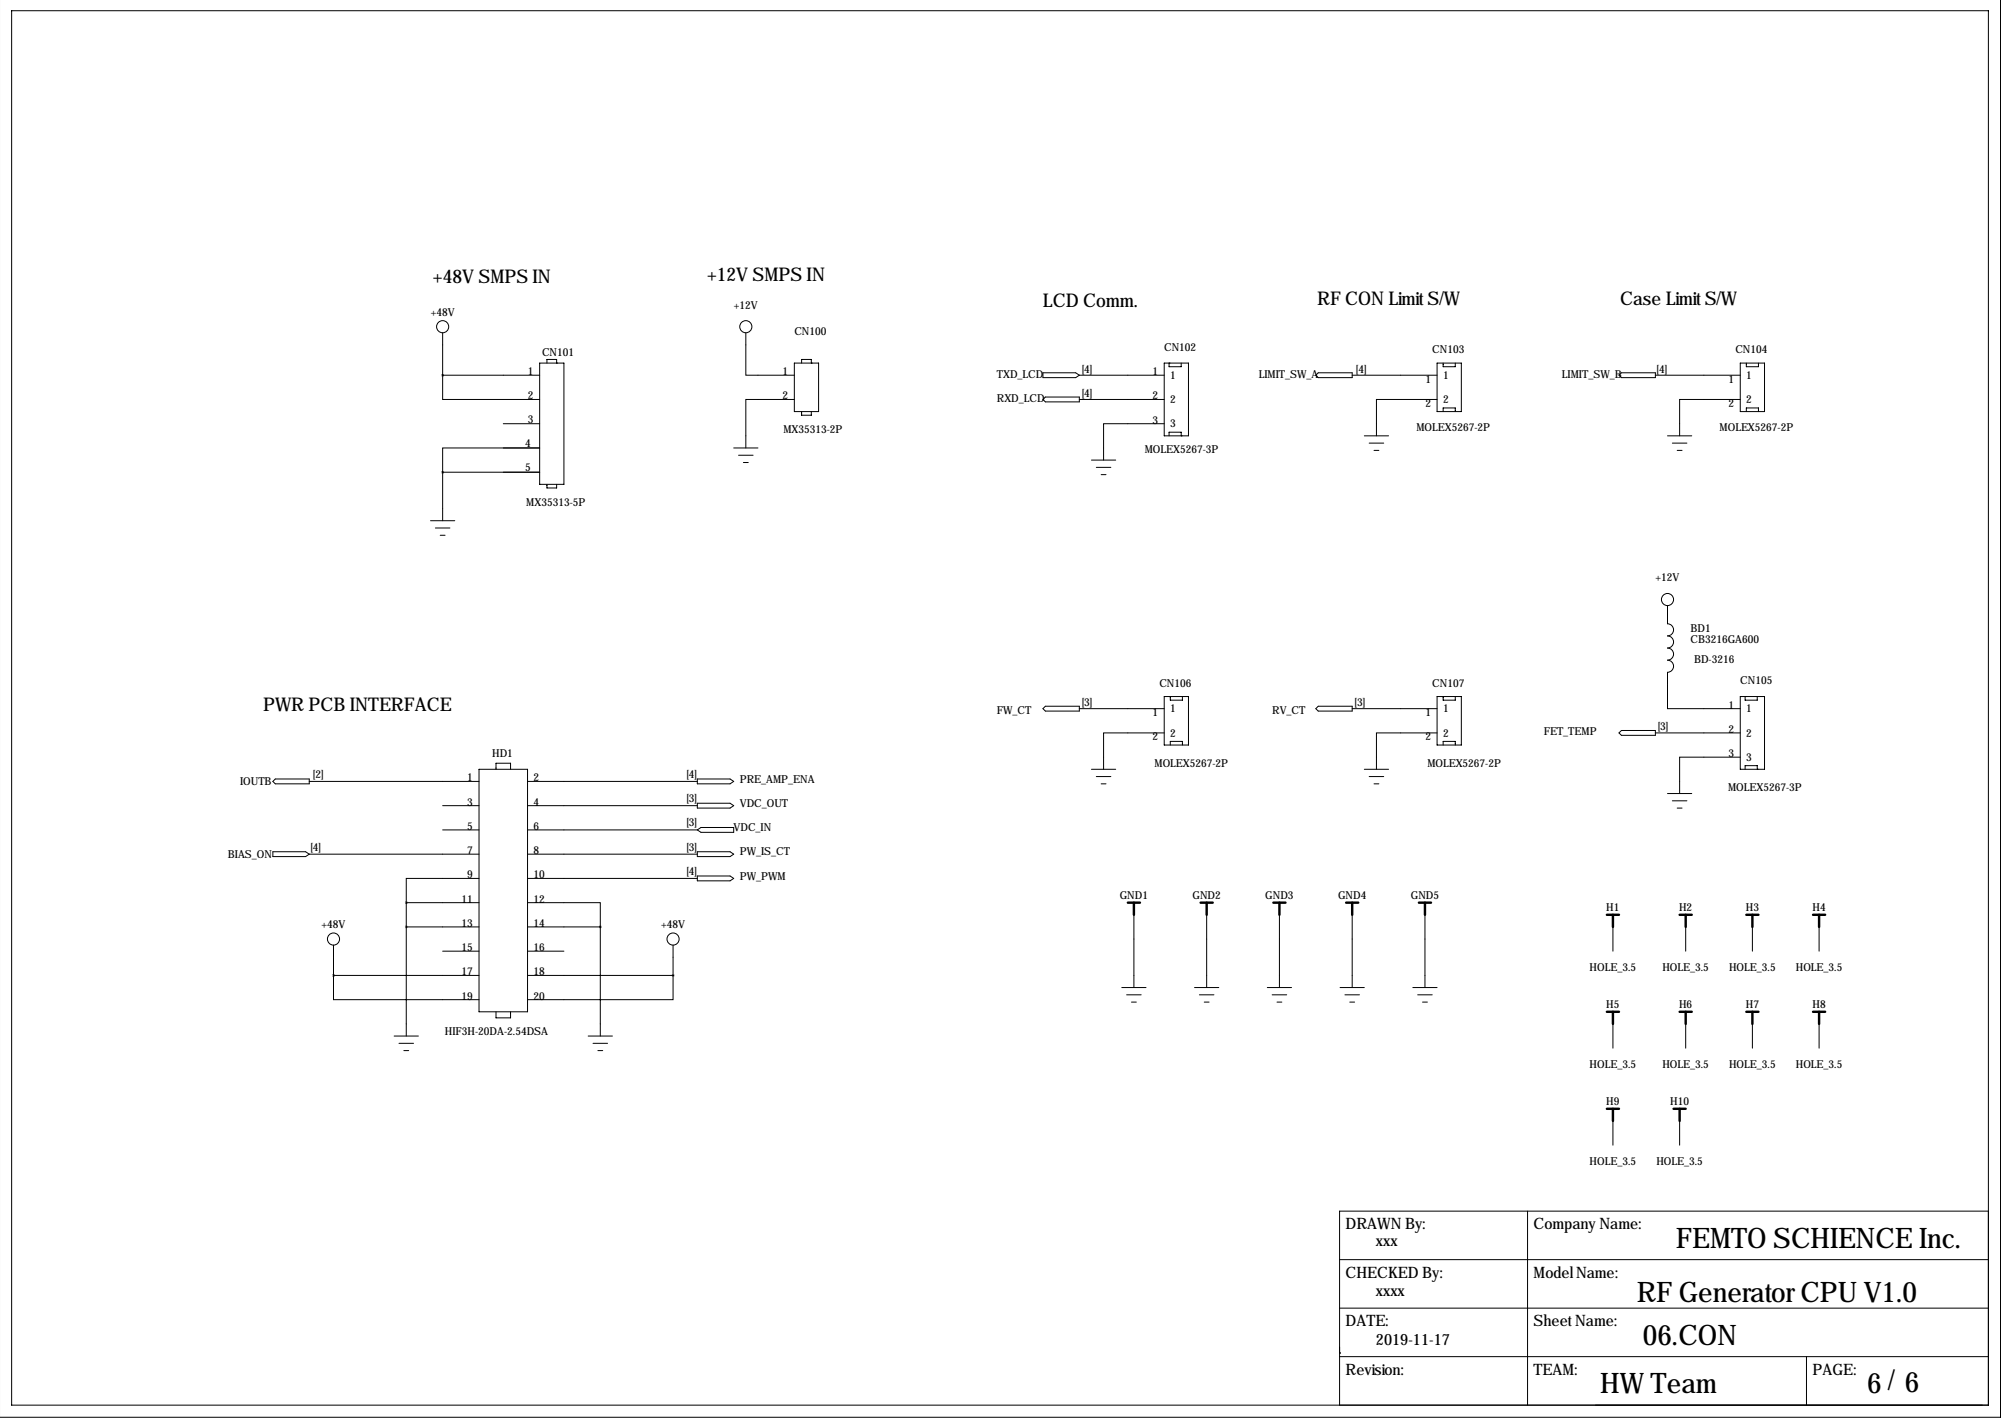
[picture p125: page 6]
