ArvidJoung/Plasma_RF_Generator/Reference Data/IS1.2.pdf

# 반도체 공정용 RFG 개발사례

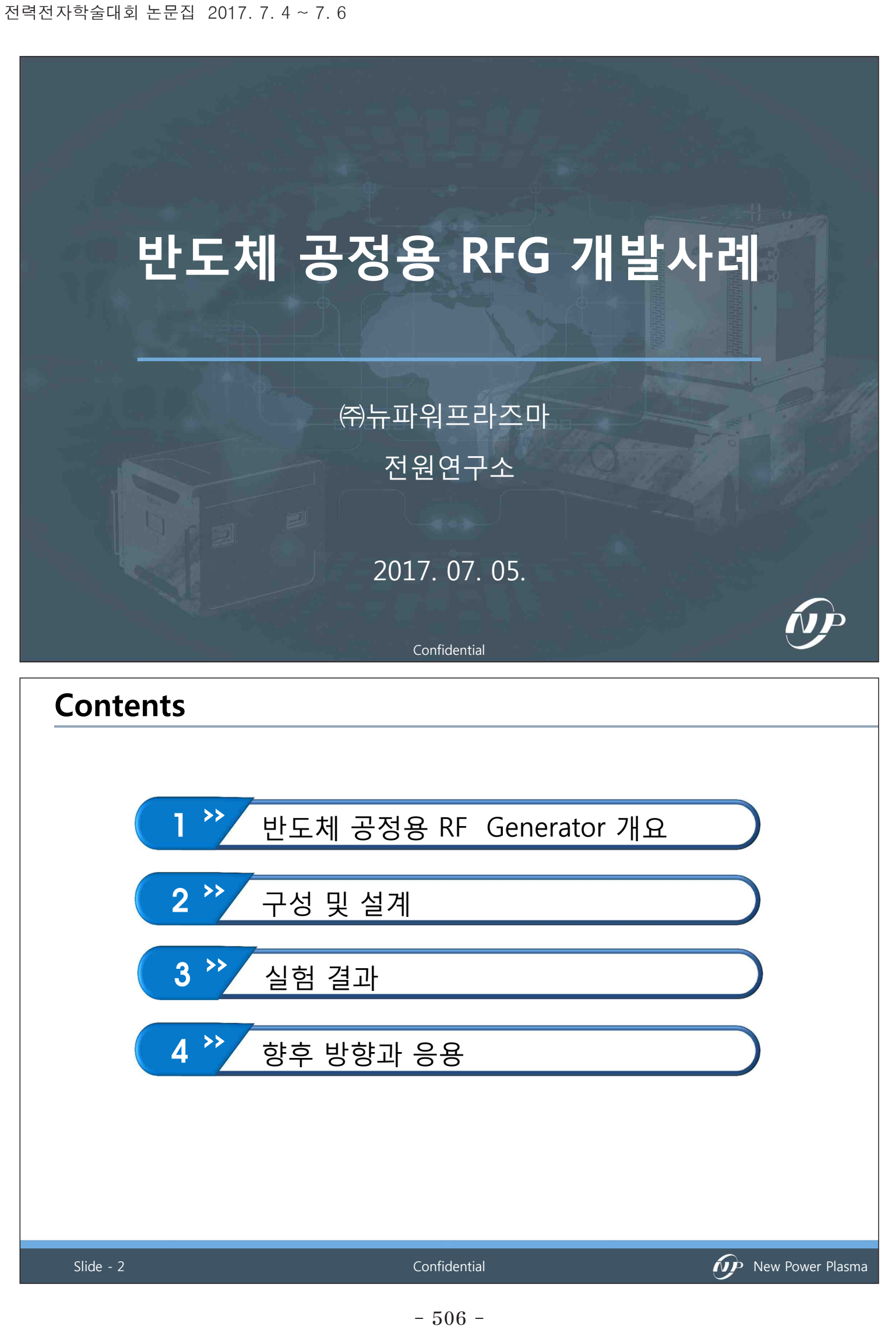
[picture p126: page 1]

- 506 -

전력전자학술대회 논문집 2017. 7. 4 ~ 7. 6

Slide - 2 | Confidential | New Power Plasma

# Contents

2 | 구성 및 설계
1 | 반도체 공정용 RF Generator 개요
4 | 향후 방향과 응용
3 | 실험 결과

# ㈜뉴파워프라즈마

# 전원연구소

2017. 07. 05.

Confidential

# Contents

# 2 구성 및 설계

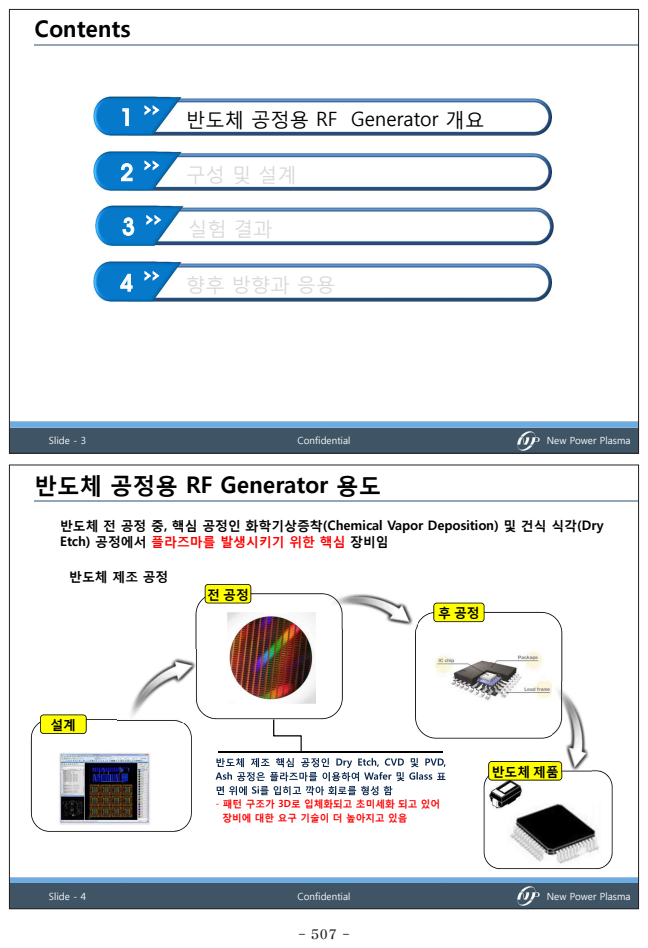
[picture p127: page 2]
Slide - 4; Confidential; New Power Plasma; 반도체 제품; Slide - 3; 반도체 공정용 RF Generator 개요; 향후 방향과 응용

반도체 공정용 RF Generator 용도

반도체 전 공정 중, 핵심 공정인 화학기상증착(Chemical Vapor Deposition) 및 건식 식각(Dry
Etch) 공정에서 플라즈마를 발생시키기 위한 핵심 장비임

반도체 제조 공정

- 패턴 구조가 3D로 입체화되고 초미세화 되고 있어
장비에 대한 요구 기술이 더 높아지고 있음

# 반도체 전 공정 RFG 활용

### Oxidation

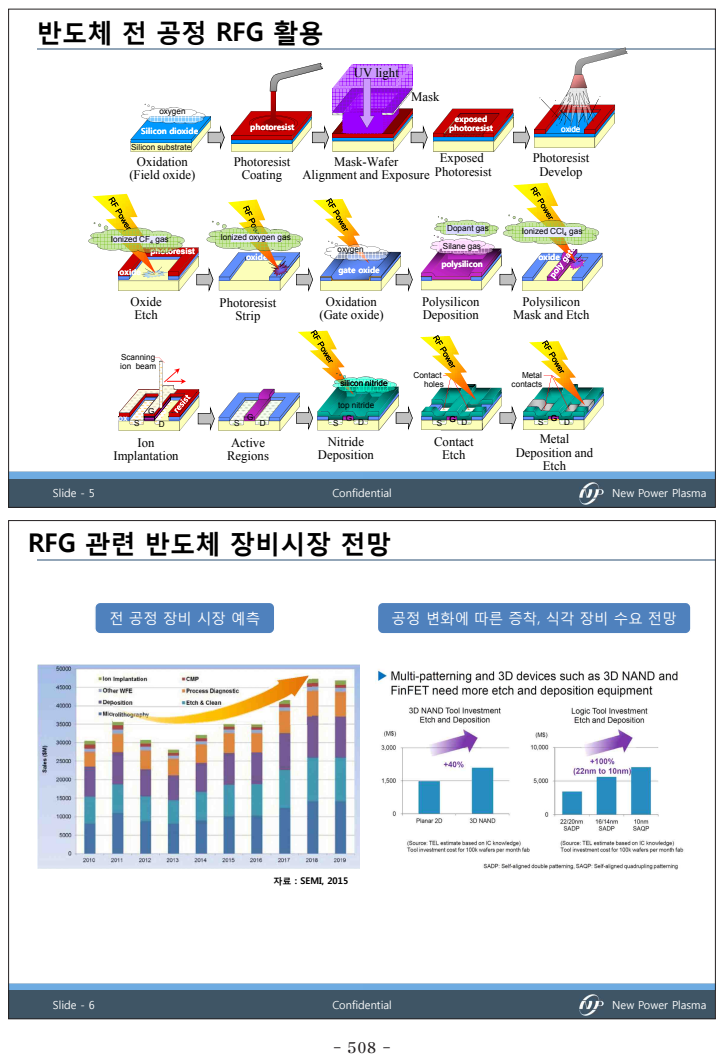
[picture p128: page 3]
Slide - 6; Confidential; New Power Plasma; 자료 : SEMI, 2015; Slide - 5; top nitride; (Field oxide); Silicon substrate; Silicon dioxide; oxygen; Photoresist Develop; oxide; Photoresist Coating; photoresist; Mask; UV light; Exposed Photoresist; exposed photoresist; Active Regions; silicon nitride; Nitride Deposition; Contact holes; Contact Etch; Ion Implantation; Scanning ion beam; Metal Deposition and Etch; drain S; Metal contacts; Polysilicon Deposition; polysilicon; Silane gas; Dopant gas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

Mask-Wafer
Alignment and Exposure

Ionized oxygen gas

Polysilicon
Mask and Etch

RFG 관련 반도체 장비시장 전망

공정 변화에 따른 증착, 식각 장비 수요 전망

# 반도체 공정용 RFG System 구성

## 장비 구성

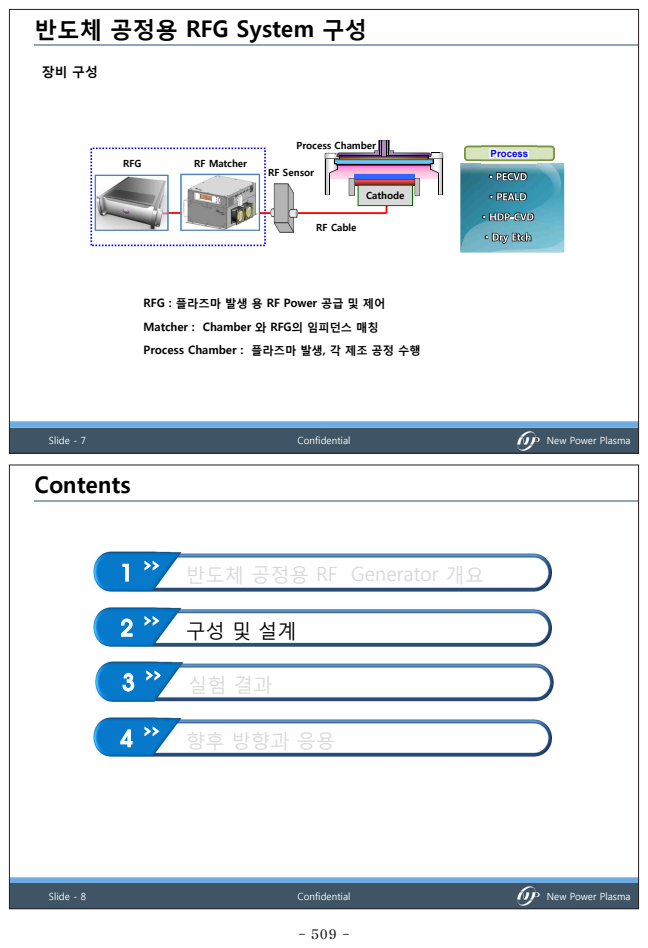
[picture p129: page 4]
Slide - 8; Confidential; New Power Plasma; Contents; 반도체 공정용 RF Generator 개요; 향후 방향과 응용; Slide - 7; Process; RF Sensor; RF Cable; Cathode; RFG; RF Matcher; Process Chamber

RFG : 플라즈마 발생 용 RF Power 공급 및 제어
Matcher : Chamber 와 RFG의 임피던스 매칭
Process Chamber : 플라즈마 발생, 각 제조 공정 수행

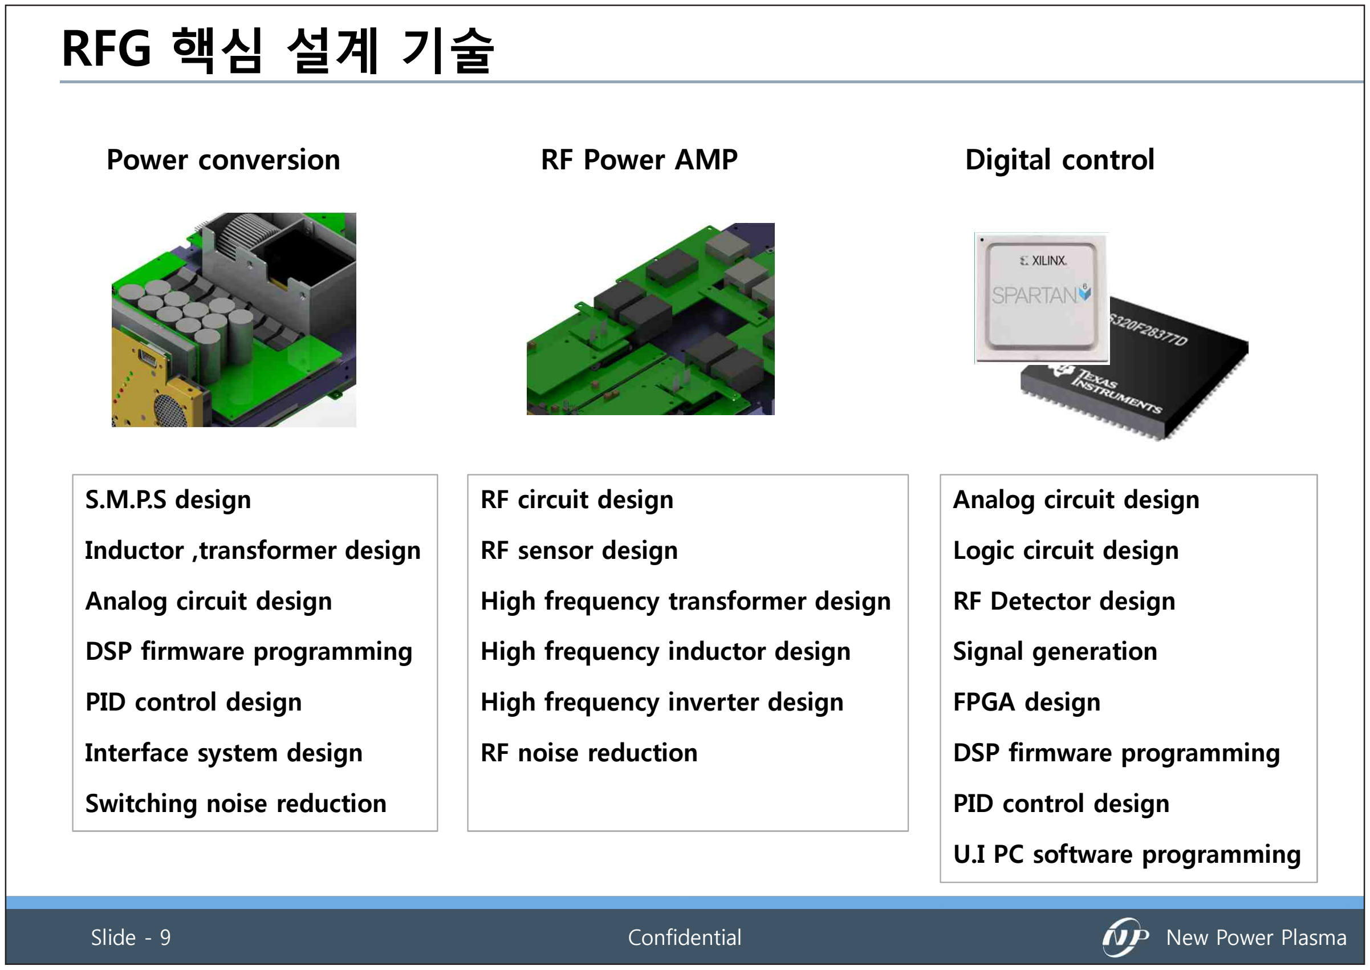
[picture p130: figure]
Slide - 9; Confidential; New Power Plasma; RFG 핵심 설계 기술; Analog circuit design; Logic circuit design; RF Detector design; Signal generation; FPGA design; DSP firmware programming; PID control design; U.I PC software programming; S.M.P.S design; Inductor ,transformer design; Interface system design; Switching noise reduction; RF circuit design; RF sensor design; High frequency transformer design; High frequency inductor design; High frequency inverter design; RF noise reduction
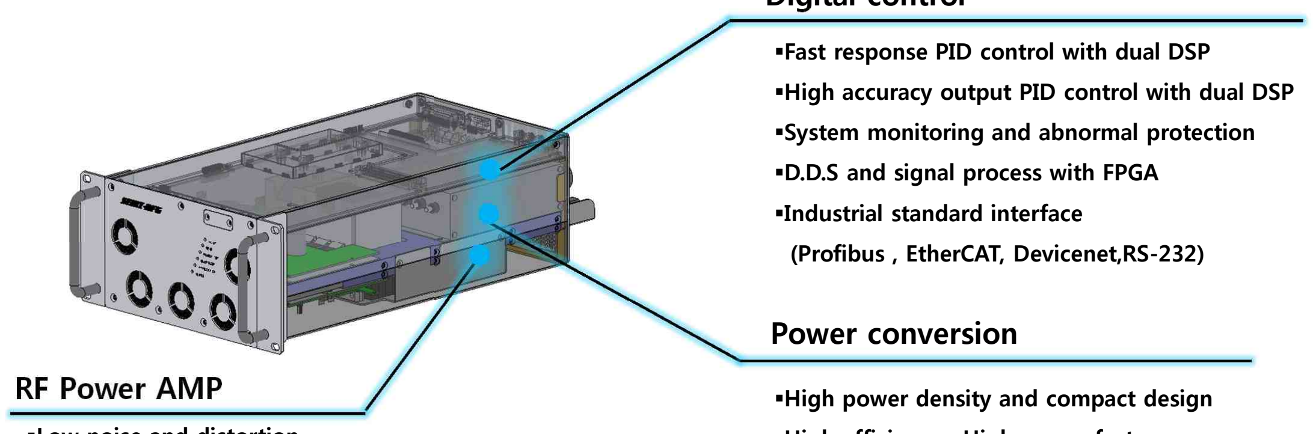
[picture p131: figure]
§High power density and compact design; Power conversion; RF Power AMP; §D.D.S and signal process with FPGA; §Industrial standard interface; (Profibus , EtherCAT, Devicenet,RS-232)

- 510 -
Slide - 10 | Confidential | New Power Plasma

# 반도체 공정용 RFG 개발 사양

§Low noise and distortion
§Wide range power output control §High power density and high efficiency

§High efficiency , High power factor §Fast response for dynamic load §Compliance SAG-22 , CE ,UL Topology
- Buck ,Boost converter
- Cascade Buck-boost converter
- Resonant converter
- Active or passive PFC

Topology
- Half bridge inverter
- Full bridge inverter
- Push-pull inverter
- High frequency ,high power LC filter

## Digital control

§Fast response PID control with dual DSP
§High accuracy output PID control with dual DSP §System monitoring and abnormal protection
Power conversion | RF Power AMP | Digital control

# RFG 설계 구성

AC

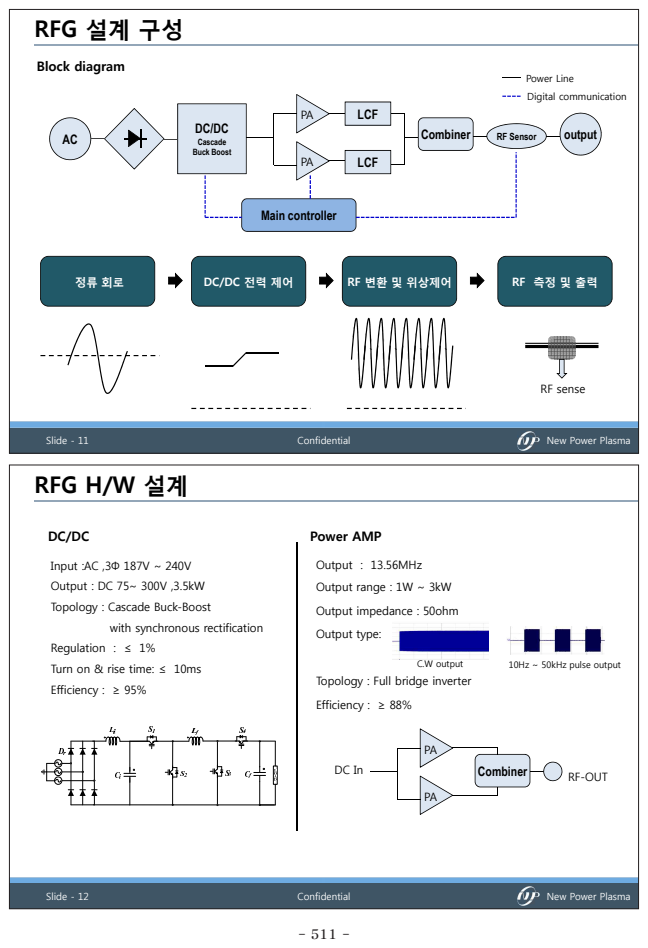
[picture p132: page 6]
Slide - 12; Confidential; New Power Plasma; RFG H/W 설계; Combiner; Output : 13.56MHz; Output range : 1W ~ 3kW; Output impedance : 50ohm; Output type:; C.W output; 10Hz ~ 50kHz pulse output; Power AMP; Slide - 11; DC/DC Cascade Buck Boost; RF Sensor; LCF; output; RF 변환 및 위상제어; RF sense; Main controller; Power Line; Digital communication; Block diagram

Input :AC ,3Φ 187V ~ 240V
Output : DC 75~ 300V ,3.5kW
Topology : Cascade Buck-Boost

with synchronous rectification

Regulation : ≤ 1%
Turn on & rise time: ≤ 10ms
Efficiency : ≥ 95%

Topology : Full bridge inverter
Efficiency : ≥ 88%

RF-OUT DC In

# RFG control system 설계

## DC/DC

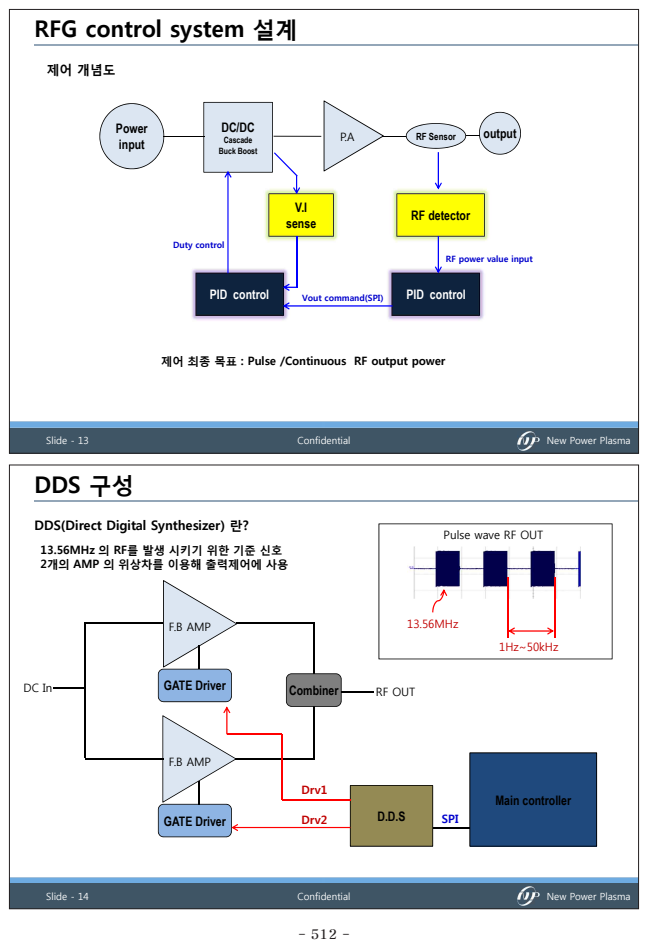
[picture p133: page 7]
Slide - 14; Confidential; New Power Plasma; DDS 구성; F.B AMP; GATE Driver; Combiner; RF OUT; Drv1; Drv2; Main controller; SPI; 13.56MHz; 1Hz~50kHz; Slide - 13; Cascade Buck Boost; output Power; input; RF Sensor; RF detector; PID control; V.I sense; Duty control; 제어 개념도

RF power value input

Vout command(SPI)

제어 최종 목표 : Pulse /Continuous RF output power

Pulse wave RF OUT DDS(Direct Digital Synthesizer) 란?
13.56MHz 의 RF를 발생 시키기 위한 기준 신호
2개의 AMP 의 위상차를 이용해 출력제어에 사용

# RFG에서 DDS 구성

## DDS 설계 사양

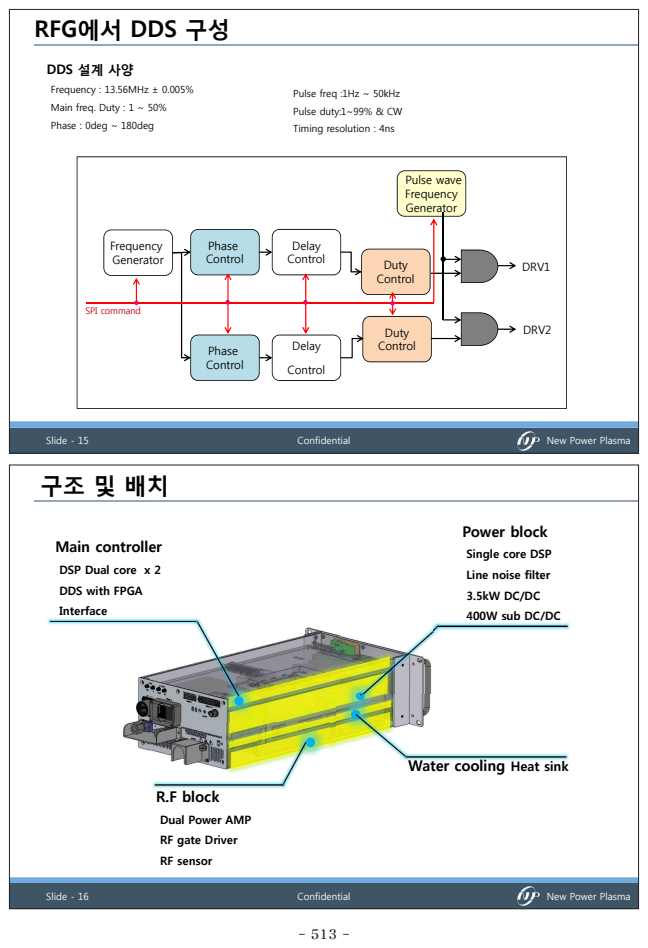
[picture p134: page 8]
Slide - 16; Confidential; New Power Plasma; Slide - 15; Pulse wave Frequency Generator; Frequency; Generator; Duty; Control; Phase Control; Delay Control; Delay; Duty Control; SPI command; DRV1; DRV2

Frequency : 13.56MHz ± 0.005%
Main freq. Duty : 1 ~ 50%
Phase : 0deg ~ 180deg

Pulse freq :1Hz ~ 50kHz
Pulse duty:1~99% & CW
Timing resolution : 4ns

Power block
Single core DSP
Line noise filter
400W sub DC/DC

Main controller
DSP Dual core x 2
DDS with FPGA
Interface

Water cooling Heat sink

R.F block
Dual Power AMP
RF gate Driver
RF sensor

# U.I PC software

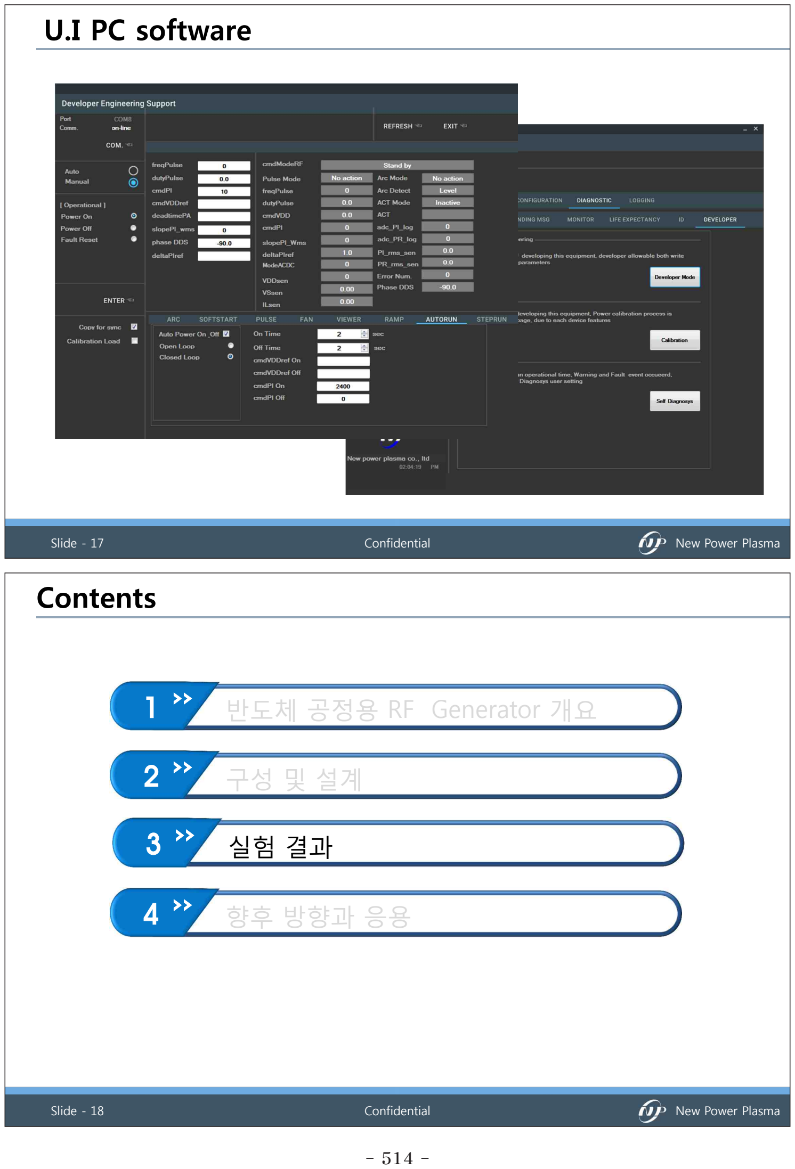
[picture p135: page 9]

- 514 -
Slide - 18 | Confidential | New Power Plasma

# Contents

2 | 구성 및 설계
1 | 반도체 공정용 RF Generator 개요
4 | 향후 방향과 응용
3 | 실험 결과
Slide - 17 | Confidential | New Power Plasma

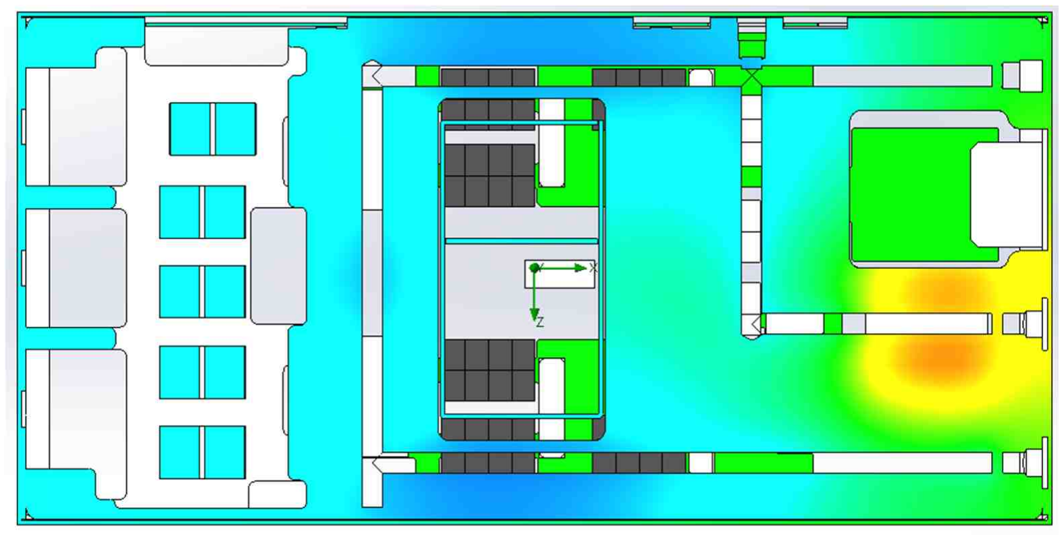
[picture p136: figure]
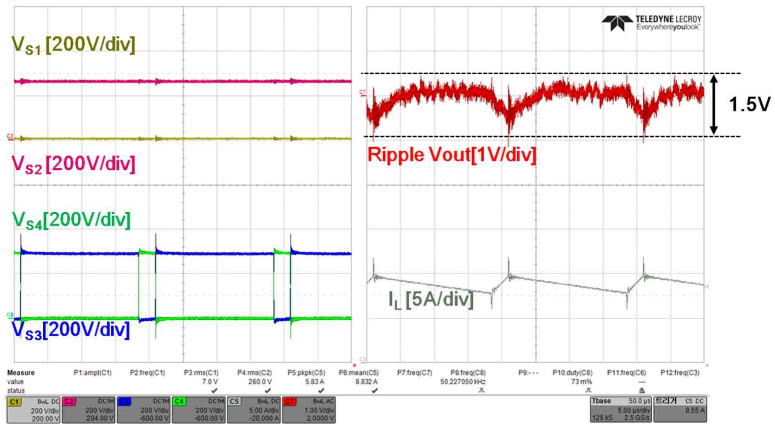
[picture p137: figure]

- 515 -
Slide - 20 | Confidential | New Power Plasma

# 실험 결과

## *V-ripple : 1.5V @300V(3.5kW) output

## DC/DC output ripple voltage

Slide - 19 | Confidential | New Power Plasma

# 열 해석

Temp(℃)

## Water cooling heat sink simulation

# 실험 결과

Vs

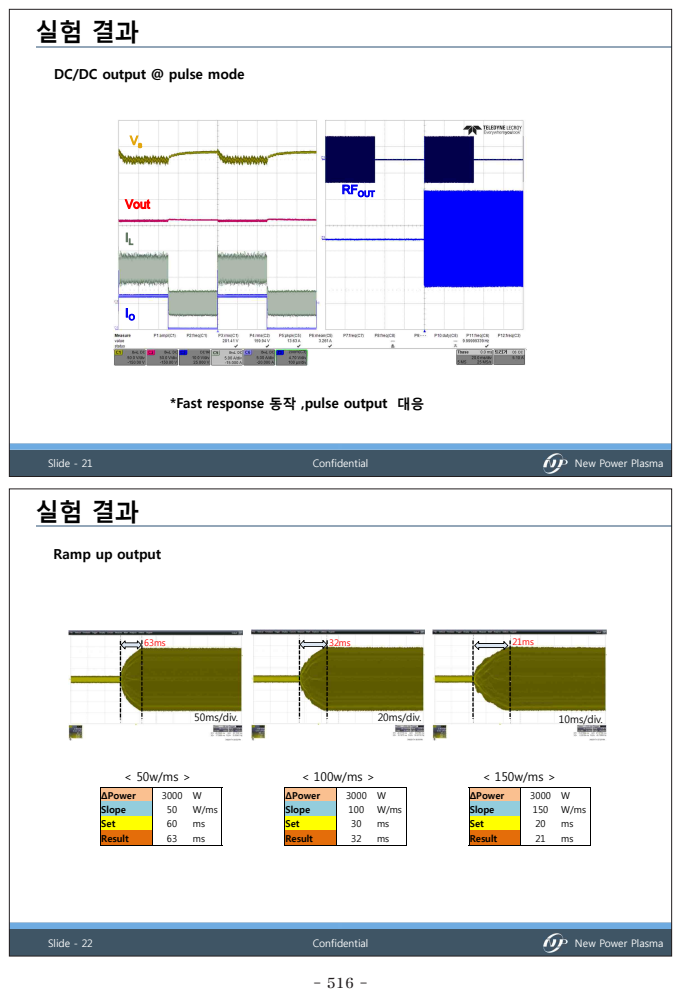
[picture p138: page 11]
Slide - 22; Confidential; New Power Plasma; 50ms/div.; 20ms/div.; 10ms/div.; ΔPower; Slope; Set; Result; Slide - 21; Vout; RFOUT

DC/DC output @ pulse mode

*Fast response 동작 ,pulse output 대응

Ramp up output

# 실험 결과

## Pulse output

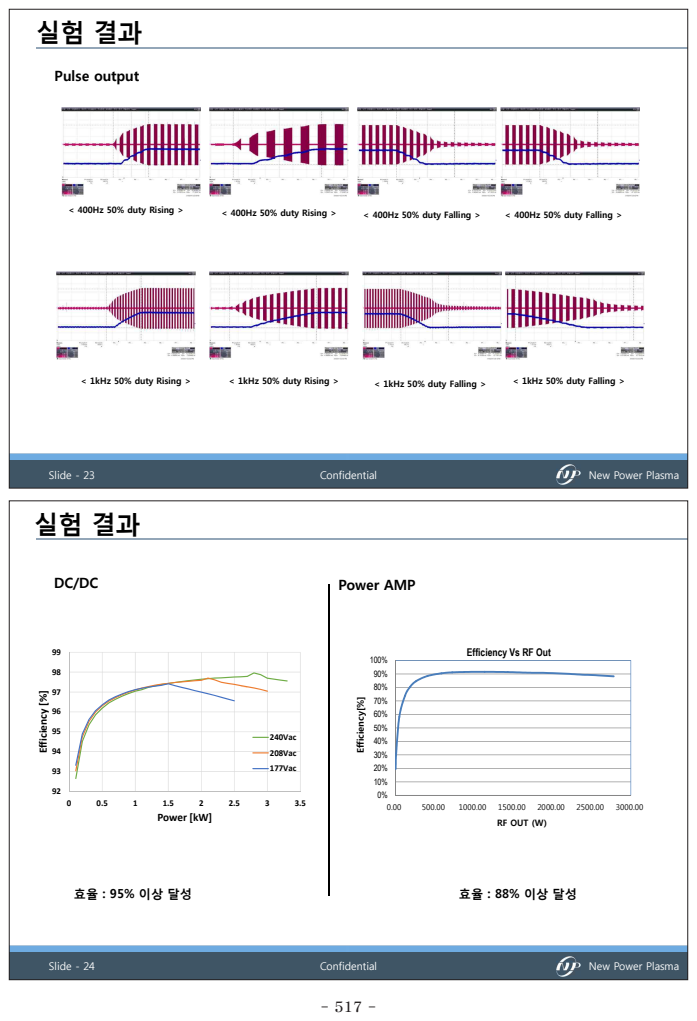
[picture p139: page 12]
Slide - 24; Confidential; New Power Plasma; Efficiency [%]; Power [kW]; Efficiency[%]; RF OUT (W); Power AMP; Slide - 23; < 400Hz 50% duty Rising >; < 400Hz 50% duty Falling >; < 1kHz 50% duty Rising >; < 1kHz 50% duty Falling >

Efficiency Vs RF Out

240Vac 208Vac

177Vac

# Contents

# 2 구성 및 설계

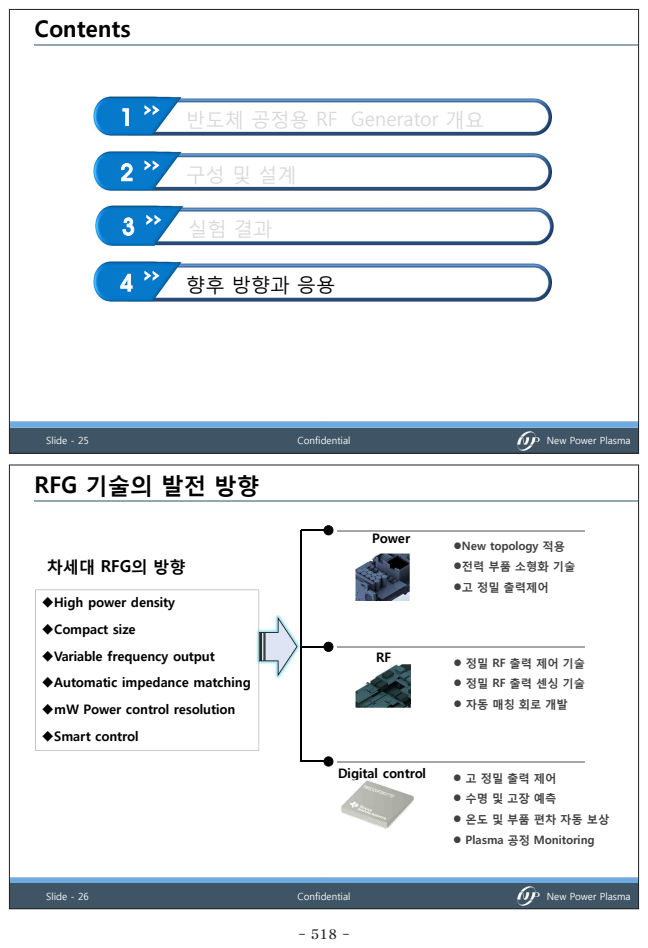
[picture p140: page 13]
Slide - 26; Confidential; New Power Plasma; Digital control; Power; Slide - 25; 반도체 공정용 RF Generator 개요; 향후 방향과 응용

RFG 기술의 발전 방향

lNew topology 적용
l전력 부품 소형화 기술
l고 정밀 출력제어

차세대 RFG의 방향

uHigh power density
uCompact size
uVariable frequency output
uAutomatic impedance matching
umW Power control resolution
uSmart control

l Plasma 공정 Monitoring

# RFG 적용 기술 응용 산업

# RF Generator

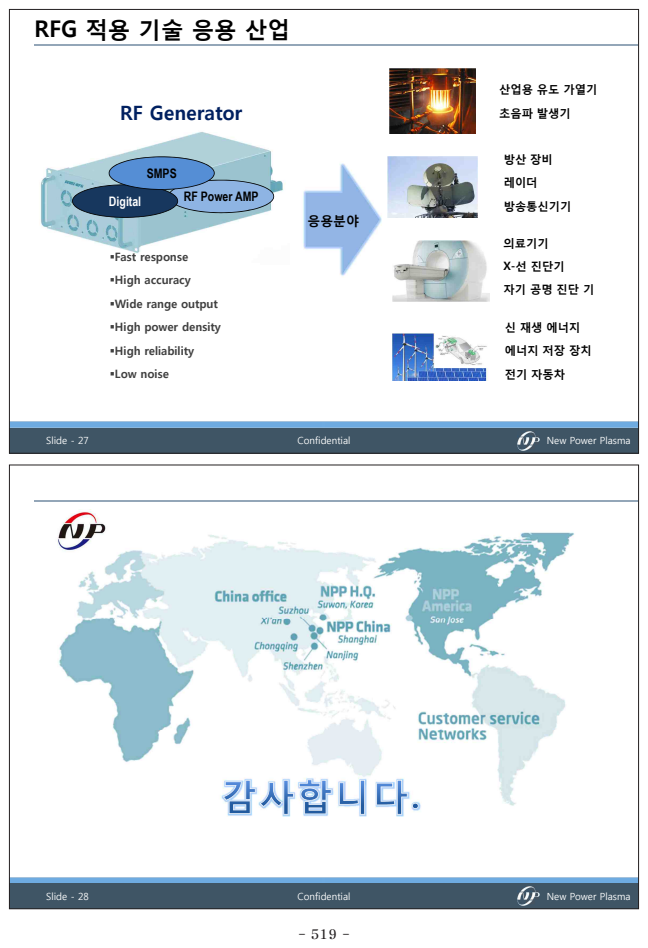
[picture p141: page 14]
Slide - 28; Confidential; New Power Plasma; Slide - 27; 응용분야; 레이더; 방송통신기기

산업용 유도 가열기
초음파 발생기

SMPS
RF Power AMP Digital

의료기기
X-선 진단기

§Fast response
§High accuracy
§Wide range output
§High power density
§High reliability
§Low noise

신 재생 에너지
에너지 저장 장치
전기 자동차
