ArvidJoung/Plasma_RF_Generator/1_Schematic/Build V2.0/04_RF-GEN-COUPLER-001/Tandem-coupler_V1.0_PCB_191209.pdf

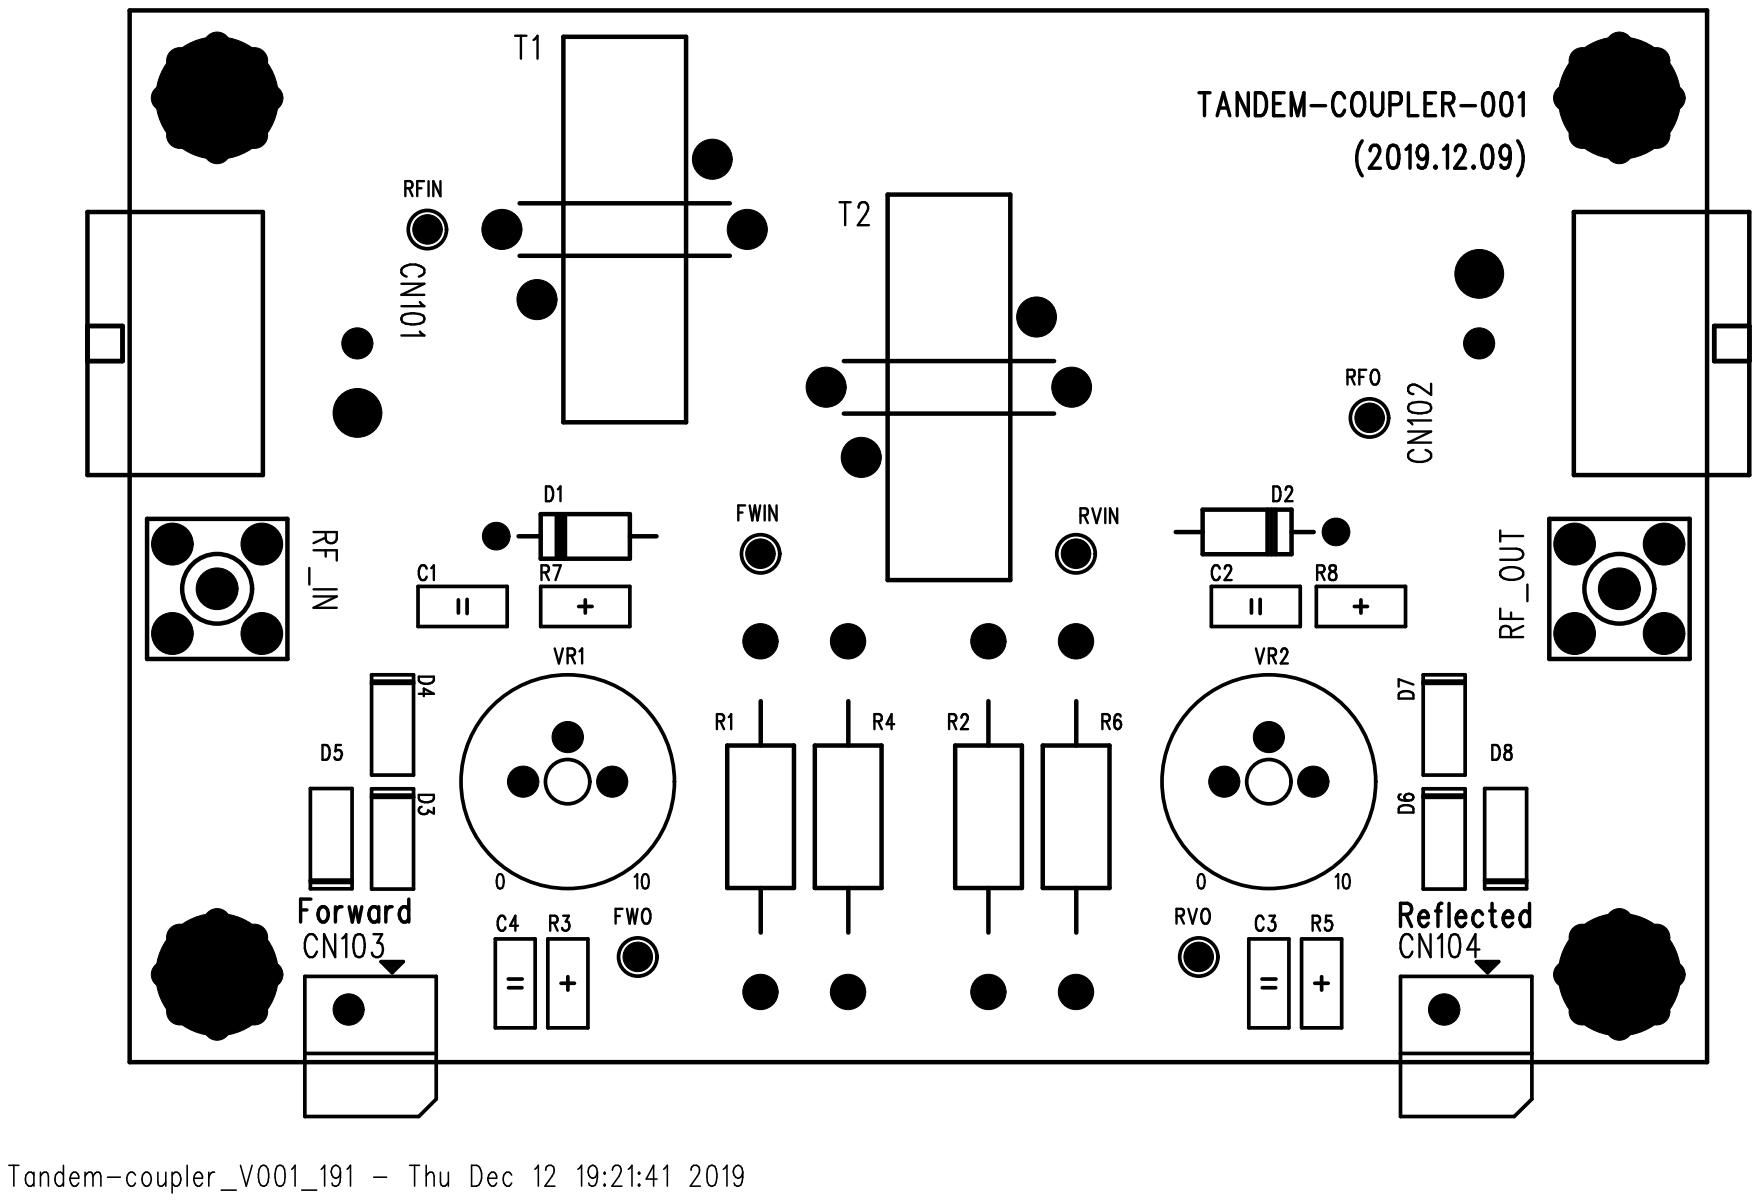
[picture p142: page 1]
