ArvidJoung/Plasma_RF_Generator/1_Schematic/Build V2.0/04_RF-GEN-COUPLER-001/Tandem-coupler_V1.0_SCH_191209.pdf

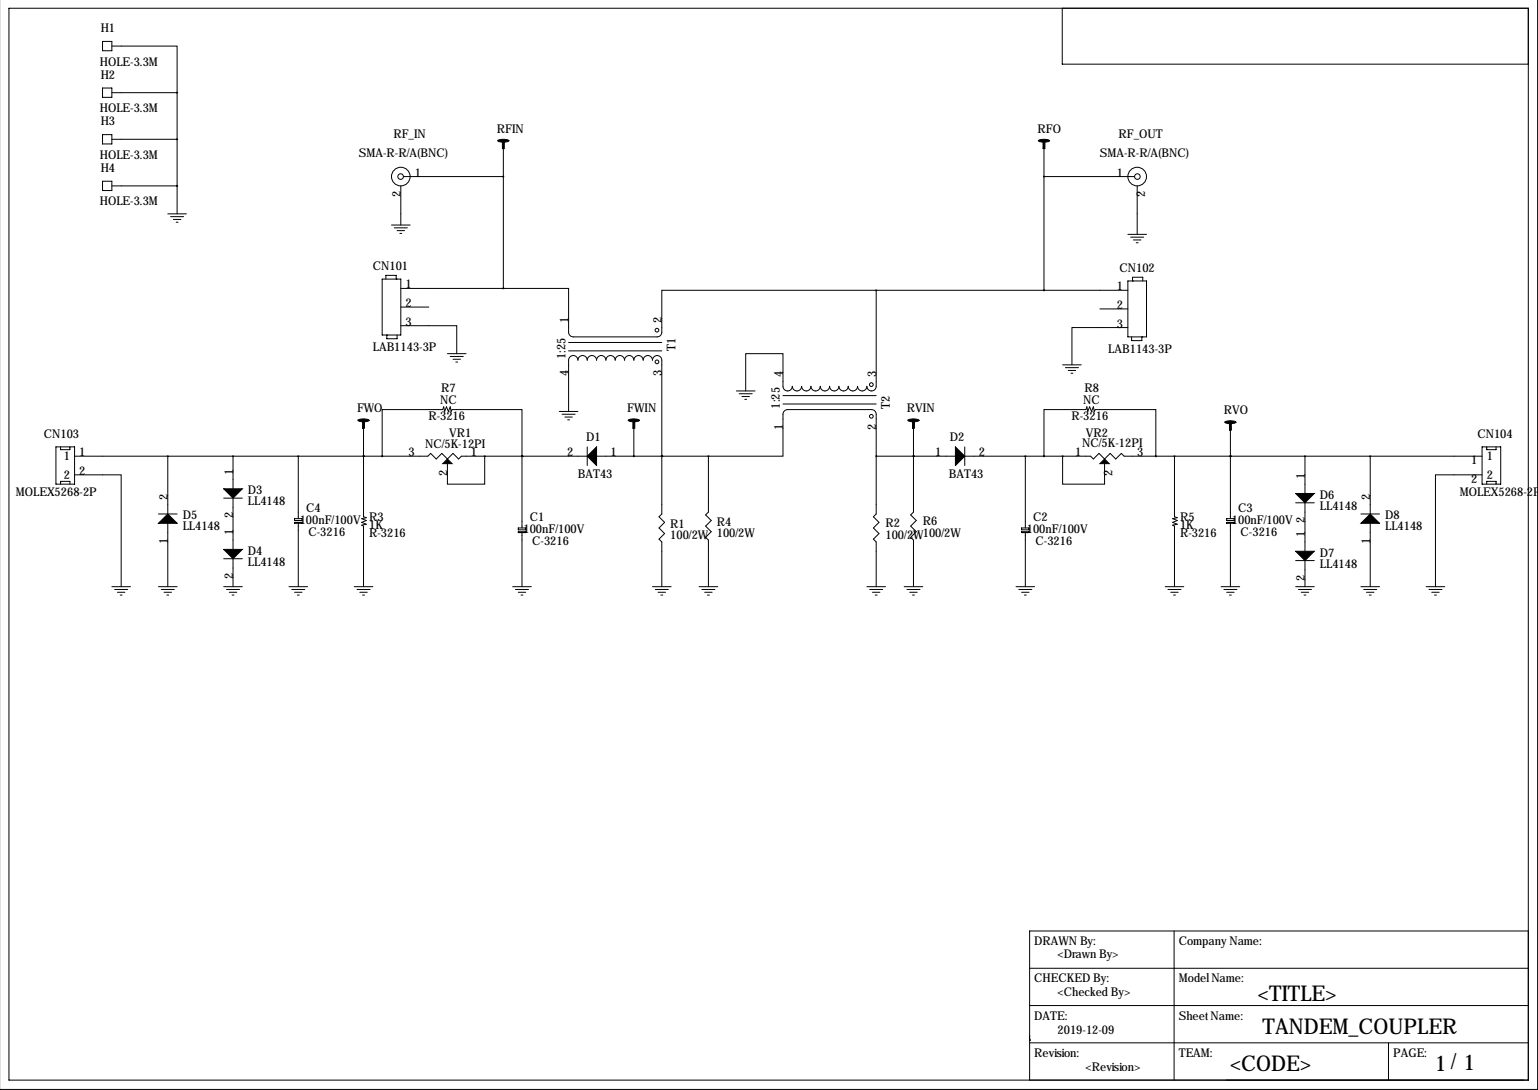
[picture p143: page 1]
