ArvidJoung/Plasma_RF_Generator/1_Schematic/Build V2.0/01_RF-GEN-CPU-001/RF-GEN_CPU_V1.0_PCB_20191117.pdf

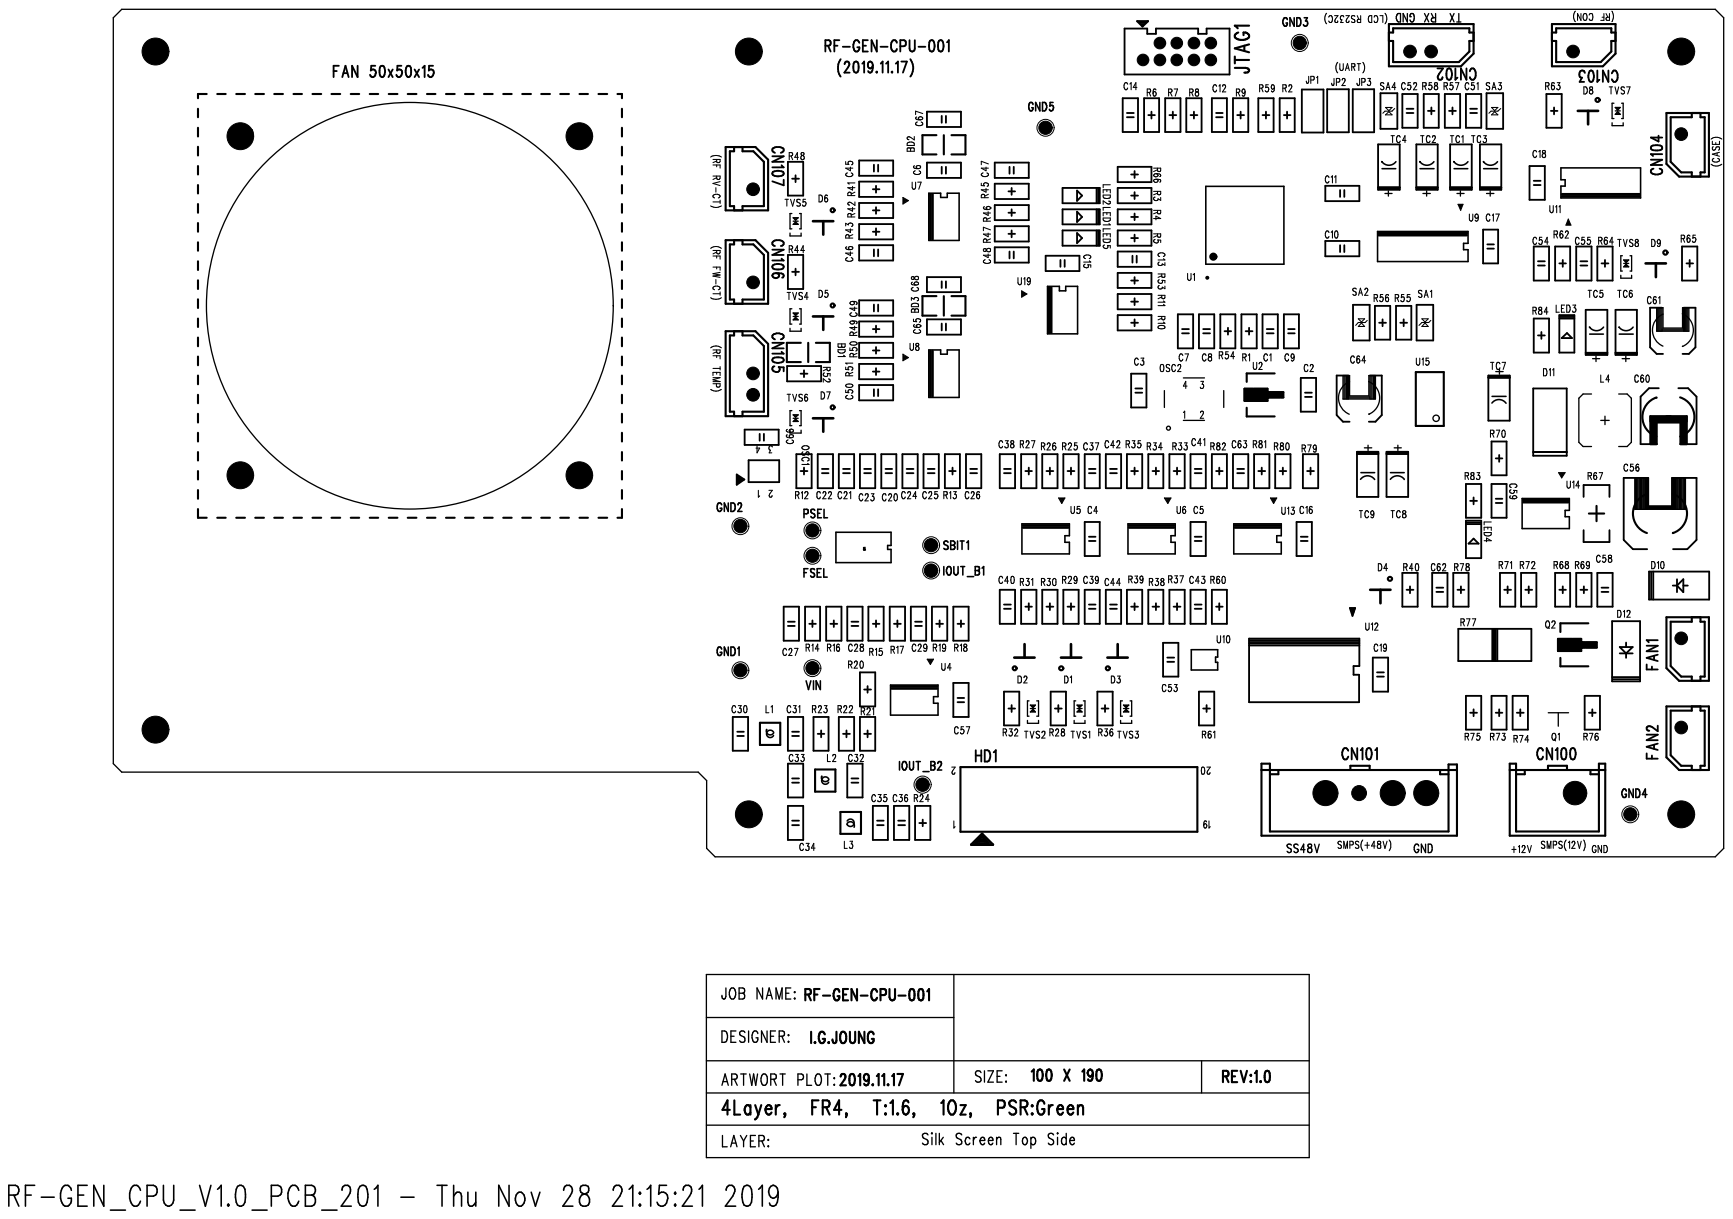
[picture p144: page 1]
