ArvidJoung/Plasma_RF_Generator/1_Schematic/Build V2.0/02_RF-GEN-PWR-001/RF-GEN_PWR_V1.0_PCB_20191128.pdf

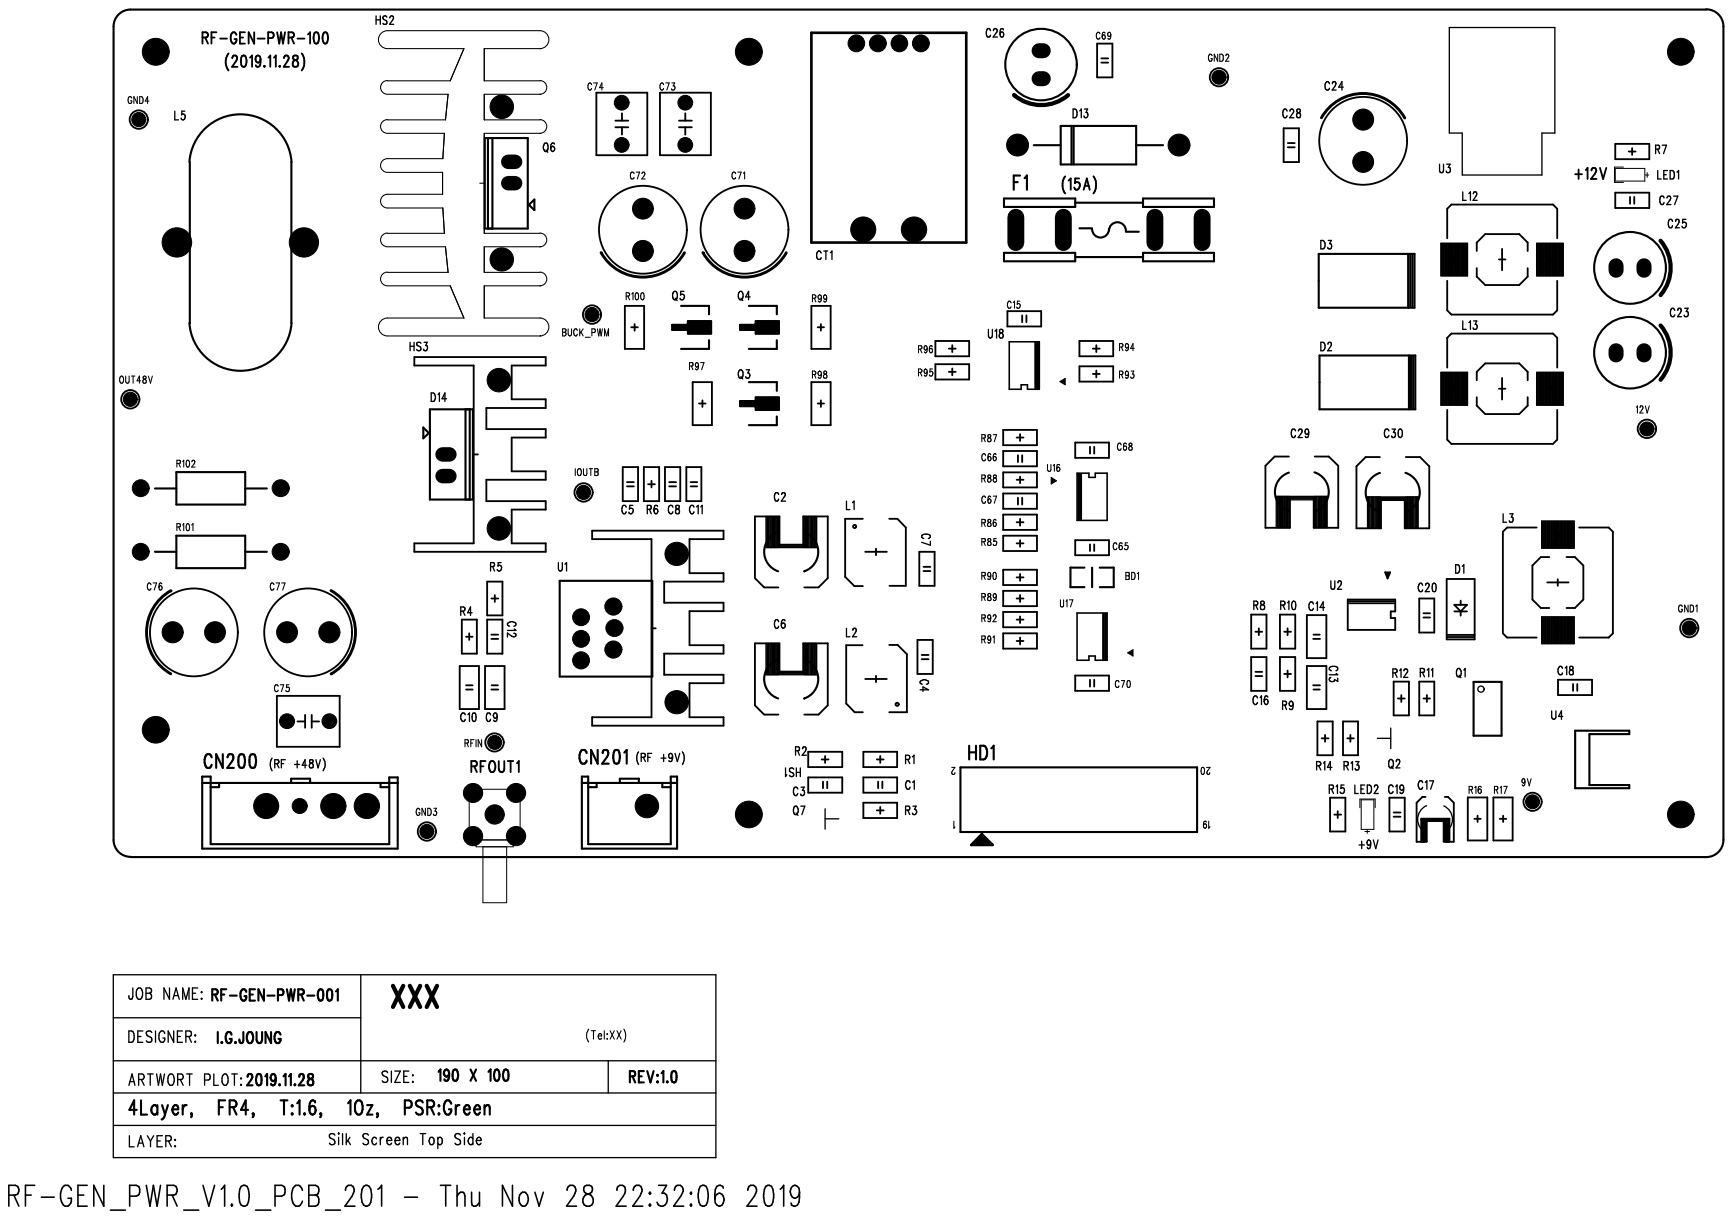
[picture p145: page 1]
