ArvidJoung/Plasma_RF_Generator/0_Block Diagram/Plasma_Gen_Block Diagram_V1.0.pdf

# Plasma RF Generator V1.0

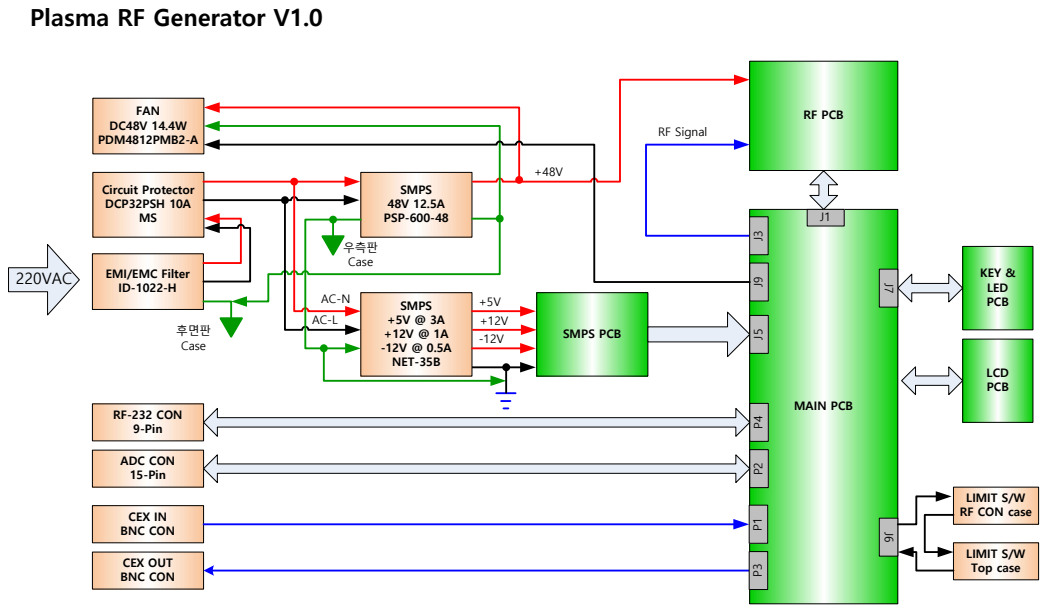
[picture p146: page 1]
