ArvidJoung/Plasma_RF_Generator/0_Realease/20191212_RF SMT Data/RF-GEN_RF_V2.0_PCB_20191209_BOTTOM.pdf

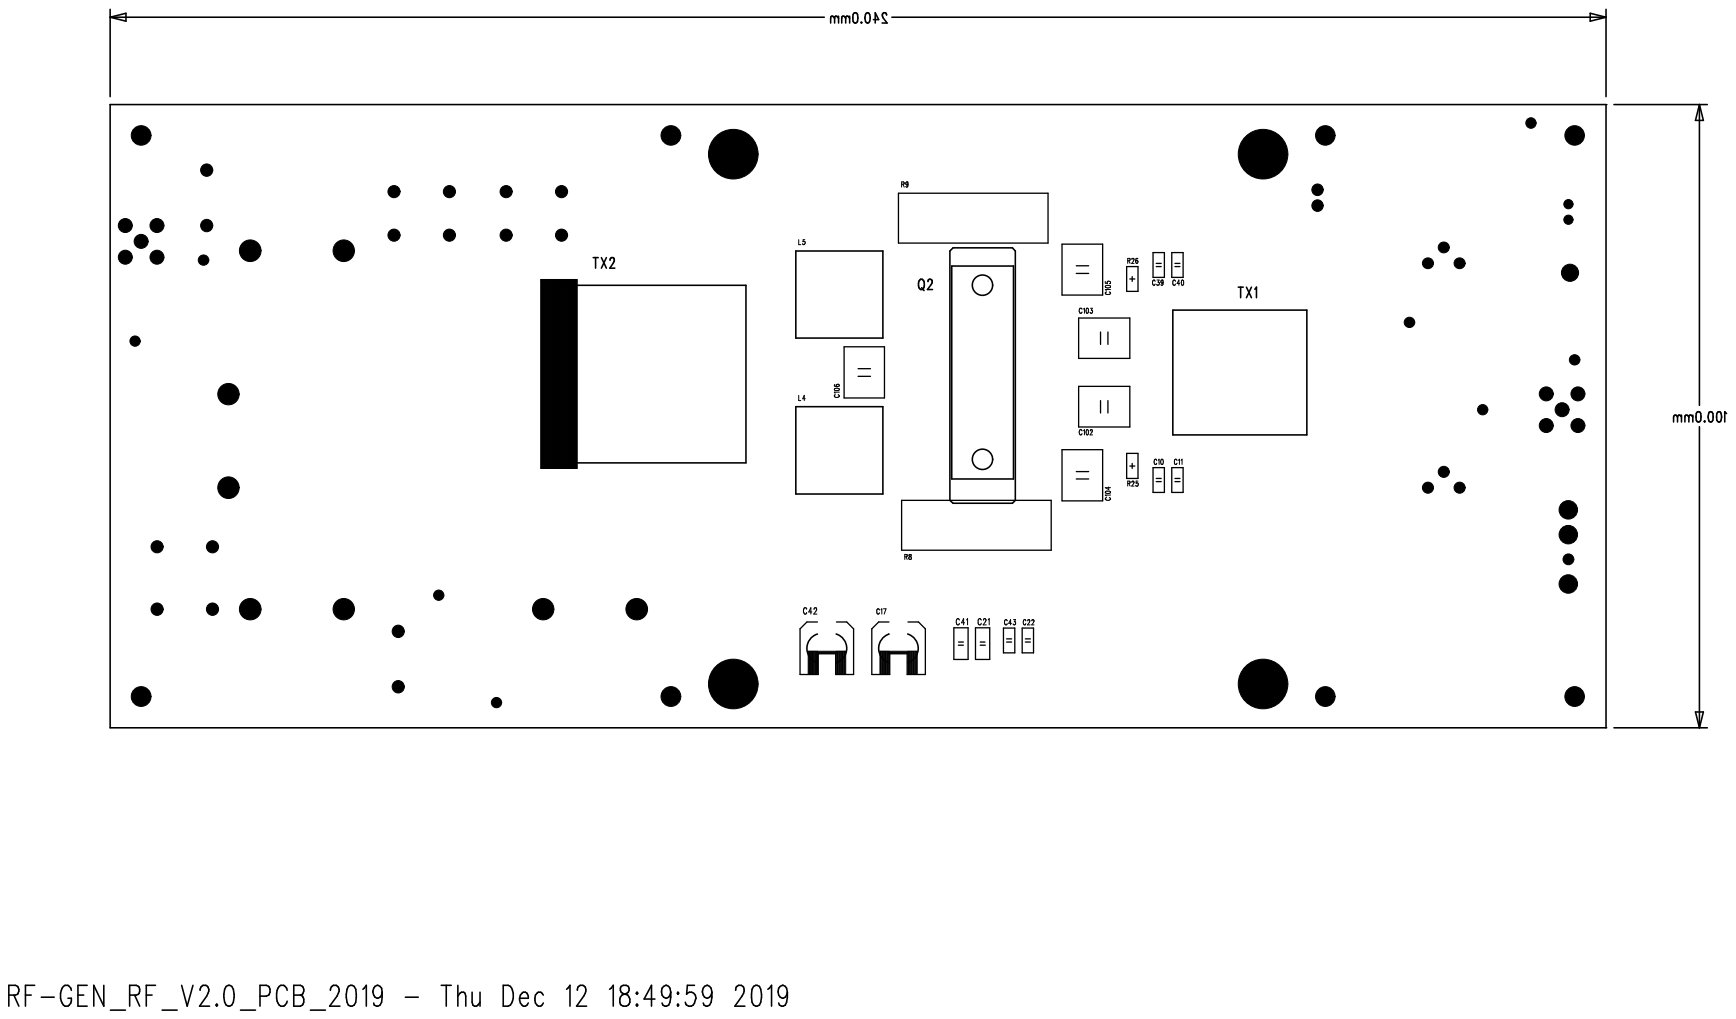
[picture p147: page 1]
