ArvidJoung/Plasma_RF_Generator/0_Realease/20191111_CPU 관련/RF-GEN_CPU_V1.0_SCH_20191111.pdf

# Femto

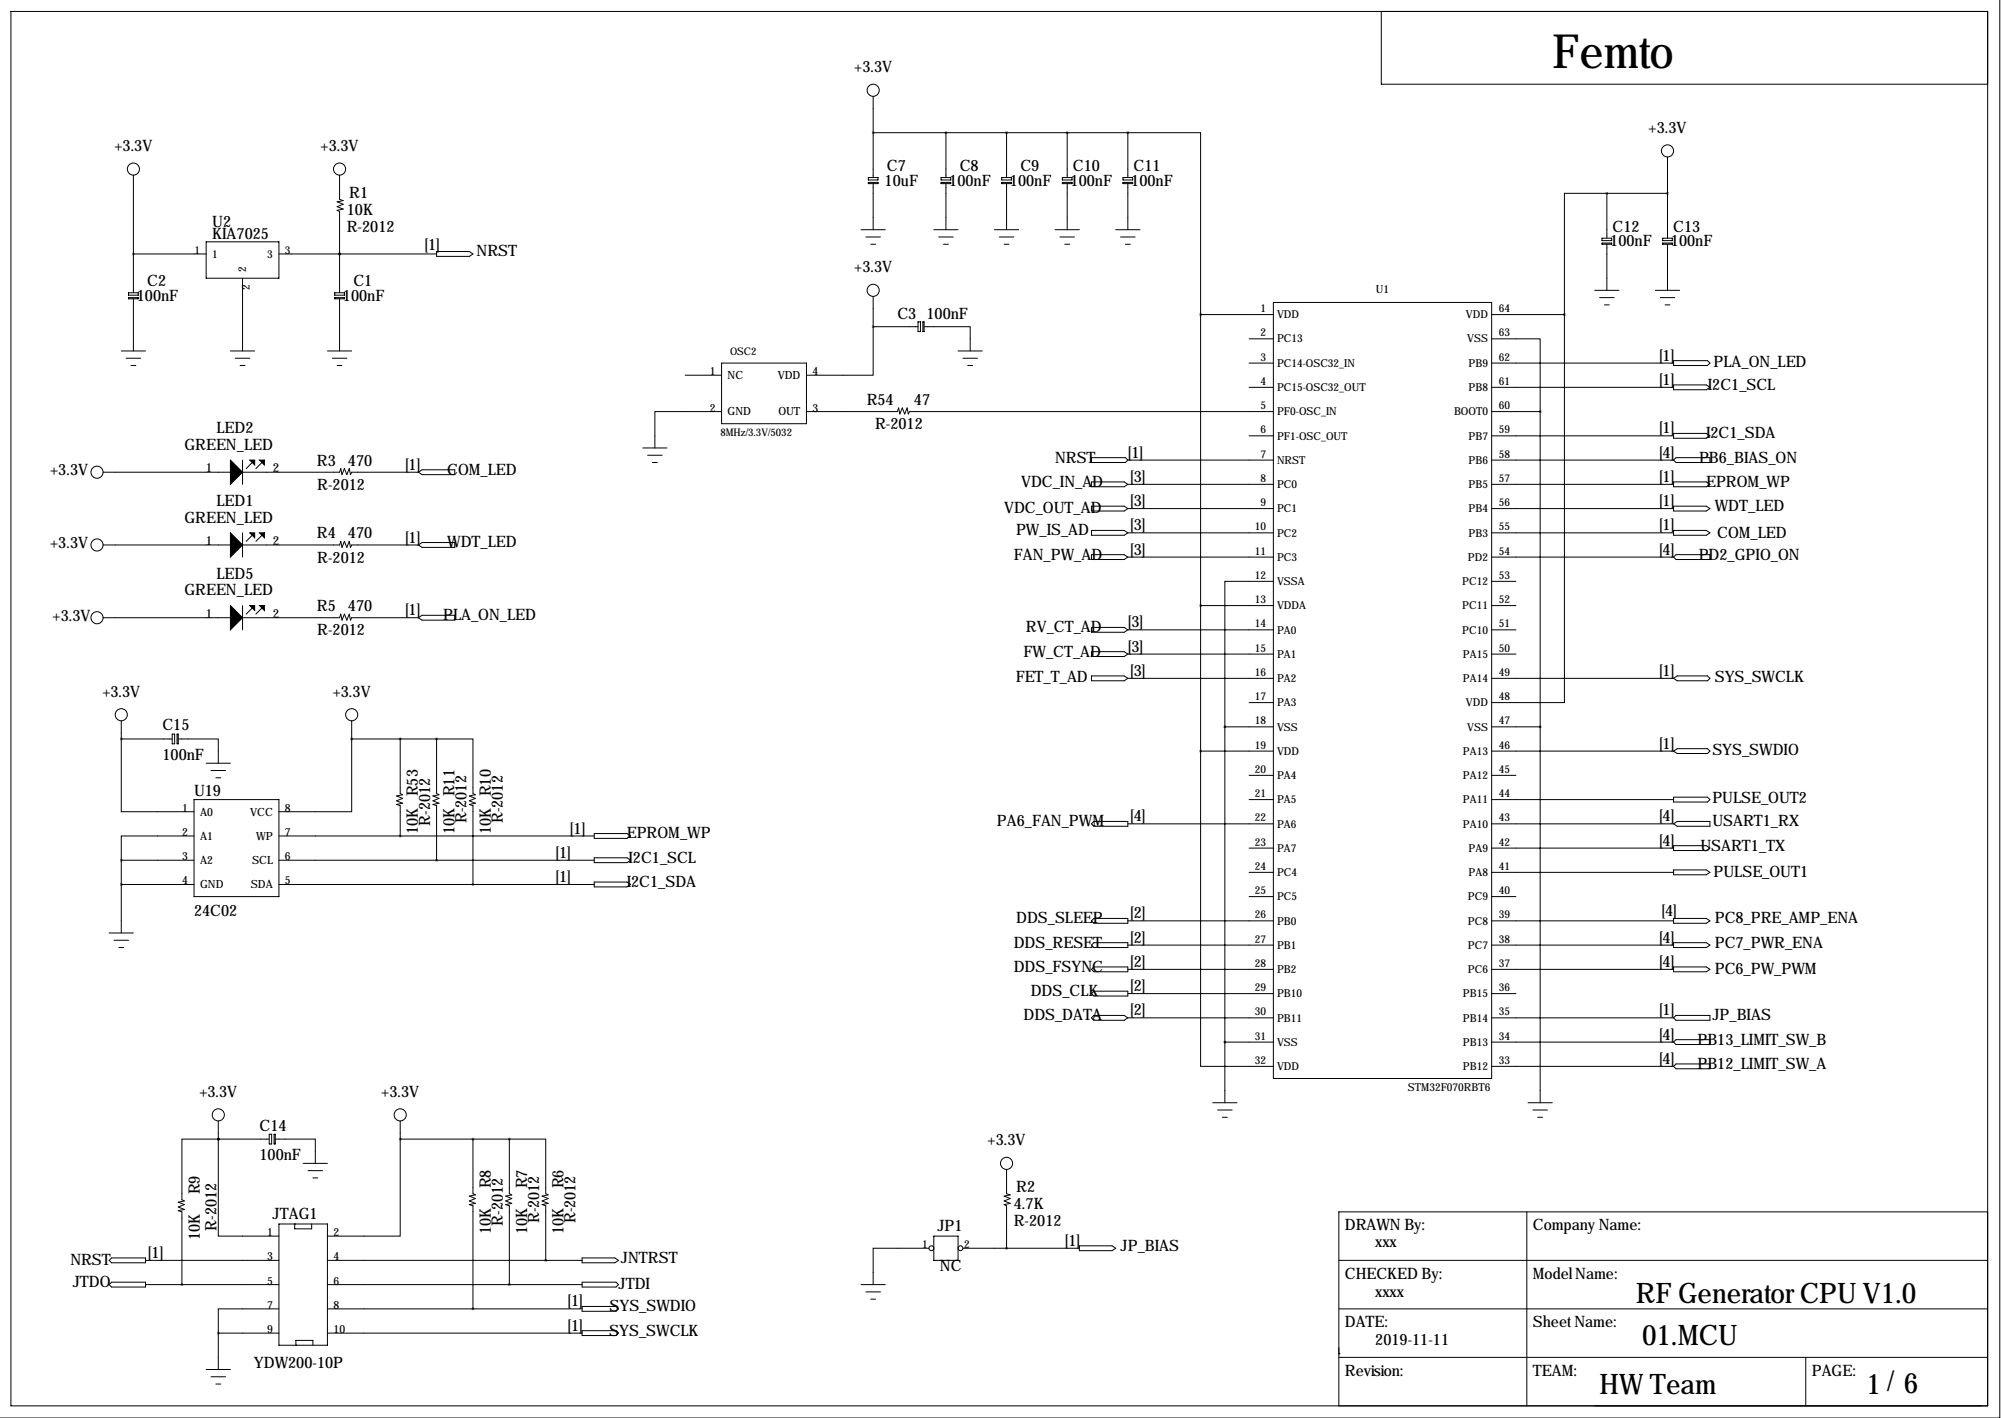
[picture p149: page 1]

2 3 4 5 | 63 VSS

6 7 | 59 PB7 58 PB6 57 PB5 56 PB4 55 PB3 54 PD2 53 PC12 52 PC11 51 PC10 50 PA15 49 PA14 48 VDD

# Femto

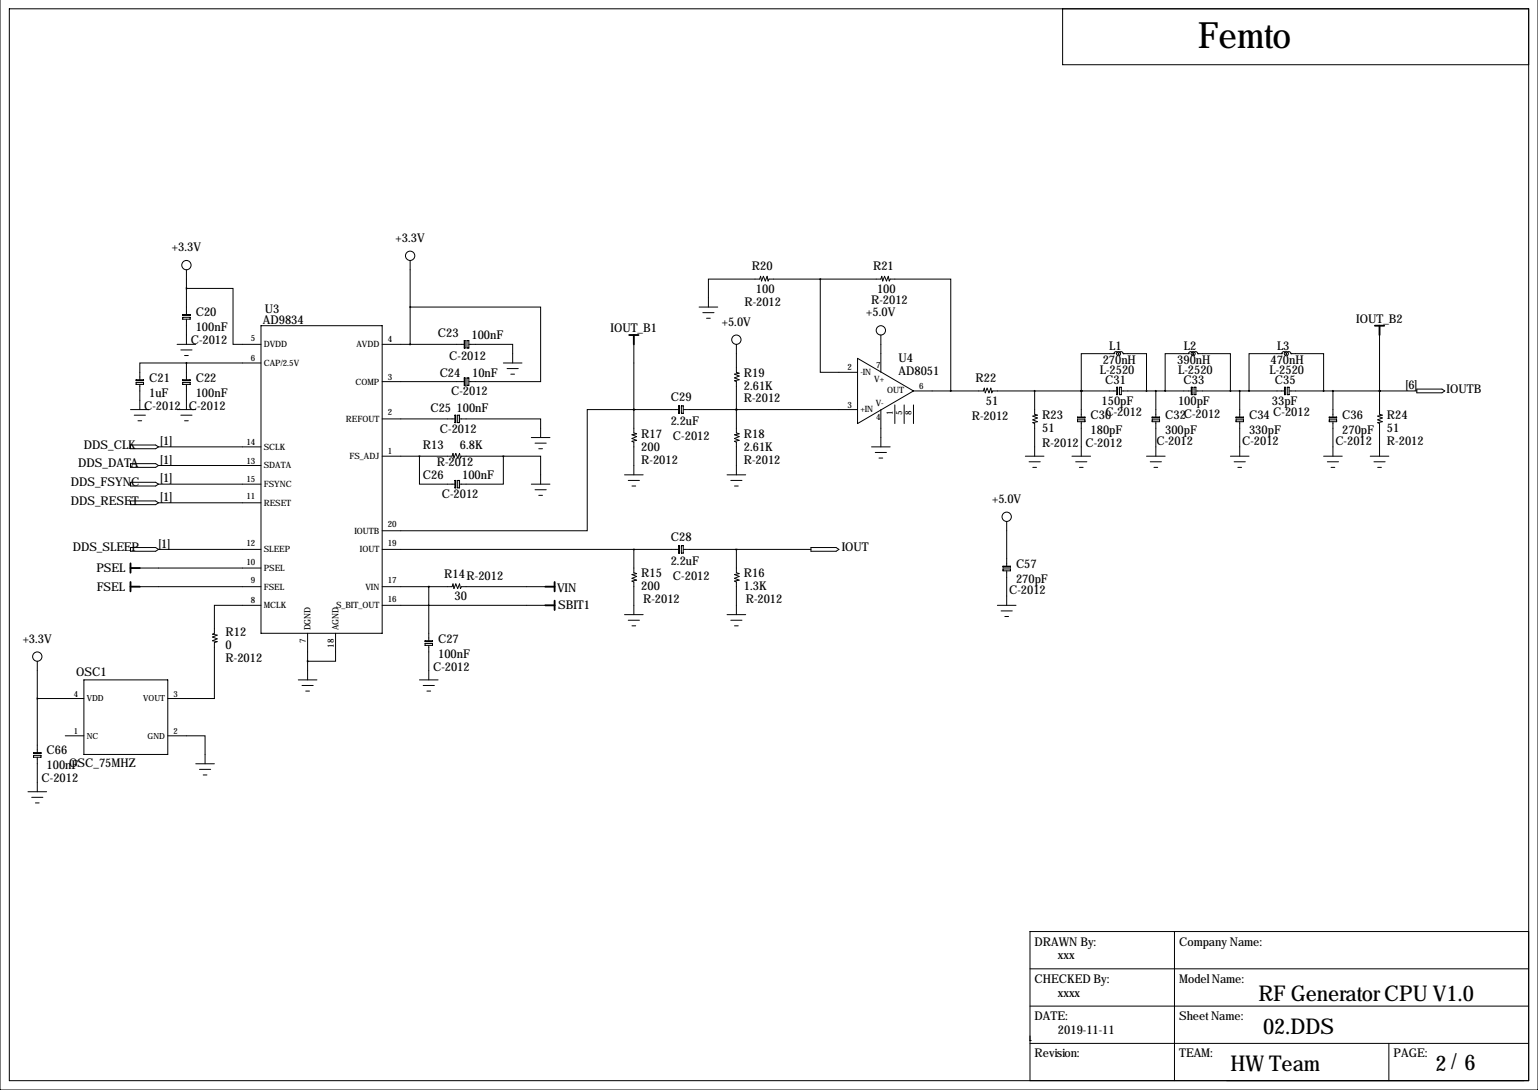
[picture p150: page 2]

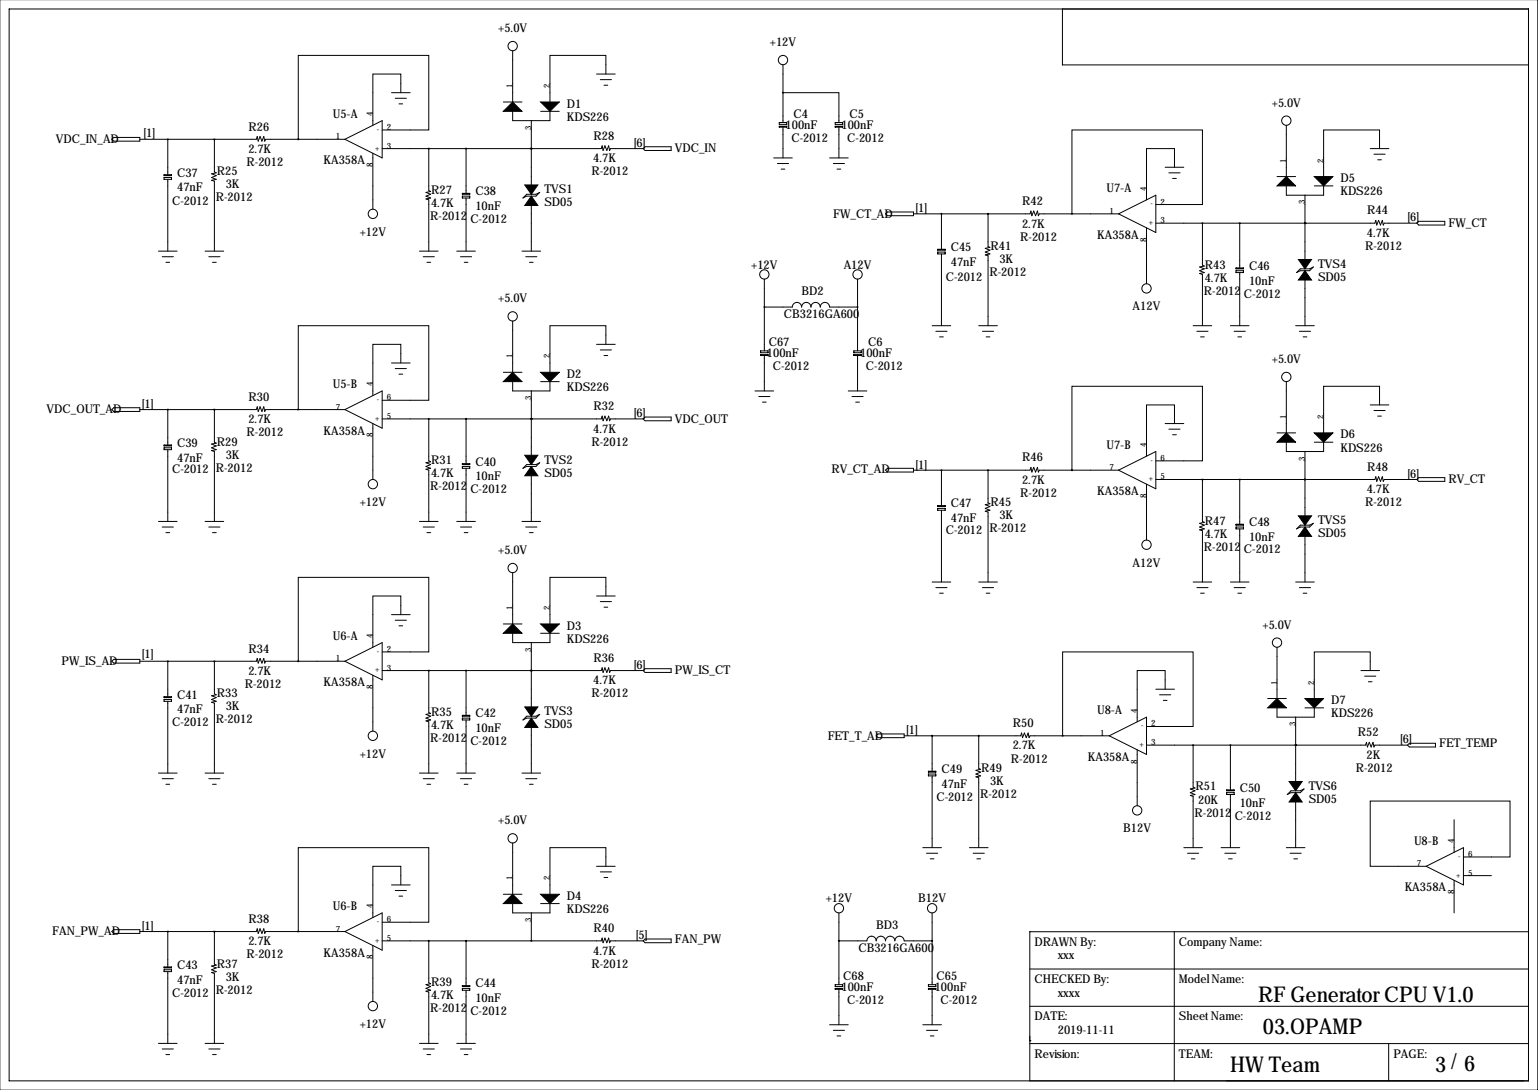
[picture p151: page 3]

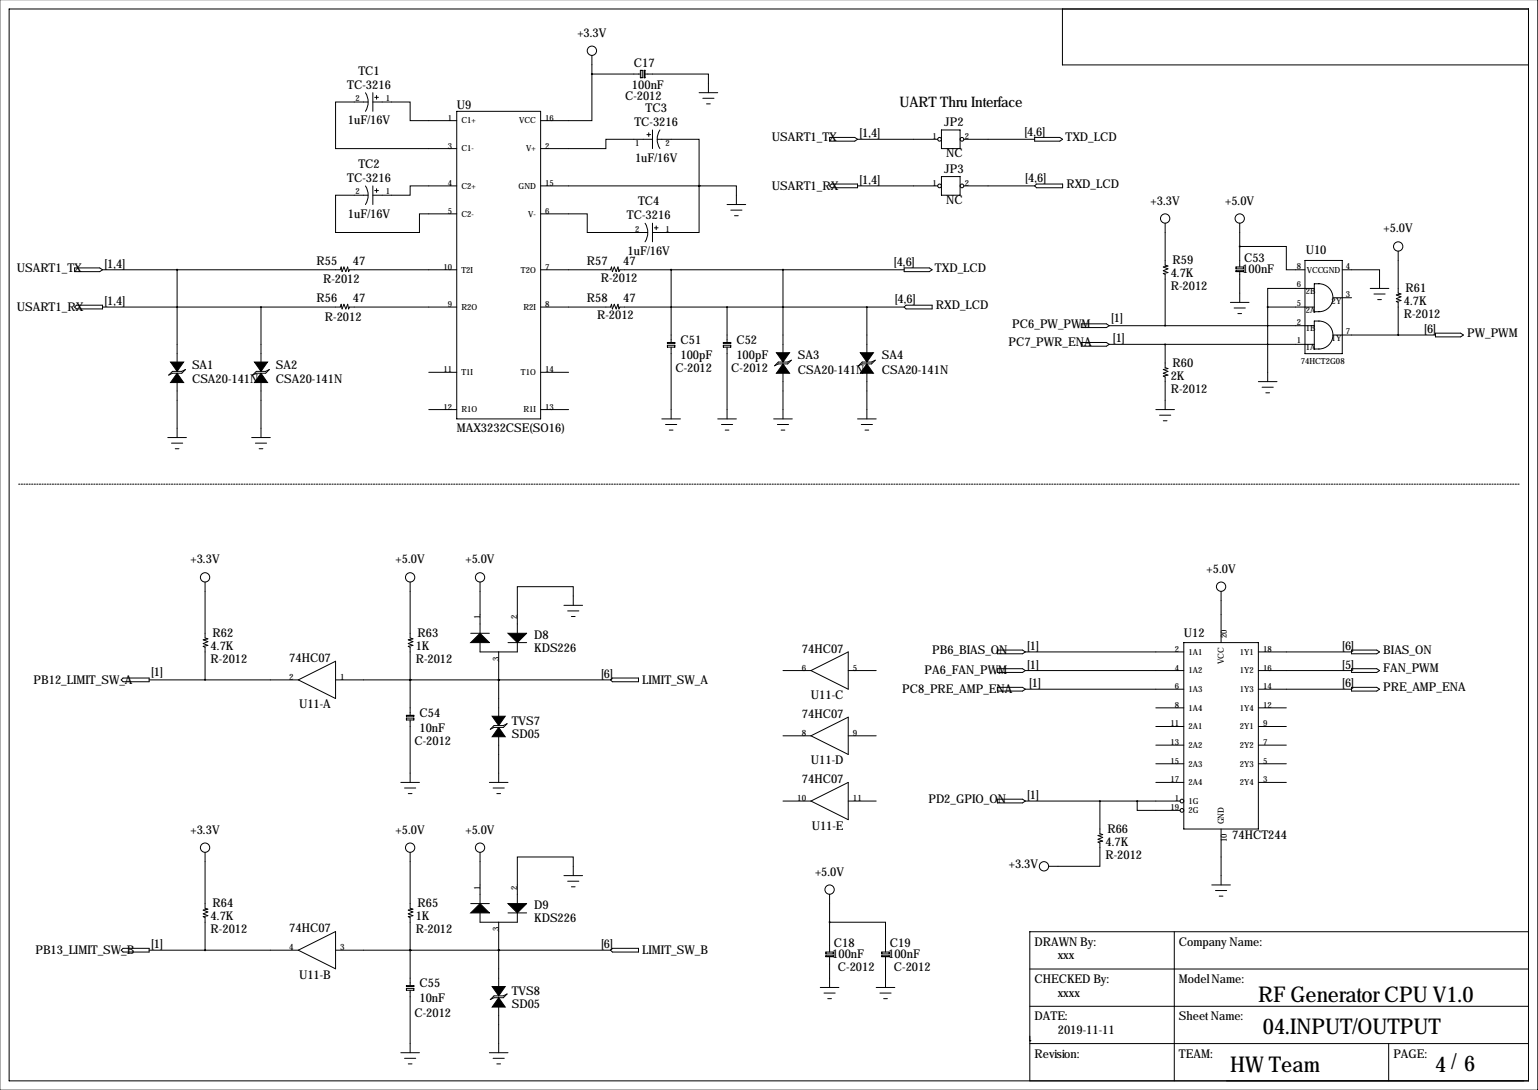
[picture p152: page 4]

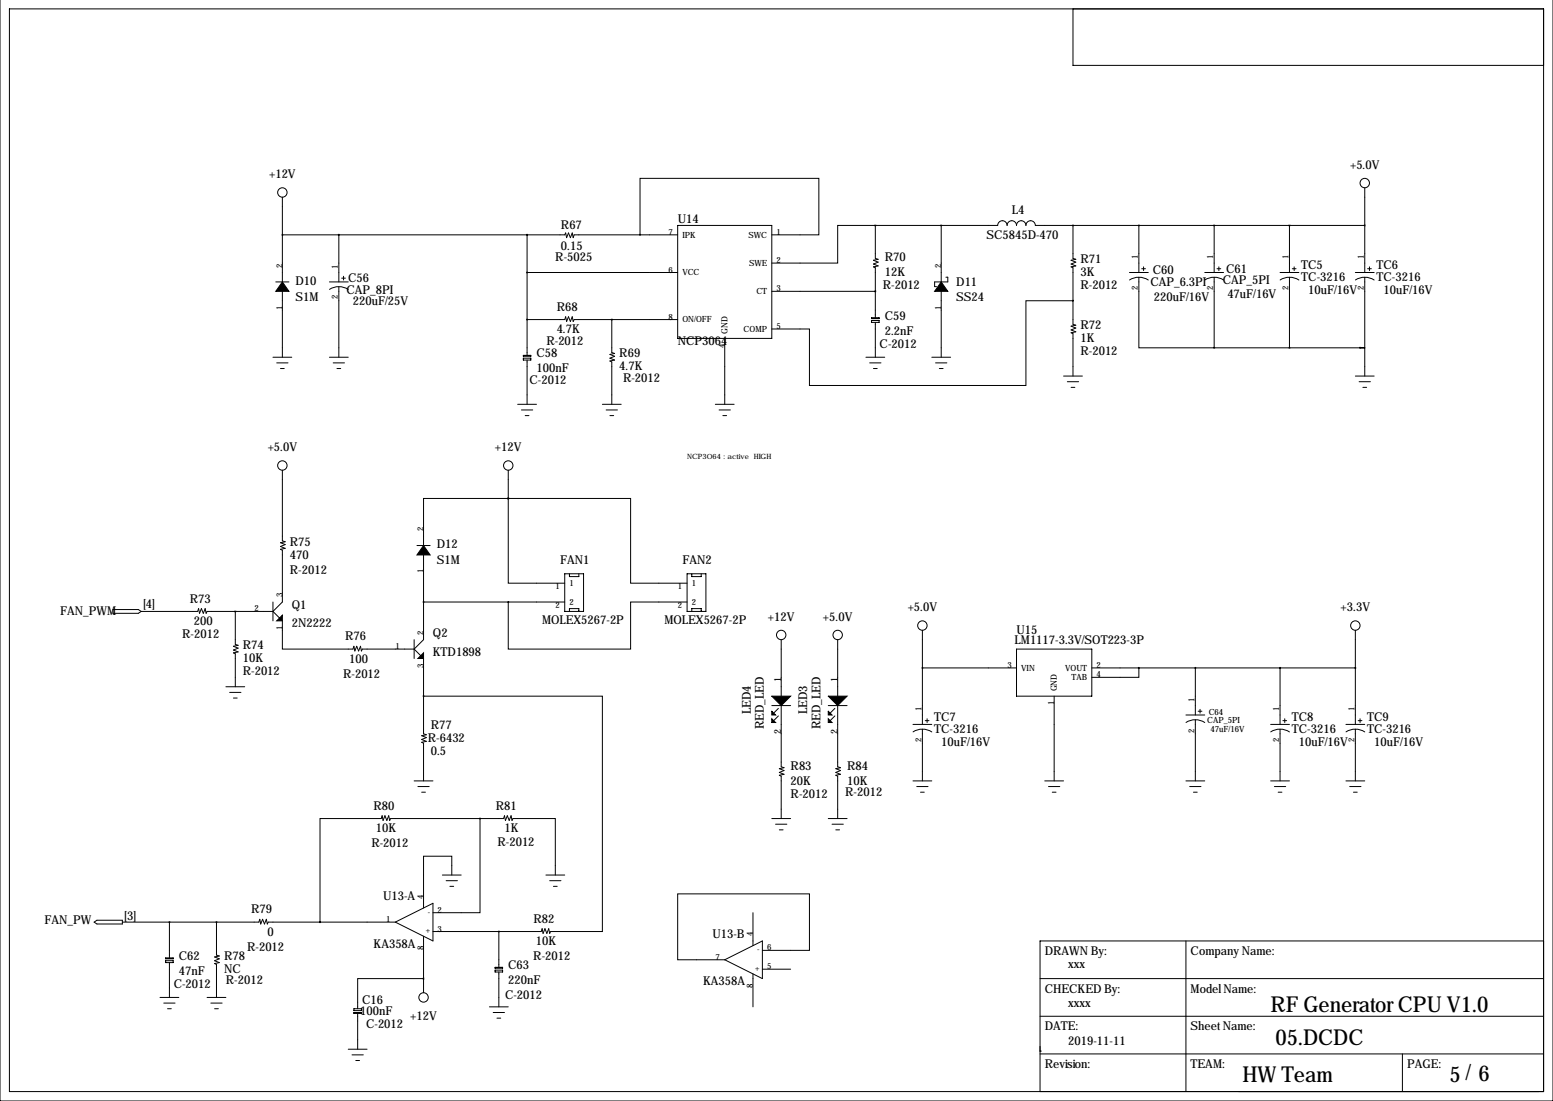
[picture p153: page 5]

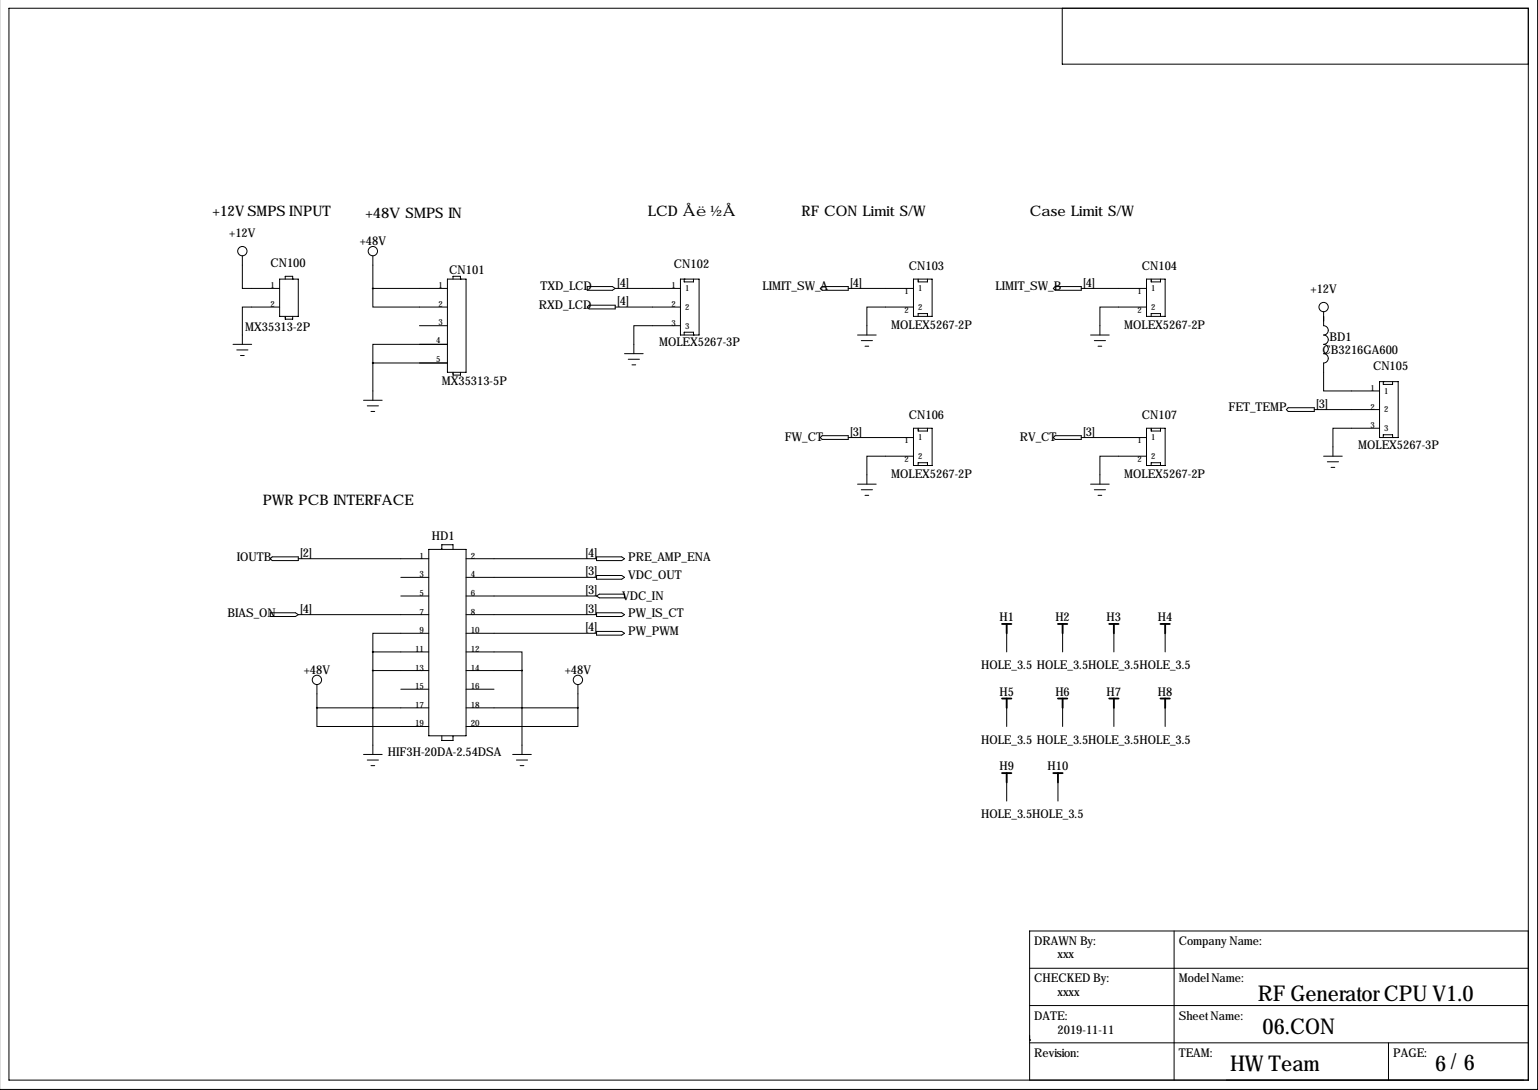
[picture p154: page 6]
