ArvidJoung/Plasma_RF_Generator/1_Schematic/Build V1.0/01_RF-GEN-CPU-001/RF-GEN_CPU_SCH_V1.0_20190825.pdf

# Femto

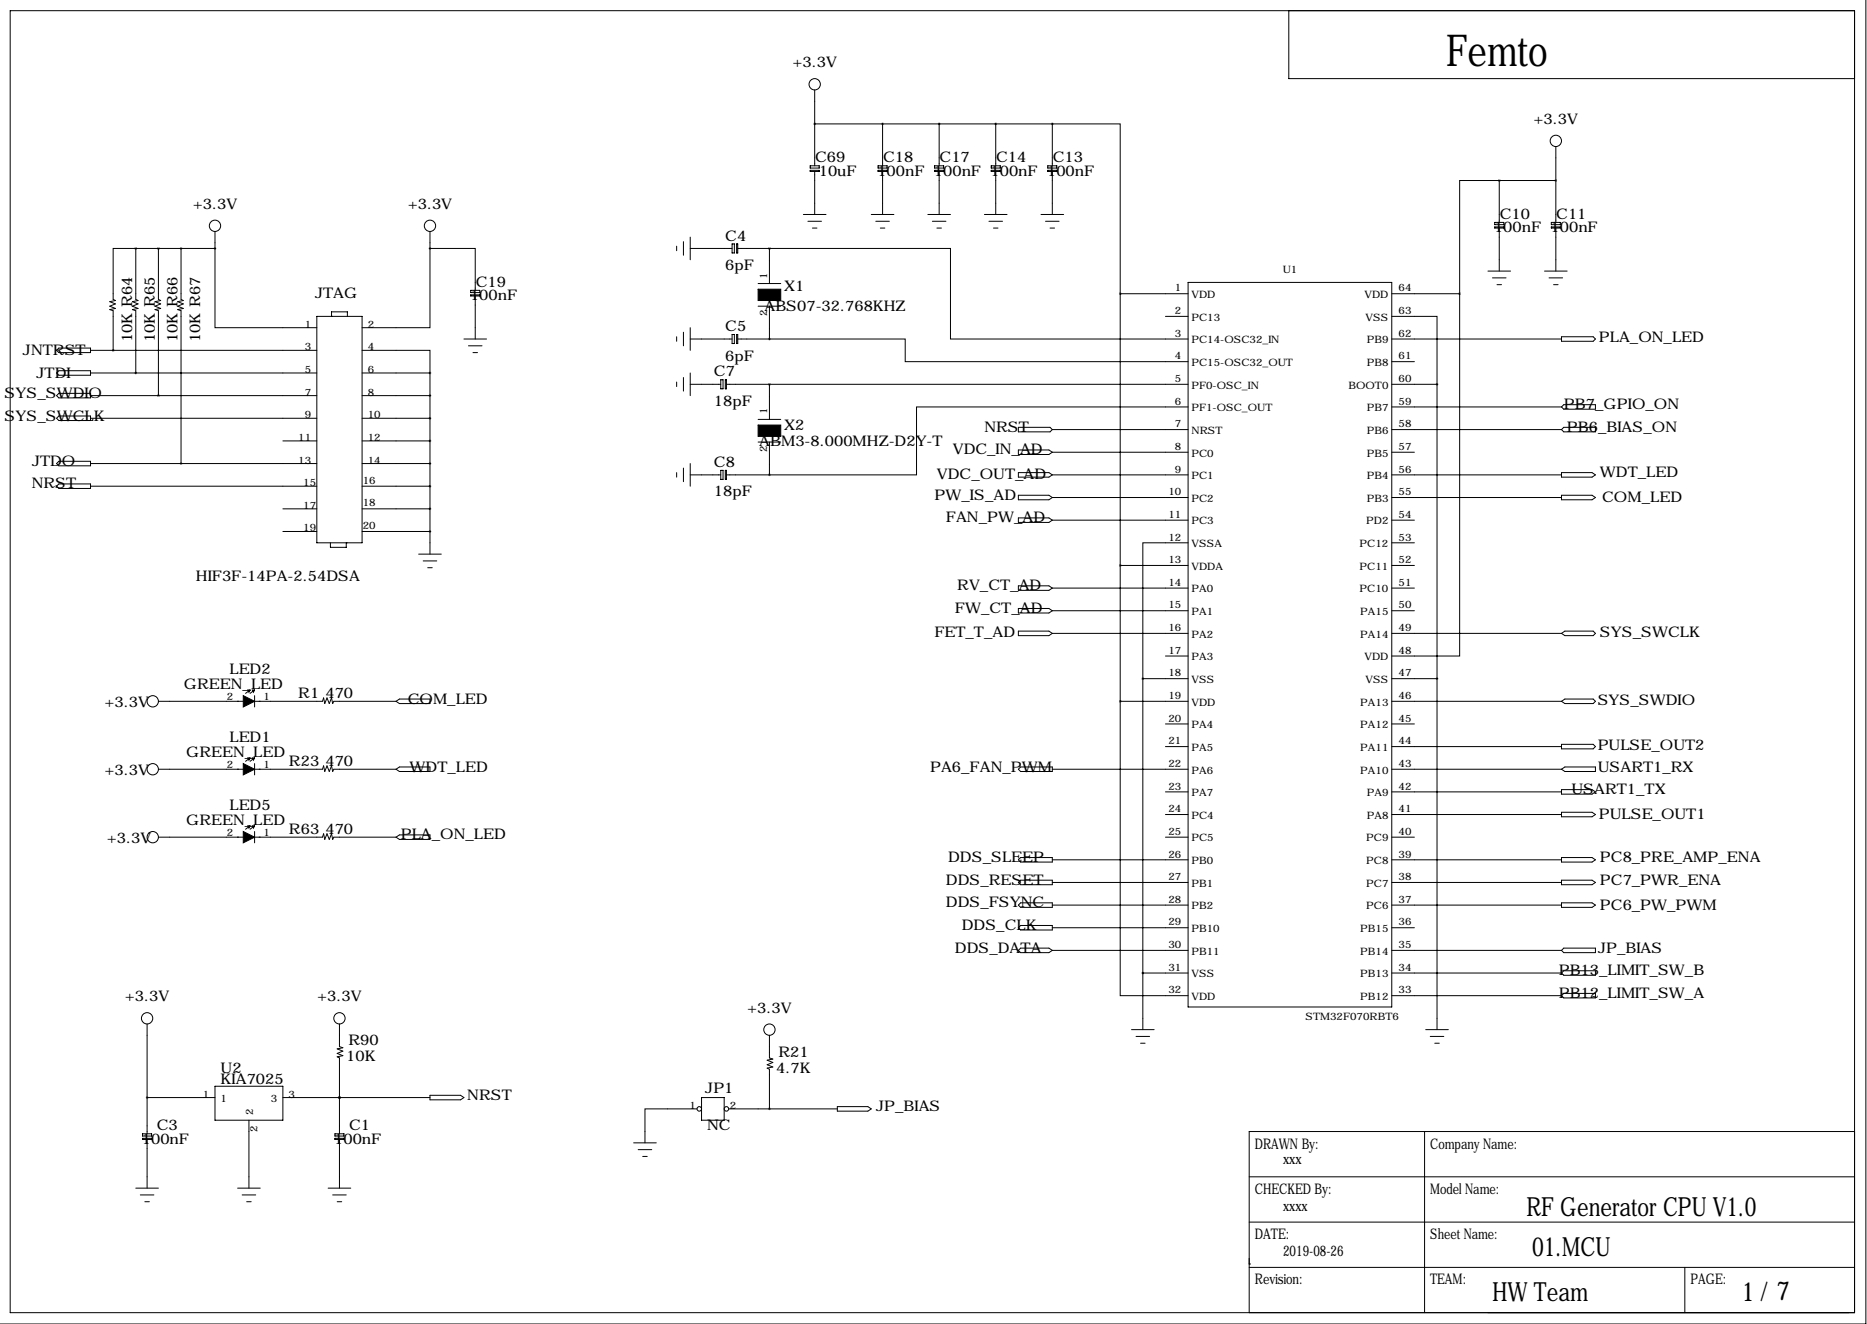
[picture p155: page 1]

# Femto

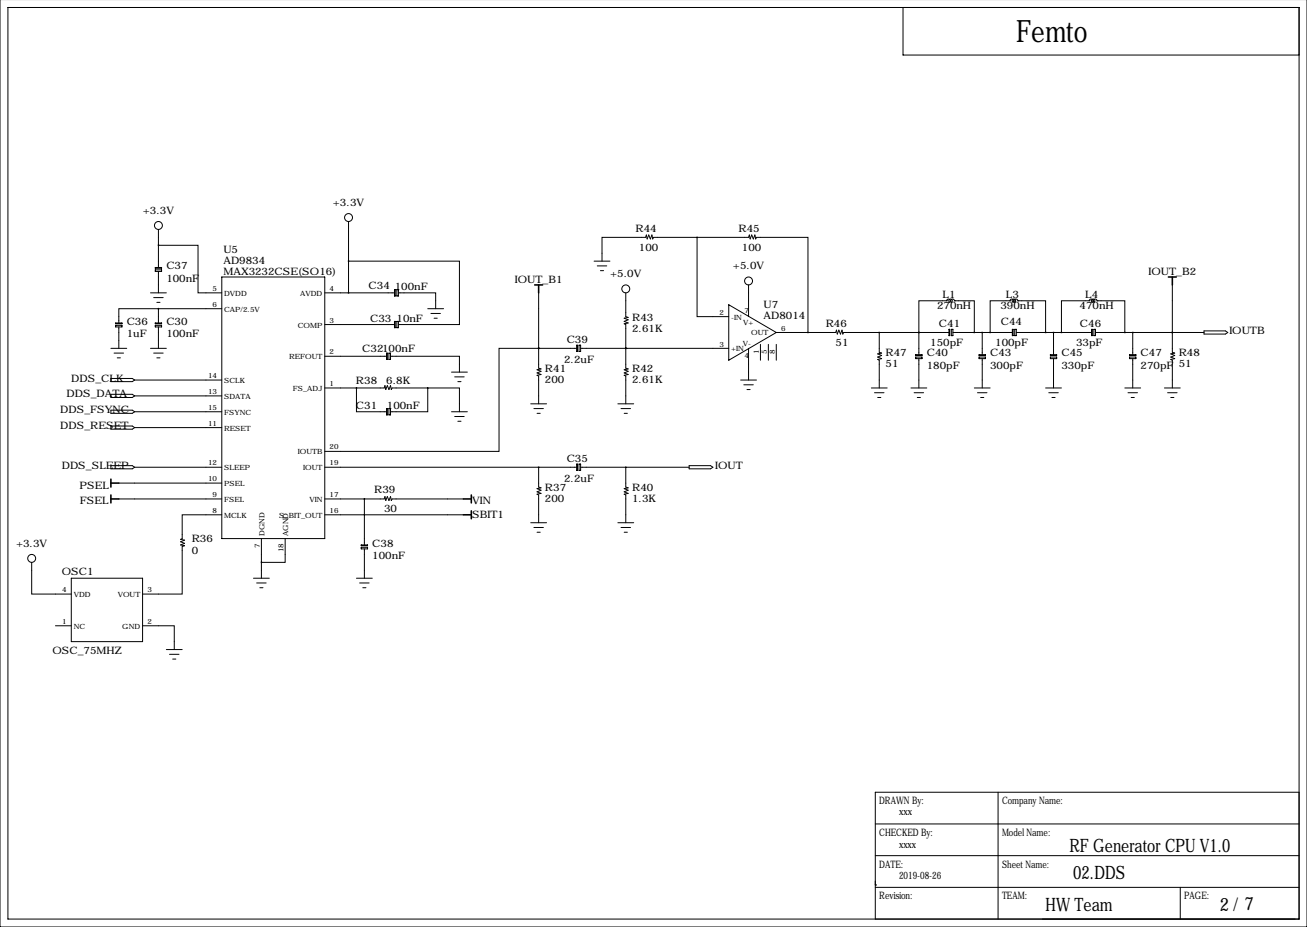
[picture p156: page 2]

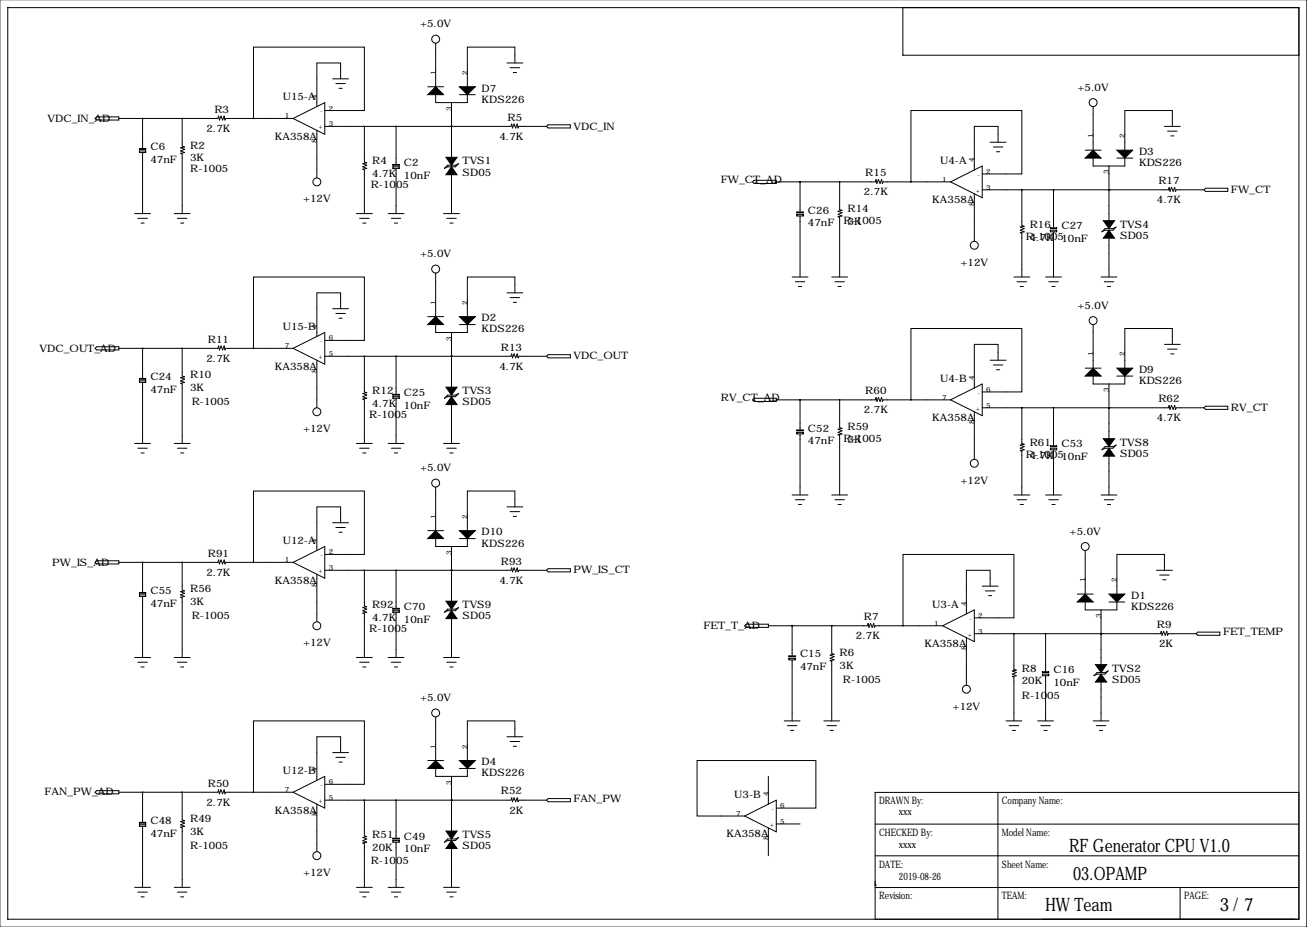
[picture p157: page 3]

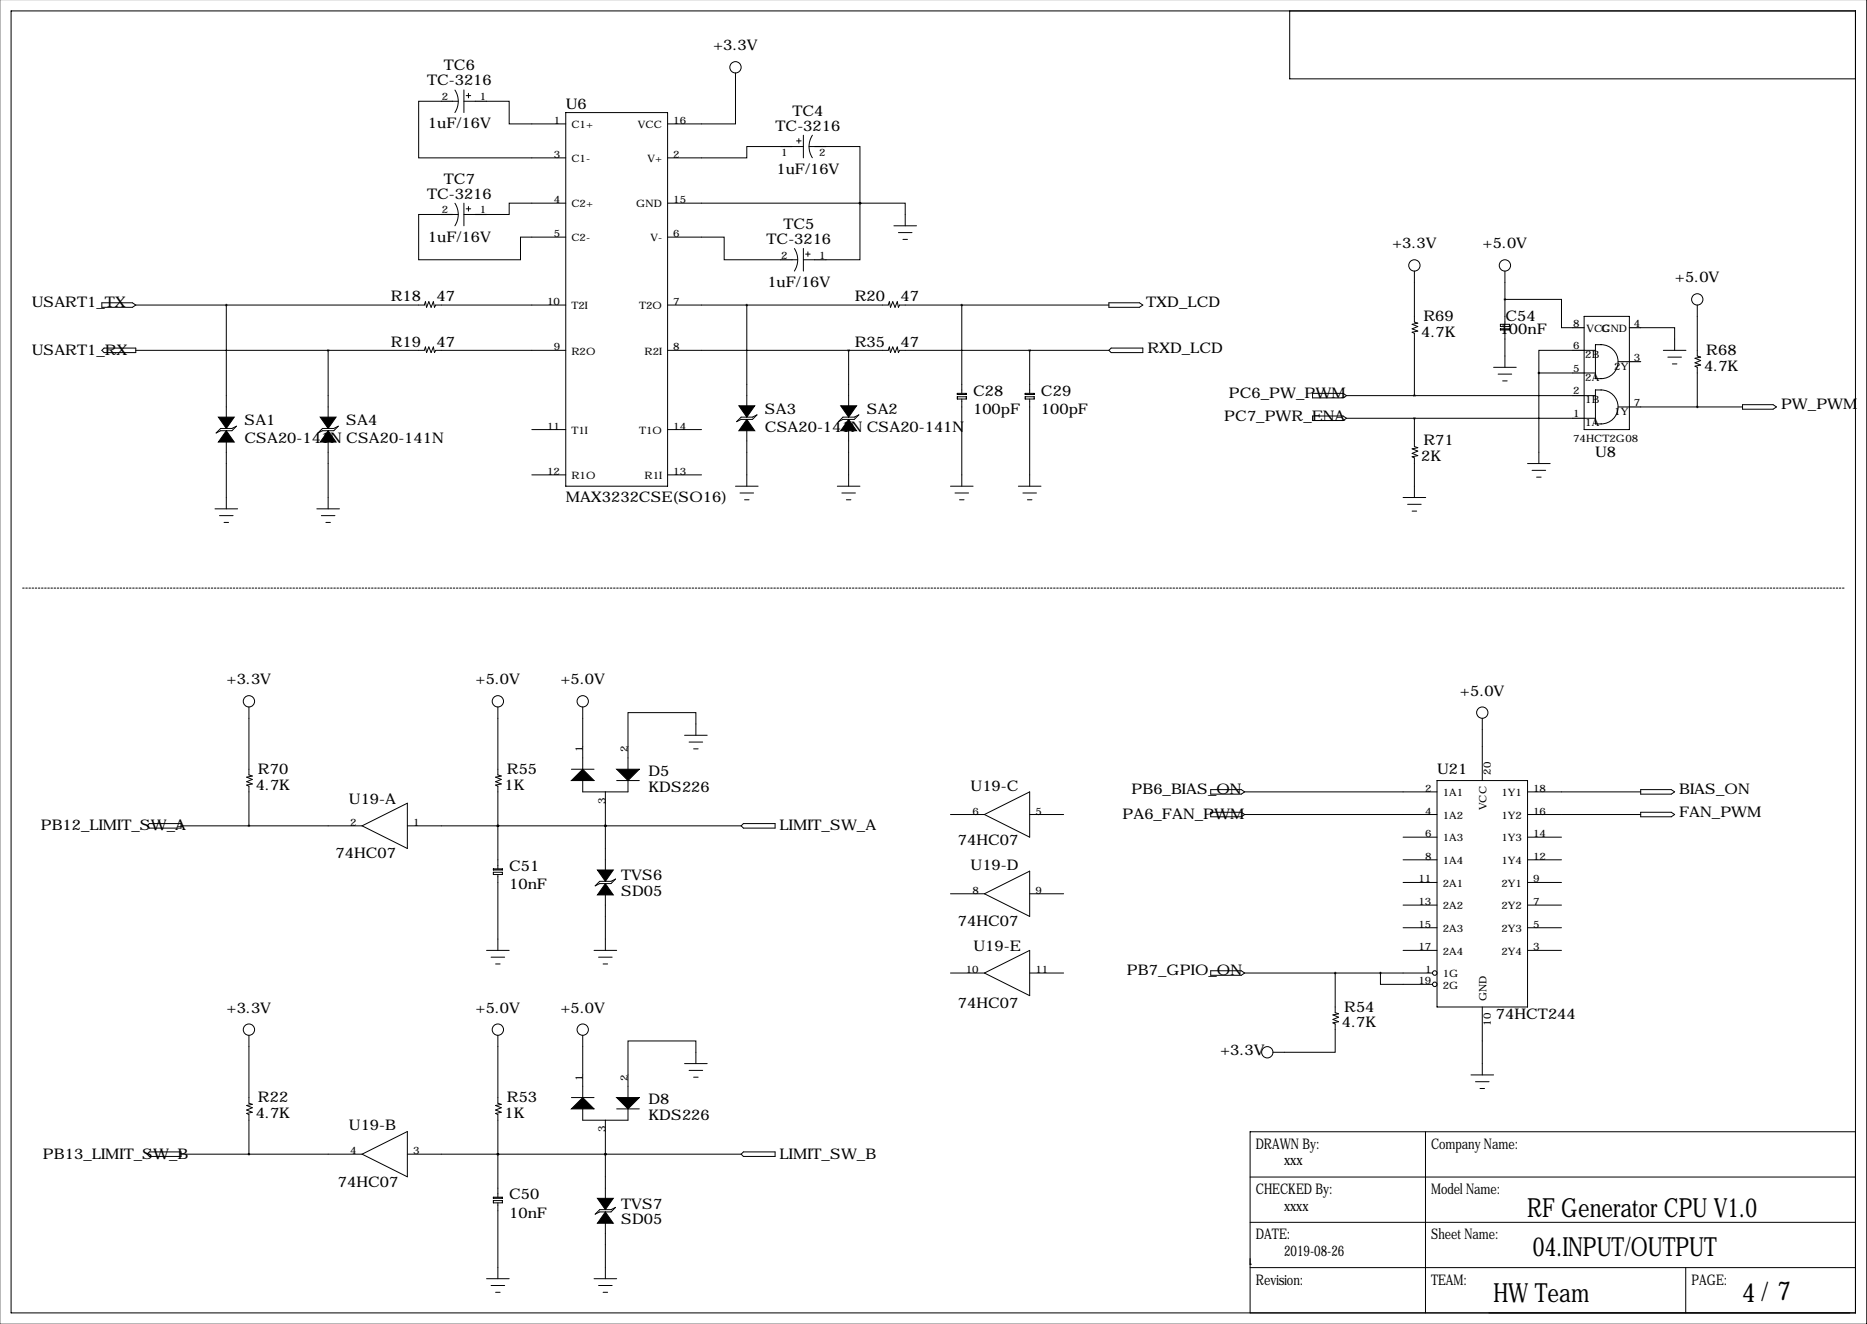
[picture p158: page 4]

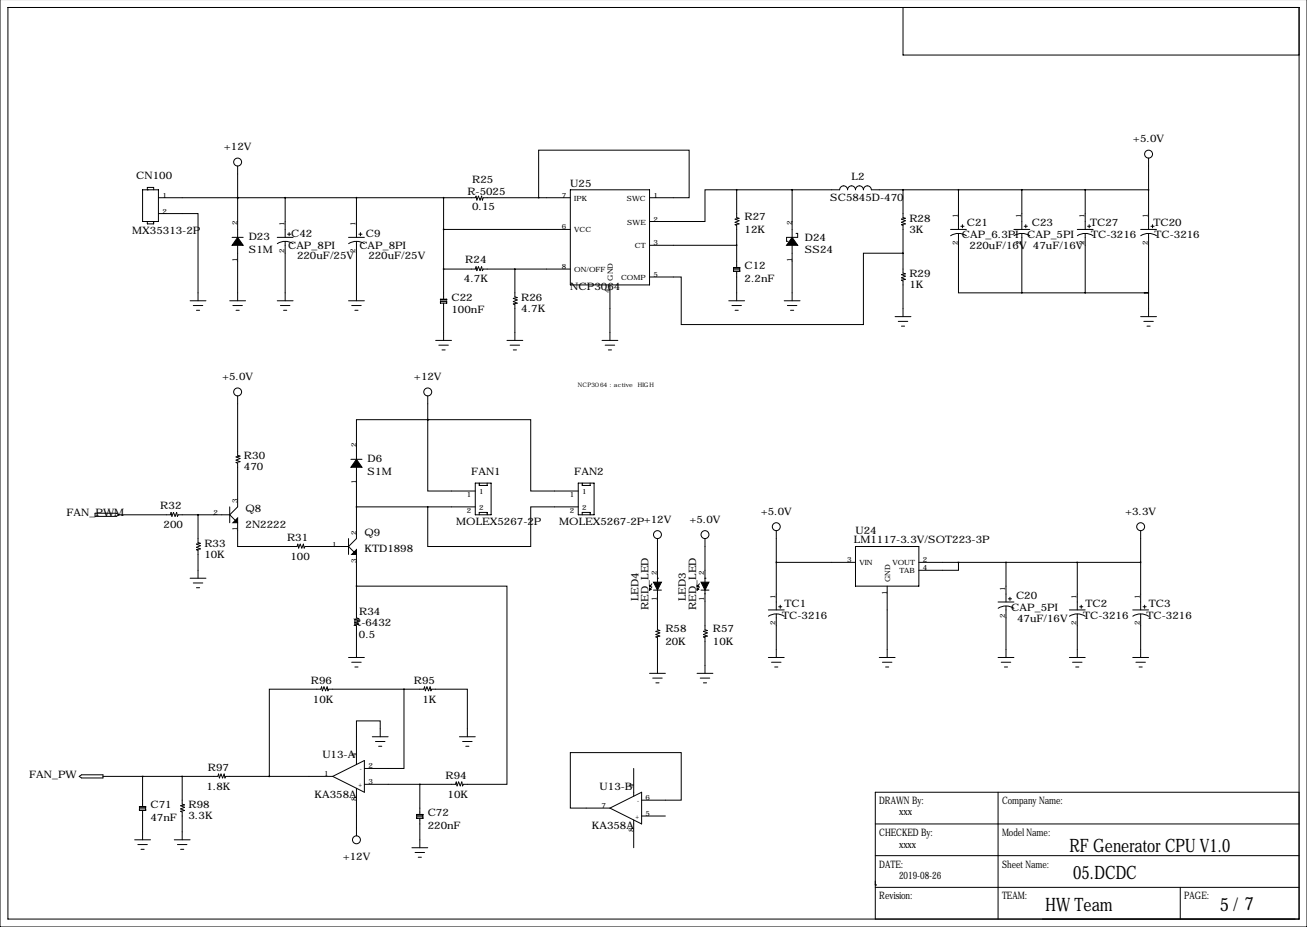
[picture p159: page 5]

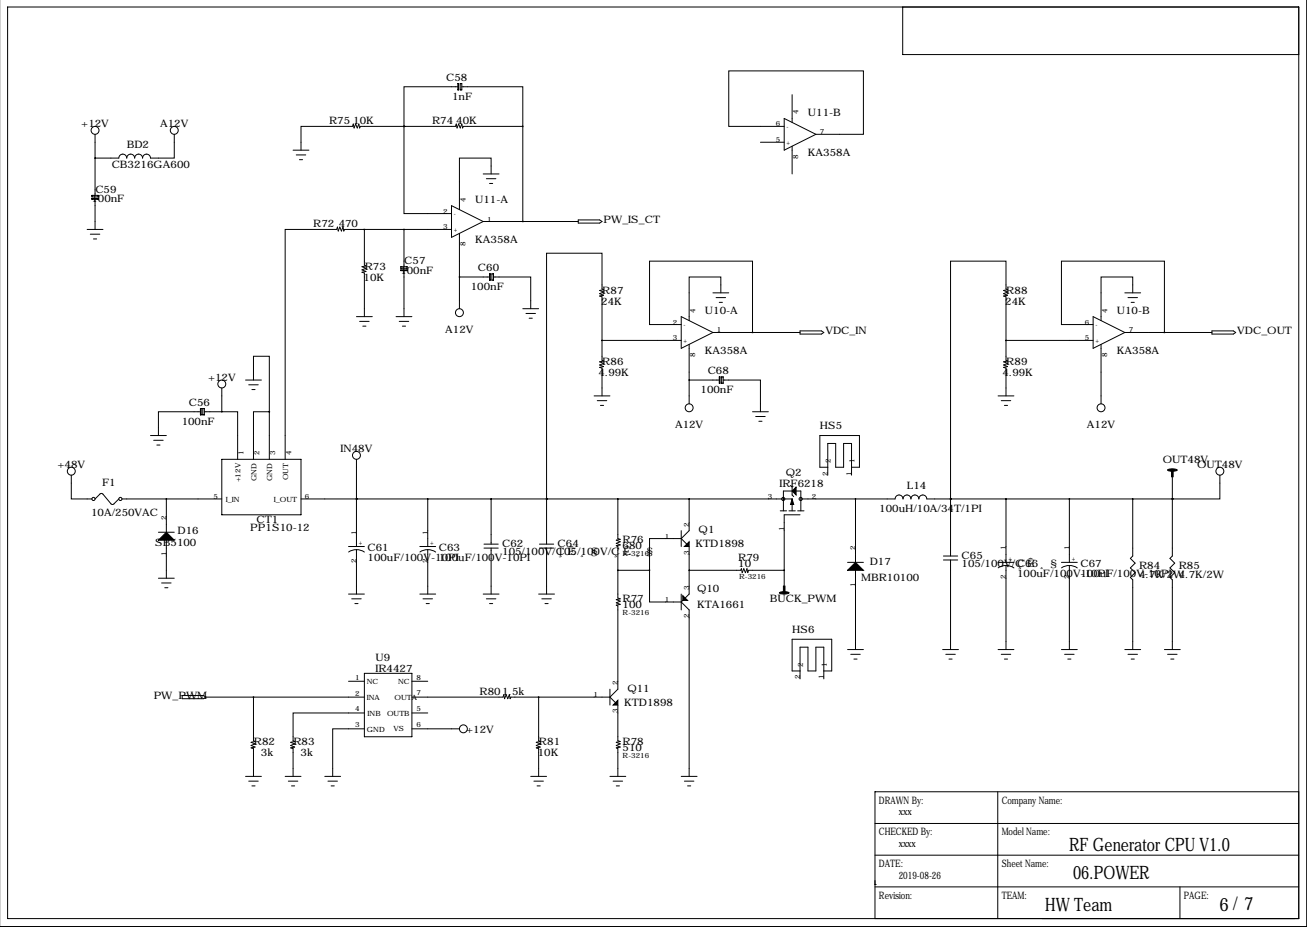
[picture p160: page 6]

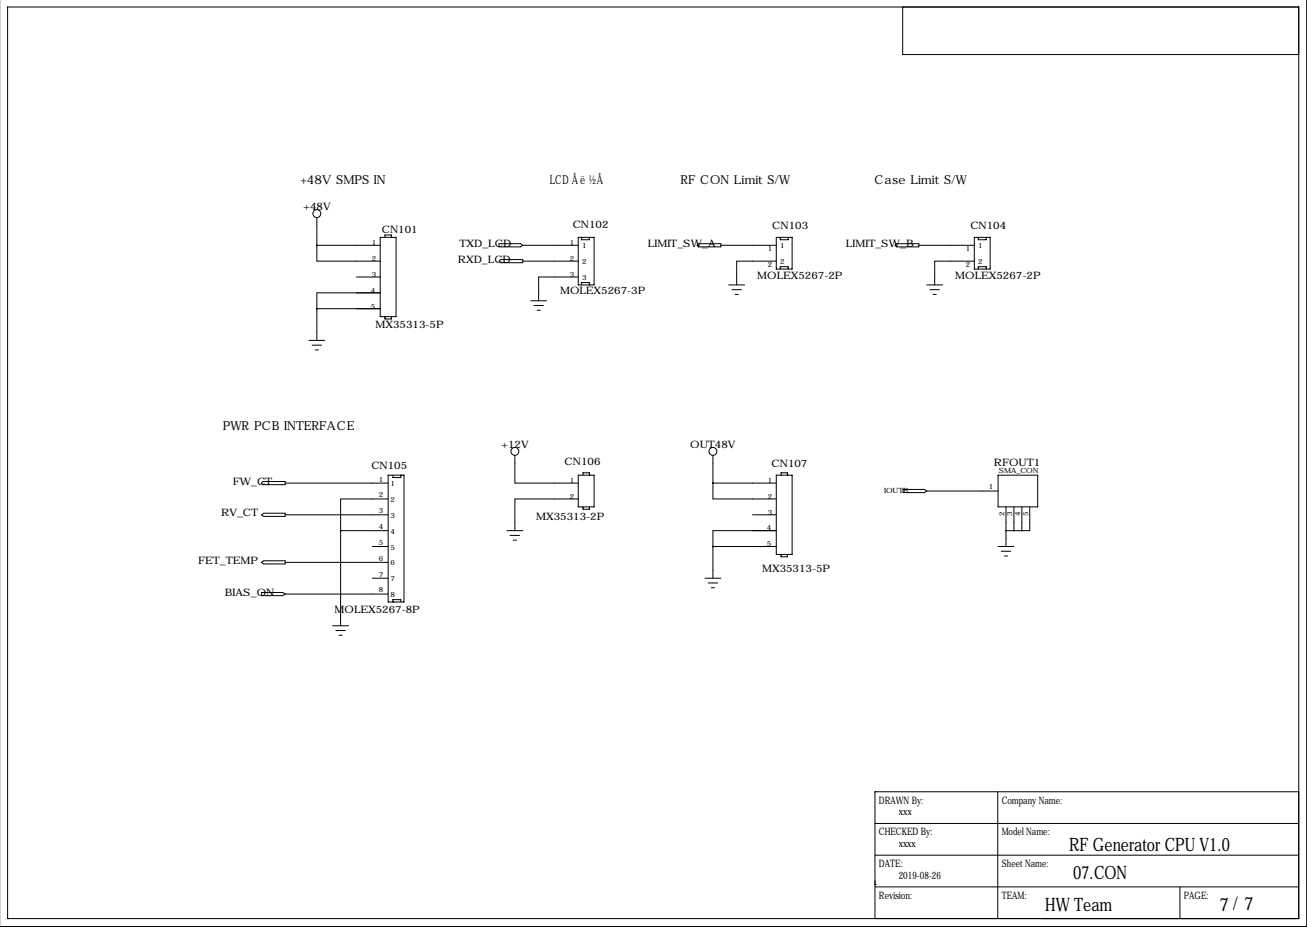
[picture p161: page 7]
DRAWN By: xxx; Company Name:; Model Name:; CHECKED By: xxxx; LCD Åë½Å; RF CON Limit S/W; Case Limit S/W; +48V SMPS IN; MOLEX5267-2P; MOLEX5267-3P; RFOUT1 SMA_CON; MOLEX5267-8P; TXD_LCD; LIMIT_SW_A; LIMIT_SW_B; RXD_LCD; FET_TEMP; BIAS_ON; OUT48V; IOUTB

PWR PCB INTERFACE

RF Generator CPU V1.0
07.CON
