ArvidJoung/Plasma_RF_Generator/(list of files, drawings)

Other design files:
1_Schematic/Backup/Plasma_RF_Gen_V1.0_POWER_PCB_20180811.pcb
1_Schematic/Backup/Plasma_RF_Gen_V1.0_POWER_PCB_20180917.pcb
1_Schematic/Backup/Plasma_RF_Gen_V1.0_POWER_PCB_20180929_V9.5.pcb
1_Schematic/Backup/Plasma_RF_Gen_V1.0_POWER_PCB_20181104_VX2.3.pcb
1_Schematic/Backup/Plasma_RF_Gen_V1.0_POWER_PCB_20181206_VX2.3.pcb
1_Schematic/Backup/Plasma_RF_Gen_V1.0_POWER_PCB_20181217_V9.5.pcb
1_Schematic/Backup/Plasma_RF_Gen_V1.0_POWER_PCB_20181217_VX2.3.pcb
1_Schematic/Backup/Plasma_RF_Gen_V1.0_POWER_PCB_20190212_V9.5.pcb
1_Schematic/Backup/Plasma_RF_Gen_V1.0_POWER_PCB_20190310_V9.5.pcb
1_Schematic/Backup/Plasma_RF_Gen_V1.0_POWER_PCB_20190318_V9.5.pcb
1_Schematic/Backup/Plasma_RF_Gen_V1.0_POWER_PCB_20190326_V9.5.pcb
1_Schematic/Build V0.1/RF-GEN_CPU_PCB_V1.0_20191008.pcb
1_Schematic/Build V1.0/01_RF-GEN-CPU-001/MIS-PEN-CPU-100_190923.pcb
1_Schematic/Build V1.0/01_RF-GEN-CPU-001/RF-GEN_CPU_PCB_V1.0_20191003.pcb
1_Schematic/Build V1.0/01_RF-GEN-CPU-001/RF-GEN_CPU_PCB_V1.0B_20191012.pcb
1_Schematic/Build V1.0/01_RF-GEN-CPU-001/RF-GEN_CPU_V1.0_PCB_20191024.pcb
1_Schematic/Build V1.0/01_RF-GEN-CPU-001/RF-GEN_CPU_V1.0_PCB_20191025_VX.pcb
1_Schematic/Build V1.0/01_RF-GEN-CPU-001/RF-GEN_CPU_V1.0_PCB_20191027.pcb
1_Schematic/Build V1.0/01_RF-GEN-CPU-001/RF-GEN_CPU_V1.0_PCB_20191105.pcb
1_Schematic/Build V1.0/01_RF-GEN-CPU-001/RF-GEN_CPU_V1.0_PCB_20191105_VX.pcb
1_Schematic/Build V1.0/01_RF-GEN-CPU-001/RF-GEN_CPU_V1.0_PCB_20191111.pcb
1_Schematic/Build V1.0/01_RF-GEN-CPU-001/RF-GEN_CPU_V1.0_PCB_20191113.pcb
1_Schematic/Build V1.0/02_RF-GEN-PWR-001/RF-GEN_CPU_PCB_V1.0_20191008.pcb
1_Schematic/Build V1.0/02_RF-GEN-PWR-001/RF-GEN_CPU_PCB_V1.0_20191019.pcb
1_Schematic/Build V1.0/02_RF-GEN-PWR-001/RF-GEN_CPU_PCB_V1.0_20191019_9.5.pcb
1_Schematic/Build V1.0/02_RF-GEN-PWR-001/RF-GEN_CPU_PCB_V1.0_20191019_9.5_B.pcb
1_Schematic/Build V1.0/02_RF-GEN-PWR-001/RF-GEN_PWR_V1.0_PCB_20191024_2.pcb
1_Schematic/Build V1.0/02_RF-GEN-PWR-001/RF-GEN_PWR_V1.0_PCB_20191028.pcb
1_Schematic/Build V1.0/02_RF-GEN-PWR-001/RF-GEN_PWR_V1.0_PCB_20191105.pcb
1_Schematic/Build V1.0/02_RF-GEN-PWR-001/RF-GEN_PWR_V1.0_PCB_20191113.pcb
1_Schematic/Build V1.0/02_RF-GEN-PWR-001/RF-GEN_PWR_V1.0_PCB_20191118.pcb
1_Schematic/Build V1.0/03_RF-GEN-RF-001/Plasma_RF_Gen_V2.0_RF_PCB_20191015.pcb
1_Schematic/Build V1.0/03_RF-GEN-RF-001/RF-GEN_RF_V2.0_PCB_20191024.pcb
1_Schematic/Build V1.0/03_RF-GEN-RF-001/RF-GEN_RF_V2.0_PCB_20191024B.pcb
1_Schematic/Build V1.0/03_RF-GEN-RF-001/RF-GEN_RF_V2.0_PCB_20191103B.pcb
1_Schematic/Build V1.0/03_RF-GEN-RF-001/RF-GEN_RF_V2.0_PCB_20191105.pcb
1_Schematic/Build V1.0/03_RF-GEN-RF-001/RF-GEN_RF_V2.0_PCB_20191107.pcb
1_Schematic/Build V1.0/03_RF-GEN-RF-001/RF-GEN_RF_V2.0_PCB_20191204.pcb
1_Schematic/Build V1.0/03_RF-GEN-RF-001/RF-GEN_RF_V2.0_PCB_20191205.pcb
1_Schematic/Build V1.0/04_RF-GEN-COUPLER-001/Tandem-coupler_V001_191110.pcb
1_Schematic/Build V1.0/04_RF-GEN-COUPLER-001/Tandem-coupler_V001_191110A.pcb
1_Schematic/Build V2.0/01_RF-GEN-CPU-001/Backup/RF-GEN_CPU_V1.0_PCB_20191117.pcb
1_Schematic/Build V2.0/01_RF-GEN-CPU-001/Backup/RF-GEN_CPU_V2.0_PCB_20200205.pcb
1_Schematic/Build V2.0/01_RF-GEN-CPU-001/RF-GEN_CPU_V1.0_PCB_20191117.pcb
1_Schematic/Build V2.0/01_RF-GEN-CPU-001/RF-GEN_CPU_V2.0_PCB_20200205.pcb
1_Schematic/Build V2.0/01_RF-GEN-CPU-001/RF-GEN_CPU_V2.0_PCB_20200208.pcb
1_Schematic/Build V2.0/02_RF-GEN-PWR-001/Backup/RF-GEN_PWR_V1.0_PCB_20191128.pcb
1_Schematic/Build V2.0/02_RF-GEN-PWR-001/Backup/RF-GEN_PWR_V2.0_PCB_20200205.pcb
1_Schematic/Build V2.0/02_RF-GEN-PWR-001/Backup/RF-GEN_PWR_V2.0_PCB_20200208.pcb
1_Schematic/Build V2.0/02_RF-GEN-PWR-001/Backup/RF-GEN_PWR_V2.0_PCB_20200210.pcb
1_Schematic/Build V2.0/02_RF-GEN-PWR-001/RF-GEN_PWR_V1.0_PCB_20191128.pcb
1_Schematic/Build V2.0/02_RF-GEN-PWR-001/RF-GEN_PWR_V2.0_PCB_20200205.pcb
1_Schematic/Build V2.0/02_RF-GEN-PWR-001/RF-GEN_PWR_V2.0_PCB_20200208.pcb
1_Schematic/Build V2.0/02_RF-GEN-PWR-001/RF-GEN_PWR_V2.0_PCB_20200212.pcb
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
