ArvidJoung/Plasma_RF_Generator/3_FirmWare/RF_GEN_Test/Inc/main.h

#define VDC_IN_AD_Pin GPIO_PIN_0
#define VDC_IN_AD_GPIO_Port GPIOC
#define VDC_OUT_AD_Pin GPIO_PIN_1
#define VDC_OUT_AD_GPIO_Port GPIOC
#define PW_IS_AD_Pin GPIO_PIN_2
#define PW_IS_AD_GPIO_Port GPIOC
#define FAN_PW_AD_Pin GPIO_PIN_3
#define FAN_PW_AD_GPIO_Port GPIOC
#define RV_CT_AD_Pin GPIO_PIN_0
#define RV_CT_AD_GPIO_Port GPIOA
#define FW_CT_AD_Pin GPIO_PIN_1
#define FW_CT_AD_GPIO_Port GPIOA
#define FET_T_AD_Pin GPIO_PIN_2
#define FET_T_AD_GPIO_Port GPIOA
#define PA6_FAN_PWM_Pin GPIO_PIN_6
#define PA6_FAN_PWM_GPIO_Port GPIOA
#define DDS_SLEEP_Pin GPIO_PIN_0
#define DDS_SLEEP_GPIO_Port GPIOB
#define DDS_RESET_Pin GPIO_PIN_1
#define DDS_RESET_GPIO_Port GPIOB
#define DDS_FSYNC_Pin GPIO_PIN_2
#define DDS_FSYNC_GPIO_Port GPIOB
#define DDS_CLK_Pin GPIO_PIN_10
#define DDS_CLK_GPIO_Port GPIOB
#define DDS_DATA_Pin GPIO_PIN_11
#define DDS_DATA_GPIO_Port GPIOB
#define PB12_LIMIT_SW_A_Pin GPIO_PIN_12
#define PB12_LIMIT_SW_A_GPIO_Port GPIOB
#define PB13_LIMIT_SW_B_Pin GPIO_PIN_13
#define PB13_LIMIT_SW_B_GPIO_Port GPIOB
#define JP_BIAS_Pin GPIO_PIN_14
#define JP_BIAS_GPIO_Port GPIOB
#define PC6_PW_PWM_Pin GPIO_PIN_6
#define PC6_PW_PWM_GPIO_Port GPIOC
#define PC7_PWR_ENA_Pin GPIO_PIN_7
#define PC7_PWR_ENA_GPIO_Port GPIOC
#define PC8_PRE_AMP_ENA_Pin GPIO_PIN_8
#define PC8_PRE_AMP_ENA_GPIO_Port GPIOC
#define PD2_GPIO_ON_Pin GPIO_PIN_2
#define PD2_GPIO_ON_GPIO_Port GPIOD
#define COM_LED_Pin GPIO_PIN_3
#define COM_LED_GPIO_Port GPIOB
#define WDT_LED_Pin GPIO_PIN_4
#define WDT_LED_GPIO_Port GPIOB
#define EPROM_WP_Pin GPIO_PIN_5
#define EPROM_WP_GPIO_Port GPIOB
#define PB6_BIAS_ON_Pin GPIO_PIN_6
#define PB6_BIAS_ON_GPIO_Port GPIOB
#define PLA_ON_LED_Pin GPIO_PIN_9
#define PLA_ON_LED_GPIO_Port GPIOB
