ArvidJoung/Plasma_RF_Generator/(commit log)

2018-06-01 Femto datasheet update
    [Plasma_RF_Generator_Spec.xlsx]
2018-06-12 [GEN] Block diagram update
    [Plasma_RF_Generator_Spec.xlsx]
2018-06-14 [GEN] Home data update
    [Plasma RF Review data.xlsx]
2018-06-22 [GEN] BD update
    [Plasma RF Review data.xlsx, Plasma_RF_Generator_Spec.xlsx]
2018-07-15 [Ref Doc] Plasource 제품 사진 update
2018-07-15 [GEN] Ref device Block diagram 및 Datasheet update
2018-07-29 [Main] Schematic initial Version build
    [Plasma_RF Generator_V1.0_Main_SCH.sch]
2018-08-05 Schedule file 추가
    [Plasma RF Generator Project schedule V1.0.xlsx]
2018-08-12 [RF Gen] Power PCB Sch 완료
    [Plasma_RF_Gen_V1.0_POWER_SCH_20180811.sch]
2018-08-12 [RF Gen] Power PCB 개발 일정 update
    [Plasma RF Generator Project schedule V1.0.xlsx]
2018-08-12 [RF Gen] Power PCB Sch&PCB update
    [Plasma_RF_Gen_V1.0_POWER_PCB_20180811.pcb, Plasma_RF_Gen_V1.0_POWER_SCH_20180811.sch]
2018-08-13 [Ref] PCB Layout reference
2018-09-29 [RF Gen] Schematic Update
    [Plasma_RF Generator_V1.0_Main_SCH.sch, Plasma_RF_Gen_V1.0_POWER_PCB_20180811.pcb, Plasma_RF_Gen_V1.0_POWER_PCB_20180917.pcb, Plasma_RF_Gen_V1.0_POWER_SCH_20180811.sch, Plasma_RF_Gen_V1.0_POWER_SCH_20180917.sch]
2018-09-29 PCB library
2018-09-29 [POWER] Sch & PCB update
    [Plasma_RF_Gen_V1.0_POWER_PCB_20180929_V9.5.pcb, Plasma_RF_Gen_V1.0_POWER_SCH_20180917.sch]
2018-10-09 [SCH&PCB] VX2.3 작업 file
    [Plasma_RF_Gen_V1.0_POWER_PCB_20180929_V9.5.pcb, Plasma_RF_Gen_V1.0_POWER_PCB_20181008_VX2.3.pcb, Plasma_RF_Gen_V1.0_POWER_SCH_20180917.sch, Plasma_RF_Gen_V1.0_POWER_SCH_20181009.sch]
2018-10-28 [SCH&PCB]VX2.3 작업 file
    [Plasma_RF_Gen_V1.0_POWER_PCB_20181008_VX2.3.pcb, Plasma_RF_Gen_V1.0_POWER_SCH_20181009.sch]
2018-11-04 [SCH&PCB] 11/4 Working Data
    [Plasma_RF_Gen_V1.0_POWER_PCB_20180917.pcb, Plasma_RF_Gen_V1.0_POWER_PCB_20180929_V9.5.pcb, Plasma_RF_Gen_V1.0_POWER_PCB_20181008_VX2.3.pcb, Plasma_RF_Gen_V1.0_POWER_PCB_20181104_VX2.3.pcb, Plasma_RF_Gen_V1.0_POWER_SCH_20180917.sch, Plasma_RF_Gen_V1.0_POWER_SCH_20181009.sch, Plasma_RF_Gen_V1.0_POWER_SCH_20181104_VX2.3.sch]
2018-11-16 [SCH&PCB] PADS9.0 update
    [PL.xlsx, Plasma_RF_Gen_V1.0_POWER_PCB_20181115_VX2.3.pcb, Plasma_RF_Gen_V1.0_POWER_SCH_20181115_VX2.3.sch]
2018-12-07 [SCH&PCB] 12/6 작업분
    [PL.xlsx, PL_20181206.xlsx, Plasma RF Review data.xlsx, Plasma_RF_Gen_V1.0_POWER_PCB_20181104_VX2.3.pcb, Plasma_RF_Gen_V1.0_POWER_PCB_20181115_VX2.3.pcb, Plasma_RF_Gen_V1.0_POWER_PCB_20181206_VX2.3.pcb, Plasma_RF_Gen_V1.0_POWER_SCH_20181104_VX2.3.sch, Plasma_RF_Gen_V1.0_POWER_SCH_20181115_VX2.3.sch]
2019-01-01 [Matcher]회로 update
    [Plasma RF Generator Project schedule V1.0.xlsx, Plasma_RF_Gen_V1.0_DETECT_SCH_20190101_VX2.3.sch, Plasma_RF_Gen_V1.0_POWER_PCB_20181206_VX2.3.pcb, Plasma_RF_Gen_V1.0_POWER_PCB_20181217_VX2.3.pcb, Plasma_RF_Gen_V1.0_POWER_SCH_20181217_VX2.3.sch]
2019-01-03 [RF Gen] PADS9.0 update
    [Plasma_RF_Gen_V1.0_POWER_PCB_20181217_VX2.3.pcb, Plasma_RF_Gen_V1.0_POWER_SCH_20181217_VX2.3.sch]
2019-01-03 [RF Gen]PADS V9.5 Update
    [Plasma_RF_Gen_V1.0_DETECT_SCH_20190101_V9.5.sch, Plasma_RF_Gen_V1.0_POWER_SCH_20181217_V9.5.sch]
2019-02-12 [RF Gen] Sch and PCB work Done
    [Logic0.sch, Logic1.sch, Logic2.sch, Logic3.sch, Plasma RF Review data.xlsx, Plasma_RF_Gen_V1.0_POWER_PCB_20181217_V9.5.pcb, Plasma_RF_Gen_V1.0_POWER_PCB_20181217_VX2.3.pcb, Plasma_RF_Gen_V1.0_POWER_PCB_20190212_V9.5.pcb]
2019-03-25 [PWR] PWR SCH & PCB 1차 완료
    [MRF1513N_MTTF_CALC.xls, Plasma RF Review data.xlsx, Plasma_RF_Gen_V1.0_POWER_PCB_20190212_V9.5.pcb, Plasma_RF_Gen_V1.0_POWER_PCB_20190310_V9.5.pcb, Plasma_RF_Gen_V1.0_POWER_PCB_20190318_V9.5.pcb, Plasma_RF_Gen_V1.0_POWER_PCB_20190326_V9.5.pcb, Plasma_RF_Gen_V1.0_POWER_SCH_20190213_V9.5.sch, Plasma_RF_Gen_V1.0_POWER_SCH_20190310_V9.5.sch]
2019-04-11 V1.0 완료
    [Plasma_RF_Gen_V1.0_POWER_PCB_20190326_V9.5.pcb, Plasma_RF_Gen_V1.0_POWER_PCB_20190410_V9.5.pcb, Plasma_RF_Gen_V1.0_POWER_SCH_20190326_V9.5.sch, Plasma_RF_Gen_V1.0_POWER_SCH_20190410_V9.5.sch, RF Generator_PWR_BOM_20190410.xlsx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]
2019-04-23 [RF Gen] 부품 입고 check 및 제작
    [Plasma RF Review data.xlsx, Plasma_Gen_Block Diagram.xlsx, Plasma_RF_Gen_V1.0_POWER_SCH_20190410_V9.5.sch, RF Generator_PWR_BOM_20190410.xlsx]
2019-04-27 [RF Gen] Pre-amp matching
    [Plasma RF Review data.xlsx]
2019-04-29 [RF-GEN-CPU] Sch 설계
    [Logic0.sch, Logic1.sch, Logic2.sch, Logic3.sch, Plasma_RF_Gen_V1.0_POWER_PCB_20190410_V9.5.pcb, Plasma_RF_Gen_V1.0_POWER_SCH_20190410_V9.5.sch, RF Generator_PWR_BOM_20190410.xlsx, RF-GEN-CPU_PinMap_20190429.xlsx]
2019-05-02 [CPU] DDS Schematic 추가
    [RF-GEN_CPU_SCH_V1.0_20190429.sch, RF-GEN_CPU_SCH_V1.0_20190503.sch]
2019-05-04 [PWR] Test results update
    [Plasma RF Review data.xlsx]
2019-05-05 [CPU] Schematic update
    [RF-GEN-CPU_PinMap_20190429.xlsx, RF-GEN_CPU_SCH_V1.0_20190505.sch]
2019-05-08 [CPU]Sch update
    [Plasma_Gen_Block Diagram_V2.0.xlsx, RF-GEN_CPU_SCH_V1.0_20190505.sch]
2019-08-15 [RF GEN]CPU Sch update
    [Logic0.sch, Logic1.sch, Logic2.sch, Logic3.sch, RF-GEN-CPU_PinMap_20190429.xlsx, RF-GEN_CPU_SCH_V1.0_20190505.sch]
2019-08-24 [RF GEN] CPU update-Company
    [Plasma_Gen_Block Diagram_V2.0.xlsx, RF Generator Review Data_20190808.xlsx, RF-GEN-CPU_PinMap_20190429.xlsx, RF-GEN_CPU_SCH_V1.0_20190505.sch]
2019-08-26 [RF GEN] Femto release version
    [RF Generator Review Data_20190808.xlsx, RF-GEN-CPU_PinMap_20190429.xlsx, RF-GEN_CPU_SCH_V1.0_20190505.sch, RF-GEN_CPU_SCH_V1.0_20190825.sch]
2019-10-08 [10/8] 5hour working
    [Plasma_Gen_Block Diagram_V2.0.xlsx, RF-GEN_CPU_PCB_V1.0_20191008.pcb, RF-GEN_CPU_SCH_V1.0_20191008.sch]
2019-10-12 [10/12] company work
    [Logic0.sch, Logic1.sch, Logic2.sch, Logic3.sch, MIS-PEN-CPU-100_190923.pcb, MIS-PEN-CPU-100_190923.sch, Plasma_Gen_Block Diagram_V2.0.xlsx, RF-GEN_CPU_PCB_V1.0B_20191012.pcb]
2019-10-15 [10/15] Home Work
    [Plasma Project schedule V1.0_20191015.xlsx, Plasma RF Review data_company.xlsx, Plasma_Gen_Block Diagram_V2.0 - 복사본.xlsx, Plasma_RF_Gen_V2.0_RF_PCB_20191015.pcb, Plasma_RF_Gen_V2.0_RF_SCH_20191015.sch]
2019-10-19 [10/14] company work
    [Plasma RF Review data_company.xlsx, Plasma_Gen_Block Diagram_V2.0.xlsx, Plasma_RF_Gen_V1.0_RF_PCB_20190410_V9.5.pcb, Plasma_RF_Gen_V1.0_RF_SCH_20190410_V9.5.sch, RF Generator_RF_BOM_20190410.xlsx, RF-GEN_CPU_PCB_V1.0_20191008.pcb, RF-GEN_CPU_SCH_V1.0_20191008.sch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]
2019-10-19 [10/19]Company work
    [Plasma_Gen_Block Diagram_V2.0.xlsx, Plasma_RF_Gen_V1.0_RF_PCB_20190410_V9.5.pcb, Plasma_RF_Gen_V1.0_RF_SCH_20190410_V9.5.sch, Plasma_RF_Gen_V2.0_RF_PCB_20191015.pcb, Plasma_RF_Gen_V2.0_RF_SCH_20191015.sch, RF Generator_RF_BOM_20190410.xlsx, RF-GEN_CPU_PCB_V1.0_20191008.pcb, RF-GEN_CPU_PCB_V1.0_20191019.pcb]
2019-10-24 [RF GEN] Home work
    [Logic0.sch, Logic1.sch, Logic2.sch, Logic3.sch, Plasma Project schedule V1.0_20191015.xlsx, Plasma_Gen_Block Diagram_V2.0.xlsx, Plasma_RF_Gen_V2.0_RF_PCB_20191015.pcb, Plasma_RF_Gen_V2.0_RF_SCH_20191015.sch]
2019-10-24 [RF-GEN] Company work
    [RF-GEN_CPU_V1.0_PCB_20191025_VX.pcb]
2019-10-27 [10/27] RF GEN PCB work - home
    [Logic0.sch, Logic1.sch, Logic2.sch, Logic3.sch, Plasma Project schedule V1.0_20191015.xlsx, Plasma_Gen_Block Diagram_V2.0.xlsx, RF-GEN_CPU_V1.0_PCB_20191027.pcb, RF-GEN_CPU_V1.0_SCH_20191024.sch]
2019-10-28 [10/28] PCB artwork - Home
    [Logic0.sch, Logic1.sch, Logic2.sch, Logic3.sch, Plasma Project schedule V1.0_20191015.xlsx, Plasma_Gen_Block Diagram_V2.0.xlsx, RF-GEN_CPU_V1.0_PCB_20191024.pcb, RF-GEN_CPU_V1.0_PCB_20191025_VX.pcb]
2019-10-31 [10/31]PWR PCB 설계
    [Plasma Project schedule V1.0_20191015.xlsx, Plasma_Gen_Block Diagram_V2.0.xlsx, RF-GEN_PWR_V1.0_PCB_20191030.pcb, RF-GEN_PWR_V1.0_SCH_20191028.sch, RF-GEN_PWR_V1.0_SCH_20191030.sch]
2019-11-03 [11/3]HOME WORK
    [Plasma Project schedule V1.0_20191015.xlsx, Plasma_Gen_Block Diagram_V2.0.xlsx, RF-GEN_PWR_V1.0_PCB_20191028.pcb, RF-GEN_PWR_V1.0_SCH_20191028.sch, RF-GEN_RF_V2.0_PCB_20191024.pcb, RF-GEN_RF_V2.0_PCB_20191024B.pcb, RF-GEN_RF_V2.0_PCB_20191103B.pcb, RF-GEN_RF_V2.0_SCH_20191102.sch]
2019-11-04 [11/4] company work
    [Plasma_Gen_Block Diagram_V2.0.xlsx, RF Generator Review Data_20191104.xlsx, RF-GEN-CPU_PinMap_20190429.xlsx, RF-GEN_PWR_V1.0_SCH_20191104.sch]
2019-11-05 [11/5]CPU update - company work
    [RF-GEN_CPU_V1.0_PCB_20191027.pcb, RF-GEN_CPU_V1.0_PCB_20191105.pcb, RF-GEN_CPU_V1.0_SCH_20191027.sch, RF-GEN_CPU_V1.0_SCH_20191105.sch]
2019-11-05 [11/5] RF PCB Update - company work
    [RF-GEN_RF_V2.0_PCB_20191024.pcb, RF-GEN_RF_V2.0_PCB_20191024B.pcb, RF-GEN_RF_V2.0_PCB_20191103B.pcb, RF-GEN_RF_V2.0_PCB_20191105.pcb, RF-GEN_RF_V2.0_SCH_20191102.sch, RF-GEN_RF_V2.0_SCH_20191105.sch]
2019-11-05 [11/5]company work
    [Plasma_Gen_Block Diagram_V2.0.xlsx, RF Generator Review Data_20191104.xlsx, RF-GEN-CPU_PinMap_20190429.xlsx]
2019-11-05 [11/5]CPU,PWR update - home work
    [Plasma Project schedule V1.0_20191015.xlsx, RF-GEN_CPU_V1.0_PCB_20191105.pcb, RF-GEN_CPU_V1.0_PCB_20191105_VX.pcb, RF-GEN_CPU_V1.0_SCH_20191105.sch, RF-GEN_PWR_V1.0_PCB_20191030.pcb, RF-GEN_PWR_V1.0_PCB_20191105.pcb, RF-GEN_PWR_V1.0_SCH_20191030.sch, RF-GEN_PWR_V1.0_SCH_20191104.sch]
2019-11-06 [11/6]RF PCB update - company work
    [Plasma_Gen_Block Diagram_V2.0 - 복사본.xlsx, Plasma_Gen_Block Diagram_V2.0.xlsx, RF-GEN_RF_V2.0_PCB_20191106.pcb]
2019-11-07 [11/7]RF PCB and review data update - Home work
    [Plasma Project schedule V1.0_20191015.xlsx, RF Generator Review Data_20191104.xlsx, RF-GEN-CPU_PinMap_20191107.xlsx, RF-GEN_CPU_V1.0_PCB_20191105_VX.pcb, RF-GEN_CPU_V1.0_SCH_20191105.sch, RF-GEN_RF_V2.0_PCB_20191105.pcb, RF-GEN_RF_V2.0_PCB_20191106.pcb, RF-GEN_RF_V2.0_PCB_20191106A.pcb]
2019-11-10 [11/10]Coupler Sch update - company work
    [Tandem Match coupler_191110.sch, Tandem match coupler_Data_20190929.xlsx, Tandem-coupler_V001_191110.pcb]
2019-11-11 [11/11]CPU 수정 및 Data release(Femto)
    [Logic0.sch, Logic1.sch, Logic2.sch, Logic3.sch, Plasma Project schedule V1.0_20191015.xlsx, RF Generator Review Data_20191104.xlsx, RF Generator Review Data_20191111.xlsx, RF-GEN_CPU_V1.0_PCB_20191105.pcb]
2019-11-12 [11/12]Coupler update - company work
    [Logic0.sch, Logic1.sch, Logic2.sch, Logic3.sch, RF Generator Review Data_20190808.xlsx, RF Generator Review Data_20191111.xlsx, RF Generator Review Data_20191112.xlsx, Tandem Match coupler_191110.sch]
2019-11-12 [11/12]CPU PL 작성 -home work
    [Plasma Project schedule V1.0_20191015.xlsx, RF-GEN_CPU_V1.0_SCH_20191111.sch, aaa.xls]
2019-11-13 [11/13] CPU PL & SCH & PCB update
    [RF-GEN_CPU PL_V1.0_20191113.xlsx, RF-GEN_CPU_V1.0_PCB_20191111.pcb, RF-GEN_CPU_V1.0_PCB_20191113.pcb, RF-GEN_CPU_V1.0_SCH_20191111.sch, RF-GEN_CPU_V1.0_SCH_20191113.sch, aaa.xls]
2019-11-17 [11/17] Home work
    [PWR_PL.xls, Plasma Project schedule V1.0_20191015.xlsx, RF Generator Review Data_20191112.xlsx, RF PL.xls, RF-GEN_CPU PL_V1.0_20191113.xlsx, RF-GEN_CPU PL_V1.0_20191117.xlsx, RF-GEN_CPU_V1.0_PCB_20191113.pcb, RF-GEN_CPU_V1.0_PCB_20191113A.pcb]
2019-11-18 [11/18]PWR SCH update - 11/13회로와 비교 필요
    [PWR_PL.xls, Plasma Project schedule V1.0_20191015.xlsx, RF-GEN_PWR PL_V1.0_20191118.xlsx, RF-GEN_PWR_V1.0_PCB_20191118.pcb, RF-GEN_PWR_V1.0_SCH_20191118.sch]
2019-11-20 [11/20] RF Sch & PL update
    [Plasma Project schedule V1.0_20191015.xlsx, RF PL.xls, RF-GEN_PWR PL_V1.0_20191118.xlsx, RF-GEN_PWR_V1.0_PCB_20191113.pcb, RF-GEN_PWR_V1.0_SCH_20191113.sch, RF-GEN_PWR_V1.0_SCH_20191118.sch, RF-GEN_RF PL V1.0_20191120.xlsx, RF-GEN_RF_V2.0_SCH_20191113.sch]
2019-11-29 [11/28] RF-GEN CPU,PWR Gerber,PL release - FEMTO
    [Plasma Project schedule V1.0_20191015.xlsx, Plasma RF Review data_company.xlsx, RF-GEN_CPU PL_V1.0_20191117.xlsx, RF-GEN_CPU_V1.0_PCB_20191117.pcb, RF-GEN_PWR PL_V1.0_20191118.xlsx, RF-GEN_PWR PL_V1.0_20191128.xlsx, RF-GEN_PWR_V1.0_PCB_20191118.pcb, RF-GEN_PWR_V1.0_PCB_20191128.pcb]
2019-12-04 [12/4]RF PCB update
    [Logic0.sch, Logic1.sch, Logic2.sch, Logic3.sch, Plasma Project schedule V1.0_20191015.xlsx, Plasma_Gen_Block Diagram_V2.0.xlsx, RF-GEN_RF PL V1.0_20191120.xlsx, RF-GEN_RF_V2.0_PCB_20191107.pcb]
2019-12-09 [RF-GEN]RF and Coupler Gerber update
    [Logic0.sch, Logic1.sch, Logic2.sch, Logic3.sch, RF Generator Review Data_20191112.xlsx, RF-GEN_RF PL V1.0_20191120.xlsx, RF-GEN_RF PL V2.0_20191209.xlsx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]
2020-01-27 [RF GEN] RF path tune - company work
    [RF-GEN-Path tune data_20200127.xlsx]
2020-02-01 [RF GEN] path review - company work
    [RF-GEN-Path tune data_20200127.xlsx]
2020-02-05 [CPU]SCH, PCB, BOM update
    [Logic0.sch, Logic1.sch, Logic2.sch, Logic3.sch, MIS-PEN-CPU-100_190923.pcb, MIS-PEN-CPU-100_190923.sch, RF-GEN_CPU PL_V1.0_20191113.xlsx, RF-GEN_CPU PL_V1.0_20191117.xlsx]
2020-02-05 [PWR] SCH, PCB, BOM update
    [RF-GEN_CPU_PCB_V1.0_20191008.pcb, RF-GEN_CPU_PCB_V1.0_20191019.pcb, RF-GEN_CPU_PCB_V1.0_20191019_9.5.pcb, RF-GEN_CPU_PCB_V1.0_20191019_9.5_B.pcb, RF-GEN_CPU_SCH_V1.0_20191008.sch, RF-GEN_CPU_SCH_V1.0_20191019.sch, RF-GEN_PWR PL_V1.0_20191118.xlsx, RF-GEN_PWR PL_V1.0_20191128.xlsx]
2020-02-07 [RF] Update
    [Logic0.sch, Logic1.sch, Plasma_Gen_Block Diagram_V2.0.xlsx, RF-GEN-Change list_20200127.xlsx]
2020-02-07 [CPU] SCH, PL update
    [RF-GEN_CPU PL_V2.0_20200205.xlsx, RF-GEN_CPU PL_V2.0_20200207.xlsx, RF-GEN_CPU_V2.0_SCH_20200205.sch, RF-GEN_CPU_V2.0_SCH_20200207.sch]
2020-02-07 [CPU] SCH, test data update
    [RF-GEN-Change list_20200127.xlsx, RF-GEN-Test Date_20200207.xlsx, RF-GEN_CPU_V2.0_SCH_20200207.sch]
2020-02-08 [RF] debuggging Data update
    [Logic0.sch, Logic1.sch, Plasma_Gen_Block Diagram_V2.000.xlsx, RF-GEN-Change list_20200127.xlsx, RF-GEN-Change list_20200208.xlsx, RF-GEN-Test Date_20200207.xlsx, RF-GEN_CPU_V2.0_SCH_20200208.sch]
2020-02-09 2/8 work update
    [RF-GEN-Change list_20200208.xlsx, RF-GEN_CPU PL_V2.0_20200207.xlsx, RF-GEN_CPU PL_V2.0_20200208.xlsx, RF-GEN_CPU_V2.0_PCB_20200205.pcb, RF-GEN_CPU_V2.0_PCB_20200208.pcb, RF-GEN_CPU_V2.0_SCH_20200207.sch, RF-GEN_CPU_V2.0_SCH_20200208.sch, RF-GEN_PWR_V2.0_PCB_20200205.pcb]
2020-02-10 [CPU]Sch update - Femto release version
    [RF-GEN-Change list_20200208.xlsx, RF-GEN_CPU PL_V2.0_20200208.xlsx, RF-GEN_CPU_V2.0_SCH_20200208.sch]
2020-02-12 [PWR,RF] update
    [Plasma Project schedule V1.0_20191015.xlsx, RF-GEN-Change list_20200208.xlsx, RF-GEN-Test Date_20200207.xlsx, RF-GEN_PWR PL_V2.0_20200205.xlsx, RF-GEN_PWR PL_V2.0_20200210.xlsx, RF-GEN_PWR PL_V2.0_20200212.xlsx, RF-GEN_PWR_V2.0_PCB_20200208.pcb, RF-GEN_PWR_V2.0_PCB_20200210.pcb]
2020-02-14 [CPU]Issue update
    [RF-GEN-Change list_20200208.xlsx, RF-GEN_RF PL V2.0_20191209.xlsx, RF-GEN_RF PL V2.0_20200213.xlsx, RF-GEN_RF_V2.0_SCH_20191209.sch, RF-GEN_RF_V2.0_SCH_20200213.sch]
2020-02-14 [F/W]Buck PWM set-up : 50KHz
2020-02-15 [2/15] company work
    [RF-GEN-Change list_20200208.xlsx, RF-GEN-Test Date_20200207.xlsx]
2020-02-27 [RF-GEN]Coupler review data update
    [RF-GEN-Test Date_20200207.xlsx]
2020-03-01 [RF-GEN] uWave update
    [MICRO-WAVE-RF-001_200301.sch, MICRO-WAVE_Block Diagram_20200301.xlsx, MICRO-WAVE_Change list V1.0_20200228.xlsx, MICRO-WAVE_Review Data_20200224.xlsx]
2020-03-14 [RF-GEN]Pout range review data update
    [RF-GEN_Test Data_20200314.xlsx]
2020-03-30 RF Sch, PL update
    [Logic0.sch, Logic1.sch, Logic2.sch, Logic3.sch, Plasma_RF_Gen_V1.0_RF_PCB_20190410_V9.5.pcb, Plasma_RF_Gen_V1.0_RF_SCH_20190410_V9.5.sch, RF Generator_RF_BOM_20190410.xlsx, RF-GEN-Change list_20200319.xlsx]
