ArvidJoung/Plasma_RF_Generator/(notices)

Notices in the files:
3_FirmWare/RF_GEN_Test/Inc/main.h:
© Copyright (c) 2020 STMicroelectronics.
All rights reserved.
This software component is licensed by ST under BSD 3-Clause license,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
(C) COPYRIGHT STMicroelectronics *****END OF FILE
