ArvidJoung/Plasma_RF_Generator/Femto Data/Reference Device/COMET/내부 사진/20180612_105326.jpg

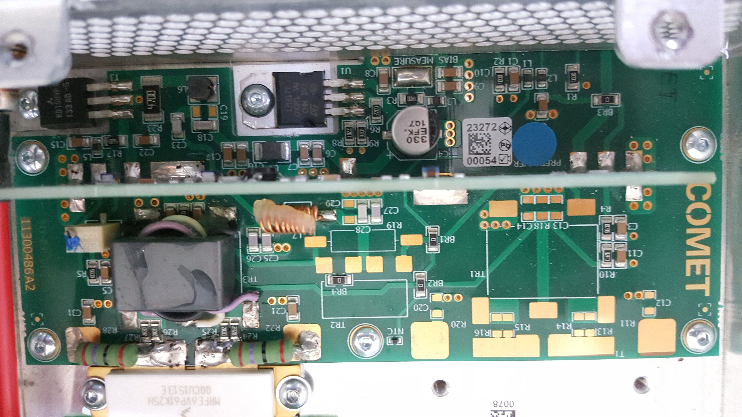
Femto Data/Reference Device/COMET/내부 사진/20180612_105326.jpg
