ArvidJoung/Plasma_RF_Generator/Femto Data/Reference Device/Plasource/제품사진/20180714_104629.jpg

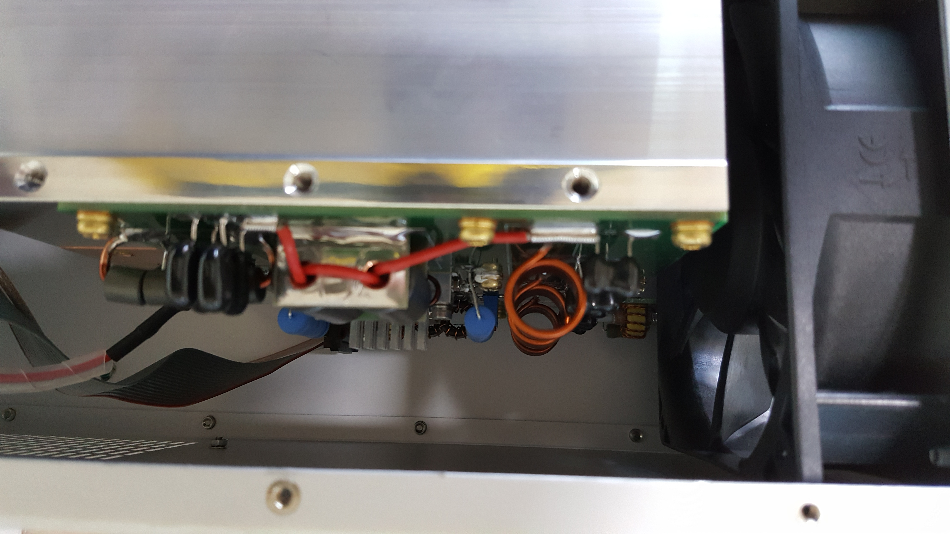
Femto Data/Reference Device/Plasource/제품사진/20180714_104629.jpg
