ArvidJoung/Plasma_RF_Generator/Femto Data/Reference Device/Plasource/제품사진/20180714_112622.jpg

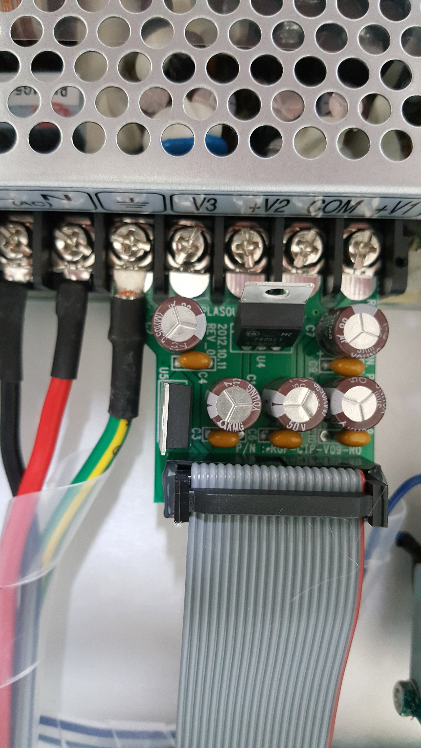
Femto Data/Reference Device/Plasource/제품사진/20180714_112622.jpg
